Plastal-Bot-Builders/RoboCoreDocumentation/software/ide_design/docs/behaviour-spec.md

# RoboCore IDE — behaviour spec and test checklist

Every control in the RoboCore IDE, what it must do, and where to try it in the Figma prototype ([RoboCore IDE — UI/UX Design](https://www.figma.com/design/P7i2WBM8G96B2fTPHpp8yi), page 05). Blocks are Google Blockly; the code editor is Monaco.

Each row is one test case. Run it in the prototype now, and on the built app later. IDs are stable: add new rows at the end of an area.

145 test cases in 16 areas. Generated from `figma-plugin/src/10d_spec_data.js` by `node tools/spec_md.js`; do not edit this file by hand.

## Contents

- [G — Everywhere](#g--everywhere)
- [W — First start](#w--first-start)
- [H — Home](#h--home)
- [PR — Projects](#pr--projects)
- [EX — Examples](#ex--examples)
- [L — Libraries](#l--libraries)
- [B — Board Setup](#b--board-setup)
- [SM — Serial Monitor](#sm--serial-monitor)
- [ST — Settings](#st--settings)
- [E — Editor · header and build](#e--editor--header-and-build)
- [BK — Blocks (Blockly)](#bk--blocks-blockly)
- [CD — Code (Monaco)](#cd--code-monaco)
- [C — Console (bottom panel)](#c--console-bottom-panel)
- [PB — Preview board](#pb--preview-board)
- [CG — Cog (design only)](#cg--cog-design-only)
- [D — Dialogs](#d--dialogs)
- [Handoff: Blockly](#handoff-blockly)
- [Handoff: Monaco](#handoff-monaco)
- [Implementation notes](#implementation-notes)
- [What the prototype cannot do](#what-the-prototype-cannot-do)

## G — Everywhere

| ID | Control | Do | Expect | Prototype | Pass |
|---|---|---|---|---|---|
| G-01 | Logo (top bar) | Click | Goes to Home. | `any → bHome` | ☐ |
| G-02 | Sidebar item | Click Home, Projects, Libraries, Examples, Board Setup, Serial Monitor or Settings | Opens that page; the item gets the yellow bar. | `any → b*` | ☐ |
| G-03 | Sidebar · Open project | Click | Opens the editor with the project you had open. | `any → eBlocks` | ☐ |
| G-04 | Sidebar · Collapse | Click, or Ctrl+B | Sidebar shrinks to 64 px icons with tooltips; again expands it. Remembered on this device. | `Sidebar component` | ☐ |
| G-05 | Board selector | Click | Opens the board menu: boards, port (Preview board / USB-C), Board setup…. Esc or a click outside closes it. | `Overlay · boardMenu*` | ☐ |
| G-06 | Board menu · board | Pick a board | Editor: the project’s board changes. Browse pages: the default board for new projects. Status bar updates. | `Overlay · boardMenu*` | ☐ |
| G-07 | Board menu · Preview board | Pick | Port = preview. The editor shows the Preview board card; Upload runs the sketch in the simulator. | `→ ePreview` | ☐ |
| G-08 | Board menu · USB-C | Pick | Reopens a board the browser already allowed without asking; otherwise opens the browser’s port chooser. | `→ eBlocks` | ☐ |
| G-09 | Settings icon | Click | Opens Settings. | `→ bSettings` | ☐ |
| G-10 | Account | Click | Menu with name and school, Edit profile, Keyboard shortcuts, About RoboCore IDE. | `Overlay · accountMenu` | ☐ |
| G-11 | Search (browse pages) | Type | Results grouped as Projects, Examples and Help; Enter opens the first; Esc closes. | `Overlay · search` | ☐ |
| G-12 | New project | Click (top bar, Home, Projects) | Opens the New project dialog. | `Overlay · newProject` | ☐ |
| G-13 | Status bar · board | Click | Opens Board Setup. | `→ bBoard` | ☐ |
| G-14 | Icon buttons | Hover 0.5 s, or keyboard focus | Tooltip with the label and shortcut. | `Icon Button component` | ☐ |
| G-15 | Esc | Press | Closes the top-most menu, popover or dialog. Never discards typed text without asking. | `every overlay` | ☐ |
| G-16 | Toasts | Appear after an action | Success and info hide after 4 s; errors stay until closed. | `Overlay · toast*` | ☐ |
| G-17 | Buttons, cards, menu rows | Hover | Hover state (tint or ink outline); pointer cursor. | `components` | ☐ |

## W — First start

| ID | Control | Do | Expect | Prototype | Pass |
|---|---|---|---|---|---|
| W-01 | App start, no profile | Open the IDE on a new device | Shows Welcome; nothing else is reachable until a name is given. | `bWelcome` | ☐ |
| W-02 | Your name | Type | Get started turns on when the name has a letter (spaces trimmed); 40 characters at most. | `bWelcome → bWelcomeTyped` | ☐ |
| W-03 | School or class | Type (optional) | Shown with the name on Home and in the account menu. | `bWelcomeTyped` | ☐ |
| W-04 | Get started | Click, or Enter | Saves the profile on this device, seeds 5 starter projects and opens Home (“Welcome back, <name>”). | `→ bHome` | ☐ |

## H — Home

| ID | Control | Do | Expect | Prototype | Pass |
|---|---|---|---|---|---|
| H-01 | New project | Click | New project dialog. | `Overlay · newProject` | ☐ |
| H-02 | Open <last project> | Click | Opens the last-edited project in the editor. | `→ eBlocks` | ☐ |
| H-03 | Recent project card | Click | Opens it in the mode it was saved in. ⋮ opens the card menu. | `→ eBlocks / eCode` | ☐ |
| H-04 | All projects → | Click | Projects page. | `→ bProjects` | ☐ |
| H-05 | Template tile | Click | Creates a project from the template and opens it in Blocks. | `→ eBlocks` | ☐ |
| H-06 | All examples → | Click | Examples page. | `→ bExamples` | ☐ |
| H-07 | Your board · Board setup → | Click | Board Setup. | `→ bBoard` | ☐ |

## PR — Projects

| ID | Control | Do | Expect | Prototype | Pass |
|---|---|---|---|---|---|
| PR-01 | Filter chips | Click All, Blocks or Code | Shows only those projects; the count shows in the status bar. | `bProjects*` | ☐ |
| PR-02 | Filter field | Type | Filters by name as you type. No match: “No projects match”. | `spec only` | ☐ |
| PR-03 | Project card | Click | Opens the project in its saved mode. | `→ editor` | ☐ |
| PR-04 | Card ⋮ | Click | Open, Rename…, Duplicate, Download .ino, Delete…. | `Overlay · cardMenu_*` | ☐ |
| PR-05 | Rename… | Choose | Dialog with the name selected. Name required and unique; Enter saves. | `Overlay · rename` | ☐ |
| PR-06 | Duplicate | Choose | Adds “<name> copy” at the top; toast. | `Overlay · toastDuplicated` | ☐ |
| PR-07 | Download .ino | Choose | Downloads the main file (a .zip when the sketch has more than one tab). Opens in Arduino IDE 2. | `Overlay · toastDownloaded` | ☐ |
| PR-08 | Delete… | Choose | Confirm dialog. Delete removes it from this device; it cannot be undone. | `Overlay · deleteConfirm` | ☐ |
| PR-09 | No projects | Delete the last one | Empty state with New project and Browse examples. | `bProjectsEmpty` | ☐ |
| PR-10 | Storage | Any change | Saved on this device 0.4 s after a change (key robocore-ide-v1). A damaged project is set aside under a backup key with a notice; the rest still load. | `spec only` | ☐ |

## EX — Examples

| ID | Control | Do | Expect | Prototype | Pass |
|---|---|---|---|---|---|
| EX-01 | Category chips | Click | Filters the grid (Basics, Sensors, Robotics, Sound & light, Communication). | `bExamples*` | ☐ |
| EX-02 | Search | Type | Filters by title and description. | `spec only` | ☐ |
| EX-03 | Example card | Click | Preview dialog: level, category, preview, Open as new project / Cancel. | `Overlay · example_*` | ☐ |
| EX-04 | Open as new project | Click | Makes a copy named after the example and opens it (Blocks when it has blocks, else C++). V2 examples are the library’s own sketches. | `→ eBlocks / eCode` | ☐ |

## L — Libraries

| ID | Control | Do | Expect | Prototype | Pass |
|---|---|---|---|---|---|
| L-01 | Included badge | None | RoboCore libraries and Wire come with the board package and cannot be removed. | `bLibraries` | ☐ |
| L-02 | Install | Click | Installing… then Installed. The library can now be #included; it is compiled on the compile server. | `Library Action component` | ☐ |
| L-03 | Installed | Hover, then click Remove | Removes it; Install appears again. | `Library Action component` | ☐ |
| L-04 | Missing library | Verify a sketch that #includes a library that is not installed | Error: “<Library> is not installed. Install it in Libraries.” | `spec only` | ☐ |

## B — Board Setup

| ID | Control | Do | Expect | Prototype | Pass |
|---|---|---|---|---|---|
| B-01 | Board list | Click a board | Default board for new projects; the detail shows its specs; check mark. | `bBoard*` | ☐ |
| B-02 | Port | Pick Preview board or USB-C | Sets where Upload goes. Saved on this device. | `Select/Port component` | ☐ |
| B-03 | Connect | Click (not connected) | Chrome / Edge port chooser opens; pick “USB JTAG/serial debug unit”. Connected → toast. Cancel → “No port chosen”. | `bBoardOff → Overlay · portChooserBoard → bBoardConnected` | ☐ |
| B-04 | Test connection | Click | Asks the chip for its name: toast “Board answered · ESP32-S3”, or an error if it does not answer. | `Overlay · toastTestOk` | ☐ |
| B-05 | Reset board | Click | Restarts the sketch through the serial lines; toast. | `Overlay · toastBoardReset` | ☐ |
| B-06 | Disconnect | Click | Closes the port (the sketch keeps running on the board); status shows a ring. | `→ bBoardOff` | ☐ |
| B-07 | Baud rate | Pick | Reopens the port at that rate. | `Select/Baud component` | ☐ |
| B-08 | CPU / Partition | Pick | Saved as build options for ESP32 boards and sent with each compile. | `Select/CPU, Select/Partition` | ☐ |
| B-09 | Unplug | Pull the cable | Toast “The board was unplugged…”. Plugging the same board back in reconnects by itself. | `spec only` | ☐ |
| B-10 | Unsupported browser | Safari, Firefox or a native app | “USB needs the web app in Chrome or Edge on a computer.” The preview board still works. | `spec only` | ☐ |

## SM — Serial Monitor

| ID | Control | Do | Expect | Prototype | Pass |
|---|---|---|---|---|---|
| SM-01 | Port, Baud | Pick | Reopens the port. | `Select components` | ☐ |
| SM-02 | Timestamps | Toggle | Shows or hides the time column. | `Toggle component` | ☐ |
| SM-03 | Autoscroll | Toggle | On follows new lines; off keeps your place. | `Toggle component` | ☐ |
| SM-04 | Clear | Click | Empties the log. The board is not affected. | `→ bSerialCleared` | ☐ |
| SM-05 | Message field | Type, then Enter or Send | Sends the text with the chosen line ending and shows it as “→ text”. Send is off while the field is empty. | `bSerial → bSerialTyped → bSerialSent` | ☐ |
| SM-06 | Line ending | Pick | No line ending, New line, Carriage return, Both NL & CR. | `Select/Line ending` | ☐ |
| SM-07 | No board | Open without a connection | Empty state with Connect. | `eNoBoard` | ☐ |

## ST — Settings

| ID | Control | Do | Expect | Prototype | Pass |
|---|---|---|---|---|---|
| ST-01 | Profile · Save | Edit name / school, click Save | Saved; toast. Name required. | `Overlay · toastProfileSaved` | ☐ |
| ST-02 | Cog help style | Pick one | Hints first (default), Explain the answer, Write code for me (off for students). A teacher lock disables the choice. | `Help Style component` | ☐ |
| ST-03 | Explanation level | Pick | Beginner, Intermediate, Advanced. | `Select/Level` | ☐ |
| ST-04 | Let Cog read this project | Toggle | Off: Cog sees nothing and says so. | `Toggle component` | ☐ |
| ST-05 | Theme | Pick Paper or Navy | The whole app switches at once, Blockly and Monaco included. Saved. | `Theme Choice component (Navy = page 06)` | ☐ |
| ST-06 | Font size | Pick | Code editor font size (Monaco fontSize). | `Select/Font size` | ☐ |
| ST-07 | Autocomplete | Toggle | Monaco suggestions while typing on or off (Ctrl+Space still works). | `Toggle component` | ☐ |
| ST-08 | Word wrap | Toggle | Monaco wordWrap on / off. | `Toggle component` | ☐ |
| ST-09 | Compile server · Test | Click | GET /health: “Reachable · arduino-cli 1.5.1 · esp32 3.3.12”, or “Server not reachable”. Empty address = preview check only. | `Server Test component` | ☐ |
| ST-10 | Language | Pick | English for now. | `Select/Language` | ☐ |
| ST-11 | Auto-save | Toggle | On: saves 0.4 s after a change and before upload. Off: saves on upload and when you leave the project. | `Toggle component` | ☐ |
| ST-12 | Reset all data | Scroll to General, click, confirm | Deletes this device’s projects, profile and settings, then shows Welcome. | `bSettings (scroll the page) → Overlay · resetData → bWelcome` | ☐ |

## E — Editor · header and build

| ID | Control | Do | Expect | Prototype | Pass |
|---|---|---|---|---|---|
| E-01 | Mode switch | Blocks ↔ C++ | Same project. C++ shows the code the blocks make. | `eBlocks ↔ eCode` | ☐ |
| E-02 | Project name ⌄ | Click | Rename…, Project settings…, Duplicate, Download Blink.ino, Delete project…. | `Overlay · projectMenu` | ☐ |
| E-03 | Saved label | Edit anything | Saving… then Saved (auto-save). | `spec only` | ☐ |
| E-04 | Verify | Click, Ctrl+R (web: Ctrl+Enter) | With a compile server: Compiling… then Verified with sizes, or Errors (Problems opens). Without: the preview check. | `eBlocks → vBlocks1 → vBlocks2` | ☐ |
| E-05 | Upload (USB-C) | Click, Ctrl+U (web: Ctrl+Shift+Enter) | Compile → bootloader → write with % → restart → Serial Monitor reopens → “Upload complete”. | `eBlocks → uBlocks1…5` | ☐ |
| E-06 | Upload (preview board) | Click | Preview check, then the sketch runs in the simulator. | `ePreview → pUp1 → pRunOn` | ☐ |
| E-07 | Stop | Click (only while uploading or running) | Cancels the upload, or stops the simulator. | `Toolbar Action` | ☐ |
| E-08 | Upload, no compile server | Click | Error in Output and a toast pointing to Settings → Compile server. | `spec only` | ☐ |
| E-09 | Upload, no board | Click | “No board on USB-C… press Connect, then Upload again.” | `eNoBoard → eNoBoardUpload` | ☐ |
| E-10 | Upload, board not answering | Click | “Upload failed” with the BOOT + RESET tip; the Serial Monitor is given back. | `eFlaky → fFlaky1 → fFlaky2 → eUploadFailed` | ☐ |
| E-11 | Upload, wrong chip | Click | “This board has an ESP32, but the project is set to RoboCore V2. Pick the right board and upload again.” | `spec only` | ☐ |
| E-12 | Busy | Click Verify or Upload while one runs | Ignored; both look disabled. | `u*, v*` | ☐ |
| E-13 | Status bar | Watch | Ready, Compiling…, Uploading n %, Verified, Errors, Upload failed, Not connected, Running, Stopped. | `all editor frames` | ☐ |

## BK — Blocks (Blockly)

| ID | Control | Do | Expect | Prototype | Pass |
|---|---|---|---|---|---|
| BK-01 | Toolbox category | Click | Opens its flyout over the workspace; the same category again, or a click on the workspace, closes it. | `Blockly Palette component` | ☐ |
| BK-02 | Flyout block | Drag onto the workspace | Drops it; snaps to a connection when close (insertion marker shows); the flyout closes. | `eBlocks → eToneAdded (drag “play beep”)` | ☐ |
| BK-03 | Dropdown field | Click | Blockly dropdown under the field; pick a value; the C++ updates. | `Overlay · fieldLed / fieldUnit` | ☐ |
| BK-04 | Number or text field | Click | Inline editor; Enter or a click away keeps the value; a bad number reverts. | `Overlay · fieldWait` | ☐ |
| BK-05 | Block | Right-click (long-press on touch) | Duplicate, Copy, Add Comment, Collapse Block, Disable Block, Delete Block, Help. | `Overlay · blockCtx` | ☐ |
| BK-06 | Workspace | Right-click | Undo, Redo, Paste, Clean up Blocks, Collapse Blocks, Expand Blocks, Delete N Blocks. | `Overlay · wsCtx` | ☐ |
| BK-07 | Delete | Delete key, drag to the trashcan or the toolbox | Deletes the block (and those under it); Undo brings it back. | `eDeleted` | ☐ |
| BK-08 | Trashcan | Click (when it has blocks) | Opens the deleted blocks in a flyout; drag one back to restore it. | `eDeleted → Overlay · trashFlyout` | ☐ |
| BK-09 | Undo / Redo | Header buttons, Ctrl+Z / Ctrl+Shift+Z | Blockly undo stack; the buttons are off when there is nothing to undo or redo. | `e* → eBlocks` | ☐ |
| BK-10 | Delete all (header trash) | Click | “Delete all N blocks?” → Delete. | `Overlay · clearWs → eEmpty` | ☐ |
| BK-11 | Zoom controls | Reset, +, −; Ctrl+scroll; pinch | Zooms the workspace (0.5× to 2×). Drag empty space to scroll. | `eZoomIn, eZoomOut` | ☐ |
| BK-12 | Variables · Create variable… | Click | Asks for a name; the variable appears in set, change and get blocks. | `Palette · Variables` | ☐ |
| BK-13 | Disabled and orphan blocks | Disable a block, or leave one outside on start / forever | Shown dimmed and skipped in the C++. | `eDisabled` | ☐ |
| BK-14 | Comment | Add Comment | Comment bubble tied to the block; saved with the project; not in the C++ unless exported. | `eComment` | ☐ |
| BK-15 | Collapse | Collapse Block / Collapse Blocks | The block shrinks to one line; Expand brings it back. | `eCollapsedBlock` | ☐ |
| BK-16 | Selection | Click a block | Yellow outline (Zelos highlight). Keyboard navigation moves with the arrow keys. | `eBlocks` | ☐ |
| BK-17 | Code from blocks | Any change | The C++ is regenerated (Arduino generator) unless the main file was edited by hand. | `eCode banner` | ☐ |
| BK-18 | Toolbox categories | Look | Ten categories, hardware first: Events, Movement, Motors, Light & Sound, Sensors, Control, Operators, Variables, My Blocks, Pins & Serial. Each has its colour chip; the flyout widens to its widest block. | `Blockly Palette component` | ☐ |
| BK-19 | Robot blocks | Use move / turn / start moving / stop moving | Move by cm, wheel turns or seconds (encoders); turn by degrees (IMU yaw, so 90° is a real right angle); stop moving brakes. Speed and wheel size have their own blocks. | `page 03 · Robot blocks frame` | ☐ |
| BK-20 | “When …” hats | Put one on the workspace | Runs its blocks each time the event happens: USER pressed, obstacle closer than, line found / lost, tilted / shaken, timer, any condition. Checked on every pass of forever, so keep forever free of long waits. | `spec only` | ☐ |
| BK-21 | Sensor questions | Use a sensor block | Every sensor has a value (round) and a yes / no question (hexagon) for if, wait until and repeat until. | `Palette · Sensors` | ☐ |
| BK-22 | Make a block… | Click (My Blocks) | Asks for a name; adds a define … hat and a call block (a C++ function). | `spec only` | ☐ |
| BK-23 | Firmware helpers | Build a block marked “new:” | Generated C++ calls a RoboCore library helper; until it exists the block is hidden (or Verify says which helper is missing). | `spec only` | ☐ |

## CD — Code (Monaco)

| ID | Control | Do | Expect | Prototype | Pass |
|---|---|---|---|---|---|
| CD-01 | Banner (generated) | Type in Blink.ino | The file becomes hand-edited: the banner changes and the blocks stop driving it. | `eCode → eCodeEdited` | ☐ |
| CD-02 | Rebuild from blocks | Click, confirm | Replaces the main file with the code from the blocks. | `Overlay · rebuildConfirm → eCode` | ☐ |
| CD-03 | File tabs | Click / ⨯ / + | Switch tab; ⨯ closes the tab (the file stays); + asks for a name (.ino .h .hpp .c .cpp, unique). | `eCodeConfig, Overlay · newFile` | ☐ |
| CD-04 | Autocomplete | Type, or Ctrl+Space | Suggestions (Arduino API, RoboCore library, words in the file) with docs; Enter or Tab inserts; Esc closes. | `eCodeTyping` | ☐ |
| CD-05 | Parameter hints | Type “(” | Signature with the current argument in bold. | `eCodeParams` | ☐ |
| CD-06 | Hover | Hover a function name | Signature, short doc and an Arduino reference link. | `Overlay · hoverDelay` | ☐ |
| CD-07 | Errors | After Verify | Ink squiggle, gutter marker and overview-ruler mark; hovering shows the message, Quick Fix… and Explain with Cog. | `eCompileError → Overlay · errorHover` | ☐ |
| CD-08 | Quick fix | Lightbulb or Ctrl+. | Fixes such as “Change spelling to ‘digitalWrite’”, and Explain with Cog. | `Overlay · quickFix → eCodeFixed` | ☐ |
| CD-09 | Find | Ctrl+F (Ctrl+H to replace) | Find widget: match case, whole word, regex; n of m; Enter / Shift+Enter; Esc closes. | `eCodeFind` | ☐ |
| CD-10 | Explain lens | Click | Opens Cog on that error. | `→ cogError` | ☐ |
| CD-11 | Editor options | None | Minimap off; folding arrows on hover; theme follows Paper / Navy; font size from Settings. | `eCode` | ☐ |
| CD-12 | Cursor | Move it | Status bar shows Ln and Col. | `eCode` | ☐ |

## C — Console (bottom panel)

| ID | Control | Do | Expect | Prototype | Pass |
|---|---|---|---|---|---|
| C-01 | Tabs | Click Serial Monitor, Output, Problems | Switches the panel; Problems shows the number of errors. | `Console Panel component` | ☐ |
| C-02 | Output | Verify / Upload | The build log; errors inverted with Explain. | `Console Panel component` | ☐ |
| C-03 | Problems row | Click | Opens the file in C++ at that line and column. | `eCompileError` | ☐ |
| C-04 | Clear | Click | Empties the current tab. | `Console Panel component` | ☐ |
| C-05 | Collapse / expand | Chevron, Ctrl+J | 40 px bar; remembered on this device. | `eBlocksCollapsed` | ☐ |
| C-06 | Board card | Board setup → | Opens Board Setup. With the preview port it is the Preview board card. | `Board Info Card / Preview Board` | ☐ |

## PB — Preview board

| ID | Control | Do | Expect | Prototype | Pass |
|---|---|---|---|---|---|
| PB-01 | Upload | Port = preview | Preview check, then runs: RGB LED, motors, servo, sonar, line, tilt and battery update live; serial output appears. | `pUp1 → pRunOn ⇄ pRunOff` | ☐ |
| PB-02 | USER button | Press and hold | The sketch reads the button as pressed (LOW) while held. | `Preview Board component` | ☐ |
| PB-03 | Stop | Click | Stops the sketch; Upload starts it again. | `→ pStopped` | ☐ |
| PB-04 | Runtime error | Sketch fails | Stops with the line number in Output (“A function that calls itself needs a way to stop” for runaway recursion). | `spec only` | ☐ |
| PB-05 | Unsupported calls | Sketch uses one | Listed once in Output; the rest keeps running. | `spec only` | ☐ |

## CG — Cog (design only)

| ID | Control | Do | Expect | Prototype | Pass |
|---|---|---|---|---|---|
| CG-01 | Ask Cog | Click, Ctrl+I | Opens the panel on the right (the board card hides); again or ⨯ closes it. | `eBlocks → cogLearn` | ☐ |
| CG-02 | Context chips | Look / click | Show exactly what Cog reads; clicking one jumps there. | `Cog Panel component` | ☐ |
| CG-03 | Explain an error | Explain (Output, lens or hover) | Explanation without the answer + Hint 1 → Another hint → Hint 2 → Show the fix → diff → Apply (one undo step) or Not now. | `cogError → cogFix → cogApplied` | ☐ |
| CG-04 | Quick check | After Apply | One question; Check → feedback and the concept added to “You’ve learned”. | `Cog Panel component` | ☐ |
| CG-05 | Prompt chips and composer | Click a chip, or type and Enter | Sends that question. | `Cog Panel component` | ☐ |
| CG-06 | Help style | Settings | Changes how much Cog shows; Write code for me only when a teacher allows it. | `Help Style component` | ☐ |
| CG-07 | Offline | No internet | Cog shows the offline note; the rest of the IDE works. | `Cog Offline component` | ☐ |
| CG-08 | Learn | Ask Cog with a block selected | Explains the block with its C++; Give me a challenge → Try it → I tried it → done. | `cogLearn` | ☐ |

## D — Dialogs

| ID | Control | Do | Expect | Prototype | Pass |
|---|---|---|---|---|---|
| D-01 | Any dialog | Keyboard | Enter = the main button; Esc = Cancel; focus starts in the first field; ⨯ closes. | `all dialogs` | ☐ |
| D-02 | New project | Name, Blocks or C++, board → Create | Name required and unique. Opens the editor with an empty project. | `Overlay · newProject → eNewProject` | ☐ |
| D-03 | Project settings | Name, board, auto-save → Save | Saved. Delete project asks first. | `Overlay · projectSettings` | ☐ |

## Handoff: Blockly

| Setting | Value | Note |
|---|---|---|
| Renderer | `renderer: 'zelos'` | Rounded statements, hexagonal booleans, Scratch-like hats; matches the drawn blocks. |
| blockStyles · events_blocks | `colourPrimary '#F2B01E'` | Hats (on start, forever, when …). Navy labels: CSS .blocklyText fill #1B2A41 for events blocks; cream #F7F1E3 for all others. colourTertiary (outline) is navy #1B2A41 for every style; colourSecondary = primary 15 % darker (dropdown fields). |
| blockStyles · movement_blocks | `colourPrimary '#2F6BBF'` | Both wheels together: move, turn, steer, speed. |
| blockStyles · motors_blocks | `colourPrimary '#B84A26'` | One wheel motor, and servos 1–4. |
| blockStyles · light_blocks | `colourPrimary '#7A4FB5'` | Light & Sound: the RGB LED and the buzzer. |
| blockStyles · sensors_blocks | `colourPrimary '#0F7680'` |  |
| blockStyles · control_blocks | `colourPrimary '#8A5A00'` | Wait, repeat, if, wait until (Blockly loops / logic_if use this style). |
| blockStyles · operators_blocks | `colourPrimary '#2F7A4C'` | Blockly math_* / logic_compare / logic_operation / text_join. |
| blockStyles · variables_blocks | `colourPrimary '#B23E7A'` |  |
| blockStyles · procedure_blocks | `colourPrimary '#5B6577'` | My Blocks (Blockly procedures). |
| blockStyles · pins_blocks | `colourPrimary '#1B2A41' (Navy theme '#3E5A86')` | Lifted in Navy so it stands off the navy workspace. |
| categoryStyles | `same colours as blockStyles` | Drives the toolbox colour chips. |
| componentStyles · workspace | `workspaceBackgroundColour '#FFFCF5' (Navy '#17253A')` | Grid: spacing 24, length 1, colour navy 40 %, snap true. |
| componentStyles · toolbox | `toolboxBackgroundColour '#FFFCF5', toolboxForegroundColour '#1B2A41'` | Navy: #1B2A41 / #F7F1E3. Selected row = yellow tint + yellow bar (CSS). |
| componentStyles · flyout | `flyoutBackgroundColour '#F7F1E3', flyoutForegroundColour '#1B2A41', flyoutOpacity 1` | The flyout opens over the workspace. |
| componentStyles · scrollbar | `scrollbarColour '#1B2A41', scrollbarOpacity 0.4` |  |
| componentStyles · insertion marker | `insertionMarkerColour '#1B2A41', insertionMarkerOpacity 0.3` |  |
| componentStyles · selection / cursor | `selectedGlowColour, cursorColour, markerColour '#F2B01E'` | Yellow selection, as in the design. |
| fontStyle | `family 'Barlow, sans-serif', weight '600', size 13` |  |
| Workspace options | `zoom {controls: true, wheel: false, pinch: true, startScale: 0.9, minScale: 0.5, maxScale: 2}` | Ctrl+wheel zooms; plain wheel scrolls. |
| Workspace options | `trashcan: true, maxTrashcanContents: 32, sounds: false, move {scrollbars: true, drag: true, wheel: true}` | Sounds off for classrooms. |
| Workspace options | `toolbox: categoryToolbox with the 10 categories: Events, Movement, Motors, Light & Sound, Sensors, Control, Operators, Variables, My Blocks, Pins & Serial` | Variables uses custom: "VARIABLE" (Create variable…), My Blocks custom: "PROCEDURE" (Make a block…). |
| Events | `workspace.addChangeListener(Blockly.Events.disableOrphans)` | Blocks outside on start / forever are disabled. |
| Generator | `a Blockly code generator for Arduino C++` | Must produce the C++ in the Block catalogue below (also docs/block-catalogue.md). Blocks marked “new:” need that helper in the RoboCore library first. |
| Saving | `Blockly.serialization.workspaces.save(ws) → Project.blocks` | Replaces today’s {setup, loop} lists. |

## Handoff: Monaco

| Setting | Value | Note |
|---|---|---|
| Language | `language: 'cpp'` | Monarch C++ tokens; Arduino words added as a custom token list. |
| Theme | `defineTheme('robocore-paper', {base: 'vs'}) / ('robocore-navy', {base: 'vs-dark'})` | Tokens: keyword and type bold navy; number and string ochre #8A5A00; comment navy 66 %; preprocessor bold. |
| editor.background / foreground | `'#FFFCF5' / '#1B2A41' (Navy '#1B2A41' / '#F7F1E3')` |  |
| editorLineNumber.* | `foreground navy 40 %, activeForeground '#1B2A41'` |  |
| editor.lineHighlightBackground | `'#F2B01E1F' (yellow soft)` | renderLineHighlight: all |
| editor.selectionBackground | `'#F2B01E55'` |  |
| editorError.foreground | `'#1B2A41' (Navy '#F7F1E3')` | Ink squiggles: errors are shown by shape, not red. |
| editorSuggestWidget.* / editorHoverWidget.* | `background '#FFFFFF', border navy 16 %, selectedBackground yellow tint` |  |
| diffEditor.* | `insertedTextBackground yellow tint, removedTextBackground navy 6 %` | Used by Cog’s suggested fix. |
| focusBorder | `'#F2B01E'` |  |
| Options | `fontFamily 'JetBrains Mono', fontSize from Settings, lineHeight 20, tabSize 2, insertSpaces true` |  |
| Options | `minimap {enabled: false}, glyphMargin true, folding true, showFoldingControls 'mouseover', stickyScroll off` |  |
| Options | `quickSuggestions from Settings → Autocomplete, wordWrap from Settings, parameterHints on, lightbulb on` |  |
| Providers | `completion, signature help and hover from an Arduino + RoboCore API list (names from RoboCoreV2Pins.h and the library headers)` |  |
| Markers | `monaco.editor.setModelMarkers(model, "arduino-cli", problems)` | From the compile server’s problems (file, line, column, severity). |
| Code actions | `spelling fix from “did you mean …”, plus “Explain with Cog”` | Also in the context menu (addAction). |
| Keys | `Ctrl+F find, Ctrl+H replace, Ctrl+Space suggest, Ctrl+. quick fix, Ctrl+/ comment, F1 palette` | Hide Format Document until a formatter exists. |

## Implementation notes

| Topic | Note |
|---|---|
| Hardware-first blocks | The block set follows the idea behind LEGO SPIKE Prime (not its art): blocks name what the robot does. Each action has a “for …”, a “start …” and a “stop” form; each sensor has a value, a yes / no question and a “when …” hat. RoboCore V2 has everything built in, so there are no port dropdowns (servos 1–4 only). |
| RoboCore library work | Blocks marked “new:” in the Block catalogue need helpers in firmware/RoboCore: RoboCoreDrive (move by cm / rotations / seconds, turn by degrees with the IMU, steer, speed, wheel size), per-wheel motor control and position (needs the encoder counts per wheel turn), RoboCoreServos, yaw / pitch / roll and tilt / shake checks, LED brightness, melodies, battery %, a program timer, and “just happened” edge checks for the when-hats. |
| When-hats in C++ | Phase 1: each when-hat becomes an if (…justHappened()) { … } checked at the top of loop(), so the generated code stays readable. Phase 2 (later): run each hat as its own FreeRTOS task for true parallel scripts, as SPIKE does. |
| Embedding in Flutter | Blockly and Monaco are web libraries. In the web build host them in an HtmlElementView with a small JS bridge (like web/robocore_usb.js); in the native apps use a WebView. AppState stays the single source of truth. |
| Browser shortcuts | In browsers Ctrl/⌘+R reloads the page and Ctrl+U opens the page source, so the web app uses Ctrl+Enter (Verify) and Ctrl+Shift+Enter (Upload); the native apps keep the Arduino keys. |
| Accessibility | Use Blockly’s keyboard navigation; every icon button has a label and a tooltip; focus = navy border + yellow halo; text stays at 4.5:1 or more. |
| Licences | Blockly Apache 2.0; Monaco MIT; esptool-js Apache 2.0. List them in About. |

## What the prototype cannot do

| Limit | Why and what to do |
|---|---|
| Choices do not carry over | Figma Starter has no prototype variables, so a value picked on one screen (board, baud, toggles) is not remembered on the next screen. The spec above says what the app must remember. |
| Right-click | Figma prototypes have no right-click: clicking a block or the empty workspace opens its context menu. |
| Typing | Typing is simulated: clicking a field shows it filled in. |
| Dark theme | Navy is shown statically on page 06; the Theme choice on Settings changes only the radio. |
| Demo depth | Only “play beep” can be dragged from the flyout, and only the Blink program’s fields have editors. Projects other than Blink LED and Obstacle avoider open the Blink screens. |
