Plastal-Bot-Builders/RoboCoreDocumentation/software/ide_design/docs/block-catalogue.md

# RoboCore IDE — block catalogue

The Blocks editor’s block set: hardware-first blocks for the RoboCore V2, in the spirit of LEGO SPIKE Prime’s word blocks (the ideas, not their art). Blocks name what the robot does; each action has a “for …”, a “start …” and a “stop” form; each sensor has a value, a yes / no question and a “when …” hat.

74 blocks in 10 categories; 31 need a new helper in the RoboCore library (firmware/RoboCore). Generated from `figma-plugin/src/05a_block_data.js` by `node tools/blocks_md.js`; do not edit this file by hand. In Figma: page 02 (Blocks family), page 01 (Blocks), page 07 (Block catalogue).

Notation: [dropdown] (number) “text” < > empty yes / no slot.

## Categories

| Category | Colour token | What it is for |
|---|---|---|
| Events | `color/block/events` | Program start, forever, and “when …” hats |
| Movement | `color/block/movement` | Drive the robot: move, turn, steer, speed |
| Motors | `color/block/motors` | One wheel motor at a time, and servos 1–4 |
| Light & Sound | `color/block/light` | The RGB LED and the buzzer |
| Sensors | `color/block/sensors` | Distance, line, tilt, button, battery, timer |
| Control | `color/block/control` | Wait, repeat, if, wait until |
| Operators | `color/block/operators` | Maths, comparisons, and / or / not, text |
| Variables | `color/block/variables` | Set, change and read variables |
| My Blocks | `color/block/myblocks` | Make your own block (a function) |
| Pins & Serial | `color/block/pins` | Expansion pins and the serial port (Advanced) |

## Events

| Block | Shape | Generates (C++) | RoboCore library |
|---|---|---|---|
| on start | hat | `void setup() { … }` | exists |
| forever | hat | `void loop() { … }` | exists |
| when USER button is pressed | hat | `if (RoboCore::userJustPressed()) { … }` | add RoboCore::userJustPressed() (true once per press) |
| when obstacle is closer than (20) cm | hat | `if (sonar.justCloserThan(20)) { … }` | add Sonar::justCloserThan(cm) |
| when the line is [found] | hat | `if (line.justFound()) { … }` | add LineSensor::justFound() / justLost() |
| when the robot is [tilted] | hat | `if (imu.justTilted()) { … }` | add IMU::justTilted() / justShaken() / justFlat() |
| when timer > (10) s | hat | `if (RoboCore::timerPassed(10)) { … }` | add RoboCore::timerPassed(s) |
| when < > | hat | `if (becameTrue(condition)) { … }` | add edge detector for any condition |
| when I receive [message1] | hat | `void on_message1() { … }` | exists |
| broadcast [message1] | stack | `on_message1();` | exists |

## Movement

| Block | Shape | Generates (C++) | RoboCore library |
|---|---|---|---|
| move [forward] for (10) [cm] | stack | `robot.move(10, CM);` | add RoboCoreDrive robot: move(amount, CM \| ROTATIONS \| SECONDS) |
| turn [right] for (90) ° | stack | `robot.turn(90);` | add robot.turn(degrees), using the IMU yaw |
| start moving [forward] | stack | `robot.start(FORWARD);` | add robot.start(FORWARD \| BACKWARD) |
| start moving, steering (30) | stack | `robot.steer(30);` | add robot.steer(-100 … 100) |
| drive left (50) % right (50) % | stack | `motors.drive(50, 50);` | exists |
| stop moving | stack | `robot.stop();` | add robot.stop() (brake) |
| set movement speed to (50) % | stack | `robot.setSpeed(50);` | add robot.setSpeed(percent) |
| set 1 wheel turn to (18.8) cm | stack | `robot.setWheelCm(18.8);` | add robot.setWheelCm(cm) (60 mm wheel = 18.8 cm) |
| distance moved (cm) | value | `robot.distanceCm()` | add robot.distanceCm() from the encoders |

## Motors

| Block | Shape | Generates (C++) | RoboCore library |
|---|---|---|---|
| run [left] motor for (1) [rotations] | stack | `motors.run(LEFT, 1, ROTATIONS);` | add RoboCoreMotors::run(side, amount, unit) |
| start [left] motor at (50) % | stack | `motors.start(LEFT, 50);` | add RoboCoreMotors::start(side, percent) |
| stop [left] motor | stack | `motors.stop(LEFT);` | add RoboCoreMotors::stop(side) |
| reset [left] motor position | stack | `motors.resetPosition(LEFT);` | add RoboCoreMotors::resetPosition(side) |
| [left] motor position (°) | value | `motors.positionDeg(LEFT)` | add positionDeg(side) (needs encoder counts per wheel turn) |
| [left] motor speed (%) | value | `motors.speedPercent(LEFT)` | add speedPercent(side) |
| set servo [1] to (90) ° | stack | `servos.write(1, 90);` | add RoboCoreServos servos: write(port, degrees) |
| servo [1] angle (°) | value | `servos.angle(1)` | add servos.angle(port) |

## Light & Sound

| Block | Shape | Generates (C++) | RoboCore library |
|---|---|---|---|
| turn LED [on] | stack | `digitalWrite(LED_BUILTIN, HIGH);` | exists |
| set LED to [red] | stack | `RoboCore::rgb(255, 0, 0);` | exists |
| set LED brightness to (50) % | stack | `RoboCore::ledBrightness(50);` | add RoboCore::ledBrightness(percent) |
| play beep [C5] for (0.2) s | stack | `RoboCore::beep(523, 200);` | exists |
| start playing beep [C5] | stack | `tone(RC_PIN_BUZZER, 523);` | exists |
| play melody [power up] | stack | `RoboCore::melody(MELODY_POWER_UP);` | add RoboCore::melody(id) + a few built-in tunes |
| stop sound | stack | `noTone(RC_PIN_BUZZER);` | exists |

## Sensors

| Block | Shape | Generates (C++) | RoboCore library |
|---|---|---|---|
| distance (cm) | value | `sonar.distanceCm()` | exists |
| is obstacle closer than (20) cm? | yes / no | `sonar.distanceCm() < 20` | exists |
| line position | value | `line.read()` | exists |
| is [centre] sensor on the line? | yes / no | `line.centre() > 0.5` | exists |
| [centre] line sensor (%) | value | `line.centre() * 100` | exists |
| tilt angle (°) | value | `imu.tiltDeg()` | exists |
| [yaw] angle (°) | value | `imu.yawDeg()` | add IMU::yawDeg() / pitchDeg() / rollDeg() |
| set yaw angle to 0 | stack | `imu.resetYaw();` | add IMU::resetYaw() |
| is the robot [tilted]? | yes / no | `imu.isTilted()` | add IMU::isTilted() / isShaken() / isFlat() |
| is USER button pressed? | yes / no | `RoboCore::userPressed()` | exists |
| battery [%] | value | `RoboCore::batteryPercent()` | add RoboCore::batteryPercent() (volts: batteryVolts() exists) |
| temperature (°C) | value | `imu.temperature()` | exists |
| timer (s) | value | `RoboCore::timer()` | add RoboCore::timer() / resetTimer() |
| reset timer | stack | `RoboCore::resetTimer();` | add RoboCore::resetTimer() |

## Control

| Block | Shape | Generates (C++) | RoboCore library |
|---|---|---|---|
| wait (1) [secs] | stack | `delay(1000);` | exists |
| repeat (5) times | C (loop / if) | `for (int i = 0; i < 5; i++) { … }` | exists |
| if < > then | C (loop / if) | `if (condition) { … }` | exists |
| if < > then | C (if / else) | `if (condition) { … } else { … }` | exists |
| wait until < > | stack | `while (!(condition)) delay(10);` | exists |
| repeat until < > | C (loop / if) | `while (!(condition)) { … }` | exists |
| stop program | stack | `RoboCore::stopProgram();` | add RoboCore::stopProgram() (motors off, then idle) |

## Operators

| Block | Shape | Generates (C++) | RoboCore library |
|---|---|---|---|
| (0) [+] (0) | value | `(a + b)` | exists |
| (0) [<] (20) | yes / no | `(a < b)` | exists |
| < > [and] < > | yes / no | `(a && b)` | exists |
| not < > | yes / no | `!(a)` | exists |
| pick random (1) to (10) | value | `random(1, 11)` | exists |
| is (0) between (-10) and (10)? | yes / no | `(x >= -10 && x <= 10)` | exists |
| [round] (3.6) | value | `round(3.6)` | exists |
| join “cm: ” “20” | value | `String("cm: ") + "20"` | exists |

## Variables

| Block | Shape | Generates (C++) | RoboCore library |
|---|---|---|---|
| set [distance] to (0) | stack | `distance = 0;` | exists |
| change [count] by (1) | stack | `count += 1;` | exists |
| distance | value | `distance` | exists |

## My Blocks

| Block | Shape | Generates (C++) | RoboCore library |
|---|---|---|---|
| define “blink twice” | hat | `void blinkTwice() { … }` | exists |
| blink twice | stack | `blinkTwice();` | exists |

## Pins & Serial

| Block | Shape | Generates (C++) | RoboCore library |
|---|---|---|---|
| set pin [IO37] to [HIGH] | stack | `digitalWrite(RC_PIN_EXP_IO37, HIGH);` | exists |
| read pin [IO37] | value | `digitalRead(RC_PIN_EXP_IO37)` | exists |
| read analog pin [IO37] | value | `analogRead(RC_PIN_EXP_IO37)` | exists |
| start serial at [115200] baud | stack | `Serial.begin(115200);` | exists |
| print “RoboCore V2 ready” | stack | `Serial.println("RoboCore V2 ready");` | exists |
| serial read line | value | `Serial.readStringUntil('\n')` | exists |
