Plastal-Bot-Builders/RoboCoreDocumentation/hardware/controller_v2/fab/PCBWay_V2_2026-10-07/MESSAGE_TO_BETSY.md

Subject: V1 quote cancelled, 3 new V2 assembly orders (RoboCore)

Hi Betsy,

Thank you for the quotation for T-1F2W836287A (RoboCore V1). We have since redesigned the board, so I removed the V1 PCB (W836287AS1F1) and its assembly (T-1F2W836287A) from my cart. Please cancel that quote.

In its place I have submitted three new turnkey orders, each 5 PCBs with 2 assembled:

1. RoboCore V2 controller: PCB W836287AS1F3 + assembly T-1F4W836287A (4-layer, ENIG)
2. Line sensor: PCB W836287AS1F5 + assembly T-1F6W836287A
3. Ultrasonic sensor: PCB W836287AS1F7 + assembly T-1F8W836287A

A few requests:

- Part numbers: every BOM line now has an exact manufacturer part number and LCSC code. Please buy those exact parts. On the V1 quote, C15 (a 2.2 nF capacitor) was quoted as an MPU-6050, so please check that the "Actual Purchase Mfg Part #" column matches our BOM. Resistor and capacitor equivalents are fine only if a part is unavailable; please ask before changing anything else.
- CS100A (U1 on the ultrasonic board) is not stocked at LCSC. Can you source it in China (maker Suzhou ShunGuiZhiLian / 100sensor.com, or AliExpress / 1688)? If not, please tell me and I will send the chips to you as consigned parts.
- Main board: LCSC shows 0 stock of the C&K JS102011SAQN switch (Digi-Key has plenty) and only 12 of the CUI CMT-8504 buzzer. Please confirm you can get them.
- Bottom-side through-hole parts: the three TCRT5000 sensors (line sensor) and the two ultrasonic transducers are inserted from the bottom side. LS1 (transmitter, HY40A16T12-1) and LS2 (receiver, HY40A16R12-1) are different parts and must not be swapped. Please send the placement preview for my approval before production.
- Assembly fee: the line sensor shows $29 for assembly, but the ultrasonic board, which has fewer parts, shows $88. Could the ultrasonic get the same rate, or is there a discount for ordering the three assemblies together?
- Shipping: please ship all three orders together in one FedEx package to Zambia.

Thank you,
Fred
