Plastal-Bot-Builders/RoboCoreDocumentation/docs/photos/SOURCES.md

# Component-list photos: sources

Thumbnails shown in column C of `../RoboCore_V2_component_list.xlsx` (one per line), made by a script from the files in this folder. They are for identifying parts when buying; where the photo is only similar to what to buy, the cell has a comment saying so. Commons photos keep the licence and author given on their file page; product photos belong to the shop named.

| Line | Photo | Source | Author | Licence | Note |
|---|---|---|---|---|---|
| 1 | `01_controller.jpg` | RoboCore render (kicad-cli pcb render of RoboCore_V2.kicad_pcb) | RoboCore | RoboCore |  |
| 2 | `02_xrp_motor_pair.jpg` | SparkFun ROB-24053, https://www.sparkfun.com/hobby-motor-with-encoder-plastic-gear-pair-red.html | SparkFun | SparkFun product photo |  |
| 3 | `03_ultrasonic_rcwl-1601.jpg` | Adafruit product 4007, https://www.adafruit.com/product/4007 | Adafruit | Adafruit product photo | RCWL-1601 shown (3–5 V, HC-SR04 compatible). An HC-SR04P looks like the classic blue HC-SR04. |
| 4 | `04_line_sensor_3ch.jpg` | RoboCore render of our own 3-channel TCRT5000 board (sensors/line_sensor) | RoboCore | RoboCore | Similar, not the same: our own 3-channel TCRT5000 board (same 60 × 24 mm size and sensors). Buy the module described in column D; it must have ANALOG outputs. |
| 5 | `05_servo_mg90.jpg` | Adafruit product 1143, https://www.adafruit.com/product/1143 | Adafruit | Adafruit product photo | MG90D shown (Adafruit's metal-gear micro servo). The MG90S is the same size, horns and mounting. |
| 6 | `06_cell_18650.jpg` | Wikimedia Commons: [18650 and 21700 lithium ion battery cell.jpg](https://commons.wikimedia.org/wiki/File:18650_and_21700_lithium_ion_battery_cell.jpg) | Sevenethics | CC0 |  |
| 7 | `07_holder_18650.jpg` | Wikimedia Commons: [Comparison of 18650 and 21700 battery compartments 02.jpg](https://commons.wikimedia.org/wiki/File:Comparison_of_18650_and_21700_battery_compartments_02.jpg) | Retired electrician | CC0 | Shown: 3- and 4-cell holders. Buy a 3 × 18650 holder (about 61.6 × 78.4 mm) and wire it in PARALLEL (1S3P). |
| 8 | `08_xt30.jpg` | RoboCore render: the XT30 on the controller (J102, XT30UPB-M) | RoboCore | RoboCore | Board side shown: the male XT30 on the controller. Buy the FEMALE XT30U-F with leads, which plugs into it. |
| 9 | `09_dupont_wires.jpg` | Adafruit product 266, https://www.adafruit.com/product/266 | Adafruit | Adafruit product photo |  |
| 10 | `10_usb_charger.jpg` | Wikimedia Commons: [USB power adapter for Apple iPod, Model A1205, by Foxlink Technology Ltd-1048.jpg](https://commons.wikimedia.org/wiki/File:USB_power_adapter_for_Apple_iPod,_Model_A1205,_by_Foxlink_Technology_Ltd-1048.jpg) | Raimond Spekking | CC BY-SA 4.0 | Any 5 V, 2 A USB charger will do. |
| 11 | `11_insert_m2.jpg` | Adafruit product 4255, https://www.adafruit.com/product/4255 | Adafruit | Adafruit product photo | M3 × 4 inserts shown; the M2 ones look the same, only smaller. |
| 12 | `12_insert_m3.jpg` | Adafruit product 4255, https://www.adafruit.com/product/4255 | Adafruit | Adafruit product photo | M3 × 4 brass heat-set inserts (Adafruit 4255). |
| 13 | `13_screw_m2x6_pan.jpg` | Wikimedia Commons: [Screw Head - Slotted-Phillips (pan head with press washer).jpg](https://commons.wikimedia.org/wiki/File:Screw_Head_-_Slotted-Phillips_(pan_head_with_press_washer).jpg) | Andrew Pertsev | CC0 | Phillips pan head machine screw (not to scale). |
| 14 | `14_screw_m2x6_self-tapping.jpg` | Wikimedia Commons: [Schroef.jpg](https://commons.wikimedia.org/wiki/File:Schroef.jpg) | Michiel1972 at Dutch Wikipedia | CC BY-SA 3.0 | Self-tapping screws (not to scale); pan head wanted. |
| 15 | `15_washer_m2.jpg` | Wikimedia Commons: [Unterlegscheiben, Mini-Skyline -- 2020 -- 3875.jpg](https://commons.wikimedia.org/wiki/File:Unterlegscheiben,_Mini-Skyline_--_2020_--_3875.jpg) | Dietmar Rabich | CC BY-SA 4.0 | Flat washers (not to scale). |
| 16 | `16_screw_m2x8_pan.jpg` | Wikimedia Commons: [Screw Head - Slotted-Phillips (pan head with press washer).jpg](https://commons.wikimedia.org/wiki/File:Screw_Head_-_Slotted-Phillips_(pan_head_with_press_washer).jpg) | Andrew Pertsev | CC0 | Phillips pan head machine screw (not to scale). |
| 17 | `17_screw_m2x5_pan.jpg` | Wikimedia Commons: [Screw Head - Slotted-Phillips (pan head with press washer).jpg](https://commons.wikimedia.org/wiki/File:Screw_Head_-_Slotted-Phillips_(pan_head_with_press_washer).jpg) | Andrew Pertsev | CC0 | Phillips pan head machine screw (not to scale). |
| 18 | `18_screw_m2x4_pan.jpg` | Wikimedia Commons: [Screw Head - Slotted-Phillips (pan head with press washer).jpg](https://commons.wikimedia.org/wiki/File:Screw_Head_-_Slotted-Phillips_(pan_head_with_press_washer).jpg) | Andrew Pertsev | CC0 | Phillips pan head machine screw (not to scale). |
| 19 | `19_screw_m3x10_socket.jpg` | Wikimedia Commons: [Percages et vis screw part.jpg](https://commons.wikimedia.org/wiki/File:Percages_et_vis_screw_part.jpg) | Cdang | Public domain | Socket head cap screw (not to scale). |
| 20 | `20_screw_m3x8_self-tapping.jpg` | Wikimedia Commons: [Schroef.jpg](https://commons.wikimedia.org/wiki/File:Schroef.jpg) | Michiel1972 at Dutch Wikipedia | CC BY-SA 3.0 | Self-tapping screws (not to scale); pan head wanted. |
| 21 | `21_thumb_screw_m3.jpg` | Wikimedia Commons: [Screw Head - Thumb screw (6-Star).jpg](https://commons.wikimedia.org/wiki/File:Screw_Head_-_Thumb_screw_(6-Star).jpg) | Andrew Pertsev | CC0 | Star-knob thumb screw shown; the list asks for a knurled-head M3 × 8 thumb screw. |
| 22 | `22_nut_m8.jpg` | Wikimedia Commons: [Groß und klein 003 2022 07 15.jpg](https://commons.wikimedia.org/wiki/File:Gro%C3%9F_und_klein_003_2022_07_15.jpg) | Friedrich Haag | CC BY-SA 4.0 | Hex nuts on a bolt (not to scale): plain M8 hex nuts. |
| 23 | `23_steel_ball_12.7.jpg` | Wikimedia Commons: [Polished steel ball 60mm diameter.jpg](https://commons.wikimedia.org/wiki/File:Polished_steel_ball_60mm_diameter.jpg) | Lucasbosch | CC BY-SA 3.0 | Polished steel ball, shown much bigger than life: you need ½" (12.7 mm) balls. |
| 24 | `24_petg_yellow.jpg` | Wikimedia Commons: [3D Printing Materials (16863368275).jpg](https://commons.wikimedia.org/wiki/File:3D_Printing_Materials_(16863368275).jpg) | Maurizio Pesce from Milan, Italia | CC BY 2.0 | Filament spools (generic photo). Buy PETG in the colour on this line. |
| 25 | `25_petg_black.jpg` | Wikimedia Commons: [3D Printing Materials (16863368275).jpg](https://commons.wikimedia.org/wiki/File:3D_Printing_Materials_(16863368275).jpg) | Maurizio Pesce from Milan, Italia | CC BY 2.0 | Filament spools (generic photo). Buy black PETG. |
| 26 | `26_petg_teal.jpg` | Wikimedia Commons: [3D Printing Materials (16863368275).jpg](https://commons.wikimedia.org/wiki/File:3D_Printing_Materials_(16863368275).jpg) | Maurizio Pesce from Milan, Italia | CC BY 2.0 | Filament spools (generic photo). Buy dark teal PETG. |
| 27 | `27_tpu_black.jpg` | Wikimedia Commons: [3D Printing Materials (16863368275).jpg](https://commons.wikimedia.org/wiki/File:3D_Printing_Materials_(16863368275).jpg) | Maurizio Pesce from Milan, Italia | CC BY 2.0 | Filament spools (generic photo). Buy black TPU 95A. |
| 28 | `28_mailer_box.jpg` | RoboCore packaging render (mech/robot/packaging) | RoboCore | RoboCore |  |
| 29 | — | no photo (shipping estimate) | | | |
| 30 | — | no photo (shipping estimate) | | | |
| 31 | `31_insert_tips.jpg` | Adafruit product 4239, https://www.adafruit.com/product/4239 | Adafruit | Adafruit product photo | M3 heat-set insert tip shown; get the M2 tip as well, to fit your iron. |

2026-10-12: the SG90, protection board, heat-shrink and USB-C cable lines were removed from the list; their photos are kept in `unused/`.

## Rebuilding the photo column
`mapping.json` (this folder) lists the photo and the cell comment for each line. `tools/costing/xlsx_photos.py IN.xlsx OUT.xlsx MAPPING.json` inserts a new column C with the thumbnails and shifts every formula, validation and the freeze pane one column to the right, so run it on a workbook **without** the Photo column; the file paths in MAPPING must be absolute or relative to where you run it. `contact_sheet.jpg` shows all 31 lines at a glance.
