Plastal-Bot-Builders/RoboCoreDocumentation/docs/RoboCore_V2_quote_request_2_robots.pdf

# RoboCore V2 robot: request for quotation

Parts for 2 robots · 2026-10-12 · please quote in USD

From | RoboCore Zambia

Contact

Deliver to | Zambia

Please reply by

For each line please give: available or not, the pack size you sell, its price, lead time and your part number or link. Partial quotes are welcome. Also please state the shipping cost to Zambia, any minimum order and payment terms.
Photos are for identification only; * = the photo shows a similar item, the specification is what counts. An M2/M3 screw, nut and insert assortment kit covering the hardware section is also welcome (quote it separately). The spreadsheet version has columns to fill in.
# | Photo | Item | Specification | Qty | Usual pack | Notes

Motors, sensors and servos

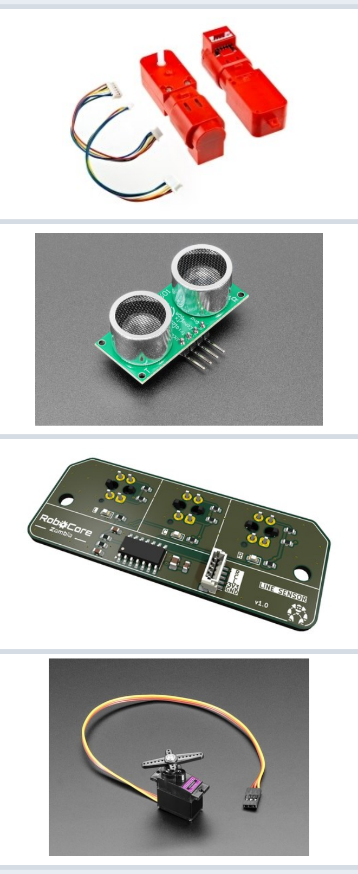
[picture p14: figure]

1 | | Motor pair with encoders | SparkFun ROB-24053 'Hobby Motor with Encoder - Plastic Gear (Pair, Red)': 2 motors, 1:48 gearbox, 585 counts per wheel turn, two 6-pin cables included | 2 pair | pair | This exact motor, please: our chassis is built around it, so generic TT motors don't fit. Please confirm stock.
2 | | Ultrasonic distance sensor, 3.3 V | HC-SR04P (3-5.5 V) or RCWL-1601. Board 45 x 20 mm, Ø16 mm transducers 26 mm apart, 4-pin header VCC / TRIG / ECHO / GND | 3 pcs | 1 | Must work from 3.3 V: the classic 5 V-only HC-SR04 is not suitable.

3

Line-tracking
sensor, 3-channel *

3-channel TCRT5000 line-tracking module with ANALOG outputs. Pins VCC, GND, L, C, R. About 60 x 24 mm

| 3 pcs | 1 | Analog outputs required: digital-only modules (LM339 comparator outputs) are not suitable. Please state the board size.

4

Micro servo, metal
gear *
MG90S, with horns and screws (one for the shoulder, one for the gripper of each robot) | 6 pcs | 1 | Metal gears. Please supply a consistent, good-quality batch; we test every unit on arrival.

Battery and power

5 | 18650 Li-ion cell
Genuine branded cell (Samsung, LG, Molicel, EVE or similar), about 3000 mAh, 65 mm long, unprotected | 6 pcs | 1 | All cells the same model and batch. Protected cells (about 70 mm long) don't fit. Please state brand and model.

6

Battery holder, 3 x
18650 *
3-cell 18650 holder with wire leads, about 61.6 x 78.4 mm | 2 pcs | 1 | We need the cells in PARALLEL (3.7 V out). Please state whether the holder is wired in series or parallel.

7

XT30 battery lead,
female *
AMASS XT30U-F (female) with 10-15 cm of 16 AWG silicone wire | 3 pcs | 5

Female plug, which mates with an XT30 male (XT30UPB-M on our board).

Cables

8

Dupont jumper
wires, female-female
2.54 mm, female-female, 20 cm | 18 pcs | 40-wire strip

Screws, inserts and small hardware

9

Heat-set insert, M2
(brass) *
M2 brass heat-set insert for Ø3.2 mm holes, e.g. M2 x 3 mm long, 3.2 mm OD | 12 pcs | 50-100

# | Photo | Item | Specification | Qty | Usual pack | Notes

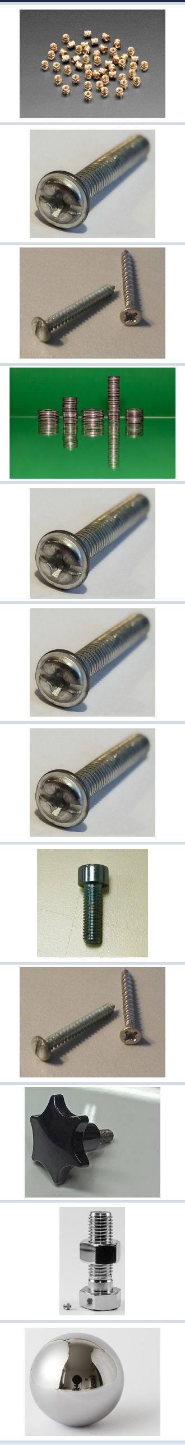
[picture p15: figure]

10 | | Heat-set insert, M3 short (brass) | M3 brass heat-set insert for Ø4.0 mm holes, e.g. M3 x 4 mm long, 4.0 mm OD | 16 pcs | 50-100

11

Machine screw M2 x
6, pan head
M2 x 6 mm pan head machine screw, steel | 12 pcs | 50

12

Self-tapping screw
M2 x 6, pan head
M2 x 6 mm pan head self-tapping screw (for plastic) | 6 pcs | 50
13 | Flat washer M2 | M2 flat washer, steel | 6 pcs | 100

14

Machine screw M2 x
8, pan head
M2 x 8 mm pan head machine screw, steel | 3 pcs | 50

15

Screw M2 x 5, pan
head
M2 x 5 mm pan head screw, steel | 6 pcs | 50

16

Screw M2 x 4, pan
head
M2 x 4 mm pan head screw, steel | 8 pcs | 50

17

Socket head cap
screw M3 x 10
M3 x 10 mm hex socket head cap screw, steel | 6 pcs | 50

18

Self-tapping screw
M3 x 8, pan head
M3 x 8 mm pan head self-tapping screw (for plastic) | 3 pcs | 50

19

Thumb screw M3 x
8, knurled head *
M3 x 8 mm thumb screw with knurled head | 7 pcs | 20
20 | Hex nut M8 | M8 hex nut, plain steel (about 5 g each) | 12 pcs | 1

21

Steel ball ½" (12.7
mm)
12.7 mm (½") steel bearing ball | 6 pcs | 20 | 12.7 mm glass marbles are also acceptable.

3D-printing filament

22

PETG filament,
yellow
PETG 3D-printer filament, 1.75 mm, yellow | 1 spool | 1 kg spool | About 370 g needed.

23

PETG filament,
black
PETG 3D-printer filament, 1.75 mm, black | 1 spool | 1 kg spool | About 41 g needed.

# | Photo | Item | Specification | Qty | Usual pack | Notes

24 | | PETG filament, dark teal | PETG 3D-printer filament, 1.75 mm, dark teal | 1 spool | 1 kg spool | About 36 g needed.
25 | TPU filament, black | TPU 95A flexible filament, 1.75 mm, black | 1 spool 250 g-1 kg spool About 21 g needed. A small spool is enough.

RoboCore Zambia · quote request for 2 robots · 25 items
