Plastal-Bot-Builders/RoboCoreDocumentation/mechanical/robot_v2/README.md

# RoboCore V2 robot (XRP-inspired): revision 5, 2026-10-07

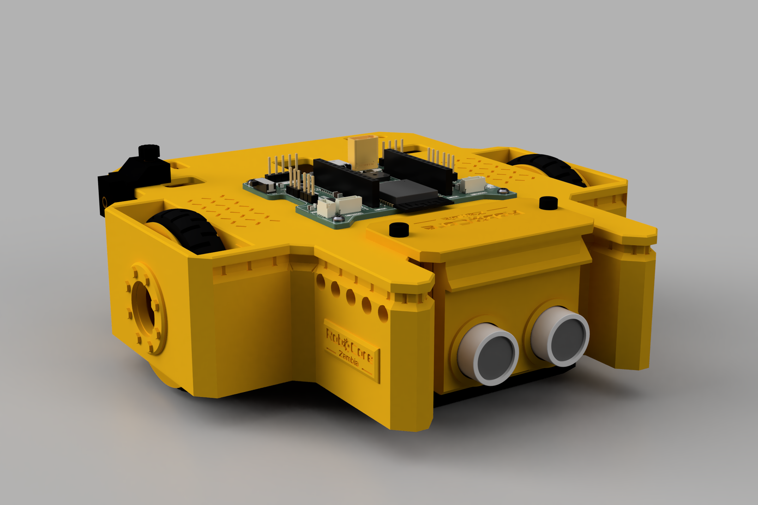
[picture p16: mechanical/robot_v2/renders/robot_hero_noarm.png]
Robot


Revision 5 follows Fred's sketches and notes of 2026-10-07:
- **Plan from the sketches:** a cross-shaped plan. It is wide at the wheels, narrower at the rear (where the motors' encoder covers sit) and narrow at the front, with a notch between two legs that guard the sonar. **Every corner is chamfered** at 45°.
- **Top covered and printed top-down, like the XRP:**
  - The chassis is a flat **deck** that covers the motors, with walls hanging under it. It is **open underneath**.
  - It **prints deck-down on the bed with no supports.**
  - The board sits **on** the deck.
- **The real motor:** the encoder cover that the Fusion motor model was missing is modelled from the maker's drawing.
- **Motors go in from below** and snap in.
- **The new battery holder** (BatteryHolder3S, 3 × 18650 **wired 1S3P**) **slides in from the back**. Two flaps snap in behind it; there is no lid.
- **Wheels:** **grippier tyres** that lock onto the rim with two beads, and a refined rim.

Second round, same day, after the toy excavator photo:
- **An arm with character.** The arm module is now styled as an excavator:
  - a curved boom with diamond truss windows;
  - a hydraulic cylinder along the top;
  - the RoboCore gear and a hex bolt head on the shoulder, and bolt-head bosses at the wrist;
  - claw jaws with bucket teeth;
  - a cab-style base with louvre vents;
  - excavator yellow with black jaws.
- **Joints, so you can move the model in Fusion:** shoulder, the two gear-linked jaws, both wheels, and the battery sliding out of the back.
- **Every screw, washer, nut and servo horn** is modelled and in place (rev 6 has no inserts).
- **Fred's own chassis edits are kept:**
  - the side windows are filled;
  - a Ø16 hole in each wheel-section side reaches the wheel screw;
  - a 2 mm fill closes the gap at the front of each wheel well.

  They are now in the generator too (`SIDE_WINDOWS`, `WHEEL_ACCESS_D`, `WELL_CORNER_FILL`).

Third round, same day, after Fred's earth-mover photos (a CAT 797F haul truck, a JCB backhoe, loaders and dozers):
- **The chassis now has the same character as the arm**, without changing its structure.
- It gains wheel hubs, fender arches, engine louvres, hazard chevrons, tail lights, RoboCore badges and tread-plate walkways.
- There is a new **construction** colour scheme: all yellow with black details, like a CAT machine.

Fourth round, same day, after Fred's side-profile notes:
- **The rail lip is gone.** The outer wall now runs straight up into the deck, so the side reads as one continuous body. The expansion bus is a flush **groove** under the deck instead; the clips hook a tongue into it.
- **New sonar mount:** a headlight-style **pod** on the dock plate. The board snaps in from the back; no more sliding it down grooves.

Fifth round (2026-10-08/09), Fred's off-the-shelf parts:
- **Ultrasonic:** the custom RoboCore_Ultrasonic is replaced by the **HC-SR04** model Fred added (45 × 20 mm, Ø16 cans 26 mm apart, 4-pin right-angle header). It is mounted **header up**, so its Dupont plugs sit inside the pod under the plate.
- **Servos:** the built SG90 reference bodies are replaced by Fred's models: the **MG90S** assembly on the shoulder and the **SG90** (with cable) on the gripper. The arm base, posts, horns and screws fit both without change (the real cases match the design frame within 0.3 mm).
- **Line sensor:** still the RoboCore_LineSensor. The Faduino IR board Fred mentioned is not in the project folder yet; when it is, the two bosses move to its holes and the cable slot in the deck to its header (see open items).

Rev 1–4 are archived in `fusion/rev1…4/`, `renders/rev1…4/` and `print/rev2…4/`.

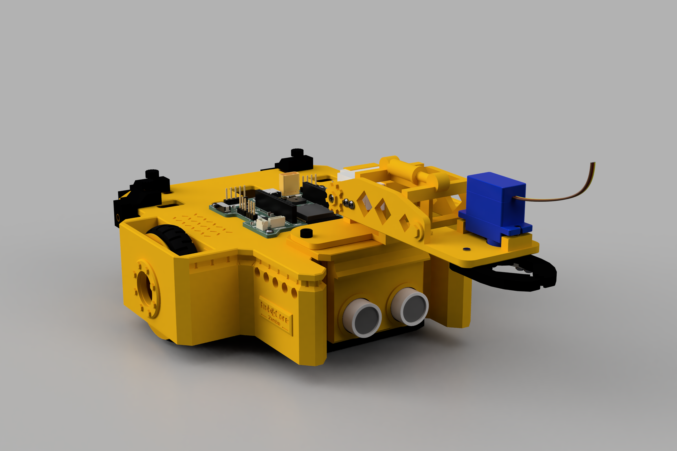
[picture p17: mechanical/robot_v2/renders/robot_hero.png]
With the arm module


Arm close-up

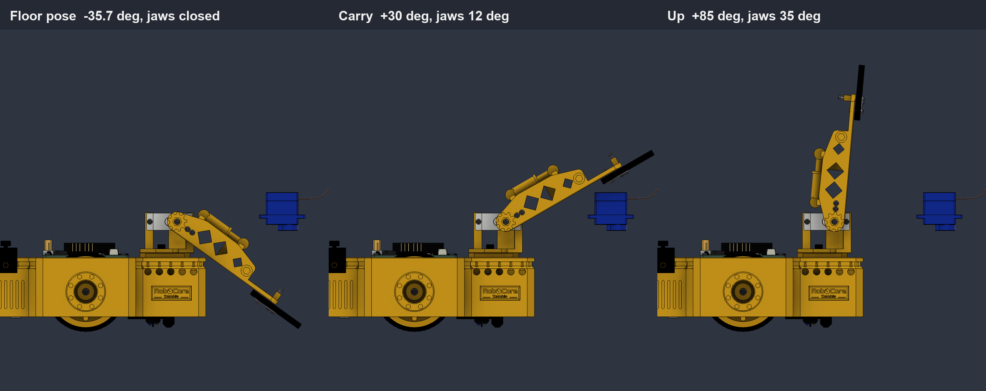
[picture p18: mechanical/robot_v2/renders/arm_poses.png]
Arm poses


Chassis before and after

| | |
|---|---|
| Before / after | `renders/before_after_profile.png` (lip and slide-in bracket vs flush groove and sonar pod); the earlier rounds' comparisons are in `renders/rev5/` (rev 4 vs rev 5, the arm styling, the earth-mover details) |
| Sonar pod | `renders/sonar_pod.png`, `sonar_pod_rear.png`; bus clip in the groove: `renders/bus_clip.png` |
| Chassis details | `renders/chassis_wheel_side.png` (hub, fender, louvres, badge), `chassis_rear.png` (chevrons, tail light), `chassis_deck.png` (tread plate) |
| Arm | `renders/arm_closeup.png`, `arm_closeup_left.png`, `arm_gripper_under.png` (horn and screws under the gripper), `arm_poses.png` (floor / carry / up) |
| Colour schemes | `renders/schemes/colour_schemes.png` (teal, orange, construction yellow). The renders and heroes are in construction yellow |
| Views | `renders/robot_{iso, iso_front, iso_rear, side, top, under_iso}.png` (arm raised), `renders/robot_noarm_*.png` (no arm), `renders/robot_arm_floor_*.png` (arm lowered), ray-traced `renders/robot_hero.png` and `robot_hero_noarm.png` |
| Expansion bus | [`EXPANSION_BUS.md`](EXPANSION_BUS.md) and `renders/bus_spec.png` |

## Files
| What | Where |
|---|---|
| Fusion 360 design (cloud) | **RoboCore V2 Robot** in UniPod Project → RoboCore V2. Rev 5 is the latest version. The main board, line sensor, ultrasonic and **BatteryHolder3S** are linked from their own files |
| Offline copy | `RoboCore_V2_Robot.f3d` (8 MB) and `RoboCore_V2_Robot.step` (whole robot with the boards, 28 MB) |
| Print files | `print/RoboCore_V2_<part>.stl` / `.3mf`. **Every file is already in its print orientation** (the chassis lies on its deck) |
| Generator | `fusion/build_robot.py`, with every dimension in `fusion/rc_params.py`. Also `rc_lib.py`, `checks.py`, `export.py`, `view.py`, and `bus_drawing.py` (bus drawing, runs outside Fusion) |

## What changed (rev 4 → rev 5), point by point against Fred's notes
1. **Profile from the sketches, chamfered corners:**
   - Three sections:
     - the **wheel section** is 162 mm wide over the walls (y −35…35);
     - the **rear section** is 127 mm wide and holds the encoder covers;
     - the **front section** is 94 mm wide, ending in two legs either side of a 66 mm notch for the sonar.
   - The chamfers are 10 mm at the rear corners, 5 mm at the leg tips and wheel corners, and 5 mm / 4 mm at the inside corners. The wheel corners are small so the chamfer clears the tyres.
   - Size: **162 × 166 mm** over the walls (168 × 172 in the earlier rev 5 drafts, which had a 3 mm rail lip), 52 mm to the deck top.
2. **Real motor dimensions:**
   - The STEP model lacked the encoder cover. It is now a reference part built from the drawing:
     - 25.8 (thickness) × 25.2 (height) × 22.3 (length) mm, behind the gearbox;
     - plus the 19.2 mm end boss and the socket.
   - The motors sit 1.5 mm further out than in the first rev 5 draft. This makes room for a 1.6 mm rail wall between the battery and each cover, with 0.6 mm clearance.
3. **Motors from below:**
   - The shaft slot, the pin slot and the boss groove in the shaft wall are open at the bottom.
   - The motor (wheel on) goes straight up until its gearbox top meets the **stops** under the deck.
   - **Two hooks** on the inner wall then spring in under the gearbox's bottom edge. They have a 45° lead-in, so the motor pushes them aside on the way up.
   - The wheel load pushes the motor up into the stops, not onto the hooks.
4. **The new battery, from the back, with a snap fit (no lid):**
   - The BatteryHolder3S slides in through the opening in the rear wall. Its two bottom edges ride on **45° V-rails** that run its full length; they also centre it.
   - It slides in until it meets the **front stops**.
   - The rear ends of the two rail walls are **snap flaps**. They hang from the deck only, so they flex outward. Each has a bump with a 45° ramp that springs in behind the holder's rear corners (1.5 mm catch).
   - **To remove it:** push both flaps outward (just inside the corners of the rear opening) and slide the holder out.
   - Nothing in its path has a flat ledge, so all of it prints top-down.
5. **Covered top, printed top-down like the XRP:**
   - The deck covers the motors, encoders, battery and nose.
   - A window under the board clears its pin-header legs and lets cables through.
   - Openings cut through the deck:
     - the wheel wells;
     - a slot behind the board (battery lead to the XT30, plus relief for the USB-C plug);
     - a slot in front of the board (sensor cables);
     - a slot over each encoder socket;
     - a cable port in each rear corner.
   - Inside, everything hangs from the deck:
     - walls;
     - motor stops;
     - latch tongues;
     - the line-sensor pocket walls and the two screw bosses (rev 6: the pocket is open from the floor line to the deck, so nothing is bridged).
6. **Board on the deck:**
   - The board sits flat on the deck (z 52, 6 mm higher than before), held by 4 × M2 × 6 thread-forming screws into pilots in bosses under the deck (rev 6; rev 5 had heat-set inserts). This is the XRP layout.
   - Its IMU is still right above the axle.
   - The battery is underneath, as asked.
7. **Twin rear ball casters, printed in:**
   - The floor that held the bayonet caster is gone. Instead, a **½" ball snaps up into a socket in each rear corner**: the lip is 0.7 mm smaller than the ball and has 4 slits.
   - A Ø4 vent through the deck lets you push a ball out with a pin.
   - The separate caster part is gone.
8. **Wheels:**
   - **Tyre:** grippier, with a rounded crown and a staggered block tread (2 × 24 grooves). It is stretched onto the 46 mm seat (ID 45.2), and **two beads lock into 45° grooves** in the rim, so it can't walk off.
   - **Rim:** the old centre bead is gone.
9. **Expansion bus, adapted to the deck:**
   - **Clips clamp onto the deck:** the tab lies on the deck and a thumb screw presses down, pulling the clip's tongue up in the bus groove.
   - Detents run in the groove on every straight run and outside chamfer except the wheel sides (**54**).
   - The Technic hole row stays only where there is room behind the wall: the front-section sides, **10 holes**.
   - See [`EXPANSION_BUS.md`](EXPANSION_BUS.md).
10. **Arm ballast:** two **ballast clips** on the rear wall at x ±44, each holding 3 × M8 nuts, replace rev 4's internal rack.
11. **Kept from rev 4:**
    - the sonar on a bracket on the front dock (now the pod, see below);
    - the 2-servo arm on the bracket;
    - the RoboCore logo on the bracket and the Plastal-Bot logo on the rear wall.

## The chassis, styled after the earth movers
| On the earth movers | On the RoboCore chassis |
|---|---|
| Huge wheel hubs (final drives) with rings of bolts | A raised hub ring (Ø28) round each wheel-screw access hole, with 8 hex bolt heads |
| Fenders over the wheels | A raised fender arch over each wheel on the wheel-section sides |
| Engine-bay louvres (JCB, CAT) | 7 louvre slots on each rear-section side, over the encoder covers |
| Black/yellow hazard chevrons on the rear | 45° chevron grooves either side of the battery opening (3.2 mm stripes, so they are easy to paint black) |
| Tail lights | A recessed light with a raised lens on each rear chamfer (paint it red) |
| Brand plate ("CATERPILLAR", "JCB") | A raised badge with the RoboCore logo on each front-section side |
| Anti-slip tread plate on the walkways | Diagonal tread grooves in the deck over each gearbox |
| Yellow with black details | The **construction** colour scheme: chassis, wheels, bracket and arm in yellow; tyres, jaws and clips black |

- **Shallow relief only:**
  - the raised parts stand 1–2.5 mm proud;
  - the grooves are 0.6–1.2 mm deep.

  So the outline (168 × 172 mm), the clearances, the joints and the top-down print are unchanged.
- **Mass:** the chassis gains 2 g, to 136 g.
- **Fusion:** these are the `chassis_style` and `chassis_tread` steps. They were added on top of the current chassis, so Fred's own edits are still there.

## Side profile: one body, flush bus groove (fourth round)
Fred found the 3 mm rail lip made the body look stepped and bulky. It is gone:
- The outer wall runs straight up into the deck on every face. The only line on the side is the bus groove.
- **The bus groove** is 1.8 mm deep, z 46–49, just under the deck, with a 45° underside so the chassis still prints top-down with no supports. A 1.5 mm band inside the wall backs it up (4.5 mm of wall there).
- No groove over the wheel sections: the wall there is only the wheel-well skin, and that is where the hubs and fenders are.
- The bus and ballast clips now have a **tongue** that goes into the groove instead of a hook over a lip; the thumb-screw-on-the-deck clamp is unchanged. The rail coupon test piece follows.
- The robot is 6 mm narrower and shorter over all: **162 × 166 mm**.

See [`EXPANSION_BUS.md`](EXPANSION_BUS.md).

## Caster vent and the DG01D-E motor fit (Task C, 2026-10-14)
- **Caster vent Ø5.5** (was Ø4): the hole through the deck above each ball now takes a normal small screwdriver's shank,
  not just a pin. The ball is held by the lip at the bottom of the socket, so a bigger vent at the top changes nothing
  about retention. The ballast clip tabs sit over the vents when the arm module is fitted: undo that side's thumb
  screw first (the clips stay at x ±44; moving them inward was offered and not taken).
- **Rail-wall windows** for the DG01D-E motor (swapped in on 11 Oct): its encoder end reaches |x| 32.6 and its magnet
  disc |x| 31.6, 1.3 mm into the 1.6 mm battery rail walls. Each rail wall now has a window at y −65.5 to −49,
  z 18 to 37.5 (`RAIL_WINDOW`), which clears both with 1 mm. The battery holder is still guided by the rest of the wall
  and latched by the rear snap flap; the V-rails underneath are untouched. In print orientation the window's lower edge
  is a 16.5 mm bridge in a 1.6 mm wall, which the slicer bridges without support.
- The inner walls and shaft walls now end at y −29.8 (was −30.4 / −30.5) to clear the motor's can flange.
- **Your hand edits are replayed by the generator** (`chassis_hand_edits`, `WHEEL_SKIN_CUT`): the 1 mm cut on both
  wheel-section outer walls from Fusion v30, applied the way a face cut behaves, so the hub rings and fender arches
  keep standing on the uncut material. Set `HAND_EDITS = False` to drop it.

## Pod face and arm base edges (1a and 3b, 2026-10-14)
From the 14 October DFMA brief, reviewed in `docs/Review_DFMA_brief_2026-10-14.md`; Fred chose items 1a, 3b and 5b.
- **Sonar pod (1a):** the faceplate is 4 mm thick (was 2.5) and the front block, from the snap slit forward, is 56 mm
  wide (was 50.4, `POD_FRONT`), so the vertical front corners carry **4 mm × 45° chamfers** (were 2 mm) and still leave
  3.4 mm of material at the corner. The eyes keep their raised bezels (Ø21.5), now **countersunk at 45°**
  (`EYE_RECESS`, 1.2 mm) so each opening sits behind a crest. The brow's ends follow the corner chamfers, the step from
  the front block back to the 2 mm snap strips is chamfered 2 mm, the plate's front corners are 6.8 mm chamfers in line
  with the pod's, and its front edge has a 1.5 mm chamfer on top. The board, its cans, the snap strips and the crystal
  pocket did not move: the faceplate grew forward, so the cans stand 7 mm proud (were 9), the cans still end 2 mm behind
  the legs' tips, and the front block clears each leg by 4.9 mm (was 7.7). Still prints plate-down, no supports; 11.1 g.
  Why not the brief's fillets and lofted "double-bubble": fillets are against the design rules, and a lofted cowling with
  the face vertical overhangs past 45° under the bubbles.
- **Arm base (3b):** the plate's front top edge has a **2 mm × 45° chamfer** (`ARM_BASE_FRONT_CHAMFER`), so the step down
  to the sonar plate reads as a slope, and the two M3 × 10 socket heads sit in **Ø6 × 2 mm counterbores** (`ARM_BASE_CBORE`),
  1 mm proud instead of 3. An M3 × 8 still passes right through the nut.
- **Battery holder to motor (5b):** nothing modelled; the 0.9 mm gap is open item 14.

## Fasteners, rev 6 (Task A, 2026-10-14): no heat-set inserts
Community feedback (EO, alexchunlin on the Every Flavor Robotics Discord): heat-set inserts are too fiddly for a school.
Rev 5 had 10 per robot. Rev 6 replaces every one of them, chosen per location:
- **Board (4 × M2):** thread-forming screws for plastic into Ø1.7 × 6 pilots in the Ø6.4 bosses (`PILOT_M2`). The screw
  axis is the print's Z, the strong direction for threads in a boss. A board comes off rarely, so 10 cycles is plenty.
- **Dock towers (2 × M3):** a captive M3 nut in a 5.7 mm hex pocket, 2.6 mm deep, in the deck top under the sonar plate,
  with a Ø3.4 clearance hole on down into the tower (`NUT_M3`). The plate holds the nut; the M3 × 10 (or × 8) comes down
  through the arm base and plate as before. Unlimited cycles for the joint students undo most.
- **Clip tabs (3 × M3 thumb screw):** a slot into the side of each 6.5 mm tab takes a captive M3 nut (1.9 mm of material
  above and below it); the thumb screw threads through the nut and presses on the deck as before.
- **Bus clip accessory boss (1 × M3):** a hex pocket at the end of the boss.
Why not screw-in inserts: they work (and are the fallback if the pilots strip), but cost about $0.30 each; nuts cost pennies
and last. Why not snap fits: the chassis prints deck-down, so nothing can stand above the deck to hook the board or the plate.
`FASTENERS = 'inserts'` in `rc_params.py` rebuilds the rev 5 insert version.

**Fastener coupon** (`print/RoboCore_V2_Fastener_coupon`, flat, 10 min): a boss with the M2 pilot, a deck-top nut pocket
with its clearance hole, and a clip-tab piece on edge with the side nut slot. Test: fit each fastener and remove it
10 times with the normal screwdriver, then (a) the M2 must still take 0.15 N·m without spinning, (b) the nuts must still
sit flat in their pockets and not turn when the screw is driven, (c) the tab slot must still hold its nut by friction
when the piece is turned upside down. If (a) fails, print the coupon with `PILOT_M2 = (1.6, 6.0)` or go to screw-in inserts.

## Nose, rev 6 (2026-10-12): open pocket, no sled
Fred's review found two things under the line sensor: a sealed cavity between the front block and the deck (its ceiling
printed as bridges, and auto-supports would fill it where nothing can reach), and a separate black sled whose only jobs
were to hold the board by its edges, set its height and carry a skid. Rev 6 removes both:
- The front block is gone. The pocket is open from the floor line straight up to the deck underside, bounded by 4.5 mm
  side walls at x ±33, a rear wall at y 24.5–28 and the front wall. In print orientation these are plain walls standing
  on the bed: no bridge, no cavity, no support anywhere in the nose. The centre rib, the second cross wall and the
  plug window went with it.
- The board hangs from **two Ø6.5 bosses** at its own M3 holes (x ±25.8, y 40; 51.6 mm pitch), from the deck down to the
  board's top face, with Ø2.5 × 8 self-tapping pilots: 2 × M3 × 8 from below. Height stays 10.5 mm (`LINE_UNDER_Z`);
  printed washers adjust it. The bosses merge into the dock towers, which still hang from the deck to z 18 above the board.
- The **skid** is now part of the chassis: the pocket's front wall continues 7.5 mm below the floor line (x ±30, from
  y 54 to the nose), chamfered 2.5 mm at both ends, so a nose-dive still lands on plastic before the sensors.
- The JST plug points up into the open pocket; the cable goes straight to the existing front cable slot in the deck.
  The ultrasonic's wires come through the same slot in the front wall as before, now cut through both wall layers.
- Also in this round: the `Encoder cover (reference)` body is dropped (the DG01D-E motor model has its own cover) and
  the generator's joints and checks recognise the DG01D-E motor name.
Parts removed: the sled and its three height variants, the snap grooves, the plug window. Added: 2 × M3 × 8 self-tapping.

## Sonar pod (fourth round)
Fred found the slide-in bracket impractical and wanted a more modern look. The new mount:
- The **plate on the dock stays** (2 × M3; the arm base stacks on it), now with chamfered corners to match the chassis (6.8 mm at the front since 14 Oct, in line with the pod's corners, and a 1.5 mm chamfer along the front edge).
- A **headlight-style pod** hangs from the plate's front: a 4 mm faceplate (2.5 until 14 Oct) with two round eyes in raised, countersunk bezels, a 47° brow over them, 2 mm walls each side and 4 mm chamfered front corners on a wider front block (see "Pod face and arm base edges"). The cans stand 7 mm proud of the faceplate, like a loader's lights.
- **Fitting the board:** push it into the pod **from the back**, cans first, header up. The cans drop into the eyes (Ø16.8 for the Ø16 cans), which locates the board, and two **snap strips** on the side walls click in behind the PCB. To release, push the strips outward with a fingernail and draw the board back.
- **Cable:** four Dupont jumper wires onto the header, led back through the 16 × 13 mm slot in the nose wall and up through the front cable slot to J403.
- A small window at the bottom of the faceplate clears the HC-SR04's crystal, which stands 3 mm proud of the board's front face.
- The JST plug on the back of the board goes straight back through the slot in the chassis nose, as before.
- The board sits **flat** (no tilt), its cans centred **24 mm** above the floor (it dropped 6 mm so the header plugs clear the plate). With the HC-SR04's 15° measuring angle the floor stays outside the beam beyond about 90 mm.
- The pod sits between the two front legs with 4.9 mm each side at the front block (7.7 at the strips), and the cans end 2 mm behind the legs' tips, so the legs still guard them.

## The arm module, styled after the toy excavator
| Toy excavator | On the RoboCore arm |
|---|---|
| Curved boom with an open frame | Each side plate has a curved boom outline (up to 12.5 mm high in the middle) with truss windows. Until 23 Oct they were three 45° diamonds; now they are the four windows a topology optimization chose (see "Arm plates, topology-optimized" below), still with 45° roofs so they print without supports |
| Hydraulic cylinder along the boom | A barrel, gland, rod and two eyes run along the top between the plates. Two saddles and a central web carry it, and that stiffens the yoke too |
| Big round pivot bosses with bolt heads | The RoboCore 9-tooth gear with a hex bolt head on the right shoulder (the horn screw sits in a counterbore in it), and hex bolt-head bosses at the wrist on both plates |
| Bucket with teeth | The jaws are claws, with a curved back and three bucket teeth on each grip edge (they also grip better) |
| Cab with louvre vents | The arm base's rear post has five louvre slots, and the base plate has a rounded "counterweight" back |
| Yellow and black | Colour scheme: the arm and base in excavator yellow, the jaws black (print the arm in yellow PETG) |

The mechanism and its numbers are unchanged:
- shoulder axis at y 64, z 77;
- floor pose −35.7°;
- gripper on gear sectors.

The arm is 3 g heavier, at 11 g.

### Arm plates, topology-optimized (2026-10-23)
Fred asked for topology optimization across the design, starting with the arm. The side plates carry the load, so
they are the design domain; the pipeline is `topo/arm_topo.py` (numpy/scipy, no Fusion needed):
- **Model:** 2D plane-stress finite elements on 0.5 mm cells over the boom profile plus the shoulder circle; SIMP with
  the optimality-criteria update, a 1.5 mm density filter (no strut under 1.6 mm), and Langelaar's additive-manufacturing
  filter with the build direction +z (the arm prints deck-down): a design cell may only be as dense as the three cells
  below it, so every window roof comes out at 45°. The 1.6 mm outer skin uses a wider stencil, which is the bridge rule:
  a flat ceiling up to 12 mm prints. A post-pass (`printable()`) enforces the same rules on the thresholded layout.
- **Kept solid:** the outline skin (1.6 mm), the shoulder hub to y 16 (horn arm and screws), the wrist block from y 56
  (deck junction and bolt boss), the cylinder saddle band and the mid brace.
- **Loads:** 1.2 N on the wrist deck (gripper servo, jaws and a 100 g object) with its 9 mm lever, arm level (bending)
  and arm raised 85° (mostly axial), hub fully fixed.
- **Result, Fred's pick (20 % of the design area):** four windows, plate area 847 mm² (was 1041 with the diamonds,
  −19 %), wrist deflection 21 µm at 1.2 N (was 13 µm; the plates were never stiffness-limited, this is a mass and looks
  change). Polygons in `BOOM_WINDOWS_TOPO`, `BOOM_WINDOW_STYLE = 'topo'`; the 30 % layout (three windows, −17 %) is in
  `topo/arm_topo_result.json` too. Preview: `topo/arm_topo_proposal.png`.
- **How it went into Fusion:** the old diamonds were filled and the new windows cut on the *existing* arm body, so
  Fred's hand chamfers on the arm stayed. The generator now produces the same windows.
- **To redo it** (other load, other target): `python3 topo/arm_topo.py 0.20 0.30`, read the polygons from the JSON,
  paste into `BOOM_WINDOWS_TOPO`, then cut them in Fusion. The same code can take another plate-like part by changing
  `build_domain()` and the loads.
- **Wrist deck and jaws (same day, Fred's picks):** these print flat, so their windows need no overhang rule but their
  loads bend them out of plane, which a 2D plate model cannot see. `topo/topo3d.py` is a voxel (8-node hex) SIMP solver
  with one density per column through the thickness (through-windows only); `topo/jaw_deck_topo.py` sets up both parts
  (0.75 and 0.8 mm voxels, loads: 100 g object on the jaws with its lever, the grip force, the servo). The deck keeps
  the servo posts, the plate junctions and a 1.6 mm ring round every hole; Fred chose the **50 % layout**, trimmed to
  its **three windows** over 12 mm² (`DECK_WINDOWS`): 1189 → 919 mm², jaw-pivot deflection 126 → 193 µm with a 100 g
  object. On the jaws the optimizer only found an irregular slot (the hub, gear sector, horn slot and teeth leave a thin
  band), so each finger got a hand-drawn **teardrop slot** in the same place for the family look (`JAW_SLOT`, 28 mm²,
  1.4 mm from the edge). Both were cut on the live bodies (the jaws have no hand edits, but the joints stay valid that
  way). Arm 10.5 → 10.0 g. Pictures: `renders/rev6_topo/`, `topo/jaw_deck_proposal.png`.
- **Yoke between the plates (same day, Fred's option 2, a standing web):** the hydraulic-cylinder styling, its saddles,
  the web and the mid brace (3.6 cm³ together) are gone. A voxel topology optimization of the space between the plates
  (`topo/yoke_topo.py`, 1.5 mm voxels, 3D self-support filter) first returned a flat X web lying on the bed (38× the
  bare plates' side stiffness, 1.2 cm³); Fred rejected the look and asked for a web standing between the faces. That is
  a **ground-structure truss optimization** (`topo/yoke_truss.py`): the plates (with their windows) and the deck are
  voxels, 737 candidate struts run between anchors on the plate inner faces, two mid rows, a ridge above the plate tops
  (z 11 to 14) and the deck top; a candidate exists only if it rises at **45° or steeper from a supported node**, or is
  a bridge under 18 mm between free nodes, so the result prints support-free by construction. Strut areas are sized by an
  optimality-criteria update for the weighted side, twist and bending compliances at 1.4 cm³, with a penalty and two
  pruning stages so the material concentrates; a repair pass props any node nothing rises into. Loads as before: a
  0.5 N side push with its 50 mm lever, an 18 N·mm twist, bending. **Result: 11 struts, Ø2.0 to 3.4 mm, 1.3 cm³**: a
  long Λ from the plate feet at y 30 to an apex at z 14 above the plates, four legs from the deck up to the ridge, two
  short arches from the plate sides and one ridge bridge. Side stiffness 3.6× the bare plates (the flat X was 38×, the
  twist barely changes with any web that must start at the plate feet). Built in Fusion as real cylinders with spherical
  joints (`TemporaryBRepManager`, a base feature, one Combine), trimmed at the bed plane; arm 10.0 → 8.6 g. Earlier
  candidates are kept in `topo/yoke_struts_8.json`, `_15.json` (the 15-strut one has a ridge node nothing supports) and
  the voxel webs. Pictures: `renders/rev6_topo/yoke_*.png`, `topo/yoke_truss_preview.png`.

## Moving the model in Fusion (joints)
Open **RoboCore V2 Robot** and drag a part, or right-click a joint in the browser and choose **Drive Joints**:

| Joint | What moves | Range |
|---|---|---|
| Shoulder | the arm with the gripper servo, horn and screws | −35.7° (jaws 2 mm off the floor) … +85° |
| Jaw L / Jaw R | the jaws; the **Gripper gears** motion link makes them open together, like their gears | 0° (closed) … 35° each |
| Wheel L / Wheel R | each wheel with its tyre, screw and washer | free |
| Battery | the BatteryHolder3S sliding out of the back | 0 … 110 mm |

- Everything else is grounded.
- Screws, horns and the gripper servo ride along with their parts in rigid groups.
- From a script:
  ```python
  build_robot.pose(arm_deg, jaw_deg, battery_out_mm, 0, wheel_deg)
  ```

There were no clashes in three poses: floor with the jaws closed, carry (+30°, jaws 12°) and up (+85°, jaws 35°), screws included.

## Hardware (modelled and placed)
| Qty | Part | Where |
|---|---|---|
| 4 | M2 × 6 thread-forming (plastic) screw into a Ø1.7 × 6 pilot in each boss | board on the deck |
| 2 | M2 × 6 pan head (self-tapping) + M2 washer | wheels, into the shaft's centre hole (reach it through the Ø16 hole in the side wall) |
| 2 | M3 nut, captive in a hex pocket in the deck top under the bracket plate | dock towers |
| 2 | M3 × 8 socket head (no arm) **or** M3 × 10 socket head (with the arm base stacked on the bracket) | sonar bracket (+ arm base) into the dock |
| 4 | M2 × 8 pan head (self-tapping, come with the servos) | servo tabs, 2 per servo |
| 2 | SG90 single-arm horn (come with the servos) | shoulder (against the right boom plate), gripper (in a slot under the driven jaw) |
| 1 | M2 × 8 pan head | shoulder horn centre screw, in the counterbore of the gear boss |
| 2 | M2 × 5 pan head | through the right boom plate into the shoulder horn's arm |
| 3 | M2 × 4 pan head | gripper horn: centre screw + 2 through the horn arm into the jaw |
| 1 | M3 × 8 pan head (self-taps into the deck) | idle jaw pivot |
| 3 + 3 | M3 nut in a side slot in the tab + M3 × 8 thumb screw | bus clip and the two ballast clips (the screw presses on the deck) |
| 1 | M3 nut in a hex pocket at the end of the boss | bus clip accessory boss |
| 6 | M8 hex nut | ballast clips, 3 each |

## Checks (rev 5, run with `fusion/checks.py`, last run 2026-10-07)
| Check | Result |
|---|---|
| Interference: each part against its neighbours, boards, motors and every screw included | **0 clashes** in the carry, floor and up poses, except a 0.08 mm³ graze between the right snap hook and the HC-SR04's edge (the next pod rebuild widens the pod 0.2 mm). Allowed on purpose: the tyre's stretch fit, and screws that self-tap into a smaller pilot or thread into the servo spline. Fusion cannot analyse the linked servo assemblies against the parts round them, so those pairs are checked by eye |
| Antenna (metal within 15 mm of the ESP32 antenna end) | Closest metal: the front board screws at **19.6 mm** (rev 6: screws and captive nuts, no inserts). Then shoulder servo 20.8, dock screws 25.5, battery holder 26.5, ultrasonic 41.2 mm. **Pass** |
| CG / casters / tipping, glass balls, no arm | 457 g, CG (0.2, −10.6, 29.4) mm. The **two casters carry 14 %**. Tips forward only above 0.36 g of braking, sideways above 2.3 g |
| Same, ½" steel balls | 471 g, casters 16 % |
| **Arm fitted + 6 × M8 in the ballast clips** | 542 g (the MG90S is 4 g heavier than an SG90), CG (−0.1, −7.3, 35.0). **Casters 10 %** (steel: 12 %). Tips forward above 0.21 g |
| Arm fitted, no nuts | 515 g, casters **4 %**. Tips forward above 0.08 g. **Fit the nuts** |
| Line sensor | Underside 10.5 mm (allowed 9–13). TCRT5000 faces 3.4 mm off the floor. The skid under the nose touches first on a nose-dive (2.9° vs 3.7°) |
| Bed fit (A1 mini, 180 mm cube) | Every part fits. The largest is the chassis: **167.2 × 166.0 × 48.3 mm** over the hubs, lying on its deck |
| Overhangs in print orientation (chassis top-down) | **No unsupported overhangs in any part.** The only flat ceilings are the 2 mm motor-hook catches; the nose has no bridges and no enclosed cavity (rev 6) |

## Printed parts (masses from the shell/infill model in checks.py)
| Part | Qty | Material / colour (A) | Print orientation (as exported) | Mass |
|---|---|---|---|---|
| Chassis | 1 | PETG yellow (construction) or teal | **deck (top) down** | 133 g |
| Wheel | 2 | PETG dark teal | flat inner face down | 7.9 g each |
| Tyre | 2 | TPU 95A black | flat | 4.6 g each |
| Sonar bracket (pod) | 1 | PETG yellow | plate top face down (pod up) | 11.1 g |
| **Base robot** | | | | **170 g** |
| Arm base / Arm / Jaw L / Jaw R | 1 each | PETG **yellow** / black jaws | as exported (arm deck down, web up) | 7.8 / 8.6 / 1.1 / 1.3 g (arm 11.1 g before the topology work) |
| Ballast clip | 2 (with the arm) | PETG black | on its side | 3.8 g each |
| Bus clip (template) | as many as you like | PETG black | on its side | 1.7 g |
| Rail coupon (test piece) | 1 | PETG | deck down | 3.3 g |

Print settings:
- 0.2 mm layers, 3 walls, 25 % gyroid (wheels and arm 30 %, jaws and clips 40 %).
- **No supports** and no bridges to speak of: every wall in the nose stands straight up from the deck.
- PETG at 240–250 °C; TPU slow (≤ 25 mm/s).
- The chassis's deck is a big flat area on the bed (about 150 cm²). Use a clean textured PEI sheet and a 5 mm brim if the corners lift.
- The tread-plate grooves are in the face that lies on the bed (1 mm wide, 0.6 mm deep). If your first layer squashes them shut, turn on elephant-foot compensation (about 0.15 mm).
- For the earth-mover look, paint the chevron grooves black and the tail-light lenses red, or use a marker.

The chassis is roughly 9–11 h on an A1 mini at standard PETG speeds (an estimate; slice to confirm). **Print the rail coupon and one bus clip first** (about 30 min) to check your printer's tolerances.

## Bill of materials (per robot)
| Qty | Part | Where |
|---|---|---|
| 2 | XRP-style TT gearmotor with encoder (SK51D 90:1, 6-pin) + its cable to the board's MOTOR sockets | motors |
| 1 each | RoboCore V2 board, RoboCore Line Sensor | |
| 1 | **HC-SR04** ultrasonic module (the common 45 × 20 mm board) | sonar pod |
| 1 | **BatteryHolder3S** (3 × 18650, 61.6 × 78.4 mm), **wired 1S3P (all three cells in parallel)**, with an XT30 female lead to the board | battery |
| 3 | 18650 cells, matched (same type, charged to the same voltage before fitting) | |
| 2 | **½" (12.7 mm) steel balls** (bearing balls or slingshot ammo, 8.4 g) or 12.7 mm glass marbles | rear casters |
| 4 | Dupont jumper wires, female-female, 200 mm (or a JST SH 4-pin to Dupont lead) | HC-SR04 header → J403 |
| 1 | JST SH 5-pin cable, 200 mm, straight-through | line sensor → J404 |
| 4 | M2 × 6 thread-forming screw for plastic (Ø1.7 pilot) | board on the deck |
| 2 | M3 hex nut (DIN 934), captive in the deck top | dock towers |
| 2 | M2 × 6 self-tapping + M2 washer | wheels to shaft centre holes |
| 2 | M3 × 8 socket head | sonar bracket into the dock (M3 × 10 when the arm base stacks on it) |
| **Arm module** | | |
| 1 + 1 | **MG90S** (shoulder, metal gears) + **SG90** (gripper) micro servos | screws and horns come with the servos |
| 1 | M3 × 8 pan head (self-taps into the deck) | idle jaw pivot |
| 2 | M3 × 10 socket head | arm base + sonar bracket into the dock (instead of the 2 × M3 × 8) |
| 1 + 2 + 3 | M2 × 8 pan head + 2 × M2 × 5 + 3 × M2 × 4 | shoulder horn centre screw, shoulder horn arm to the boom plate, gripper horn (the servos' own screws are too short for the shoulder) |
| 2 | Ballast clips (printed) + 2 × M3 nut + 2 × M3 × 8 thumb screw | rear rail |
| 6 | M8 hex nut (about 5.2 g each) | 3 in each ballast clip |
| **Each bus clip** | | |
| 2 | M3 nut (one in the tab slot, one in the accessory boss) + 1 × M3 × 8 thumb screw | clamp (screw onto the deck) + accessory mount |

The base robot needs **8 screws and 2 nuts, no inserts**. There is no battery screw any more.

## Assembly
1. **Nuts:** drop an M3 nut into each hex pocket on the deck top at the dock (they stay captive once the sonar plate is on). No inserts anywhere; no soldering iron needed.
2. **Wheels onto motors:**
   - Stretch each tyre over its rim until both beads drop into the rim grooves.
   - Push each wheel onto its shaft and fit an M2 × 6 + washer.
3. **Casters:** with the chassis upside down, press a ½" ball up into each rear socket until the lip clicks over it.
   - **To take a ball out again** (to reuse it or clean the socket): turn the robot over, find the Ø5.5 vent hole in the deck straight above the ball, near each rear corner, and push the ball out with a small flat screwdriver (3 mm blade) or a 4 mm hex key. If the arm module is fitted, undo that side's ballast clip thumb screw first: the clip's tab sits over the vent.
4. **Motors (chassis upside down, battery out):**
   - Plug the encoder cable into the motor first.
     - On the **left** motor the socket faces down. Its cable comes out under the robot and goes up through the **rear-left cable port**.
     - On the right motor the socket faces up, under the **plug slot** in the deck.
   - Push each motor + wheel straight in: shaft outward, encoder cover to the back. The shaft and pin slide up their slots and the wheel goes into its well. Keep pushing until the gearbox meets the stops and **both hooks click** under it.
5. **Line sensor (chassis upside down):**
   - Plug the 5-pin cable into the board's socket first and lead it up through the **front cable slot** in the deck.
   - Offer the board up into the nose pocket, TCRT5000s down, JST socket toward the right, holes on the two bosses.
   - 2 × M3 × 8 self-tapping screws from below into the bosses. Printed 1 mm washers between the board and the bosses lower it if you want more sensor clearance.
6. **Ultrasonic:**
   - Plug the 4-pin cable into the board's socket.
   - Push the HC-SR04 into the pod from the back, cans first, header pins up, until both snap strips click behind it.
   - Feed the plug and cable through the slot in the front wall, then bolt the bracket to the dock (2 × M3 × 8; M3 × 10 if the arm is going on).
   - Lead the cable up through the front cable slot.
7. **Board:** set it on the deck and screw it down with 4 × M2 × 6. Plug in the motors, then the sensors.
8. **Battery:**
   - Fit the three cells all the same way round; the holder is wired 1S3P.
   - Slide the holder in from the back, onto the V-rails, until it meets the front stops and **both flaps click** behind it.
   - Bring the XT30 lead up through the slot behind the board.
   - **To remove it:** push the two flaps outward and slide the holder out.
9. **Arm module (optional):**
   1. Fit the MG90S between the base posts (2 × M2 × 8 tab screws).
   2. Push a horn onto the shoulder spline so the arm will sit at **−35.7° (floor) at servo 0°**.
   3. Put the boom's left plate over the D-pin and its right plate against the horn:
      - the M2 × 8 centre screw goes in through the gear boss;
      - 2 × M2 × 5 go through the plate into the horn's arm.
   4. Fit the SG90 on the deck posts (2 × M2 × 8).
   5. Put the second horn into the slot under the driven jaw (2 × M2 × 4). Close the jaws, push the jaw onto the spline and fit the M2 × 4 centre screw from below.
   6. Hang the idle jaw on its M3 × 8.
   7. Set the base on the sonar bracket and bolt both to the dock (2 × M3 × 10). Plug the servos into SERVO 1 and SERVO 2.
   8. **Fit a ballast clip to the rear wall at x ±44:** tilt it, push its tongue into the bus groove (the bump drops into a detent), swing the tab down and tighten its thumb screw onto the deck. Drop 3 × M8 nuts into each.

**Wheel screw:** reach it with a screwdriver through the round hole in each wheel-section side.

**Motor swap:**
1. Take the battery out.
2. Turn the robot over and unplug the motor.
3. Push its two hooks inward, toward the battery bay, with a small screwdriver.
4. Pull the motor and wheel down and out.

## Open items (for Fred)
1. **Encoder socket on the left motor:** the two motors are identical, so the left one is the right one turned over and its socket faces **down**. The cable leaves under the robot and goes up the rear-left cable port. Check this on the real motor. If its socket is on a side face instead, the port and the plug slots may need to move.
2. **Sonar pod snap strips:** they are 2 mm thick and 35 mm long, hanging from the plate, and the hooks reach 1.3 mm over the PCB. If they feel too soft or too stiff on the first print, `POD_SNAP` sets the hook reach.
3. **Size:** 162 × 166 mm over the walls, 52 mm to the deck (64 mm to the top of the XT30 on the board).
4. **Battery wiring:** the holder is called "3S" but must be wired **1S3P**. **Never wire it in series:** the board is 1S, 4.2 V maximum. Use matched cells.
5. **Ballast with the arm:** fit the two ballast clips with 6 × M8. Without them the casters carry only 5 % and the robot noses down when braking. The excavator styling added about 6 g up front, so with the nuts the casters carry 11 % (it was 14 %). If that feels light, a fourth nut per clip is a small change.
6. **Tolerances, not yet test-printed.** Print the chassis and check:
   - the motor hooks (2 mm catch, 0.1 mm under the gearbox) and the 0.2 mm gearbox fit;
   - the V-rails and flaps against your holder (it should slide in with light friction and click);
   - the caster lip (0.7 mm interference; if a ball won't go in, raise `CASTER_LIP_Z` by 0.3);
   - the tyre stretch (ID 45.2 on a 46 seat);
   - the clip gap (`CLIP_GAP`, tune on the coupon).
   Any change is one number in `rc_params.py`.
7. **Board on top:** the board is now exposed, like the XRP's. A clip-on cover is easy to add if you want one.
8. **Mass:** the chassis is 134 g with your edits (the rev 5 draft was 107 g), because of the deck and the full-height inner walls. If weight matters, the deck can go from 2.5 to 2.0 mm, or take a hole pattern (it would no longer be fully covered).
9. **Line-sensor LEDs** are no longer visible from above: they are under the deck and the sonar bracket.
10. **No clips over the wheels** (−35 < y < 35 on the wheel sides): there is no groove there.
11. **Horns:** the shoulder horn sits against the right boom plate (no recess) and is held by 3 screws. Check one real SG90 horn against the model: hub Ø7 × 4 mm, arm 16 mm, holes at 9 and 13 mm.
12. **Battery joint in screenshots:** driving the Battery joint does move the holder (I checked its position: 75 mm out puts its rear end 64 mm behind the rear wall). Fusion's viewport didn't redraw the linked holder in my scripted screenshots, though, so there is no picture of it.
13. **Faduino line sensor:** not in the project folder yet (only the RoboCore_LineSensor, the HC-SR04, the servos and the battery holder are there). Add it to the RoboCore V2 folder and I will swap it in: `LINE_HOLES` moves the two bosses to its holes and the deck's cable slot moves over its header.
14. **Battery holder to motor gap (5b, 14 Oct):** in the model the holder's case passes **0.9 mm** from the DG01D-E's encoder end, through the rail-wall window (worst case about 0.4 mm with the holder's play between the rails). The motor is a community model, so measure this on a real DG01D-E before the first print. If it really is that close, `MOTOR_IN` 40.5 → 41.2 moves both motors out 0.7 mm; the wheel-section skin follows and the robot gets 1.4 mm wider.

## Regenerating
In Fusion, with **RoboCore V2 Robot** open, run from the Scripts dialog or through Claude:
```python
import sys; sys.path.insert(0, '<this folder>/fusion')
import build_robot; print(build_robot.main())        # all steps, or main(['chassis_shell', 'chassis_cradle', ...])
build_robot.pose(-35.7, 0)                           # drive the joints: arm (deg), jaws (deg), battery out (mm)
import checks; print(checks.interference()); print(checks.antenna()); print(checks.all_checks()); print(checks.overhangs())
import export; export.print_files(); export.assembly_files(); export.renders(); export.hero()
build_robot.apply_scheme('construction')               # or 'teal', 'orange'
```
- **Fred's hand edits (since 23 Oct 2026) come first.** The Chassis carries 31 hand-made features after the generator's
  (sweeps, mirrors and wall extrudes along the front and rear sections), the Arm base 9 (the cab restyle) and the Arm
  12 (0.4 mm chamfers on its bottom edges). **Do not run the `chassis_*`, `arm_base` or `arm` steps on the live
  document:** they delete and rebuild the part and those features with it. Add new features on the existing bodies
  instead, the way the topology windows were cut (`scratchpad/b_arm_topo.py` pattern: `_yz_extrude` on the live
  component). The generator steps remain the record of the designed geometry and the way to rebuild from scratch.
- **The last steps are `hardware`** (screws, inserts, nuts and horns, placed with the arm level), **`joints`** (grounding, rigid groups, joints and the jaw motion link) **and `pose`**. Rebuilding a part removes the joints that use it, so run `hardware`, `joints` and `pose` again afterwards.
- **The chassis is built in nine steps** (`chassis_shell`, `_cradle`, `_front`, `_holes`, `_bus`, `_detents`, `_finish`, `_style`, `_tread`), so each fits in one Fusion call. `chassis_style` is slow (about 25 min, mostly the two badge logos). Rebuild from `chassis_shell` after any change: each step adds to the body that the steps before it made.
- **Long checks** (the full interference run) can outlast one MCP call; `checks.interference(log=path)` writes its progress to a file.
- **Rebuilt parts can come back as "Wheel (1)".** Fusion keeps a deleted part's name reserved until the file is reopened, and the scripts match on the base name, so nothing breaks.
