Plastal-Bot-Builders/RoboCoreDocumentation/mechanical/robot_v2/cardboard/branded_net.pdf

# ROBOCORE V2

CLASSROOM ROBOT · BUILD. CODE. CREATE.

ESP32-S3 · 2 MOTORS · 4 SERVOS · LINE + ULTRASONIC · IMU OPEN HARDWARE FOR CLASSROOMS · REV 2.0 · 2026

## ROBOCORE ZAMBIA · PLASTAL-BOT BUILDERS · LUSAKA

# DESIGNED IN ZAMBIA

# MEET ROBOCORE V2

A classroom robot designed and built in Zambia. Drive, sensing and building are all on one board. This cardboard chassis gets you moving in an afternoon; later the same board drops into the 3D-printed one.
ESP32-S3 with Wi-Fi and Bluetooth
Two encoder motors, four servo ports, IMU
Line and ultrasonic sensing
Add the arm module: two servos, gear-linked claw

REV 2.0 · 2026

### SPECIFICATIONS

Controller RoboCore V2, ESP32-S3, 68 x 60 mm Power 1S Li-ion, 3 x 18650 in parallel, USB-C charging

Drive 2 x TT encoder motors, 56 mm wheels, 2 casters Sensing 3-channel line sensor, HC-SR04 ultrasonic, IMU

Chassis 125 x 150 x 41 mm, 3 mm card

DOCS & CODE

DESIGNED IN ZAMBIA
RoboCore Zambia · Lusaka
plastalbotbuilders.com

# ROBOCORE V2

### CLASSROOM ROBOT · REV 2.0

DESIGNED IN ZAMBIA

DESIGNED IN ZAMBIA

### CLASSROOM ROBOT · REV 2.0

# ROBOCORE V2

ARM MODULE SERVO

CONTROLLER

USB-C

### 2 X WHEELS

3D PRINTED CHASSIS

# HOW TO BUILD

1 Cut the solid lines, score the folds.
2 Fold up the side walls, then the rear wall; glue its tabs. 3 Motors through the shaft holes, zip-tied; wheels on. 4 Battery holder in from the back; casters on.
5 Deck over, front flap down; glue its tabs.
6 Controller on the deck, leads up through the slots. 7 HC-SR04 behind the flap, line sensor under the nose. Keep metal 15 mm from the antenna. Not for under 8s.

## WHAT IT CARRIES

CONTROLLER | LINE SENSOR | ULTRASONIC | SERVO (ARM MODULE)

BATTERY HOLDER 3 x 18650

MOTOR

MOTOR

CASTER | CASTER

LINE SENSOR UNDERNEATH

RoboCore V2 cardboard chassis, branded print, 1:1 on A3 (3 mm card). Solid navy = cut, grey dashed = fold (score, do not cut).
Check: the bar at the right must measure 100 mm.
