Plastal-Bot-Builders/RoboCoreDocumentation/mechanical/robot_v2/cardboard/robot_cardboard_net.pdf

FRONT FLAP (folds down from the deck; HC-SR04 behind it, cans through the holes, header up)

HC-SR04 45 x 20

DECK 150 x 125 (top; controller 68 x 60 screws here, 4 x M2)

RoboCore V2 board

antenna at the front edge: no metal within 15 mm

rear slot: battery lead, sensor leads, USB-C plug motor lead slots (under the MOTOR sockets)

rear edge: folds over the rear wall

REAR WALL 119 x 38

battery slides in here (64 x 23.5 opening)

FLOOR 144 x 119 (inside)

BatteryHolder3S 61.6 x 78.4 x 21.6

3 x 18650, 1S3P, held with hook-and-loop tape

free area: wiring, spare

MOTOR

TT + encoder

caster

SIDE WALL 144 x 38

shaft 6.5 / pin 4.5

zip-tie slots

MOTOR

## TT + encoder caster

SIDE WALL 144 x 38

shaft 6.5 / pin 4.5

zip-tie slots

NOSE SHELF: line sensor 60 x 24 under here, 2 x M3

cable notch in the flap above

tab

tab

glue

glue

RoboCore V2 cardboard chassis, cut-out at 1:1 (3 mm card). Black = cut, red dashed = fold, blue = where parts go.
Net 200 x 403 mm. Folded: 125 x 150 x 41 mm body, deck top 55 mm above the ground.

bar = 100 mm at 1:1
