Plastal-Bot-Builders/RoboCoreDocumentation/mechanical/robot_v2/packaging/out/box_dieline.pdf

TONGUE

LID

BACK

FLOOR

FRONT

DUST FLAP

DUST FLAP

FRONT END FLAP

FRONT END FLAP

END WALL (box right)
END WALL (box left)
INNER END WALL

INNER END WALL

RoboCore V2 mailer box dieline, outer 273 x 203 x 83 mm, E-flute 1.5 mm, 1:1. Printed-outside view.
