Plastal-Bot-Builders/RoboCoreDocumentation/mechanical/robot_v2/packaging/out/insert.pdf

ROBOCORE V2 ROBOT

2 SERVOS | JAWS

ARM BOOM

ARM BASE

CLIPS · SCREWS · CABLE

Insert tray 258 x 198 mm, 40 mm thick (two layers of 20 mm foam, or eight of 5 mm corrugated), 1:1. Lies on the floor of the box, front edge at the bottom.
