Plastal-Bot-Builders/RoboCoreDocumentation/mechanical/robot_v2/packaging/out_v3/insert.pdf

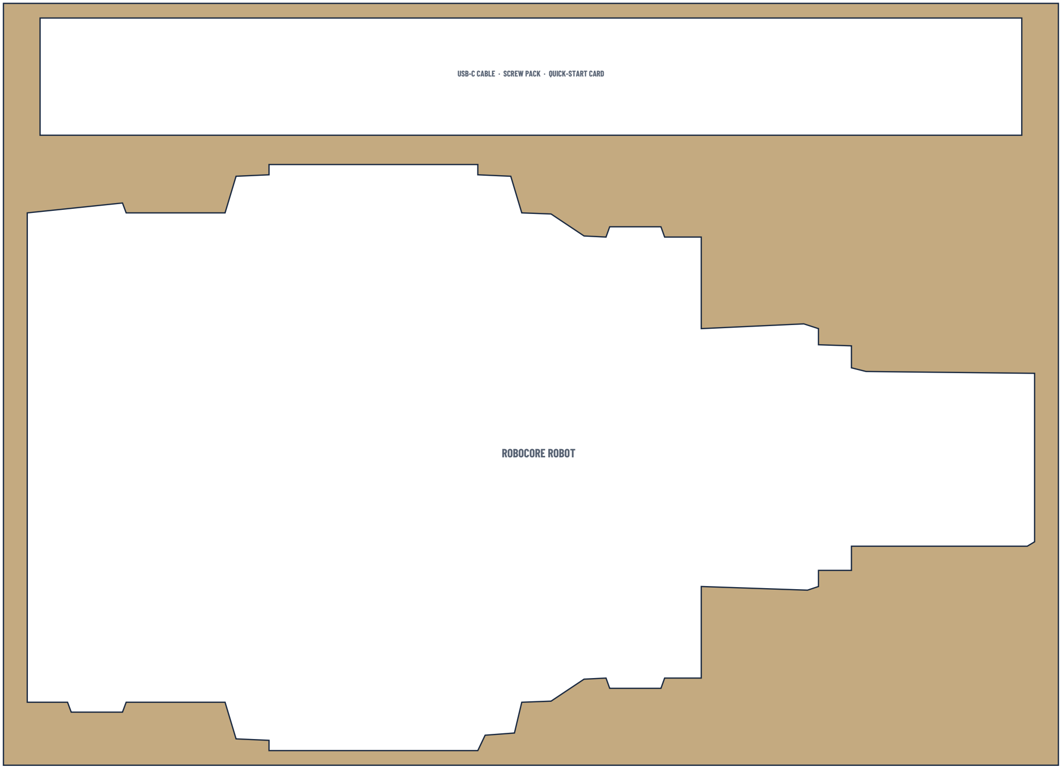
[picture p24: figure]
ROBOCORE ROBOT

USB-C CABLE · SCREW PACK · QUICK-START CARD

Insert tray 288 x 208 mm, 40 mm thick (two layers of 20 mm foam, or eight of 5 mm corrugated), 1:1. Lies on the floor of the box, front edge at the bottom. The robot stands in its pocket (its top view in the packing pose, lift down, + 3 mm); the cable, the screw pack and the card lie in the strip behind it.
