Plastal-Bot-Builders/RoboCoreDocumentation/design/event_branding/review/brochure_1.png

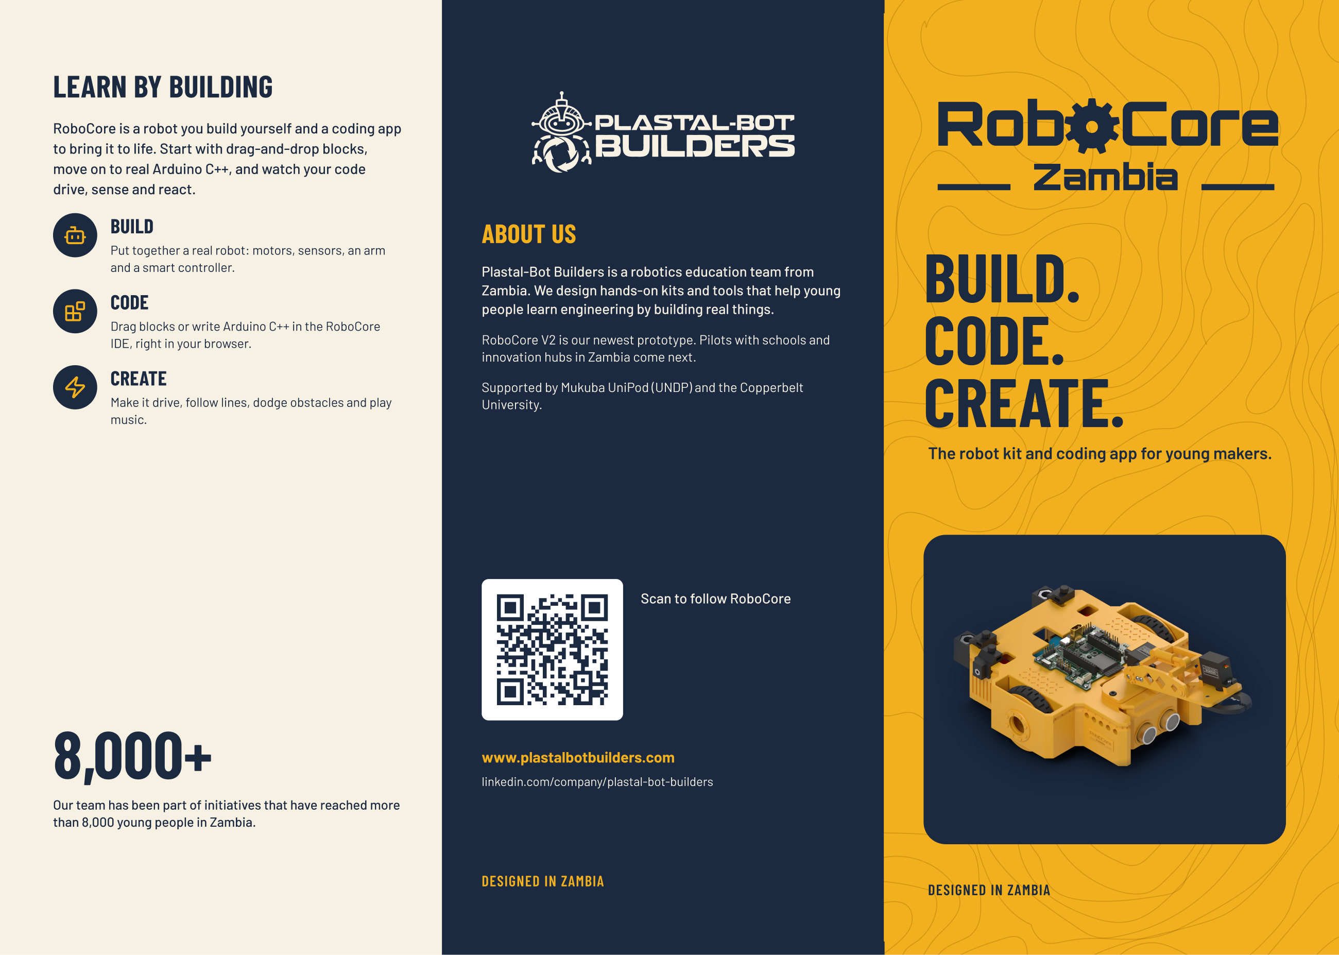
design/event_branding/review/brochure_1.png
