Plastal-Bot-Builders/RoboCoreDocumentation/design/event_branding/review/brochure_2.png

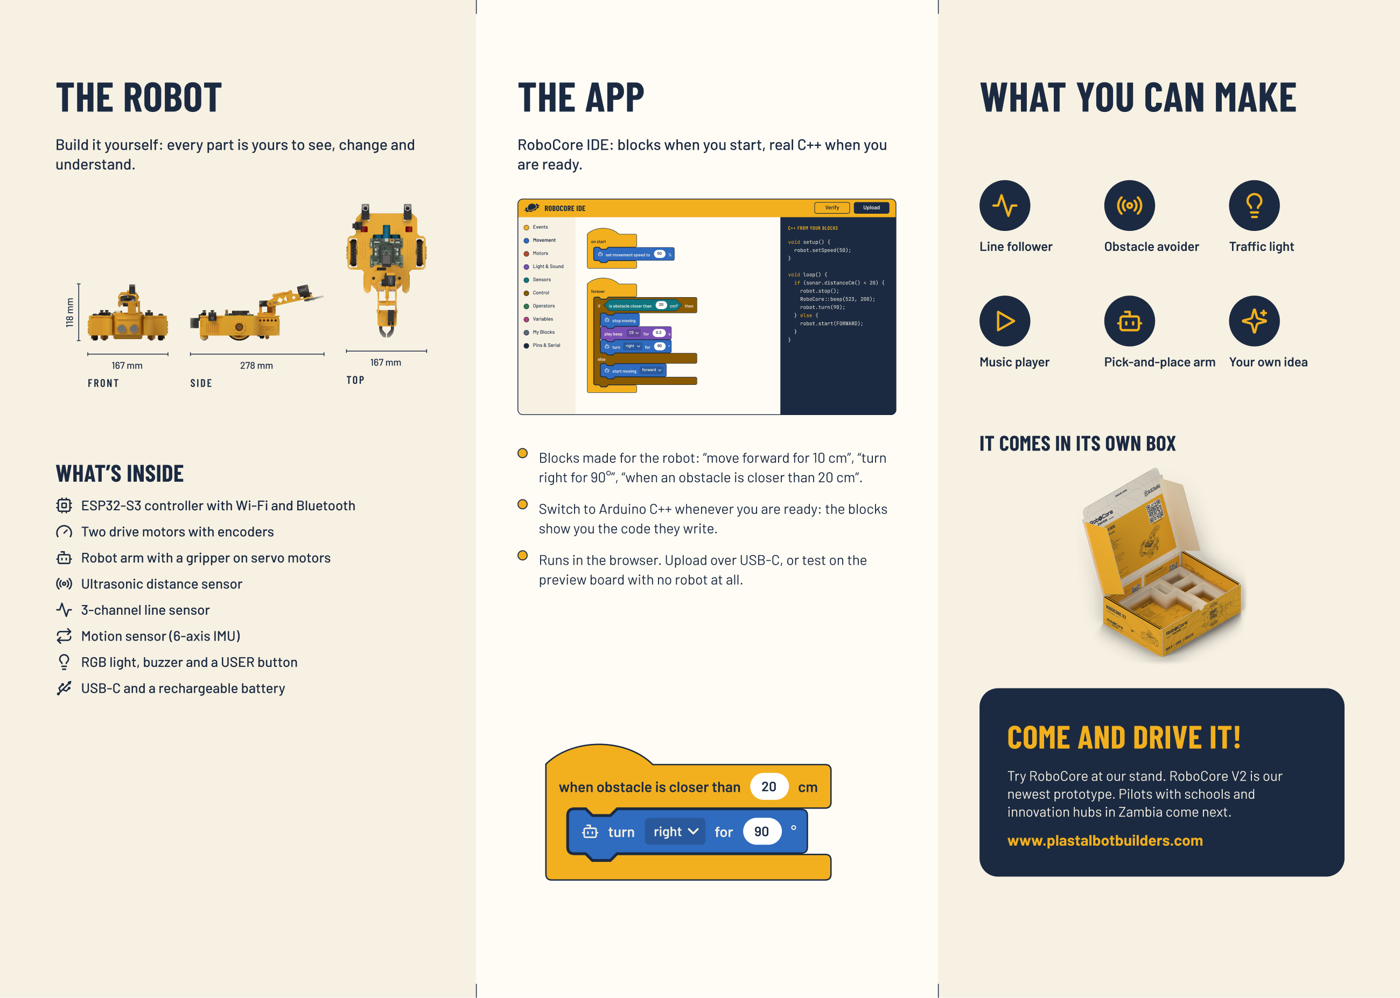
design/event_branding/review/brochure_2.png
