Plastal-Bot-Builders/RoboCoreDocumentation/design/event_branding/review/flyer_2.png

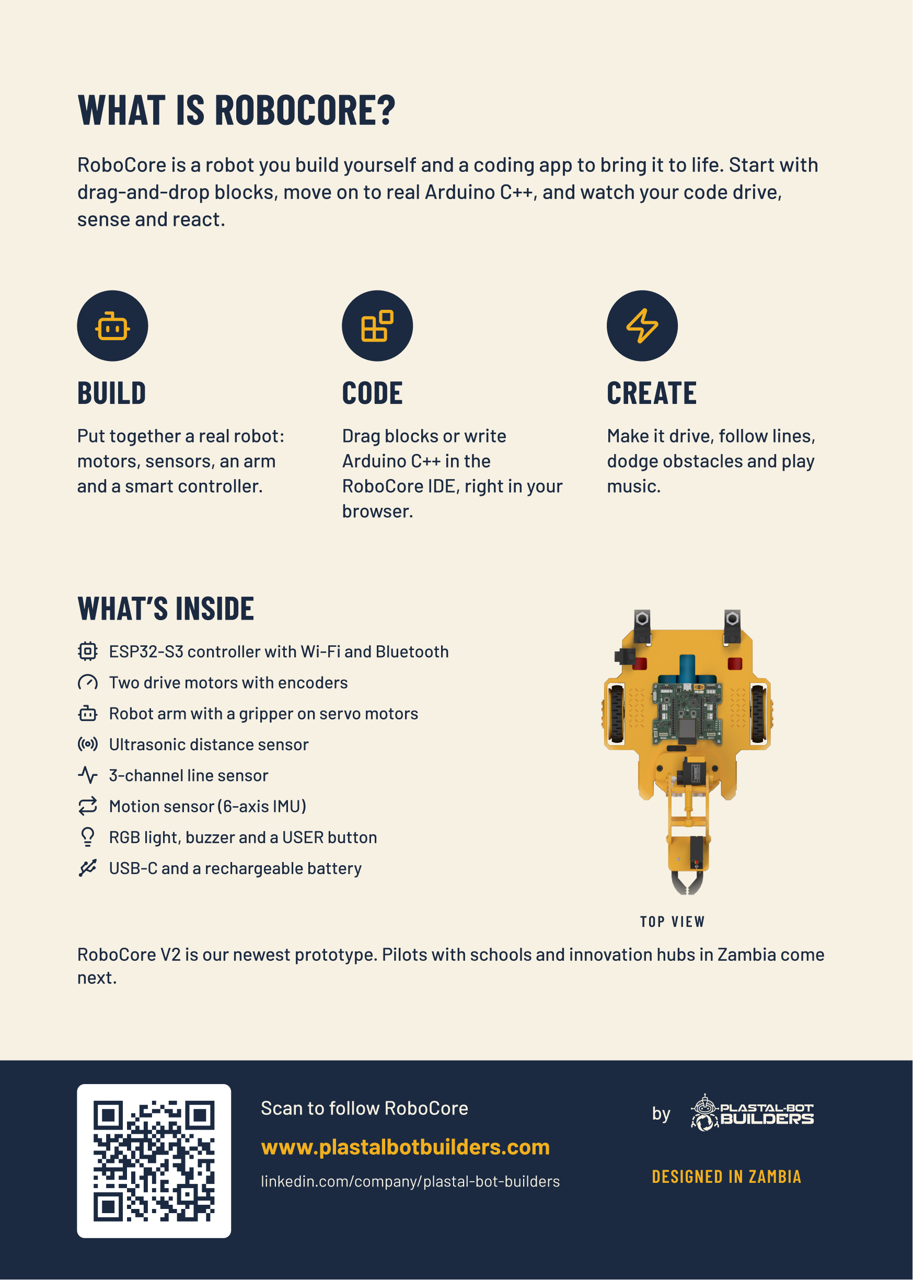
design/event_branding/review/flyer_2.png
