Plastal-Bot-Builders/RoboCoreDocumentation/design/event_branding/review/kit.png

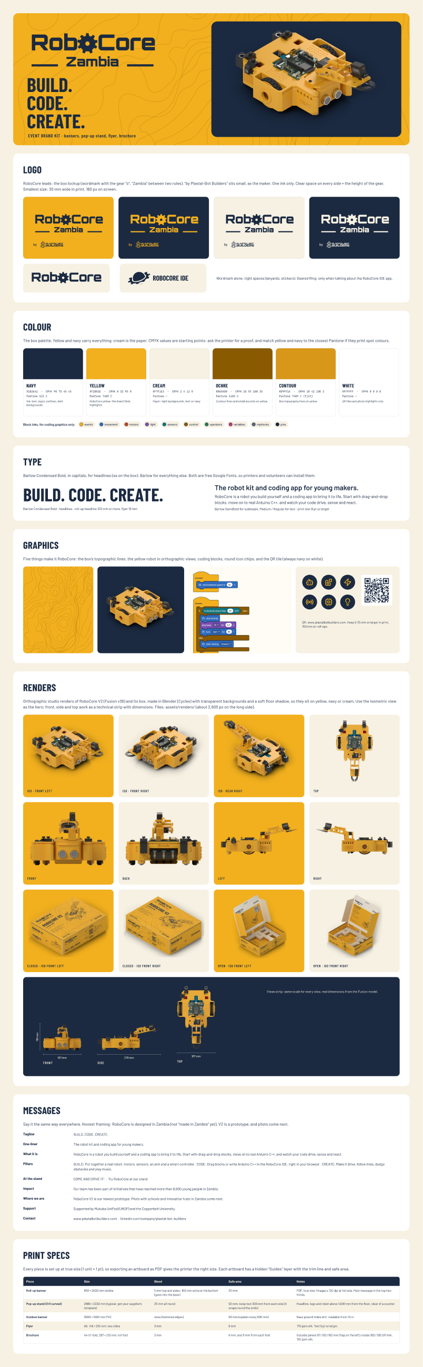
design/event_branding/review/kit.png
