Plastal-Bot-Builders/RoboCoreDocumentation/design/event_branding/review/kit_0_Cover.png

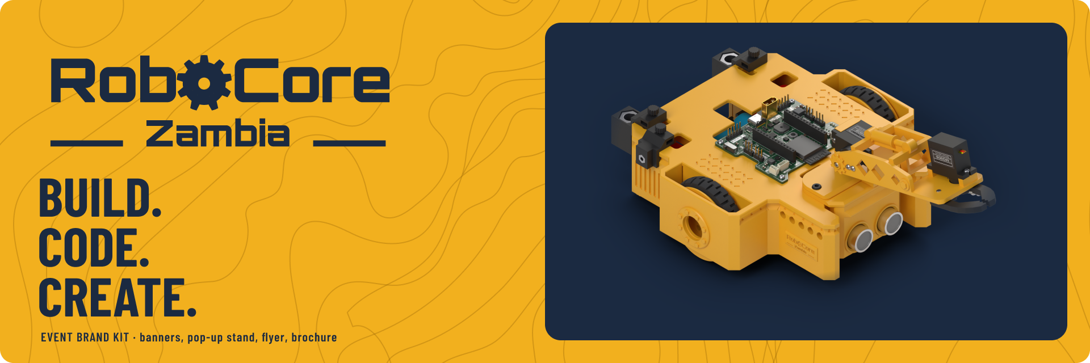
design/event_branding/review/kit_0_Cover.png
