Plastal-Bot-Builders/RoboCoreDocumentation/design/event_branding/review/kit_2_Section_Colour.png

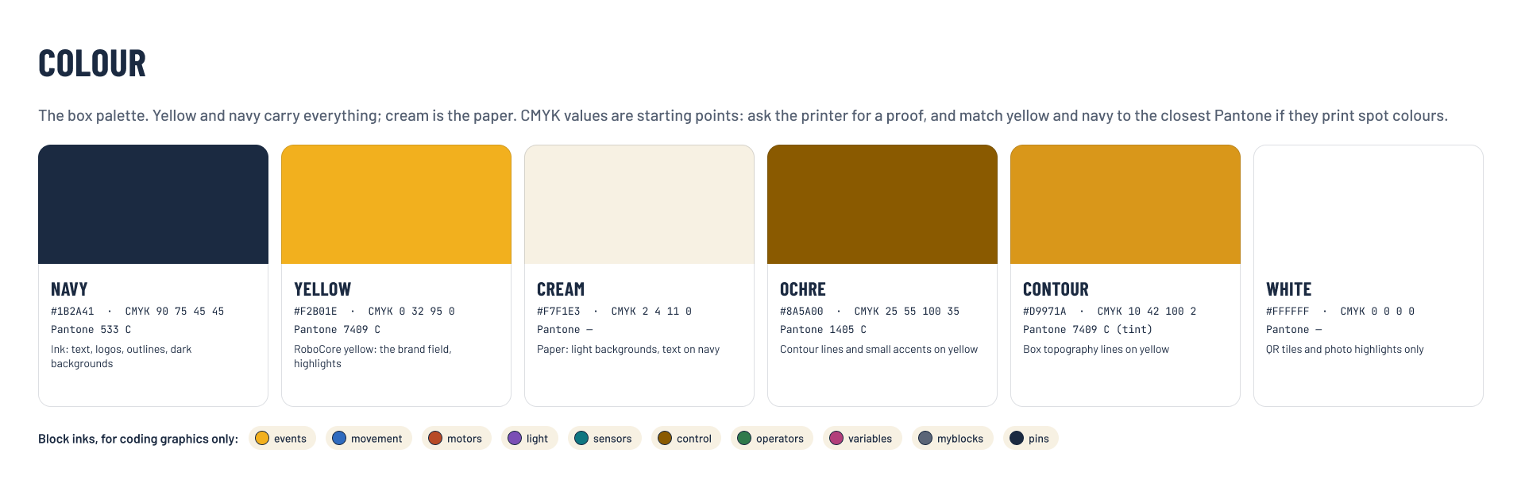
design/event_branding/review/kit_2_Section_Colour.png
