Plastal-Bot-Builders/RoboCoreDocumentation/design/event_branding/review/kit_3_Section_Type.png

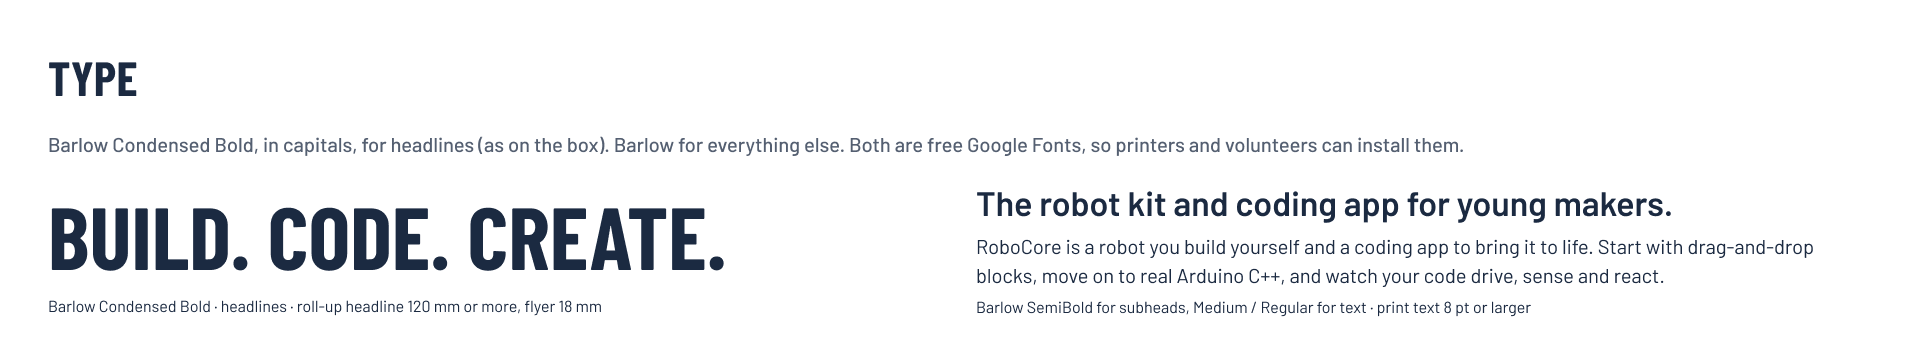
design/event_branding/review/kit_3_Section_Type.png
