Plastal-Bot-Builders/RoboCoreDocumentation/design/event_branding/review/kit_4_Section_Graphics.png

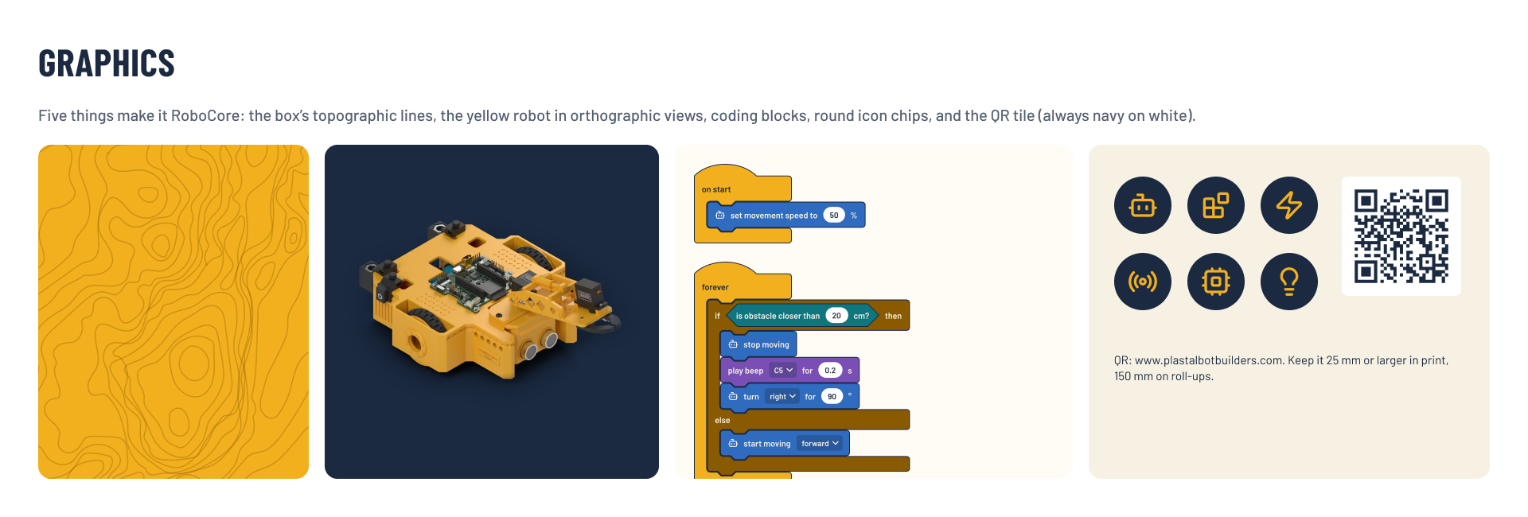
design/event_branding/review/kit_4_Section_Graphics.png
