Plastal-Bot-Builders/RoboCoreDocumentation/design/event_branding/review/kit_6_Section_Messages.png

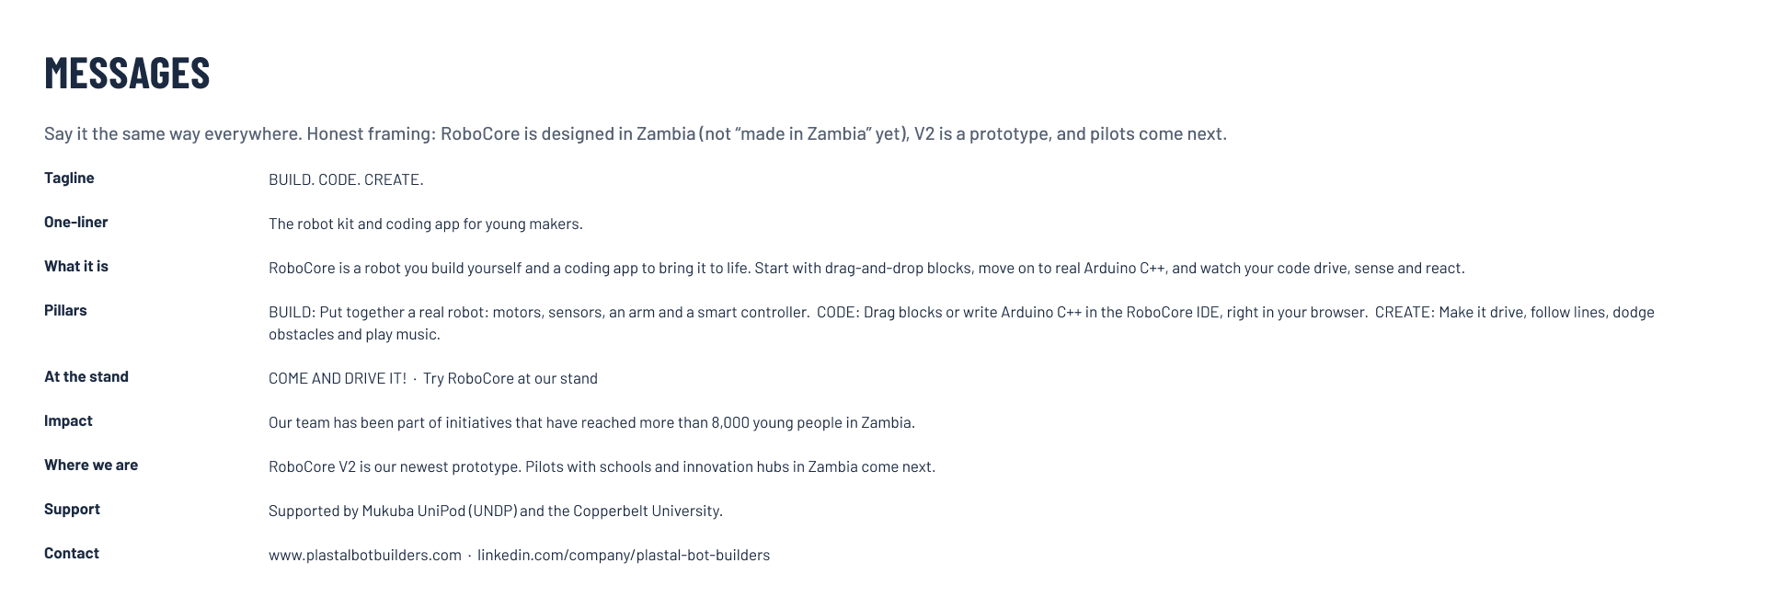
design/event_branding/review/kit_6_Section_Messages.png
