Plastal-Bot-Builders/RoboCoreDocumentation/design/event_branding/review/popup.png

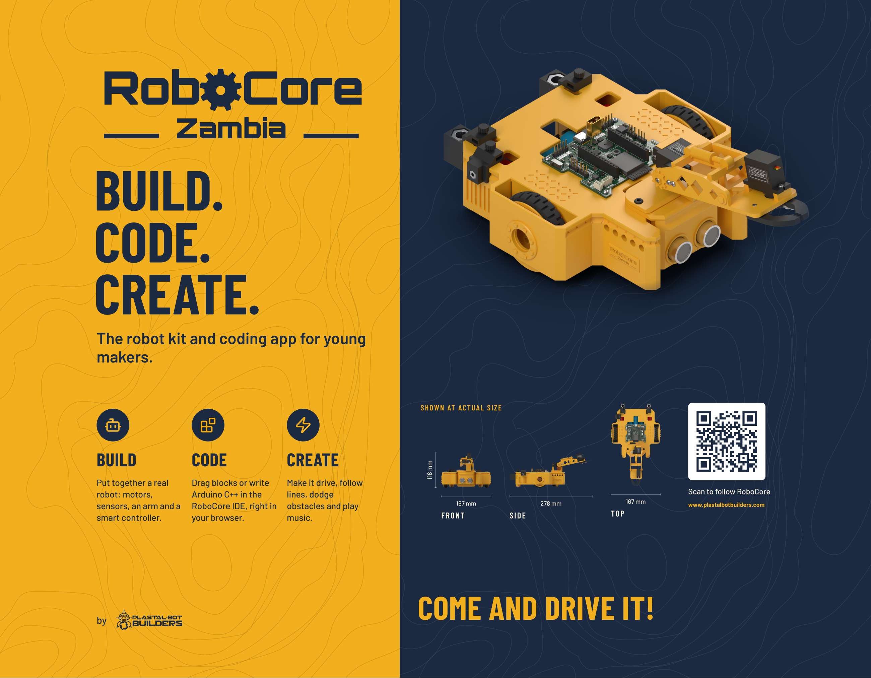
design/event_branding/review/popup.png
