Plastal-Bot-Builders/RoboCoreDocumentation/design/event_branding/topo/samples/chingola_flow_preview.jpg

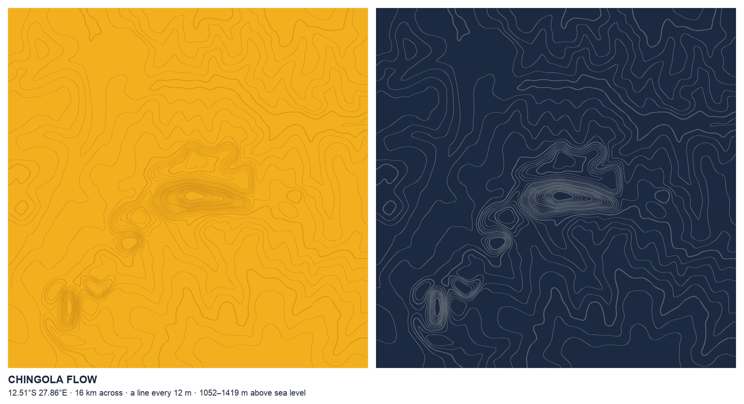
design/event_branding/topo/samples/chingola_flow_preview.jpg
