Plastal-Bot-Builders/RoboCoreDocumentation/design/event_branding/topo/samples/compare.jpg

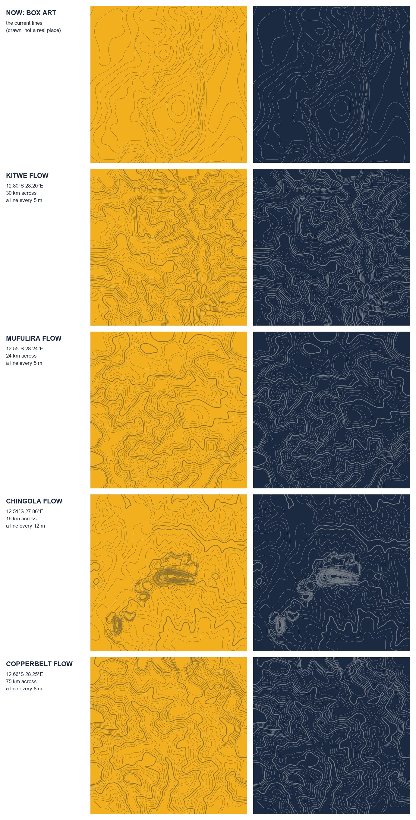
design/event_branding/topo/samples/compare.jpg
