Plastal-Bot-Builders/RoboCoreDocumentation/design/event_branding/topo/samples/copperbelt_preview.jpg

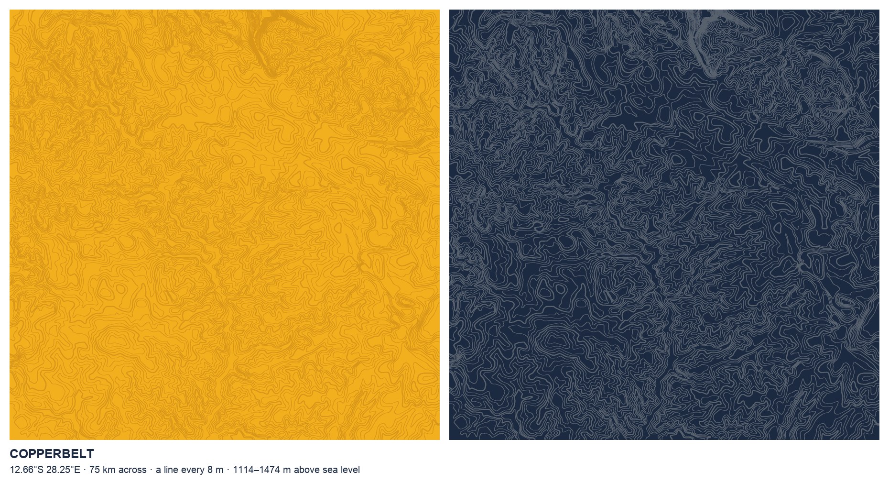
design/event_branding/topo/samples/copperbelt_preview.jpg
