Plastal-Bot-Builders/RoboCoreDocumentation/design/event_branding/topo/samples/kitwe_flow_preview.jpg

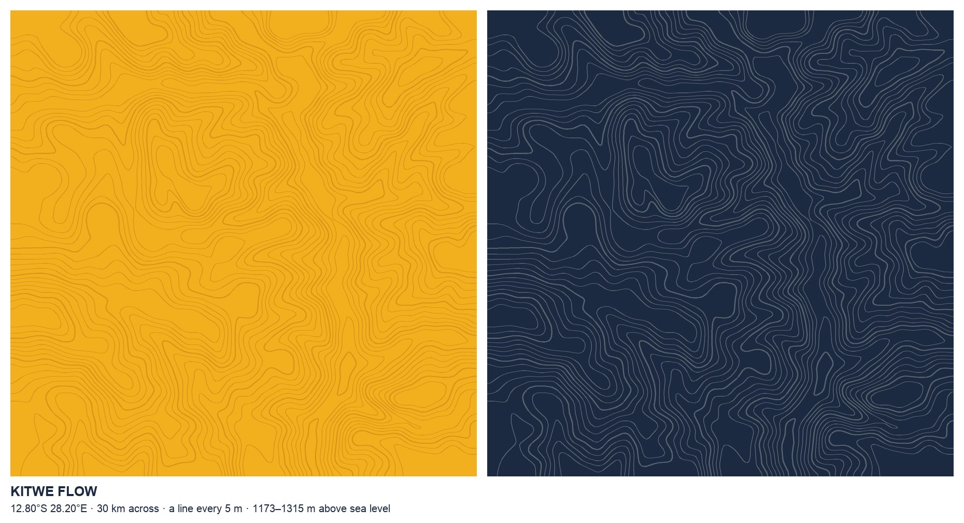
design/event_branding/topo/samples/kitwe_flow_preview.jpg
