Plastal-Bot-Builders/RoboCoreDocumentation/design/event_branding/topo/samples/kitwe_preview.jpg

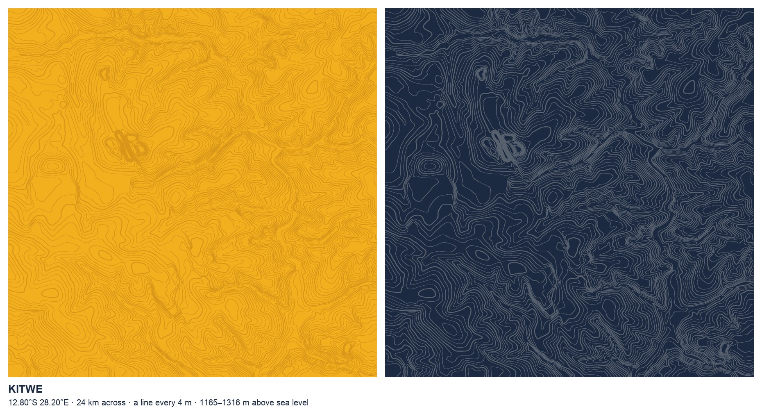
design/event_branding/topo/samples/kitwe_preview.jpg
