Plastal-Bot-Builders/RoboCoreDocumentation/design/event_branding/topo/samples/mufulira_flow_preview.jpg

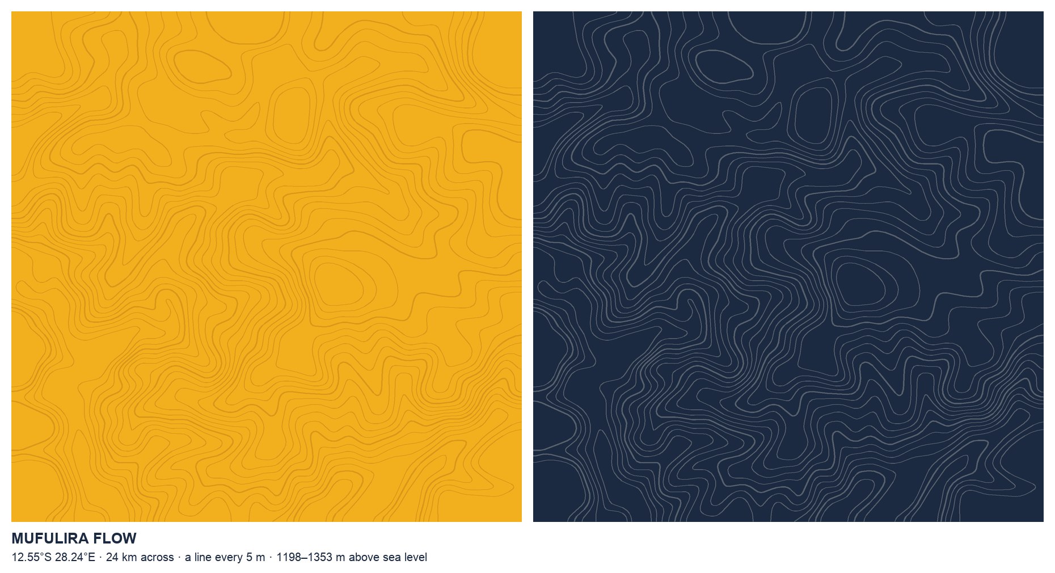
design/event_branding/topo/samples/mufulira_flow_preview.jpg
