Plastal-Bot-Builders/RoboCoreDocumentation/design/event_branding/topo/samples/mufulira_preview.jpg

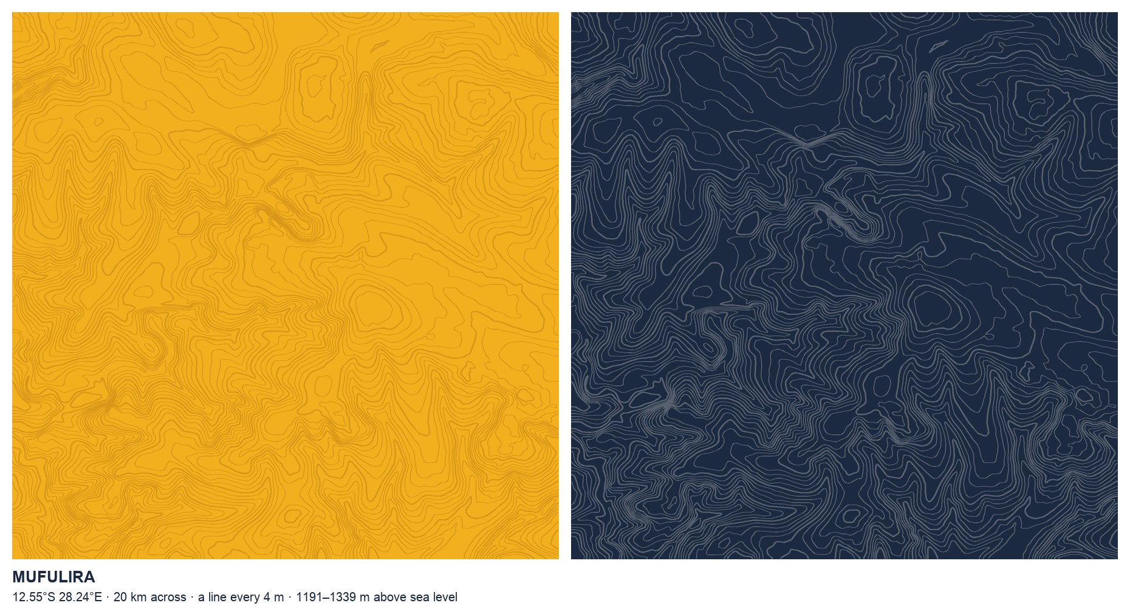
design/event_branding/topo/samples/mufulira_preview.jpg
