Plastal-Bot-Builders/RoboCoreDocumentation/design/event_branding/topo/samples/overview.jpg

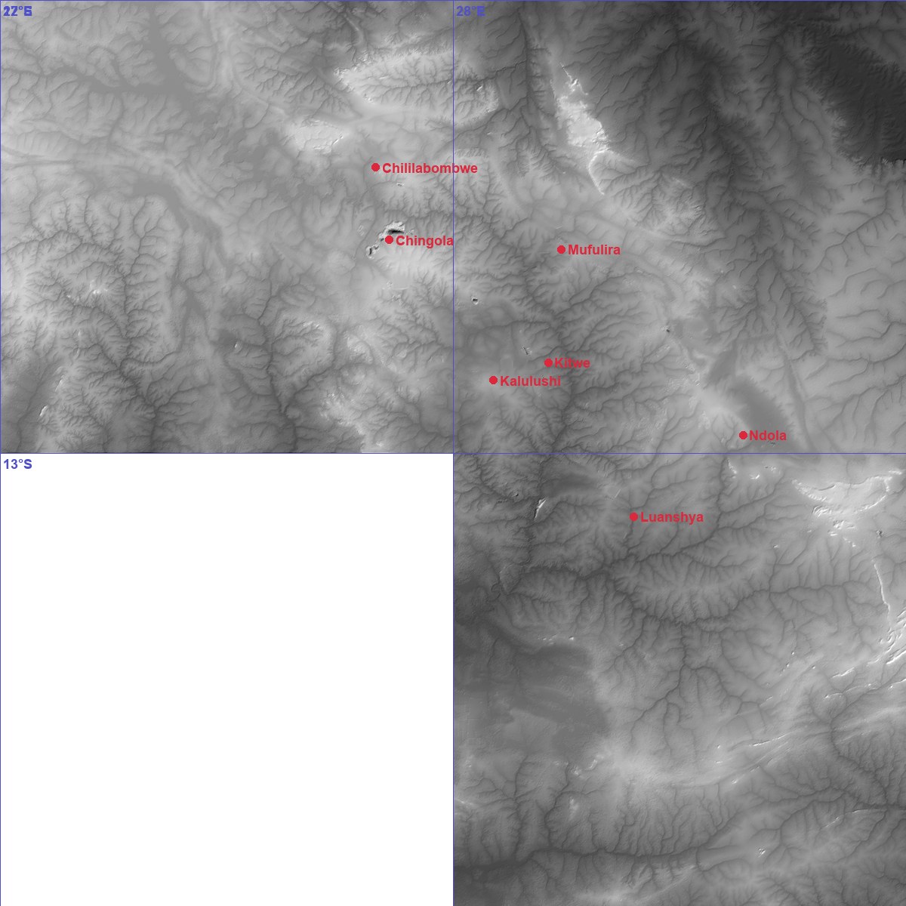
design/event_branding/topo/samples/overview.jpg
