Plastal-Bot-Builders/RoboCoreDocumentation/docs/photos/01_controller.jpg

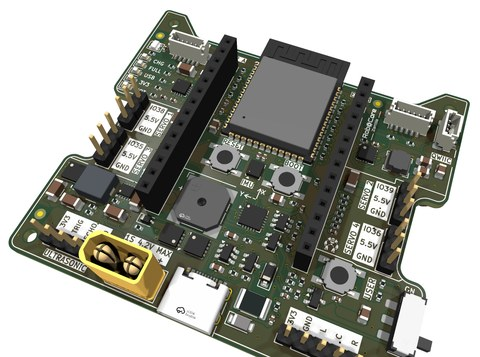
docs/photos/01_controller.jpg
