Plastal-Bot-Builders/RoboCoreDocumentation/docs/photos/02_xrp_motor_pair.jpg

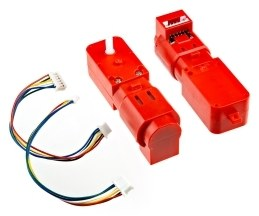
docs/photos/02_xrp_motor_pair.jpg
