Plastal-Bot-Builders/RoboCoreDocumentation/docs/photos/03_ultrasonic_rcwl-1601.jpg

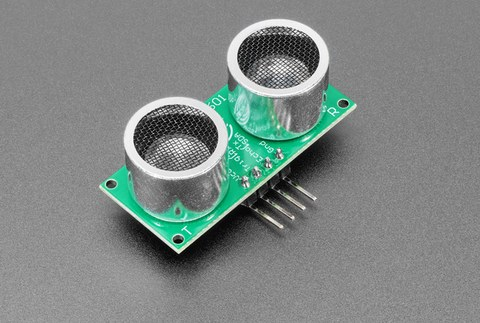
docs/photos/03_ultrasonic_rcwl-1601.jpg
