Plastal-Bot-Builders/RoboCoreDocumentation/docs/photos/04_line_sensor_3ch.jpg

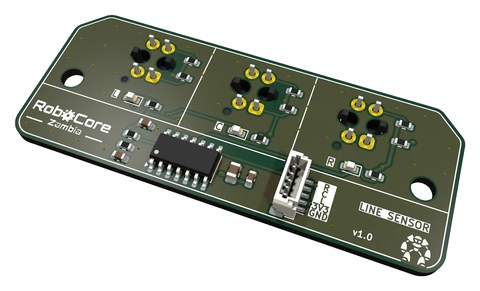
docs/photos/04_line_sensor_3ch.jpg
