Plastal-Bot-Builders/RoboCoreDocumentation/docs/photos/05_servo_mg90.jpg

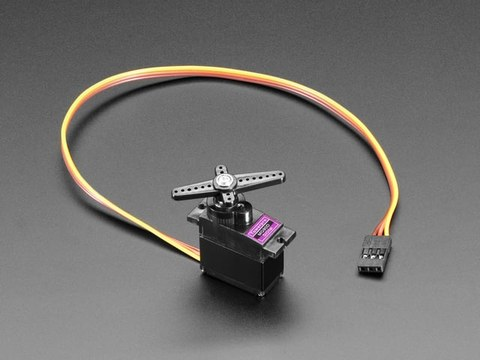
docs/photos/05_servo_mg90.jpg
