Plastal-Bot-Builders/RoboCoreDocumentation/docs/photos/06_cell_18650.jpg

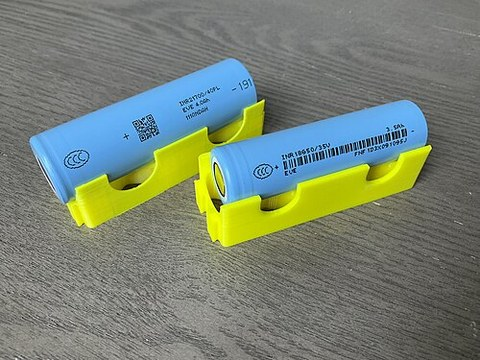
docs/photos/06_cell_18650.jpg
