Plastal-Bot-Builders/RoboCoreDocumentation/docs/photos/06_servo_sg90.jpg

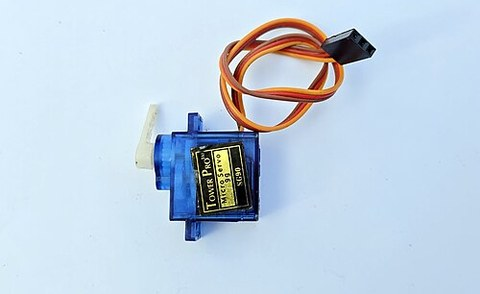
docs/photos/06_servo_sg90.jpg
