Plastal-Bot-Builders/RoboCoreDocumentation/docs/photos/07_holder_18650.jpg

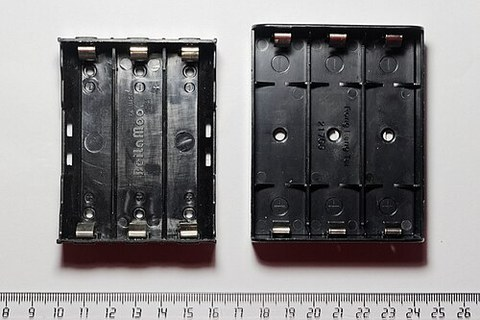
docs/photos/07_holder_18650.jpg
