Plastal-Bot-Builders/RoboCoreDocumentation/docs/photos/09_bms_1s.jpg

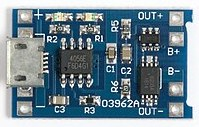
docs/photos/09_bms_1s.jpg
