Plastal-Bot-Builders/RoboCoreDocumentation/docs/photos/10_usb_charger.jpg

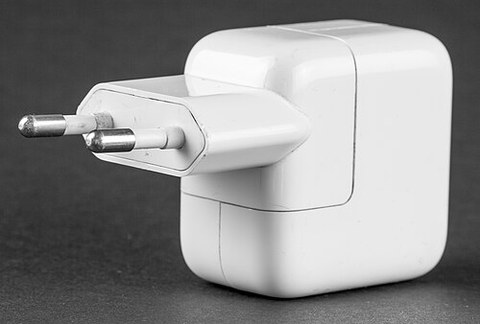
docs/photos/10_usb_charger.jpg
