Plastal-Bot-Builders/RoboCoreDocumentation/docs/photos/10_xt30.jpg

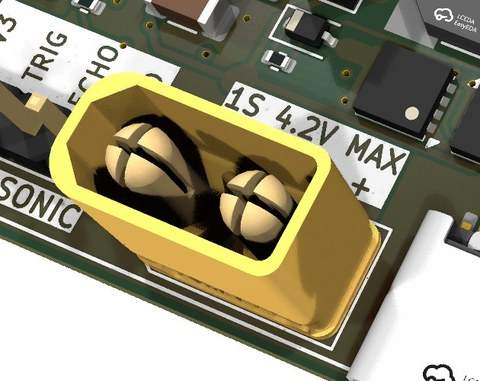
docs/photos/10_xt30.jpg
