Plastal-Bot-Builders/RoboCoreDocumentation/docs/photos/11_insert_m2.jpg

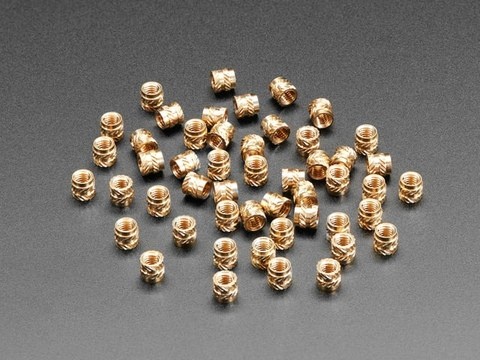
docs/photos/11_insert_m2.jpg
