Plastal-Bot-Builders/RoboCoreDocumentation/docs/photos/12_dupont_wires.jpg

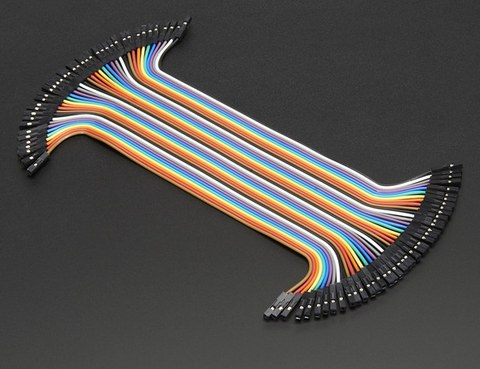
docs/photos/12_dupont_wires.jpg
