Plastal-Bot-Builders/RoboCoreDocumentation/docs/photos/13_usb-c_cable.jpg

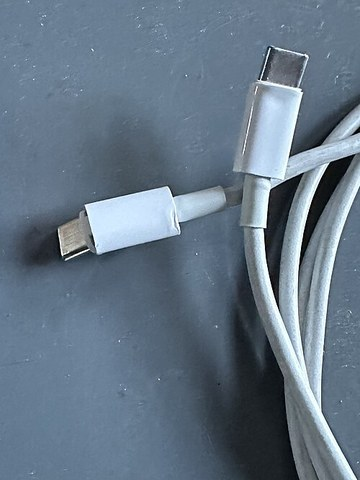
docs/photos/13_usb-c_cable.jpg
