Plastal-Bot-Builders/RoboCoreDocumentation/docs/photos/17_screw_m2x6_pan.jpg

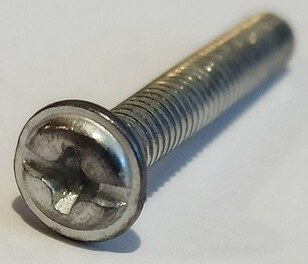
docs/photos/17_screw_m2x6_pan.jpg
