Plastal-Bot-Builders/RoboCoreDocumentation/docs/photos/18_screw_m2x6_self-tapping.jpg

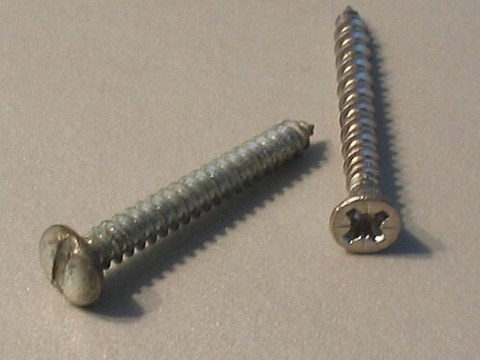
docs/photos/18_screw_m2x6_self-tapping.jpg
