Plastal-Bot-Builders/RoboCoreDocumentation/docs/photos/19_washer_m2.jpg

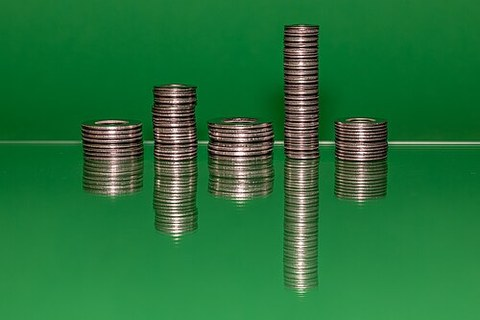
docs/photos/19_washer_m2.jpg
