Plastal-Bot-Builders/RoboCoreDocumentation/docs/photos/21_thumb_screw_m3.jpg

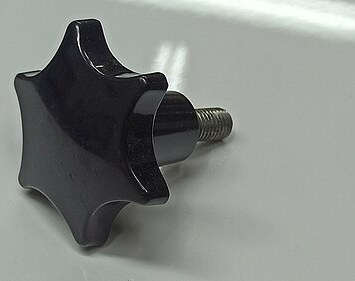
docs/photos/21_thumb_screw_m3.jpg
