Plastal-Bot-Builders/RoboCoreDocumentation/docs/photos/23_screw_m3x10_socket.jpg

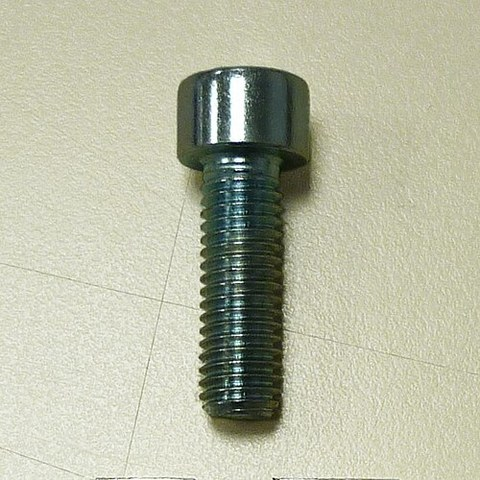
docs/photos/23_screw_m3x10_socket.jpg
