Plastal-Bot-Builders/RoboCoreDocumentation/docs/photos/26_nut_m8.jpg

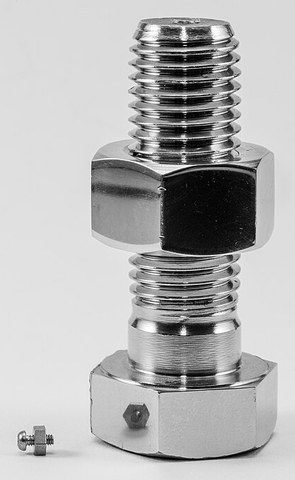
docs/photos/26_nut_m8.jpg
