Plastal-Bot-Builders/RoboCoreDocumentation/docs/photos/27_steel_ball_12.7.jpg

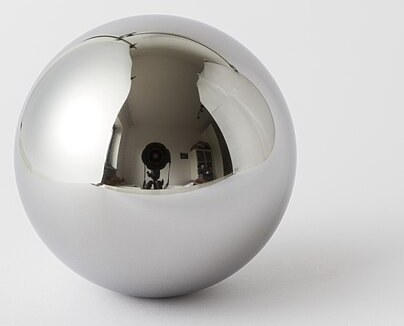
docs/photos/27_steel_ball_12.7.jpg
