Plastal-Bot-Builders/RoboCoreDocumentation/docs/photos/28_mailer_box.jpg

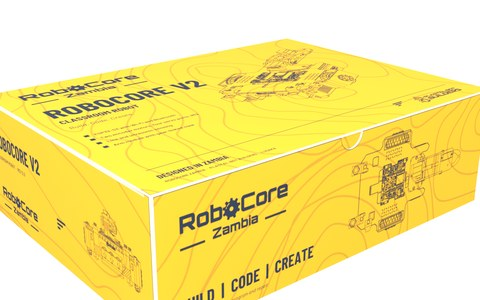
docs/photos/28_mailer_box.jpg
