Plastal-Bot-Builders/RoboCoreDocumentation/docs/photos/28_petg_yellow.jpg

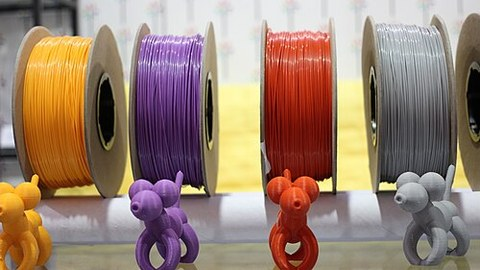
docs/photos/28_petg_yellow.jpg
