Plastal-Bot-Builders/RoboCoreDocumentation/docs/photos/31_insert_tips.jpg

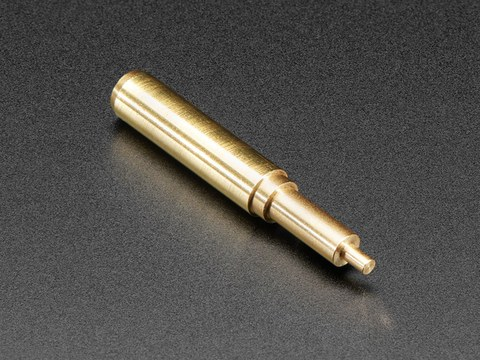
docs/photos/31_insert_tips.jpg
