Plastal-Bot-Builders/RoboCoreDocumentation/docs/photos/contact_sheet.jpg

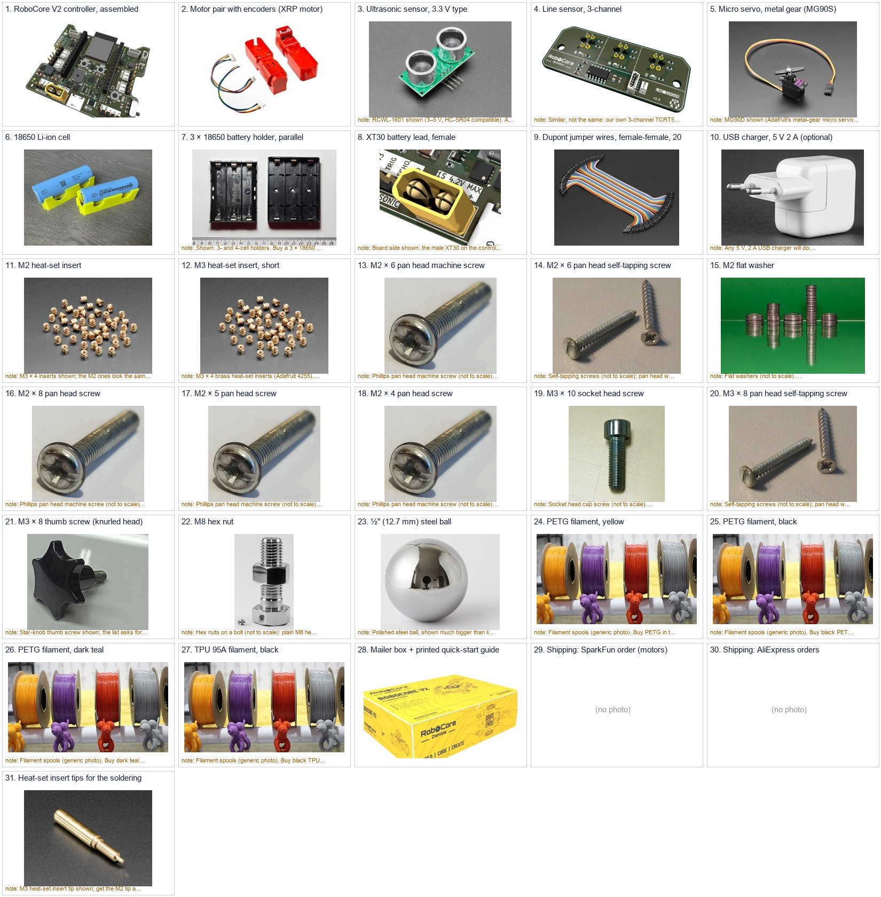
docs/photos/contact_sheet.jpg
