Plastal-Bot-Builders/RoboCoreDocumentation/docs/progress/all_traces.png

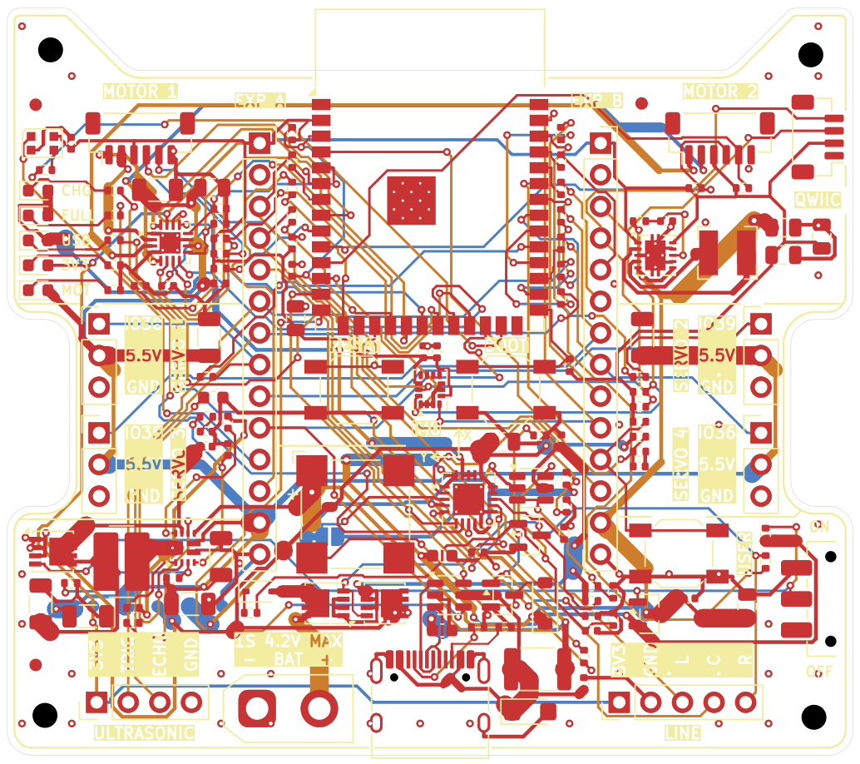
docs/progress/all_traces.png
