Plastal-Bot-Builders/RoboCoreDocumentation/docs/progress/layers_traces.png

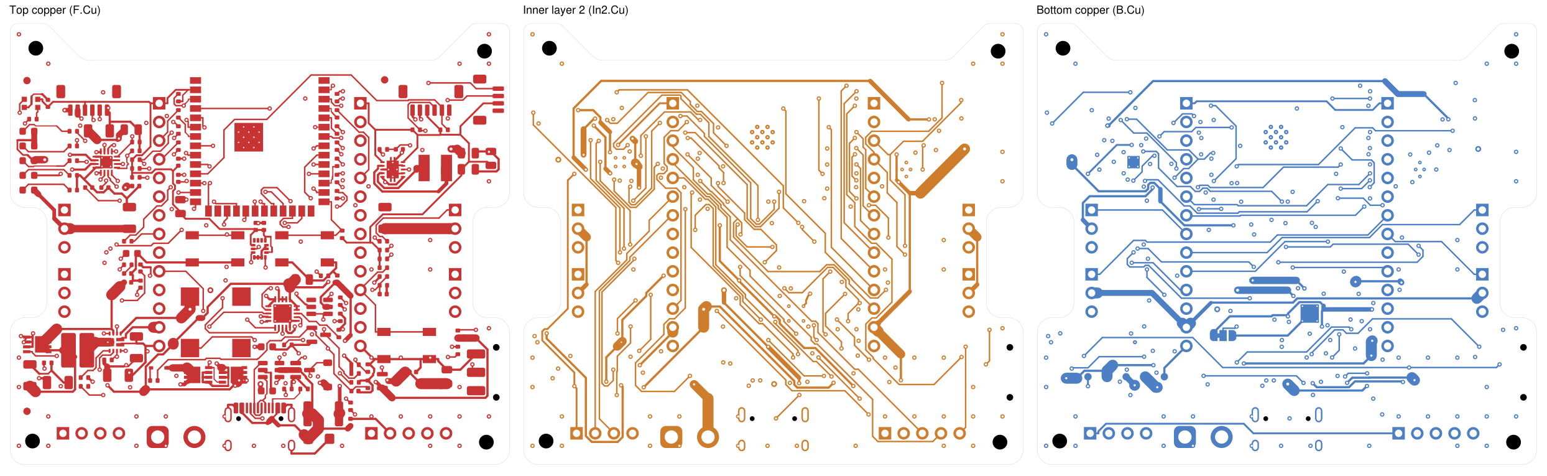
docs/progress/layers_traces.png
