Plastal-Bot-Builders/RoboCoreDocumentation/docs/progress/sensors/line_sensor_angle.png

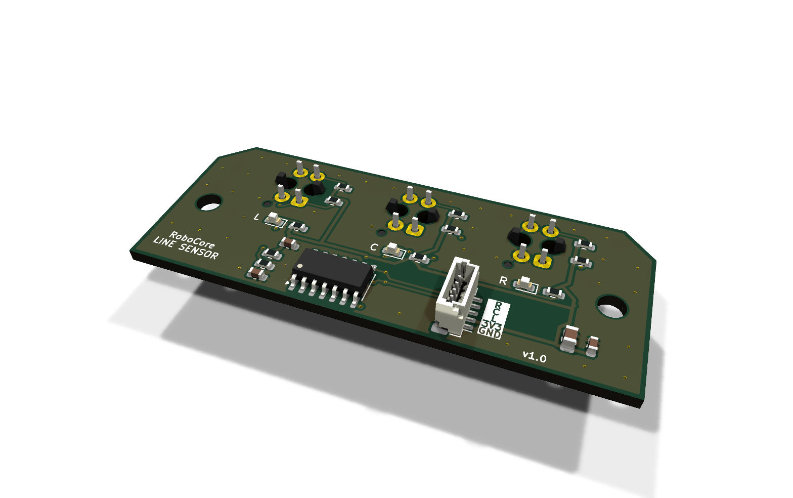
docs/progress/sensors/line_sensor_angle.png
