Plastal-Bot-Builders/RoboCoreDocumentation/docs/progress/sensors/line_sensor_bottom.png

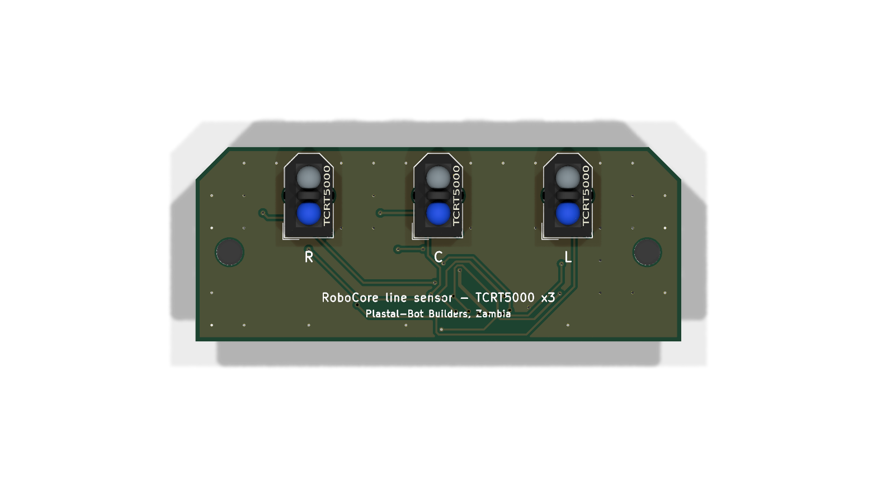
docs/progress/sensors/line_sensor_bottom.png
