Plastal-Bot-Builders/RoboCoreDocumentation/docs/progress/sensors/line_sensor_top.png

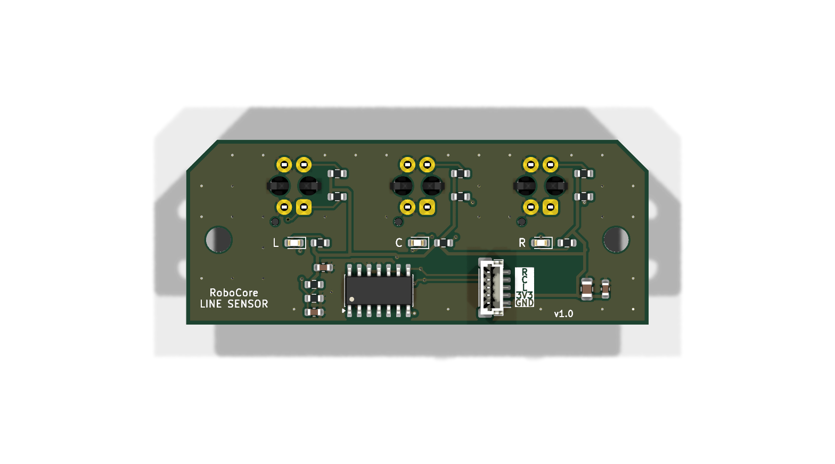
docs/progress/sensors/line_sensor_top.png
