Plastal-Bot-Builders/RoboCoreDocumentation/docs/progress/sensors/sensor_boards_overview.png

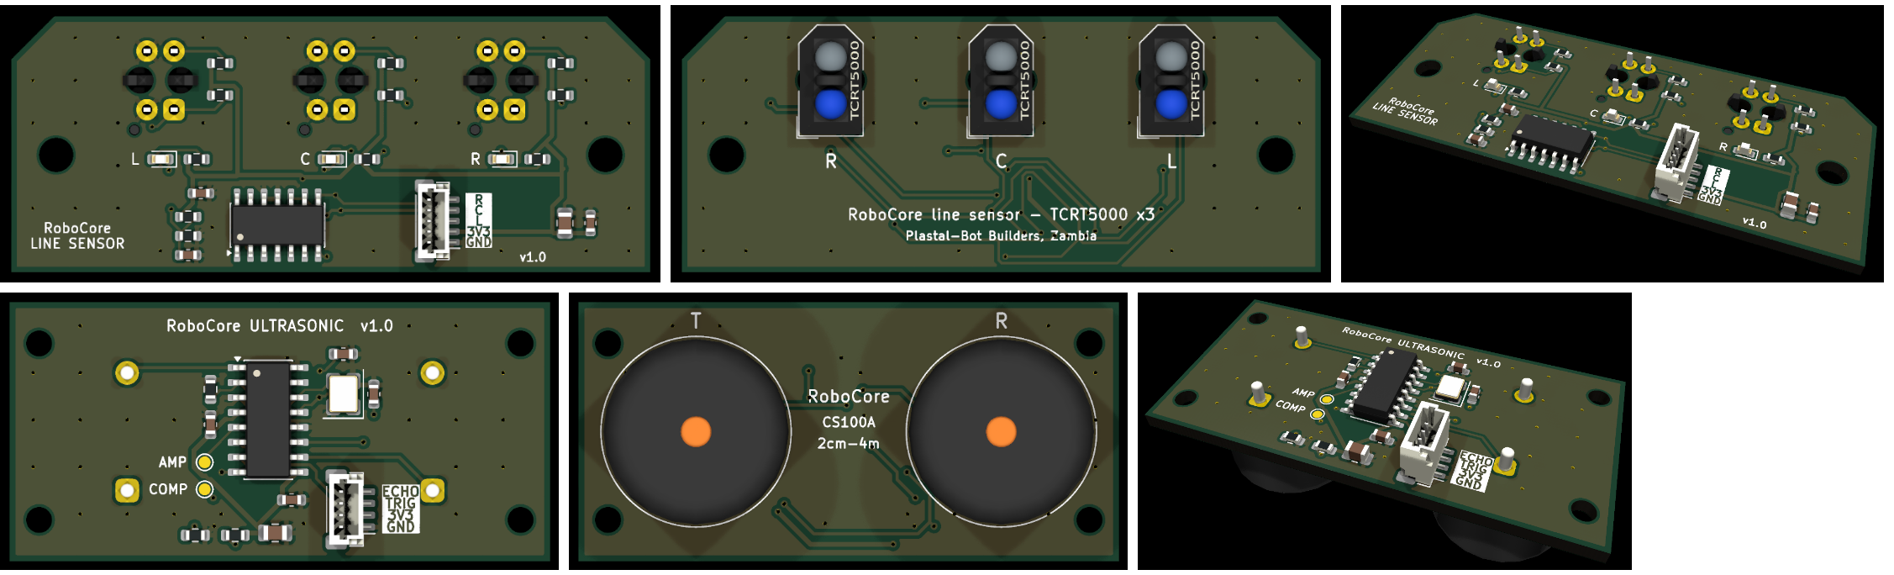
docs/progress/sensors/sensor_boards_overview.png
