Plastal-Bot-Builders/RoboCoreDocumentation/docs/progress/sensors/ultrasonic_angle.png

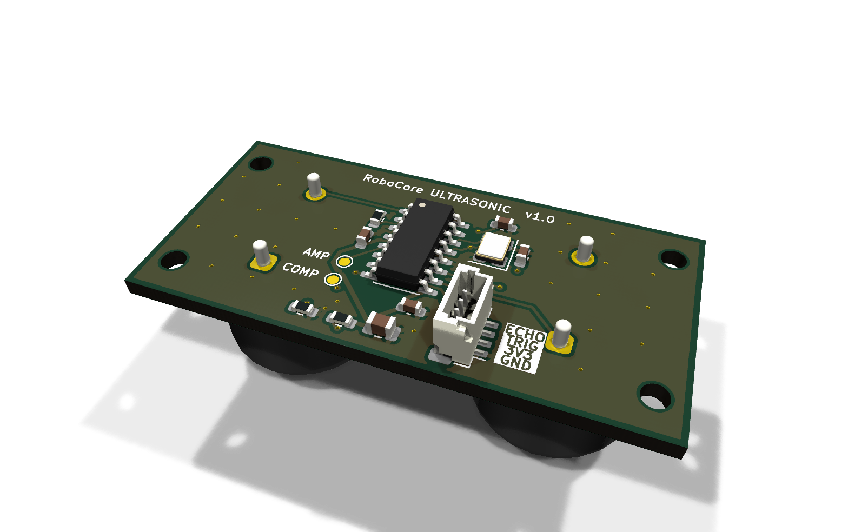
docs/progress/sensors/ultrasonic_angle.png
