Plastal-Bot-Builders/RoboCoreDocumentation/docs/progress/sensors/ultrasonic_bottom.png

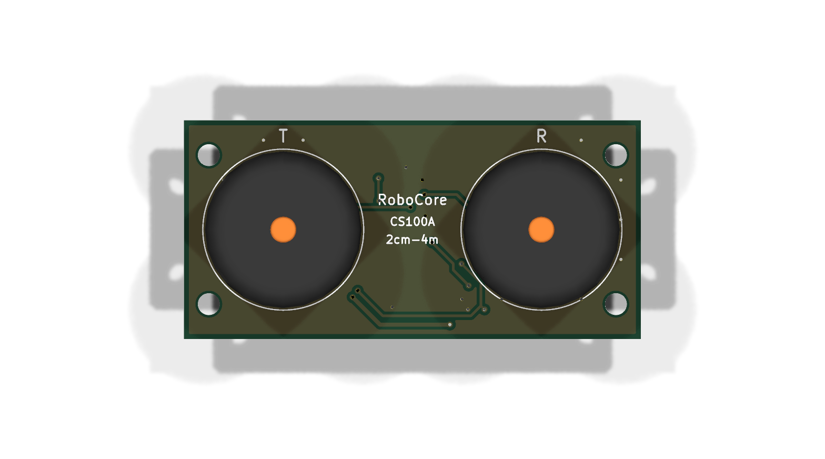
docs/progress/sensors/ultrasonic_bottom.png
