Plastal-Bot-Builders/RoboCoreDocumentation/docs/progress/sensors/ultrasonic_top.png

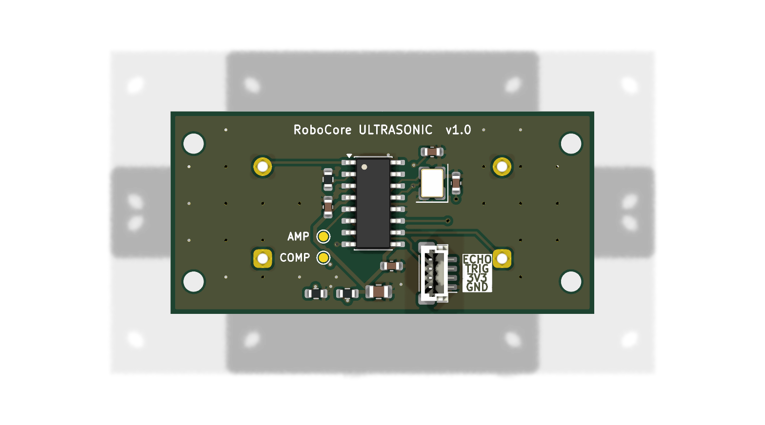
docs/progress/sensors/ultrasonic_top.png
