Plastal-Bot-Builders/RoboCoreDocumentation/docs/progress/v2_back_artwork.png

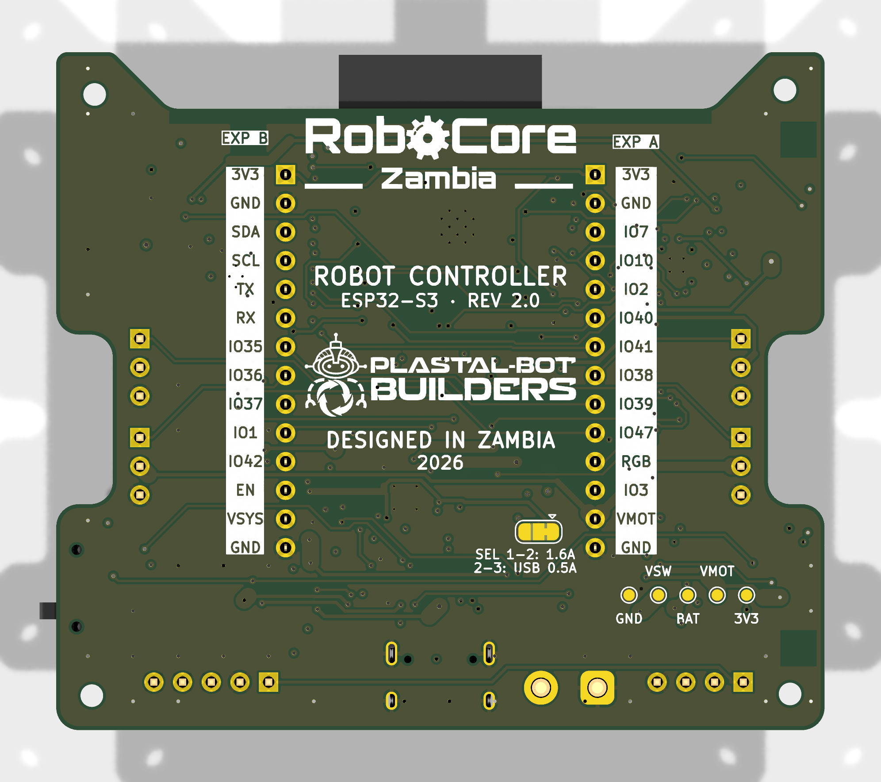
docs/progress/v2_back_artwork.png
