Plastal-Bot-Builders/RoboCoreDocumentation/docs/progress/v2_back_artwork_closeup.png

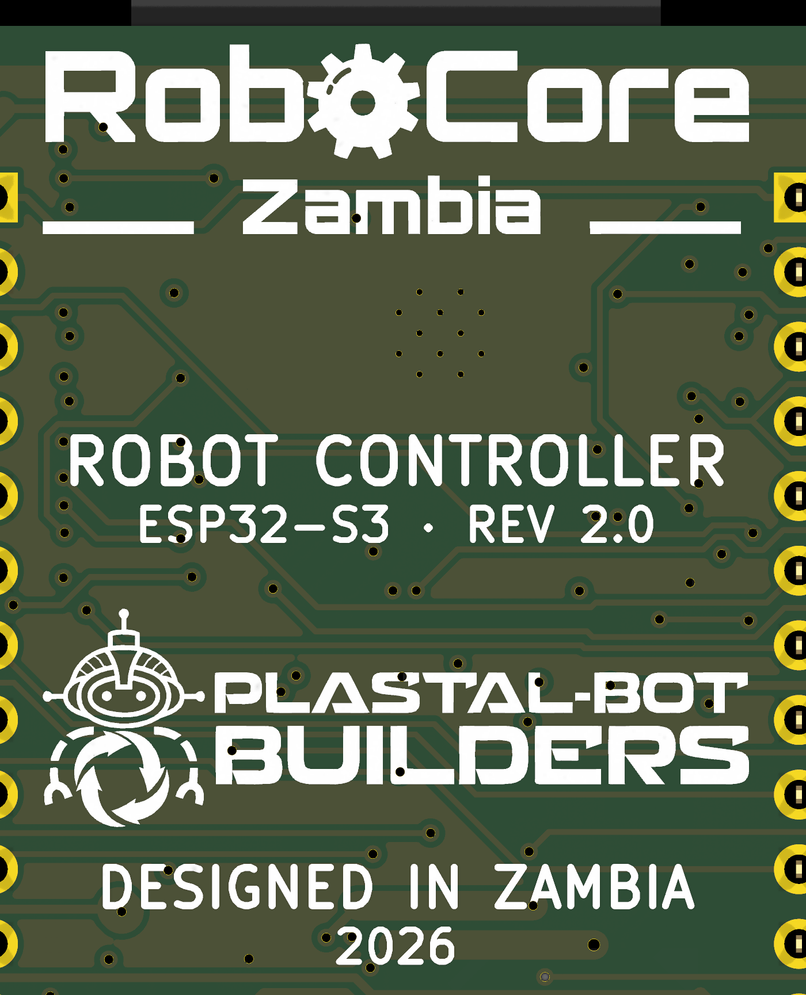
docs/progress/v2_back_artwork_closeup.png
