Plastal-Bot-Builders/RoboCoreDocumentation/docs/progress/v2_jst_sensor_sockets.png

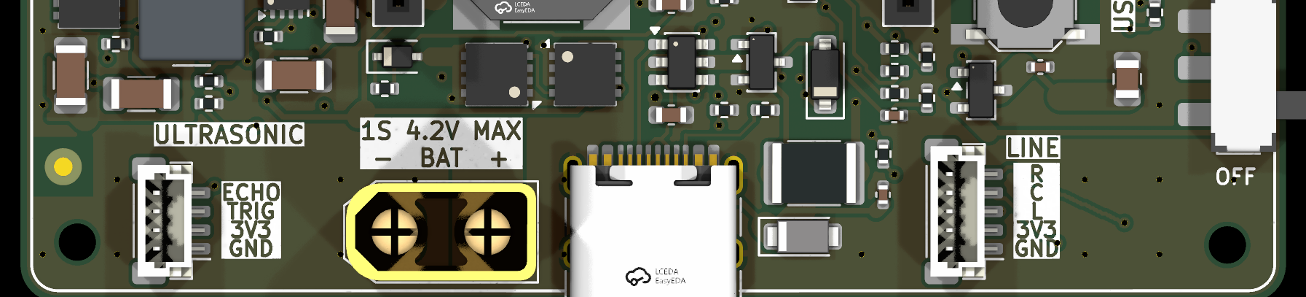
docs/progress/v2_jst_sensor_sockets.png
