Plastal-Bot-Builders/RoboCoreDocumentation/docs/progress/v2_place_angle.png

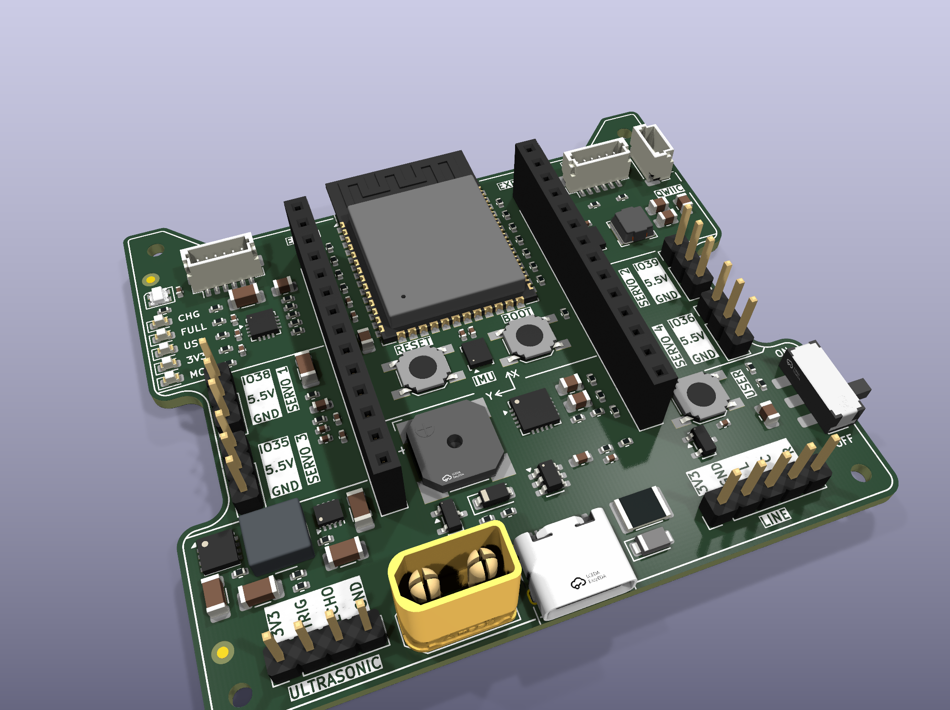
docs/progress/v2_place_angle.png
