Plastal-Bot-Builders/RoboCoreDocumentation/docs/progress/v2_place_bottom.png

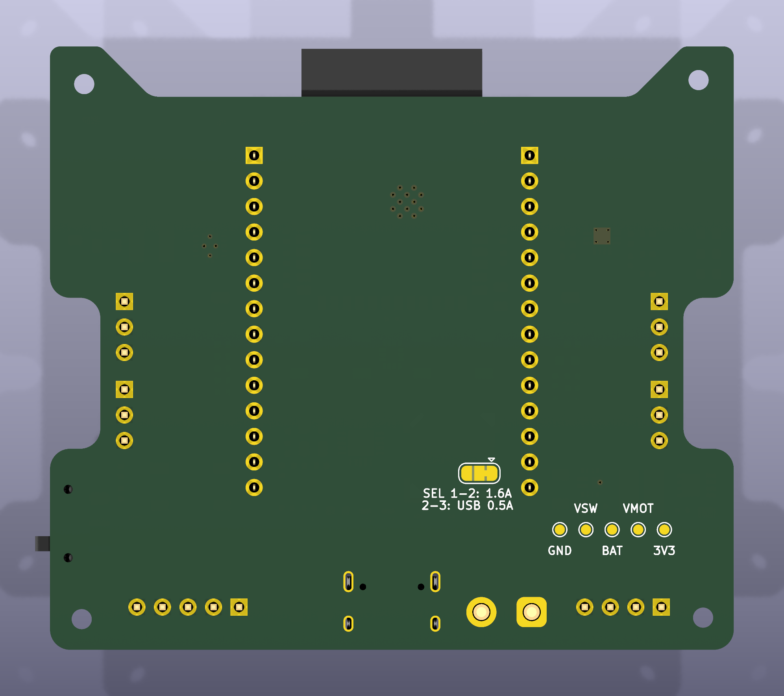
docs/progress/v2_place_bottom.png
