Plastal-Bot-Builders/RoboCoreDocumentation/docs/progress/v2_place_top.png

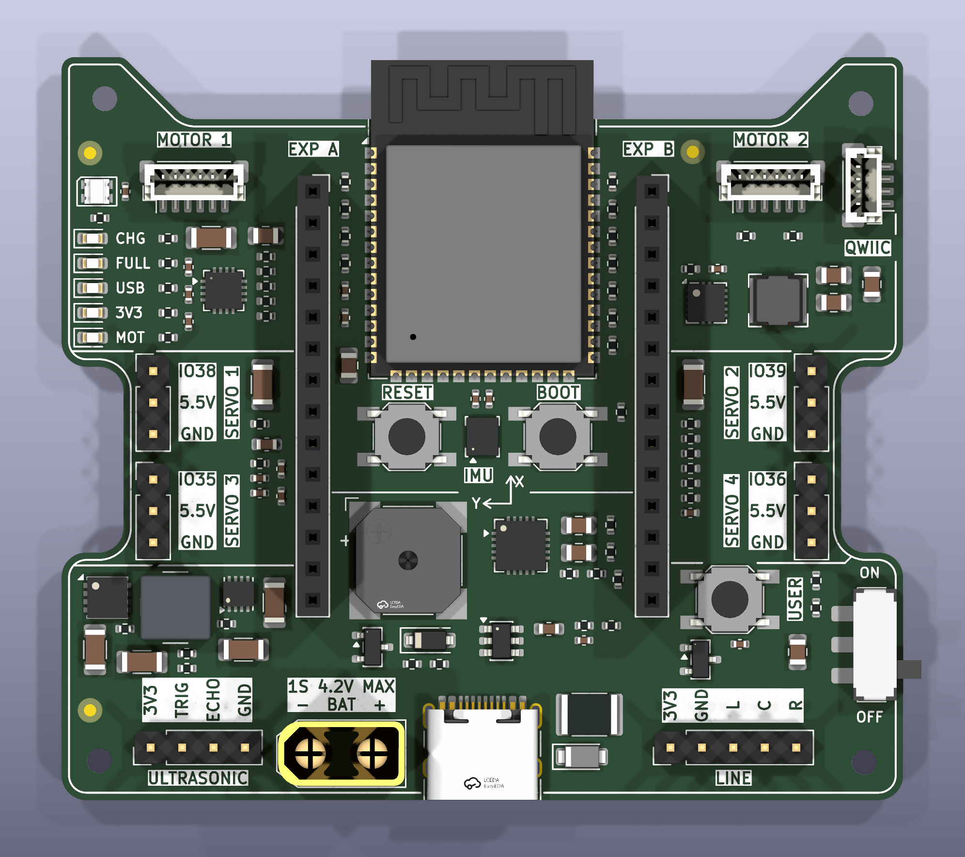
docs/progress/v2_place_top.png
