Plastal-Bot-Builders/RoboCoreDocumentation/docs/progress/v2_routed_bottom.png

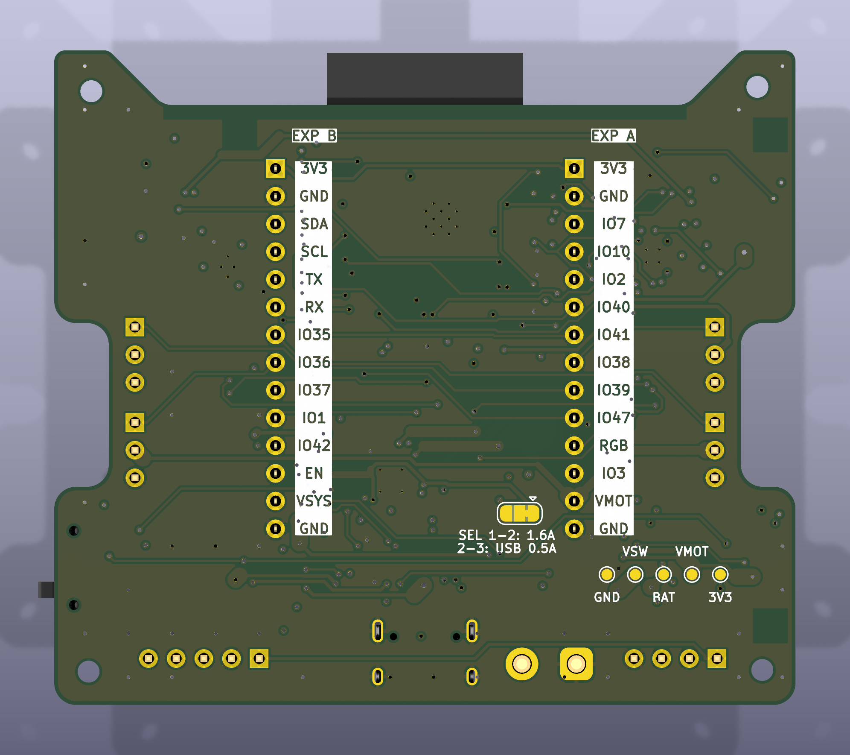
docs/progress/v2_routed_bottom.png
