Plastal-Bot-Builders/RoboCoreDocumentation/docs/progress/v2_routed_layers.png

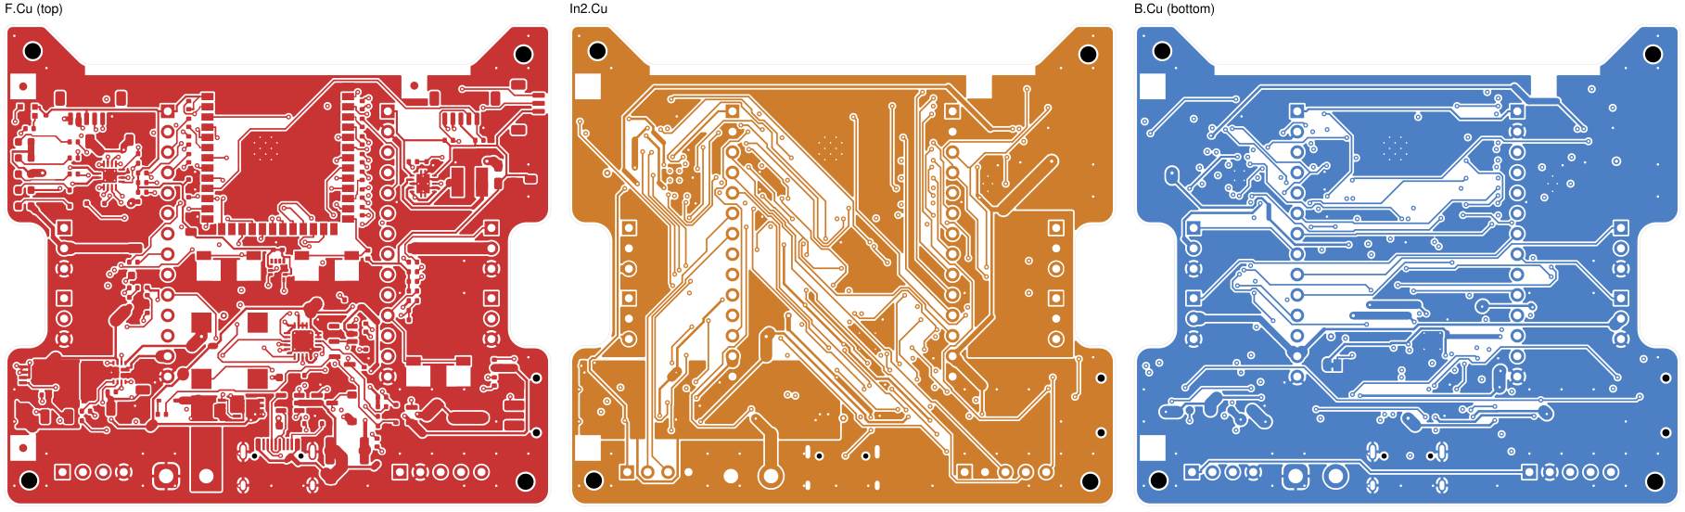
docs/progress/v2_routed_layers.png
