Plastal-Bot-Builders/RoboCoreDocumentation/docs/progress/v2_top_jst_sensors.png

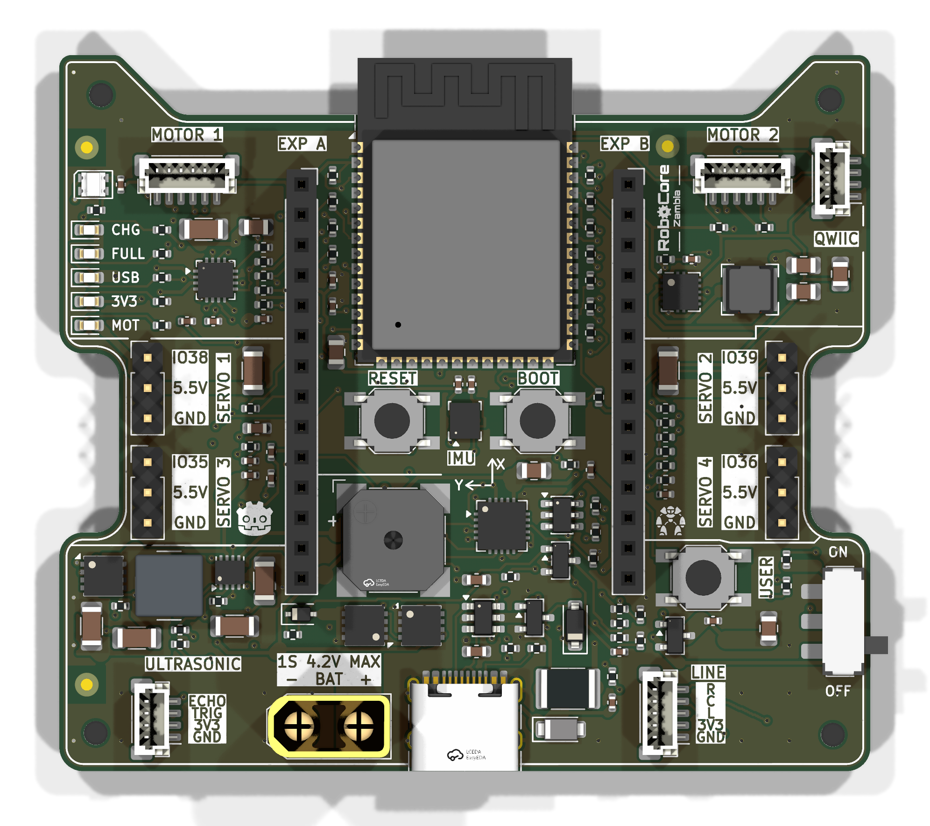
docs/progress/v2_top_jst_sensors.png
