Plastal-Bot-Builders/RoboCoreDocumentation/docs/sponsorship/PCBWay_sensor_boards/attachments/02_line_sensor_top.jpg

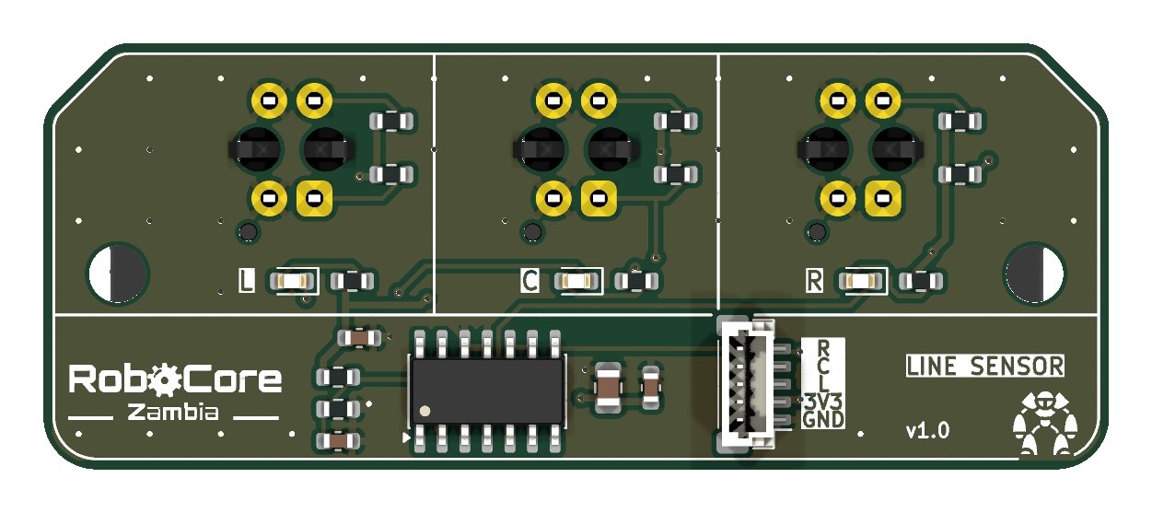
docs/sponsorship/PCBWay_sensor_boards/attachments/02_line_sensor_top.jpg
