Plastal-Bot-Builders/RoboCoreDocumentation/docs/sponsorship/PCBWay_sensor_boards/attachments/03_line_sensor_underside.jpg

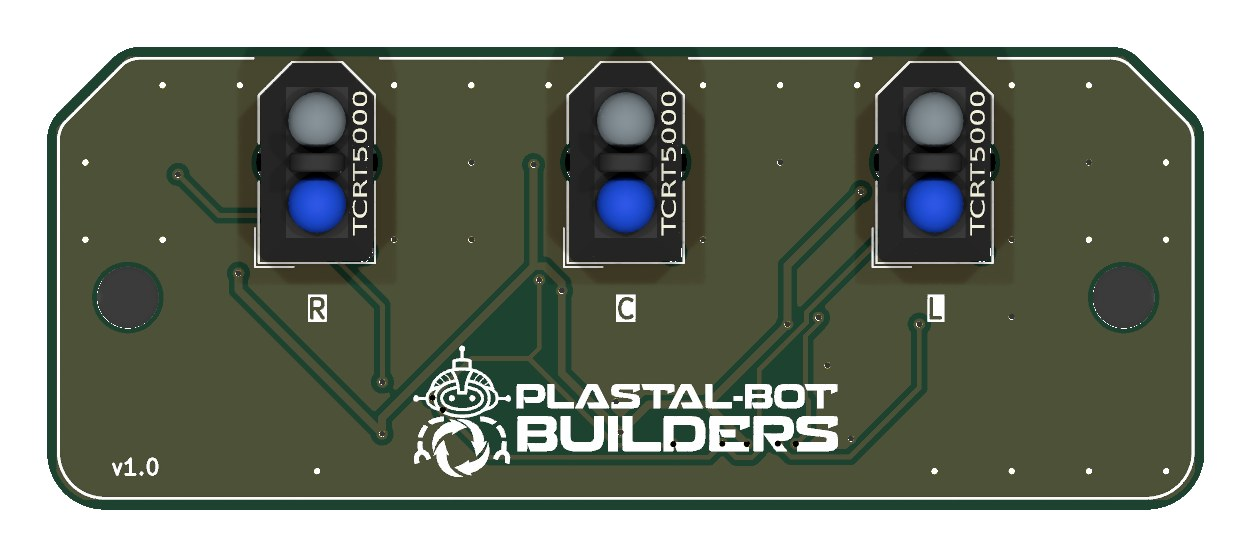
docs/sponsorship/PCBWay_sensor_boards/attachments/03_line_sensor_underside.jpg
