Plastal-Bot-Builders/RoboCoreDocumentation/docs/sponsorship/PCBWay_sensor_boards/attachments/04_ultrasonic_3D.jpg

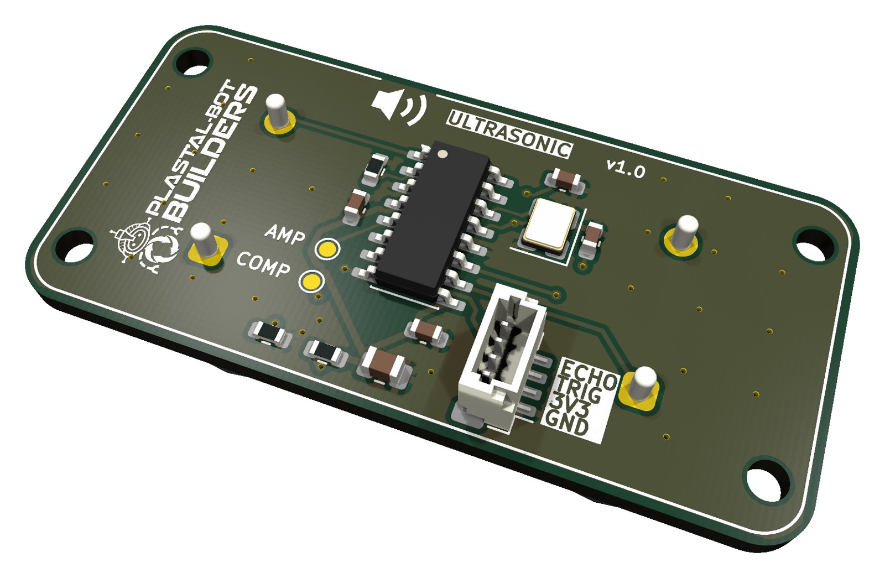
docs/sponsorship/PCBWay_sensor_boards/attachments/04_ultrasonic_3D.jpg
