Plastal-Bot-Builders/RoboCoreDocumentation/docs/sponsorship/PCBWay_sensor_boards/attachments/05_ultrasonic_rear.jpg

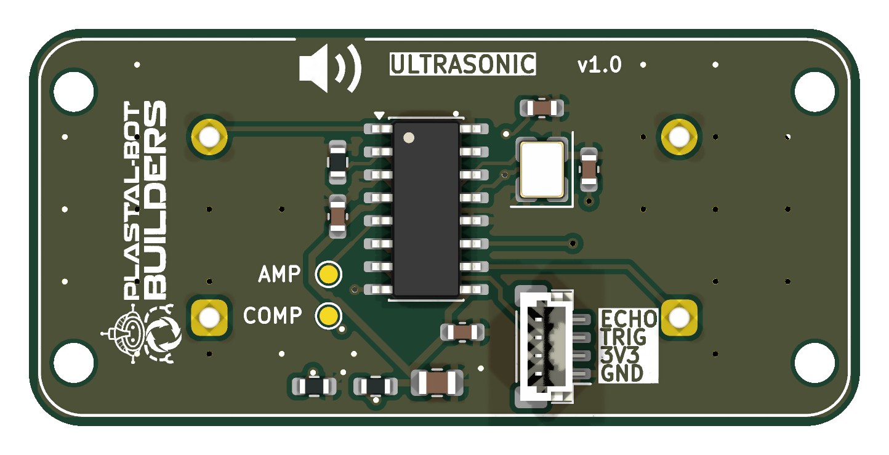
docs/sponsorship/PCBWay_sensor_boards/attachments/05_ultrasonic_rear.jpg
