Plastal-Bot-Builders/RoboCoreDocumentation/docs/sponsorship/PCBWay_sensor_boards/attachments/06_ultrasonic_front.jpg

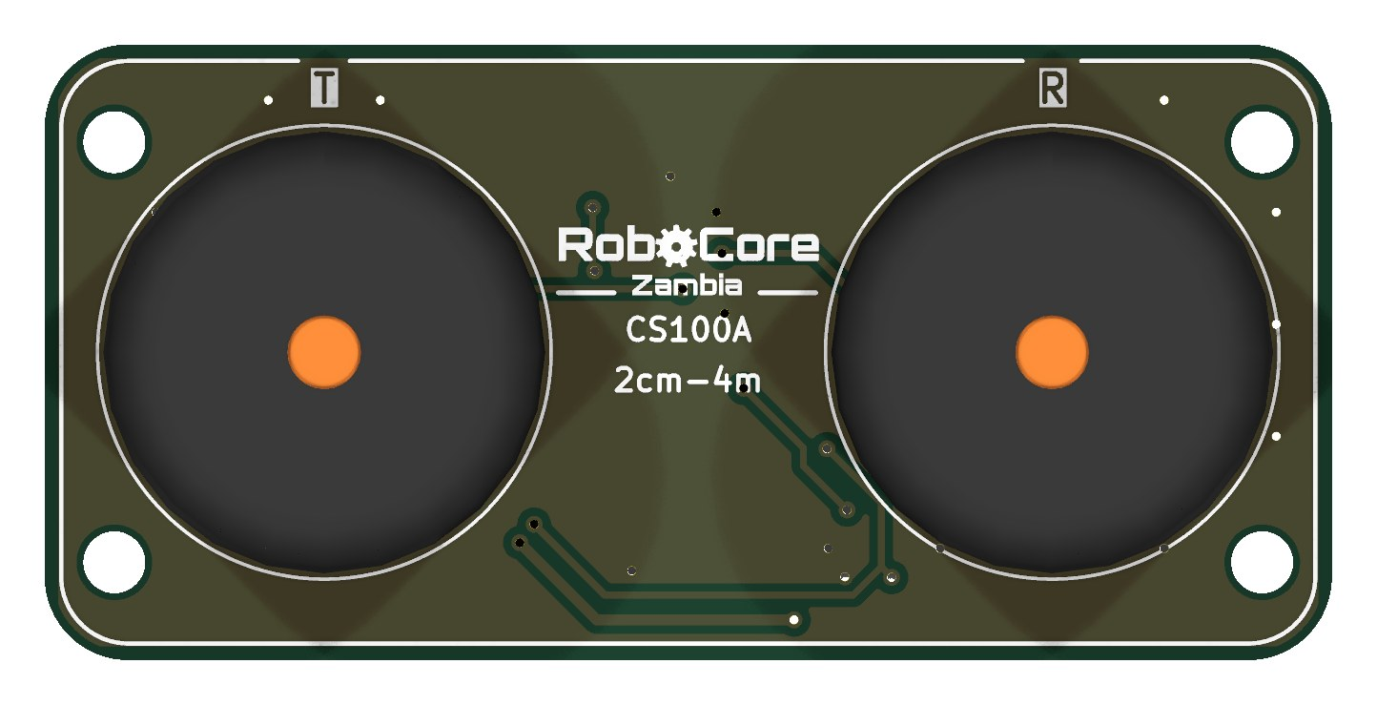
docs/sponsorship/PCBWay_sensor_boards/attachments/06_ultrasonic_front.jpg
