Plastal-Bot-Builders/RoboCoreDocumentation/docs/sponsorship/PCBWay_sensor_boards/attachments/08_RoboCore_robot.jpg

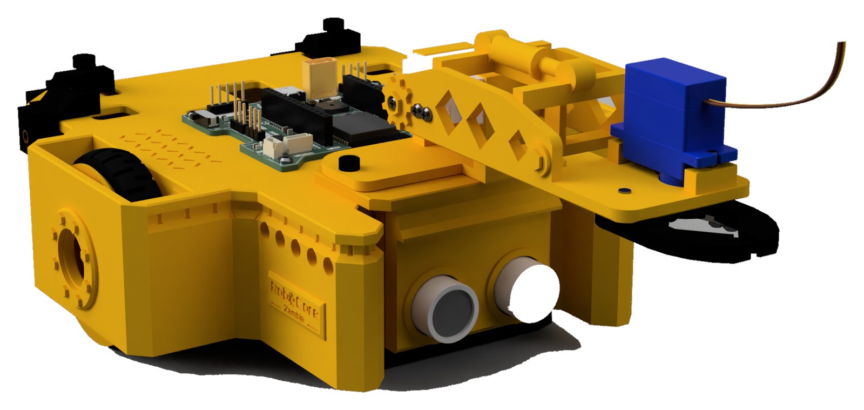
docs/sponsorship/PCBWay_sensor_boards/attachments/08_RoboCore_robot.jpg
