Plastal-Bot-Builders/RoboCoreDocumentation/hardware/controller_v2/fab/PCBWay_V2_2026-10-07/RoboCore_LineSensor/RoboCore_LineSensor_render_bottom.png

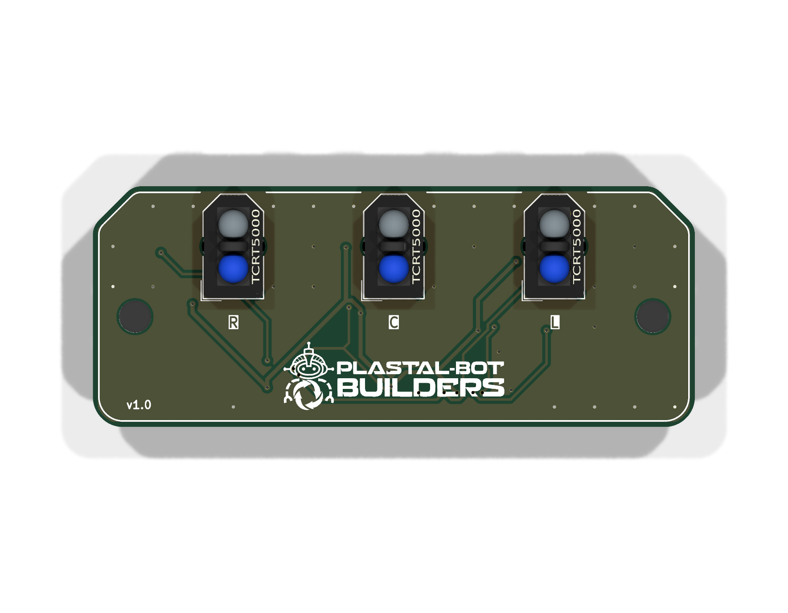
hardware/controller_v2/fab/PCBWay_V2_2026-10-07/RoboCore_LineSensor/RoboCore_LineSensor_render_bottom.png
