Plastal-Bot-Builders/RoboCoreDocumentation/hardware/controller_v2/fab/PCBWay_V2_2026-10-08/RoboCore_V2_Controller/RoboCore_V2_Controller_render_top.png

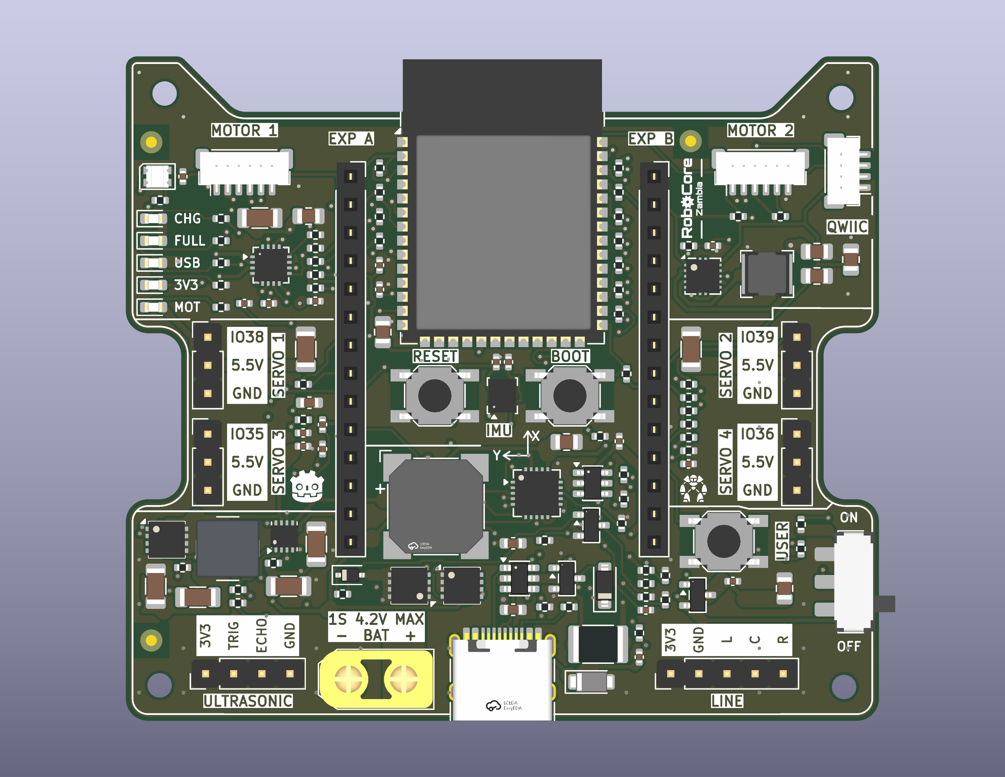
hardware/controller_v2/fab/PCBWay_V2_2026-10-08/RoboCore_V2_Controller/RoboCore_V2_Controller_render_top.png
