Plastal-Bot-Builders/RoboCoreDocumentation/hardware/controller_v2/renders/full/robocore-controller-hero-rear-white.jpg

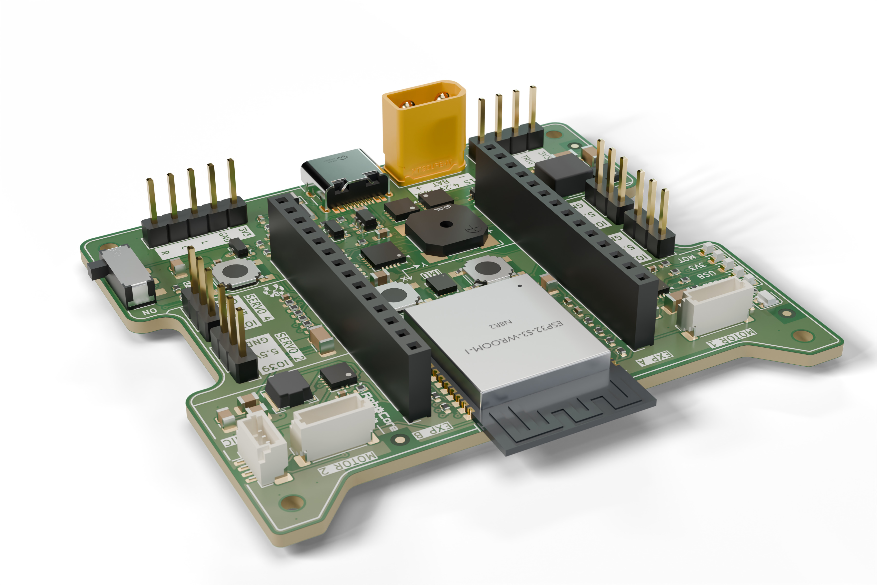
hardware/controller_v2/renders/full/robocore-controller-hero-rear-white.jpg
