Plastal-Bot-Builders/RoboCoreDocumentation/hardware/controller_v2/renders/robocore-controller-contact-sheet.jpg

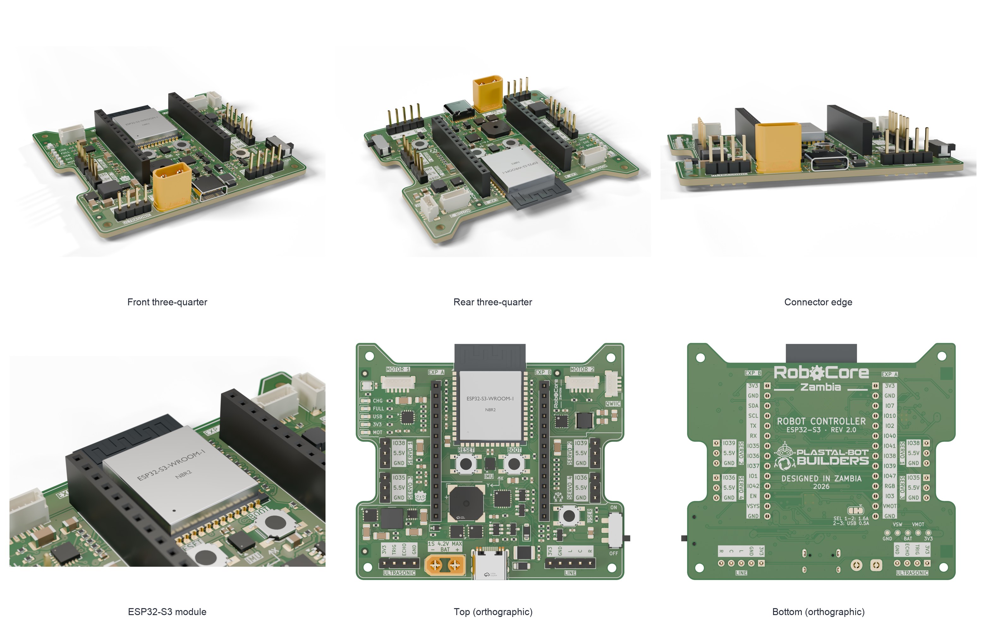
hardware/controller_v2/renders/robocore-controller-contact-sheet.jpg
