Plastal-Bot-Builders/RoboCoreDocumentation/mechanical/reference/MotorPictures/TypeOne/tt-geared-motor-with-encoder-6v-160rpm-120-1-l-shape-dfrobot-fit0458-40880227877059_120x.webp

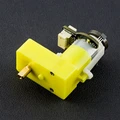
mechanical/reference/MotorPictures/TypeOne/tt-geared-motor-with-encoder-6v-160rpm-120-1-l-shape-dfrobot-fit0458-40880227877059_120x.webp
