Plastal-Bot-Builders/RoboCoreDocumentation/mechanical/reference/MotorPictures/TypeTwo/a1a8be76_9_grande.webp

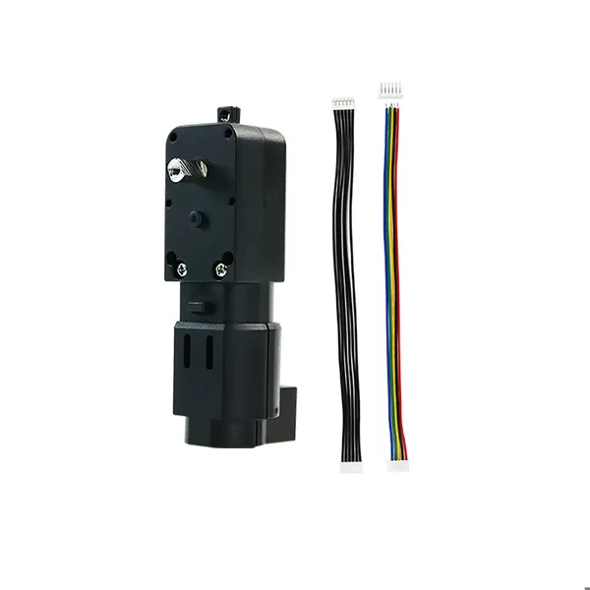
mechanical/reference/MotorPictures/TypeTwo/a1a8be76_9_grande.webp
