Plastal-Bot-Builders/RoboCoreDocumentation/mechanical/reference/MotorPictures/TypeTwo/Reduced_Motor_5.webp

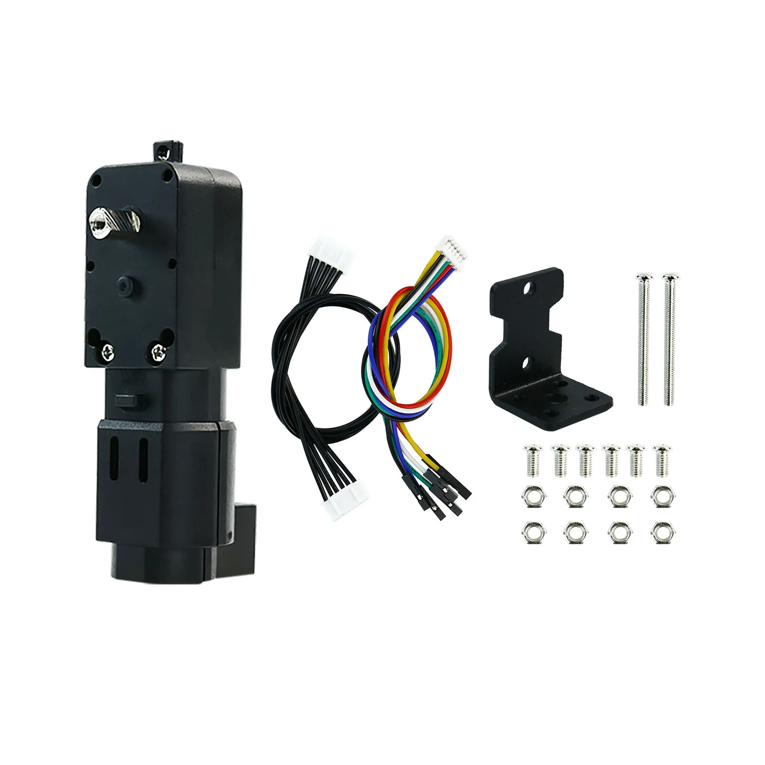
mechanical/reference/MotorPictures/TypeTwo/Reduced_Motor_5.webp
