Plastal-Bot-Builders/RoboCoreDocumentation/mechanical/reference/XPR-Robot_Pictures/images.jpeg

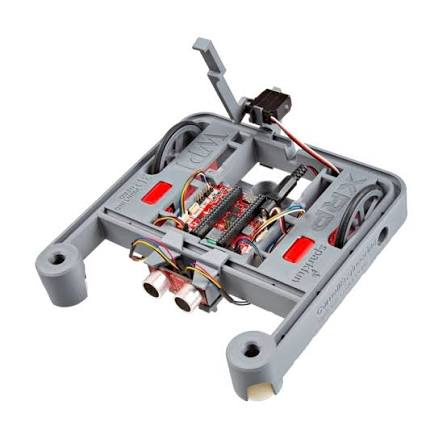
mechanical/reference/XPR-Robot_Pictures/images.jpeg
