Plastal-Bot-Builders/RoboCoreDocumentation/mechanical/reference/XPR-Robot_Pictures/XRP-1.png

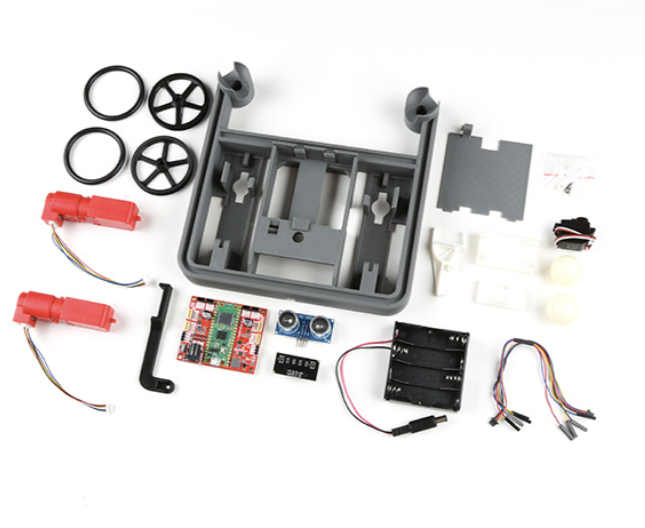
mechanical/reference/XPR-Robot_Pictures/XRP-1.png
