Plastal-Bot-Builders/RoboCoreDocumentation/mechanical/reference/XPR-Robot_Pictures/XRP_Robot-02.webp

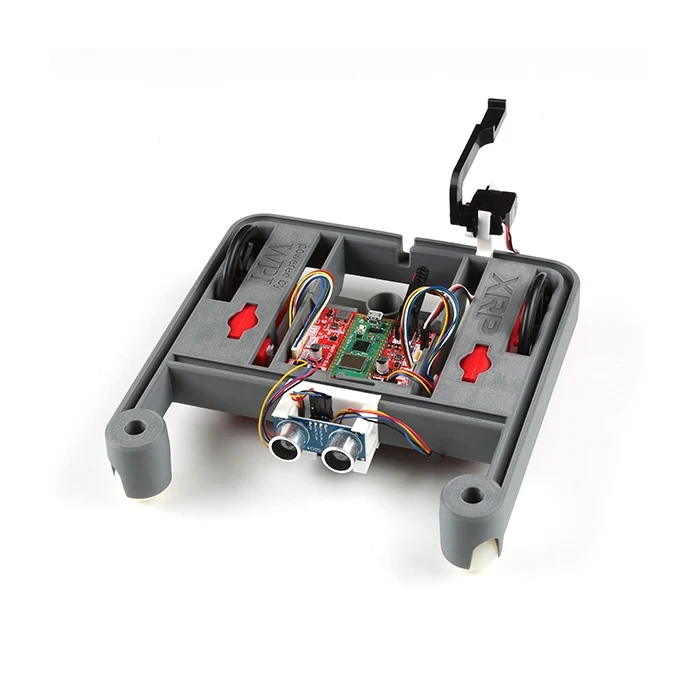
mechanical/reference/XPR-Robot_Pictures/XRP_Robot-02.webp
