Plastal-Bot-Builders/RoboCoreDocumentation/docs/RoboCore_V2_component_list.xlsx

Sheet: Component list
RoboCore V2 robot: component list
Everything needed to build the robots with the arm, as of 2026-10-12. Prices are estimates in USD. Blue text = input you can change; yellow = fill in when you buy; green = from the Printed parts sheet.
 | Robots to build |  | 2
 | Import VAT + duty allowance |  | 16%
# | Part | Photo | What to buy / search for | Per robot | Unit | For all robots | Extra (spares / one-off) | Total needed | Pack size | Packs to buy | Est. price per pack (USD) | Est. cost (USD) | Where to buy | Origin | Actual paid (USD) | Status | Check before buying / notes
Controller board (on order at PCBWay)
1 | RoboCore V2 controller, assembled |  | PCBWay PCB W836287AS1F11 + assembly T-1F12W836287A: 2 assembled boards (+3 bare PCBs) | 1 | pcs |  | 0 |  | 2 |  | $294.71 |  | PCBWay (quoted) | Import |  | Quoted | Quoted, not paid (awaiting audit): $57.43 PCB + $88 assembly + $144.40 parts + $34.88 FedEx − $30 coupon. Price is for the whole order of 2.
Motors, sensors and servos
2 | Motor pair with encoders (XRP motor) |  | SparkFun ROB-24053: 2 motors, 1:48 gearbox, 585 counts per wheel turn, two 6-pin cables included | 1 | pair |  | 0 |  | 1 |  | $28.50 |  | SparkFun (or a regional XRP reseller) | Import |  | To buy | The chassis motor pockets and encoder cover are built around this motor; a generic TT encoder motor won't fit. SparkFun showed 'Backorder' on 2026-10-11: check stock first. Wheels are printed.
3 | Ultrasonic sensor, 3.3 V type |  | Search: 'HC-SR04P' (3–5.5 V) or 'RCWL-1601'. 45 × 20 mm, Ø16 mm cans 26 mm apart | 1 | pcs |  | 1 |  | 1 |  | $1.50 |  | AliExpress | Import |  | To buy | J403 supplies 3.3 V; the classic 5 V HC-SR04 is unreliable at 3.3 V. The pod is sized for the 45 × 20 mm board.
4 | Line sensor, 3-channel |  | Search: '3 channel TCRT5000 line tracking module analog'. Pins VCC GND L C R, about 60 × 24 mm | 1 | pcs |  | 1 |  | 1 |  | $2.50 |  | AliExpress | Import |  | To buy | Must have ANALOG outputs (J404 is wired for analog); many modules are digital-only (LM339). The sled is sized for 60 × 24 mm: buy one first and check it fits. Dupont wires, so any pin order works.
5 | Micro servo, metal gear (MG90S) |  | MG90S, with horns and screws: one for the shoulder, one for the gripper | 2 | pcs |  | 2 |  | 1 |  | $3.50 |  | AliExpress | Import |  | To buy | Both arm joints use the same servo (one part type to stock; metal gears survive a stalled gripper). SERVO 1 = shoulder, SERVO 2 = gripper. Clone quality varies: buy from a well-reviewed store and test on arrival. Each servo's bag has its horns and the tab screws that hold it in the arm.
Battery and power
6 | 18650 Li-ion cell |  | Branded (Samsung, LG, Molicel, EVE…), about 3000 mAh, 65 mm long, all the same type | 3 | pcs |  | 0 |  | 1 |  | $3.50 |  | Local / South Africa | Local |  | To buy | Don't ship from China: couriers refuse loose cells and fakes are common. Match the cells (same type, same voltage) before fitting. Protected cells are ~70 mm long and may not fit the holder.
7 | 3 × 18650 battery holder, parallel |  | 61.6 × 78.4 mm, like the BatteryHolder3S in the model | 1 | pcs |  | 0 |  | 1 |  | $2.00 |  | AliExpress | Import |  | To buy | Wire it 1S3P (all cells in parallel). A holder sold as '3S' is wired in series and must be rewired: the board takes 4.2 V maximum. The chassis V-rails are sized for 61.6 × 78.4 mm.
8 | XT30 battery lead, female |  | AMASS XT30U-F with 10–15 cm of 16 AWG silicone wire | 1 | pcs |  | 1 |  | 5 |  | $4.00 |  | AliExpress (AMASS store) | Import |  | To buy | The board has the male XT30 (XT30UPB-M), so the battery side needs the female plug. Solder it straight to the holder's leads and insulate the joints (heat-shrink or tape you already have).
Cables
9 | Dupont jumper wires, female-female, 20 cm |  | 4 for the ultrasonic (J403) + 5 for the line sensor (J404) | 9 | pcs |  | 0 |  | 40 |  | $2.00 |  | AliExpress | Import |  | To buy | Usually sold as a 40-wire strip.
10 | USB charger, 5 V 2 A (optional) |  | Any phone charger with a USB-C or USB-A port | 0 | pcs |  | 0 |  | 1 |  | $4.00 |  | Local | Local |  | To buy | Set 'Per robot' to 1 if the users don't have one. The board draws up to 1.65 A from USB.
Screws, inserts and small hardware (with the arm and one bus clip)
11 | M2 heat-set insert |  | For Ø3.2 mm holes (e.g. M2 × 3 × 3.2 OD) | 4 | pcs |  | 4 |  | 100 |  | $2.00 |  | AliExpress | Import |  | To buy | 4: melted into the 4 bosses under the controller's corner holes; the board screws into them.
12 | M3 heat-set insert, short |  | For Ø4.0 mm holes (e.g. M3 × 4 × 4.0 OD) | 6 | pcs |  | 4 |  | 100 |  | $2.50 |  | AliExpress | Import |  | To buy | 6: 2 in the dock tower tops (arm base + sonar bracket), 1 in each ballast clip (2), 1 in the bus clip's tab, 1 in the bus clip's accessory boss.
13 | M2 × 6 pan head machine screw |  | Into the M2 inserts | 4 | pcs |  | 4 |  | 50 |  | $1.50 |  | AliExpress | Import |  | To buy | 4: controller onto the deck, into the M2 inserts. Tip: one M2/M3 screw assortment kit covers most of this section.
14 | M2 × 6 pan head self-tapping screw |  | Wheel onto the motor shaft | 2 | pcs |  | 2 |  | 50 |  | $1.50 |  | AliExpress | Import |  | To buy | 2: one per wheel, into the motor shaft's centre hole, with a washer under the head.
15 | M2 flat washer |  |  | 2 | pcs |  | 2 |  | 100 |  | $1.00 |  | AliExpress | Import |  | To buy | 2: one under each wheel screw.
16 | M2 × 8 pan head screw |  |  | 1 | pcs |  | 1 |  | 50 |  | $1.50 |  | AliExpress | Import |  | To buy | 1: shoulder servo horn centre screw, through the boom plate (the servo's own screw is too short).
17 | M2 × 5 pan head screw |  |  | 2 | pcs |  | 2 |  | 50 |  | $1.50 |  | AliExpress | Import |  | To buy | 2: shoulder horn arm to the right boom plate.
18 | M2 × 4 pan head screw |  |  | 3 | pcs |  | 2 |  | 50 |  | $1.50 |  | AliExpress | Import |  | To buy | 3: gripper horn: centre screw into the servo + 2 through the horn arm into the driven jaw.
19 | M3 × 10 socket head screw |  |  | 2 | pcs |  | 2 |  | 50 |  | $1.50 |  | AliExpress | Import |  | To buy | 2: through the arm base and sonar bracket into the dock-tower inserts (M3 × 8 if you build without the arm).
20 | M3 × 8 pan head self-tapping screw |  |  | 1 | pcs |  | 1 |  | 50 |  | $1.50 |  | AliExpress | Import |  | To buy | 1: pivot of the idle (right) jaw; self-taps into the arm.
21 | M3 × 8 thumb screw (knurled head) |  |  | 3 | pcs |  | 1 |  | 20 |  | $3.00 |  | AliExpress | Import |  | To buy | 3: one each on the bus clip and the 2 ballast clips; it presses on the deck and locks the clip.
22 | M8 hex nut |  | Plain steel, about 5 g each | 6 | pcs |  | 0 |  | 1 |  | $0.10 |  | Local hardware shop | Local |  | To buy | 6: 3 in each ballast clip on the rear wall. Needed when the arm is fitted.
23 | ½" (12.7 mm) steel ball |  | Bearing balls or slingshot ammo; 12.7 mm glass marbles also work | 2 | pcs |  | 2 |  | 20 |  | $3.00 |  | AliExpress / local bearing shop | Import |  | To buy | 2: rear casters, press-fit.
3D printing filament (grams, from the Printed parts sheet)
24 | PETG filament, yellow |  | 1 kg spool |  | g |  |  |  | 1000 |  | $20.00 |  | Local / Bambu store | Local |  | To buy | Chassis, sonar pod, arm and arm base.
25 | PETG filament, black |  | 1 kg spool |  | g |  |  |  | 1000 |  | $20.00 |  | Local / Bambu store | Local |  | To buy | Line sled, jaws, clips, test pieces. Mark 'Have already' if you have black.
26 | PETG filament, dark teal |  | 1 kg spool |  | g |  |  |  | 1000 |  | $20.00 |  | Local / Bambu store | Local |  | To buy | Wheels only. Print them black instead to skip this spool.
27 | TPU 95A filament, black |  | 250–1000 g spool |  | g |  |  |  | 1000 |  | $25.00 |  | Local / Bambu store | Local |  | To buy | Tyres only; about 25 g needed, so a small spool is enough.
Packaging (optional)
28 | Mailer box + printed quick-start guide |  | Design in mech/robot/packaging (273 × 203 × 83 mm outer) | 1 | pcs |  | 0 |  | 1 |  | $2.00 |  | Local print shop | Local |  | To buy | Estimate from the costing model.
Shipping (estimates; replace with the checkout price)
29 | Shipping: SparkFun order (motors) | — | Courier to Zambia | 0 | order |  | 1 |  | 1 |  | $50.00 |  | SparkFun | Import |  | To buy | Estimate. The courier may also bill VAT/duty on delivery (covered by the allowance below).
30 | Shipping: AliExpress orders | — | All AliExpress parts | 0 | order |  | 1 |  | 1 |  | $10.00 |  | AliExpress | Import |  | To buy | Estimate. Many stores ship free above a minimum order.
Tools (one-off; skip what you have)
31 | Heat-set insert tips for the soldering iron |  | M2 and M3 tips to fit your iron | 0 | set |  | 1 |  | 1 |  | $5.00 |  | AliExpress | Import |  | Have already | Set to 'To buy' if your iron has none. Also used: soldering iron, multimeter (to match the cells).
 | Summary
 | Estimated cost, all lines |  |  |  |  |  |  |  |  |  |  |  | Everything above at the estimated prices.
 | of which: controller boards (PCBWay) |  |  |  |  |  |  |  |  |  |  |  | Already quoted.
 | of which: everything else |  |  |  |  |  |  |  |  |  |  |  | What this list still has to buy.
 | Import VAT + duty allowance |  |  |  |  |  |  |  |  |  |  |  | Allowance rate (C5) × lines marked Import.
 | Estimated total, landed
 | Per robot |  |  |  |  |  |  |  |  |  |  |  | Before labour (about 1.5 h per robot to assemble and test).
 | Actually paid so far |  |  |  |  |  |  |  |  |  |  |  | From the yellow 'Actual paid' column.
 | Lines still 'To buy'
 | Cost by section (estimate)
 | Controller board (on order at PCBWay)
 | Motors, sensors and servos
 | Battery and power
 | Cables
 | Screws, inserts and small hardware (with the arm and one bus clip)
 | 3D printing filament (grams, from the Printed parts sheet)
 | Packaging (optional)
 | Shipping (estimates; replace with the checkout price)
 | Tools (one-off; skip what you have)

Sheet: Printed parts
RoboCore V2: 3D-printed parts and filament
Masses from the shell/infill model in fusion/checks.py (mech/robot/README.md, rev 5). Files: mech/robot/print/, already in print orientation.
Robots to build
Waste allowance (brim, purge, failed prints) |  | 15%
Part | Print file | Per robot | One-off (test pieces) | Material | Colour | Mass each (g) | Per robot (g) | One-off (g) | All robots (g) | Notes
Chassis | RoboCore_V2_Chassis.3mf | 1 | 0 | PETG | Yellow | 133.0 |  |  |  | Deck (top) down. About 9–11 h on an A1 mini. Brim 5 mm if the corners lift
Line sled | RoboCore_V2_Line_sled_10.5.3mf | 1 | 0 | PETG | Black | 3.6 |  |  |  | 9.5 / 11.5 mm versions to taste. Sized for a 60 × 24 mm sensor board
Wheel | RoboCore_V2_Wheel.3mf | 2 | 0 | PETG | Dark teal | 7.9 |  |  |  | 30 % infill. Can be printed black to skip buying a teal spool
Tyre | RoboCore_V2_Tyre_TPU.3mf | 2 | 0 | TPU 95A | Black | 4.6 |  |  |  | Print slowly (25 mm/s or less)
Sonar bracket (pod) | RoboCore_V2_Sonar_bracket.3mf | 1 | 0 | PETG | Yellow | 9.0 |  |  |  | Plate top face down, pod up
Arm base | RoboCore_V2_Arm_base.3mf | 1 | 0 | PETG | Yellow | 7.9 |  |  |  | Arm module
Arm | RoboCore_V2_Arm.3mf | 1 | 0 | PETG | Yellow | 11.1 |  |  |  | Arm module, 30 % infill
Jaw L (driven) | RoboCore_V2_Jaw_L_driven.3mf | 1 | 0 | PETG | Black | 1.1 |  |  |  | 40 % infill
Jaw R (idle) | RoboCore_V2_Jaw_R_idle.3mf | 1 | 0 | PETG | Black | 1.3 |  |  |  | 40 % infill
Ballast clip | RoboCore_V2_Ballast_clip.3mf | 2 | 0 | PETG | Black | 3.8 |  |  |  | Needed with the arm (3 × M8 nuts each)
Bus clip | RoboCore_V2_Bus_clip.3mf | 1 | 1 | PETG | Black | 1.7 |  |  |  | Accessory clip; one extra printed first to test tolerances
Rail coupon (test piece) | RoboCore_V2_Rail_coupon.3mf | 0 | 1 | PETG | Black | 3.3 |  |  |  | Print once, first, to check your printer's tolerances
Total per robot (g)
Filament to buy (includes the waste allowance)
Material | Colour | Per robot (g) | One-off (g) | All robots (g)
PETG | Yellow
PETG | Black
PETG | Dark teal
TPU 95A | Black
Print time: about 13 printer-hours per robot on an A1 mini (chassis 9–11 h). Estimate; slice to confirm.
Settings: 0.2 mm layers, 3 walls, 25 % gyroid (wheels and arm 30 %, jaws and clips 40 %), no supports, PETG 240–250 °C.

Sheet: Notes
RoboCore V2 component list: notes
How to use it
Change 'Robots to build' (Component list, D4) and every quantity and total updates. The filament grams follow the Printed parts sheet.
Blue text = inputs you can change (quantities, spares, pack sizes, estimated prices, origin, status).
Lines marked 'Have already' count as $0 in the estimate (e.g. a filament colour you already have).
Yellow cells = fill in the real price when you pay ('Actual paid', the total for that line). The summary adds them up.
Green text = linked from the Printed parts sheet. Black = formulas; don't type over them.
Status drop-down: To buy / Quoted / Ordered / Received / Have already. Use the filter arrows on the header row to see what is left.
Check before buying
1. Motors: the chassis is built around the SparkFun XRP motor (ROB-24053). Generic TT encoder motors have a different encoder cover, plug (PH2.0) and pin order.
2. Ultrasonic: J403 gives 3.3 V, so buy a 3.3 V-capable module (HC-SR04P or RCWL-1601), not the classic 5 V HC-SR04.
3. Line sensor: needs analog outputs, and the printed sled is sized for a 60 × 24 mm board. Buy one first and check it.
4. Battery: holder wired in parallel (1S3P), never in series. No protection board (Fred, 2026-10-12). The controller guards against a reversed pack, a 2S/3S pack and over-charging, but has no low-battery cut-off: switch robots off after use.
5. 18650 cells: buy locally or from South Africa, branded and matched. Don't ship loose lithium cells from China.
Not included
Labour (about 1.5 h per robot), printer time (about 13 h per robot), tools you already have, and any duty above the allowance in D5.
Sources
Robot BOM, hardware table and printed-part masses: mech/robot/README.md (rev 5).
PCBWay quote: fab/PCBWay_V2_2026-10-08/ORDER_NOTES.md and the cart (W836287AS1F11 / T-1F12W836287A, 2026-10-09).
Motor price and contents: https://www.sparkfun.com/hobby-motor-with-encoder-plastic-gear-pair-red.html (checked 2026-10-11: $28.50, 'Backorder' shown).
Other prices: estimates from tools/costing/cost_model.py (2026-10-07) and typical AliExpress prices. Replace them with real quotes.
Connector facts (J403 3.3 V, J404 analog, XT30 male on the board): docs/RoboCore_V2_spec.md.
2026-10-12: both arm servos are MG90S (one line). Removed at Fred's request: SG90, 1S protection board, heat-shrink, USB-C cable. Fasteners follow the rev 5 robot design; the notes column says where each one goes.
