Plastal-Bot-Builders/RoboCoreDocumentation/hardware/sensors/line_sensor/RoboCore_LineSensor_BOM.csv

Refs | Value | Footprint | Manufacturer | MPN | LCSC | Alternative | Qty
C1 | 10uF | Capacitor_SMD:C_0805_2012Metric |  |  |  |  | 1
C2-C4 | 0.1uF | Capacitor_SMD:C_0603_1608Metric |  |  |  |  | 3
D1-D3 | GREEN | LED_SMD:LED_0603_1608Metric | Lite-On | LTST-C191KGKT | C125098 |  | 3
J1 | LINE_SENSOR | Connector_JST:JST_SH_BM05B-SRSS-TB_1x05-1MP_P1.00mm_Vertical | JST | BM05B-SRSS-TB | C160391 |  | 1
R1,R3,R5 | 150 | Resistor_SMD:R_0603_1608Metric |  |  |  |  | 3
R2,R4,R6 | 10k | Resistor_SMD:R_0603_1608Metric |  |  |  |  | 3
R7,R8 | 100k | Resistor_SMD:R_0603_1608Metric |  |  |  |  | 2
R9-R11 | 680 | Resistor_SMD:R_0603_1608Metric |  |  |  |  | 3
U1-U3 | TCRT5000 | OptoDevice:Vishay_TCRT5000 | Vishay | TCRT5000 | C2984661 | TCRT5000L (long leads) | 3
U4 | LM339 | Package_SO:SOIC-14_3.9x8.7mm_P1.27mm | JSCJ | LM339 | C2829428 | TI LM339DR | 1
