Plastal-Bot-Builders/RoboCoreDocumentation/hardware/sensors/ultrasonic/RoboCore_Ultrasonic_BOM.csv

Refs | Value | Footprint | Manufacturer | MPN | LCSC | Alternative | Qty
C1 | 10uF | Capacitor_SMD:C_0805_2012Metric |  |  |  |  | 1
C2,C3 | 0.1uF | Capacitor_SMD:C_0603_1608Metric |  |  |  |  | 2
C4,C5 | 18pF | Capacitor_SMD:C_0603_1608Metric |  |  |  |  | 2
J1 | ULTRASONIC | Connector_JST:JST_SH_BM04B-SRSS-TB_1x04-1MP_P1.00mm_Vertical | JST | BM04B-SRSS-TB | C160390 |  | 1
LS1 | TX 40kHz | RoboCoreV2:Ultrasonic_Transducer_D16.0mm_P10.00mm | HYDZ | HY40A16T12-1 | C17701106 |  | 1
LS2 | RX 40kHz | RoboCoreV2:Ultrasonic_Transducer_D16.0mm_P10.00mm | HYDZ | HY40A16R12-1 | C17701107 |  | 1
R1 | 3.3 | Resistor_SMD:R_0603_1608Metric |  |  |  |  | 1
R2 | 15M | Resistor_SMD:R_0603_1608Metric |  |  |  |  | 1
R3 | 100k | Resistor_SMD:R_0603_1608Metric |  |  |  |  | 1
U1 | CS100A | Package_SO:SOIC-16_3.9x9.9mm_P1.27mm | Suzhou ShunGuiZhiLian (100sensor.com) | CS100A |  | not at LCSC: buy from AliExpress/Alibaba and consign to the assembler | 1
Y1 | 8MHz | Crystal:Crystal_SMD_3225-4Pin_3.2x2.5mm | HCI | XC32M4-8.000-F12LJDT | C2842191 |  | 1
