Plastal-Bot-Builders/RoboCoreDocumentation/hardware/controller_v2/fab/JLCPCB_V2_2026-10-12/RoboCore_V2_Controller_BOM_JLC.csv

Comment | Designator | Footprint | LCSC Part #
CMT-8504-100-SMT-TR | BZ201 | MagneticBuzzer_CUI_CMT-8504-100-SMT | C22359707
CL05B104KB5NNNC | C101,C106,C107,C112,C114,C120,C122,C202,C204,C205,C206,C302 | C_0402_1005Metric | C960916
CL10A105KA8NNNC | C102 | C_0603_1608Metric | C5673
CL10A106MO8NQNC | C103 | C_0603_1608Metric | C92487
CL21A475KAQNNNE | C104 | C_0805_2012Metric | C1779
CL21A106KOQNNNE | C105,C108,C301 | C_0805_2012Metric | C1713
CL21A226MAQNNNE | C109,C110,C201 | C_0805_2012Metric | C45783
CL31A226KAHNNNE | C111,C117,C118,C119,C303,C401,C402 | C_1206_3216Metric | C12891
CL10A225KO8NNNC | C113 | C_0603_1608Metric | C23630
CL05B103KB5NNNC | C115 | C_0402_1005Metric | C15195
CL05C220JB5NNNC | C116 | C_0402_1005Metric | C70464
CL05A105KA5NNNC | C121,C203 | C_0402_1005Metric | C16193167
CL05B102KB5NNNC | C304,C305 | C_0402_1005Metric | C14442
LTST-C191KRKT | D101,D105 | LED_0603_1608Metric | C125099
LTST-C191KGKT | D102,D104 | LED_0603_1608Metric | C125098
LTST-C191TBKT | D103 | LED_0603_1608Metric | C99290
SMF5.0A | D106 | D_SMF | C151296
1N4148WS-E3-08 | D107 | D_SOD-323 | C129905
WS2812B-2020-V6 | D201 | LED_WS2812B-2020_PLCC4_2.0x2.0mm | C52917434
1N4148W-7-F | D202 | D_SOD-123 | C83528
MF-MSMF150/24X-2 | F101 | Fuse_1812_4532Metric | C78695
TYPE-C-31-M-12 | J101 | USB_C_Receptacle_HRO_TYPE-C-31-M-12 | C165948
XT30UPB-M | J102 | AMASS_XT30UPB-M_1x02_P5.0mm_Vertical | C428721
BM04B-SRSS-TB | J201 | JST_SH_BM04B-SRSS-TB_1x04-1MP_P1.00mm_Vertical | C160390
BM06B-SRSS-TB | J301,J302 | JST_SH_BM06B-SRSS-TB_1x06-1MP_P1.00mm_Vertical | C160392
HX PH254-01-03-Z-L11.5 | J401,J402,J407,J408 | PinHeader_1x03_P2.54mm_Vertical | C52016391
HX PH254-01-04-Z-L11.5 | J403 | PinHeader_1x04_P2.54mm_Vertical | C52016392
HC-PZ254-11.5L-1x5PZ | J404 | PinHeader_1x05_P2.54mm_Vertical | C27985190
HC-PM254-8.5H-1x14PZ | J405,J406 | PinSocket_1x14_P2.54mm_Vertical | C22373900
SRN4018-2R2M | L101 | L_Bourns-SRN4018 | C913207
SRP5030CA-2R2M | L102 | L_Bourns_SRP5030CA | C2046809
AO3401A | Q101 | SOT-23 | C15127
SI7655DN-T1-GE3 | Q102,Q103,Q104 | Vishay_PowerPAK_1212-8_Single | C727830
AO3400A | Q105,Q201 | SOT-23 | C20917
0402WGF5101TCE | R101,R102 | R_0402_1005Metric | C25905
0402WGF1002TCE | R103,R106,R201,R202,R203,R303,R304,R305,R306,R307 | R_0402_1005Metric | C25744
0402WGF2673TCE | R104 | R_0402_1005Metric | C270622
RC0402FR-071KL | R105,R107,R108,R109,R119 | R_0402_1005Metric | C106235
0402WGF1003TCE | R110,R117,R118,R121,R122,R123,R206 | R_0402_1005Metric | C25741
RC0402FR-07100RL | R111,R205 | R_0402_1005Metric | C106232
0402WGF9101TCE | R112 | R_0402_1005Metric | C25926
0402WGF3003TCE | R113,R115 | R_0402_1005Metric | C25774
0402WGF8452TCE | R114 | R_0402_1005Metric | C26988
0402WGF2003TCE | R116 | R_0402_1005Metric | C25764
0402WGF2201TCE | R120 | R_0402_1005Metric | C25879
0402WGF3303TCE | R124 | R_0402_1005Metric | C25778
0402WGF1004TCE | R125 | R_0402_1005Metric | C26083
0402WGF9532TCE | R126 | R_0402_1005Metric | C26990
RC0402FR-0733RL | R204 | R_0402_1005Metric | C138002
0402WGF4701TCE | R207,R208 | R_0402_1005Metric | C25900
0402WGF1652TCE | R301,R302 | R_0402_1005Metric | C25857
0402WGF3300TCE | R401,R402,R403,R404,R405,R406,R407,R408,R409,R410,R411,R412,R413 | R_0402_1005Metric | C25104
JS102011SAQN | SW101 | SW_SPDT_CK_JS102011SAQN | C221660
SKQGADE010 | SW201,SW202,SW203 | SW_SPST_SKQG_WithoutStem | C116647
USBLC6-2SC6 | U101 | SOT-23-6 | C7519
MCP73871-2CCI/ML | U102 | QFN-20-1EP_4x4mm_P0.5mm_EP2.5x2.5mm_ThermalVias | C5121473
TPS63001DRCR | U103 | Texas_DRC0010J_ThermalVias | C28060
TPS61089RNRR | U104 | Texas_VQFN-RNR0011A-11 | C165129
TPS3700DDCR | U105 | TSOT-23-6 | C33002
ESP32-S3-WROOM-1-N8R2 | U201 | ESP32-S3-WROOM-1 | C2913204
LSM6DSOXTR | U202 | LGA-14_3x2.5mm_P0.5mm_LayoutBorder3x4y | C481766
DRV8411ARTER | U301 | WQFN-16-1EP_3x3mm_P0.5mm_EP1.68x1.68mm_ThermalVias | C18816315
