Plastal-Bot-Builders/RoboCoreDocumentation/hardware/controller_v2/tools/intended_nets.tsv

J101 | A1 | GND
J101 | A4 | VBUS
J101 | A5 | CC1
J101 | A6 | USB_DP
J101 | A7 | USB_DN
J101 | A9 | VBUS
J101 | A12 | GND
J101 | B1 | GND
J101 | B4 | VBUS
J101 | B5 | CC2
J101 | B6 | USB_DP
J101 | B7 | USB_DN
J101 | B9 | VBUS
J101 | B12 | GND
J101 | SH | GND
U101 | 1 | USB_DN
U101 | 2 | GND
U101 | 3 | USB_DP
U101 | 4 | USB_D+
U101 | 5 | VBUS
U101 | 6 | USB_D-
R101 | 1 | CC1
R101 | 2 | GND
R102 | 1 | CC2
R102 | 2 | GND
C101 | 1 | VBUS
C101 | 2 | GND
D106 | 1 | VBUS
D106 | 2 | GND
F101 | 1 | VBUS
F101 | 2 | +5V_USB
C102 | 1 | +5V_USB
C102 | 2 | GND
U102 | 1 | VSYS
U102 | 2 | CHG_VPCC
U102 | 3 | CHG_SEL
U102 | 4 | +5V_USB
U102 | 5 | CHG_THERM
U102 | 6 | CHG_PG
U102 | 7 | CHG_STAT2
U102 | 8 | CHG_STAT1
U102 | 9 | +5V_USB
U102 | 10 | GND
U102 | 11 | GND
U102 | 12 | CHG_PROG3
U102 | 13 | CHG_PROG1
U102 | 14 | +BATT
U102 | 15 | +BATT
U102 | 16 | +BATT
U102 | 17 | +5V_USB
U102 | 18 | +5V_USB
U102 | 19 | +5V_USB
U102 | 20 | VSYS
U102 | 21 | GND
R104 | 1 | +5V_USB
R104 | 2 | CHG_VPCC
R121 | 1 | CHG_VPCC
R121 | 2 | GND
JP101 | 1 | +5V_USB
JP101 | 2 | CHG_SEL
JP101 | 3 | GND
R105 | 1 | CHG_PROG1
R105 | 2 | GND
R106 | 1 | CHG_PROG3
R106 | 2 | GND
R103 | 1 | CHG_THERM
R103 | 2 | GND
C103 | 1 | VSYS
C103 | 2 | GND
C104 | 1 | +BATT
C104 | 2 | GND
D101 | 1 | LED_CHG_K
D101 | 2 | +5V_USB
R107 | 1 | LED_CHG_K
R107 | 2 | CHG_STAT1
D102 | 1 | LED_FULL_K
D102 | 2 | +5V_USB
R108 | 1 | LED_FULL_K
R108 | 2 | CHG_STAT2
D103 | 1 | LED_PG_K
D103 | 2 | +5V_USB
R109 | 1 | LED_PG_K
R109 | 2 | CHG_PG
Q101 | 1 | PWR_EN_N
Q101 | 2 | VSYS
Q101 | 3 | VSYS_SW
R110 | 1 | VSYS
R110 | 2 | PWR_EN_N
SW101 | 2 | PWR_EN_N
SW101 | 3 | GND
C105 | 1 | VSYS_SW
C105 | 2 | GND
C106 | 1 | VSYS_SW
C106 | 2 | GND
R117 | 1 | +BATT
R117 | 2 | VBAT_SENSE
R118 | 1 | VBAT_SENSE
R118 | 2 | GND
C120 | 1 | VBAT_SENSE
C120 | 2 | GND
D104 | 1 | LED_SYS_K
D104 | 2 | +3V3
R119 | 1 | LED_SYS_K
R119 | 2 | GND
D105 | 1 | LED_MOT_K
D105 | 2 | VMOT
R120 | 1 | LED_MOT_K
R120 | 2 | GND
TP101 | 1 | +3V3
TP102 | 1 | VMOT
TP103 | 1 | +BATT
TP105 | 1 | VSYS_SW
TP104 | 1 | GND
U103 | 1 | +3V3
U103 | 2 | BB_L2
U103 | 3 | GND
U103 | 4 | BB_L1
U103 | 5 | VSYS_SW
U103 | 6 | VSYS_SW
U103 | 7 | GND
U103 | 8 | BB_VINA
U103 | 9 | GND
U103 | 10 | +3V3
U103 | 11 | GND
L101 | 1 | BB_L1
L101 | 2 | BB_L2
R111 | 1 | VSYS_SW
R111 | 2 | BB_VINA
C107 | 1 | BB_VINA
C107 | 2 | GND
C108 | 1 | VSYS_SW
C108 | 2 | GND
C109 | 1 | +3V3
C109 | 2 | GND
C110 | 1 | +3V3
C110 | 2 | GND
U104 | 1 | BST_FSW
U104 | 2 | BST_VCC
U104 | 3 | BST_FB
U104 | 4 | BST_COMP
U104 | 5 | GND
U104 | 6 | VMOT
U104 | 7 | VSYS_SW
U104 | 8 | BST_ILIM
U104 | 9 | BST_VIN
U104 | 10 | BST_BOOT
U104 | 11 | BST_SW
Q102 | 4 | PWR_EN_N
Q102 | 1 | +BATT
Q102 | 2 | +BATT
Q102 | 3 | +BATT
Q102 | 5 | BST_VIN
L102 | 1 | BST_VIN
L102 | 2 | BST_SW
C114 | 1 | BST_BOOT
C114 | 2 | BST_SW
R115 | 1 | BST_FSW
R115 | 2 | BST_SW
C111 | 1 | BST_VIN
C111 | 2 | GND
C112 | 1 | BST_VIN
C112 | 2 | GND
C113 | 1 | BST_VCC
C113 | 2 | GND
R116 | 1 | BST_ILIM
R116 | 2 | GND
R112 | 1 | BST_COMP
R112 | 2 | BST_RC
C115 | 1 | BST_RC
C115 | 2 | GND
C116 | 1 | BST_COMP
C116 | 2 | GND
R113 | 1 | VMOT
R113 | 2 | BST_FB
R114 | 1 | BST_FB
R114 | 2 | GND
C117 | 1 | VMOT
C117 | 2 | GND
C118 | 1 | VMOT
C118 | 2 | GND
C119 | 1 | VMOT
C119 | 2 | GND
J102 | 1 | GND
J102 | 2 | BAT_RAW
Q103 | 4 | BATP_G
Q103 | 1 | BATP_S
Q103 | 2 | BATP_S
Q103 | 3 | BATP_S
Q103 | 5 | BAT_RAW
Q104 | 4 | BATP_G
Q104 | 1 | BATP_S
Q104 | 2 | BATP_S
Q104 | 3 | BATP_S
Q104 | 5 | +BATT
R122 | 1 | BATP_S
R122 | 2 | BATP_G
Q105 | 1 | BATP_EN
Q105 | 2 | GND
Q105 | 3 | BATP_G
D107 | 1 | BATP_D
D107 | 2 | BAT_RAW
R123 | 1 | BATP_D
R123 | 2 | BATP_EN
R124 | 1 | BATP_EN
R124 | 2 | GND
C121 | 1 | BATP_EN
C121 | 2 | GND
U105 | 2 | GND
U105 | 3 | BATP_OV
U105 | 4 | BATP_OV
U105 | 5 | BATP_S
U105 | 6 | BATP_EN
R125 | 1 | BATP_S
R125 | 2 | BATP_OV
R126 | 1 | BATP_OV
R126 | 2 | GND
C122 | 1 | BATP_S
C122 | 2 | GND
U201 | 1 | GND
U201 | 2 | +3V3
U201 | 3 | EN
U201 | 4 | VBAT_SENSE
U201 | 5 | MOTA_ISENSE
U201 | 6 | MOTB_ISENSE
U201 | 7 | IR_L
U201 | 8 | ENC1_A
U201 | 9 | ENC1_B
U201 | 10 | ENC2_A
U201 | 11 | ENC2_B
U201 | 12 | I2C_SDA
U201 | 13 | USB_D-
U201 | 14 | USB_D+
U201 | 15 | EXP_IO3
U201 | 17 | I2C_SCL
U201 | 18 | IR_C
U201 | 19 | MOTA_IN1
U201 | 20 | MOTA_IN2
U201 | 21 | MOTB_IN1
U201 | 22 | MOTB_IN2
U201 | 23 | MOT_NFAULT
U201 | 24 | BUZZER
U201 | 25 | RGB_DATA
U201 | 27 | BOOT
U201 | 28 | SERVO3
U201 | 29 | SERVO4
U201 | 30 | EXP_IO37
U201 | 31 | SERVO1
U201 | 32 | SERVO2
U201 | 33 | US_TRIG
U201 | 34 | US_ECHO
U201 | 35 | USER_BTN
U201 | 36 | UART_RX
U201 | 37 | UART_TX
U201 | 38 | IR_R
U201 | 39 | IMU_INT1
U201 | 40 | GND
U201 | 41 | GND
C201 | 1 | +3V3
C201 | 2 | GND
C202 | 1 | +3V3
C202 | 2 | GND
R201 | 1 | +3V3
R201 | 2 | EN
SW201 | 1 | EN
SW201 | 2 | GND
C203 | 1 | EN
C203 | 2 | GND
R202 | 1 | +3V3
R202 | 2 | BOOT
SW202 | 1 | BOOT
SW202 | 2 | GND
R203 | 1 | +3V3
R203 | 2 | USER_BTN
SW203 | 1 | USER_BTN
SW203 | 2 | GND
R207 | 1 | +3V3
R207 | 2 | I2C_SDA
R208 | 1 | +3V3
R208 | 2 | I2C_SCL
J201 | 1 | GND
J201 | 2 | +3V3
J201 | 3 | I2C_SDA
J201 | 4 | I2C_SCL
R204 | 1 | RGB_DATA
R204 | 2 | RGB_DIN
D201 | 1 | RGB_DOUT
D201 | 2 | GND
D201 | 3 | RGB_DIN
D201 | 4 | +3V3
C204 | 1 | +3V3
C204 | 2 | GND
BZ201 | 1 | VSYS_SW
BZ201 | 2 | BUZZ_DRV
D202 | 1 | VSYS_SW
D202 | 2 | BUZZ_DRV
Q201 | 1 | BUZZ_GATE
Q201 | 2 | GND
Q201 | 3 | BUZZ_DRV
R205 | 1 | BUZZER
R205 | 2 | BUZZ_GATE
R206 | 1 | BUZZ_GATE
R206 | 2 | GND
U202 | 1 | GND
U202 | 2 | GND
U202 | 3 | GND
U202 | 4 | IMU_INT1
U202 | 5 | +3V3
U202 | 6 | GND
U202 | 7 | GND
U202 | 8 | +3V3
U202 | 12 | +3V3
U202 | 13 | I2C_SCL
U202 | 14 | I2C_SDA
C205 | 1 | +3V3
C205 | 2 | GND
C206 | 1 | +3V3
C206 | 2 | GND
U301 | 10 | VMOT
U301 | 15 | +3V3
U301 | 14 | MOTA_IN1
U301 | 13 | MOTA_IN2
U301 | 7 | MOTB_IN1
U301 | 8 | MOTB_IN2
U301 | 6 | MOT_NFAULT
U301 | 16 | MOTA_P
U301 | 2 | MOTA_N
U301 | 5 | MOTB_N
U301 | 3 | MOTB_P
U301 | 12 | MOTA_ISENSE
U301 | 9 | MOTB_ISENSE
U301 | 11 | GND
U301 | 1 | GND
U301 | 4 | GND
U301 | 17 | GND
C301 | 1 | VMOT
C301 | 2 | GND
C302 | 1 | VMOT
C302 | 2 | GND
C303 | 1 | VMOT
C303 | 2 | GND
R303 | 1 | +3V3
R303 | 2 | MOT_NFAULT
R302 | 1 | MOTB_ISENSE
R302 | 2 | GND
C305 | 1 | MOTB_ISENSE
C305 | 2 | GND
R301 | 1 | MOTA_ISENSE
R301 | 2 | GND
C304 | 1 | MOTA_ISENSE
C304 | 2 | GND
J301 | 1 | MOTA_P
J301 | 2 | MOTA_N
J301 | 3 | +3V3
J301 | 4 | ENC1_A
J301 | 5 | ENC1_B
J301 | 6 | GND
R304 | 1 | +3V3
R304 | 2 | ENC1_A
R305 | 1 | +3V3
R305 | 2 | ENC1_B
J302 | 1 | MOTB_P
J302 | 2 | MOTB_N
J302 | 3 | +3V3
J302 | 4 | ENC2_A
J302 | 5 | ENC2_B
J302 | 6 | GND
R306 | 1 | +3V3
R306 | 2 | ENC2_A
R307 | 1 | +3V3
R307 | 2 | ENC2_B
J401 | 1 | SERVO1_HDR
J401 | 2 | VMOT
J401 | 3 | GND
J402 | 1 | SERVO2_HDR
J402 | 2 | VMOT
J402 | 3 | GND
J407 | 1 | SERVO3_HDR
J407 | 2 | VMOT
J407 | 3 | GND
J408 | 1 | SERVO4_HDR
J408 | 2 | VMOT
J408 | 3 | GND
C401 | 1 | VMOT
C401 | 2 | GND
C402 | 1 | VMOT
C402 | 2 | GND
J403 | 1 | +3V3
J403 | 2 | US_TRIG_HDR
J403 | 3 | US_ECHO_HDR
J403 | 4 | GND
J404 | 1 | +3V3
J404 | 2 | GND
J404 | 3 | IR_L_HDR
J404 | 4 | IR_C_HDR
J404 | 5 | IR_R_HDR
J405 | 1 | +3V3
J405 | 2 | GND
J405 | 3 | IR_L_HDR
J405 | 4 | IR_C_HDR
J405 | 5 | IR_R_HDR
J405 | 6 | US_TRIG_HDR
J405 | 7 | US_ECHO_HDR
J405 | 8 | SERVO1_HDR
J405 | 9 | SERVO2_HDR
J405 | 10 | BUZZER
J405 | 11 | RGB_DOUT
J405 | 12 | EXP_IO3_HDR
J405 | 13 | VMOT
J405 | 14 | GND
J406 | 1 | +3V3
J406 | 2 | GND
J406 | 3 | I2C_SDA
J406 | 4 | I2C_SCL
J406 | 5 | UART_TX_HDR
J406 | 6 | UART_RX_HDR
J406 | 7 | SERVO3_HDR
J406 | 8 | SERVO4_HDR
J406 | 9 | EXP_IO37_HDR
J406 | 10 | IMU_INT1
J406 | 11 | USER_BTN
J406 | 12 | EN
J406 | 13 | VSYS_SW
J406 | 14 | GND
R401 | 1 | SERVO1
R401 | 2 | SERVO1_HDR
R402 | 1 | SERVO2
R402 | 2 | SERVO2_HDR
R403 | 1 | US_TRIG
R403 | 2 | US_TRIG_HDR
R404 | 1 | US_ECHO
R404 | 2 | US_ECHO_HDR
R405 | 1 | IR_L
R405 | 2 | IR_L_HDR
R406 | 1 | IR_C
R406 | 2 | IR_C_HDR
R407 | 1 | IR_R
R407 | 2 | IR_R_HDR
R408 | 1 | EXP_IO3
R408 | 2 | EXP_IO3_HDR
R409 | 1 | SERVO3
R409 | 2 | SERVO3_HDR
R410 | 1 | SERVO4
R410 | 2 | SERVO4_HDR
R411 | 1 | EXP_IO37
R411 | 2 | EXP_IO37_HDR
R412 | 1 | UART_TX
R412 | 2 | UART_TX_HDR
R413 | 1 | UART_RX
R413 | 2 | UART_RX_HDR
