Plastal-Bot-Builders/RoboCoreDocumentation/hardware/sensors/line_sensor/intended_nets.tsv

R1 | 1 | +3V3
R1 | 2 | IRLED_L
R2 | 1 | +3V3
R2 | 2 | IR_L
U1 | 4 | IRLED_L
U1 | 3 | GND
U1 | 1 | IR_L
U1 | 2 | GND
R3 | 1 | +3V3
R3 | 2 | IRLED_C
R4 | 1 | +3V3
R4 | 2 | IR_C
U2 | 4 | IRLED_C
U2 | 3 | GND
U2 | 1 | IR_C
U2 | 2 | GND
R5 | 1 | +3V3
R5 | 2 | IRLED_R
R6 | 1 | +3V3
R6 | 2 | IR_R
U3 | 4 | IRLED_R
U3 | 3 | GND
U3 | 1 | IR_R
U3 | 2 | GND
J1 | 1 | GND
J1 | 2 | +3V3
J1 | 3 | IR_L
J1 | 4 | IR_C
J1 | 5 | IR_R
C1 | 1 | +3V3
C1 | 2 | GND
C2 | 1 | +3V3
C2 | 2 | GND
U4 | 5 | VREF
U4 | 4 | IR_L
U4 | 7 | VREF
U4 | 6 | IR_C
U4 | 9 | VREF
U4 | 8 | IR_R
U4 | 11 | GND
U4 | 10 | VREF
U4 | 2 | IND_L
U4 | 1 | IND_C
U4 | 14 | IND_R
U4 | 3 | +3V3
U4 | 12 | GND
R7 | 1 | +3V3
R7 | 2 | VREF
R8 | 1 | VREF
R8 | 2 | GND
C3 | 1 | VREF
C3 | 2 | GND
C4 | 1 | +3V3
C4 | 2 | GND
R9 | 1 | +3V3
R9 | 2 | LEDA_L
R10 | 1 | +3V3
R10 | 2 | LEDA_C
R11 | 1 | +3V3
R11 | 2 | LEDA_R
D1 | 1 | IND_L
D1 | 2 | LEDA_L
D2 | 1 | IND_C
D2 | 2 | LEDA_C
D3 | 1 | IND_R
D3 | 2 | LEDA_R
