Plastal-Bot-Builders/RoboCoreDocumentation/hardware/sensors/ultrasonic/intended_nets.tsv

J1 | 1 | GND
J1 | 2 | +3V3
J1 | 3 | TRIG
J1 | 4 | ECHO
R1 | 1 | +3V3
R1 | 2 | VCC
C1 | 1 | VCC
C1 | 2 | GND
R3 | 1 | TRIG
R3 | 2 | GND
U1 | 8 | TRIG
U1 | 7 | ECHO
U1 | 16 | GND
U1 | 5 | AMP_OUT
U1 | 6 | COMP_OUT
U1 | 10 | TX_P
U1 | 11 | TX_N
U1 | 2 | RX_P
U1 | 1 | RX_N
U1 | 13 | XTAL_I
U1 | 14 | XTAL_O
U1 | 4 | VCC
U1 | 9 | VCC
U1 | 3 | GND
U1 | 12 | GND
C2 | 1 | VCC
C2 | 2 | GND
C3 | 1 | VCC
C3 | 2 | GND
Y1 | 1 | XTAL_I
Y1 | 2 | GND
Y1 | 3 | XTAL_O
Y1 | 4 | GND
C4 | 1 | XTAL_I
C4 | 2 | GND
C5 | 1 | XTAL_O
C5 | 2 | GND
R2 | 1 | RX_P
R2 | 2 | GND
LS1 | 1 | TX_P
LS1 | 2 | TX_N
LS2 | 1 | RX_P
LS2 | 2 | RX_N
TP1 | 1 | AMP_OUT
TP2 | 1 | COMP_OUT
