Plastal-Bot-Builders/RoboCoreDocumentation/hardware/controller_v2/fab/PCBWay_V2_2026-10-07/RoboCore_V2_order_overview.png

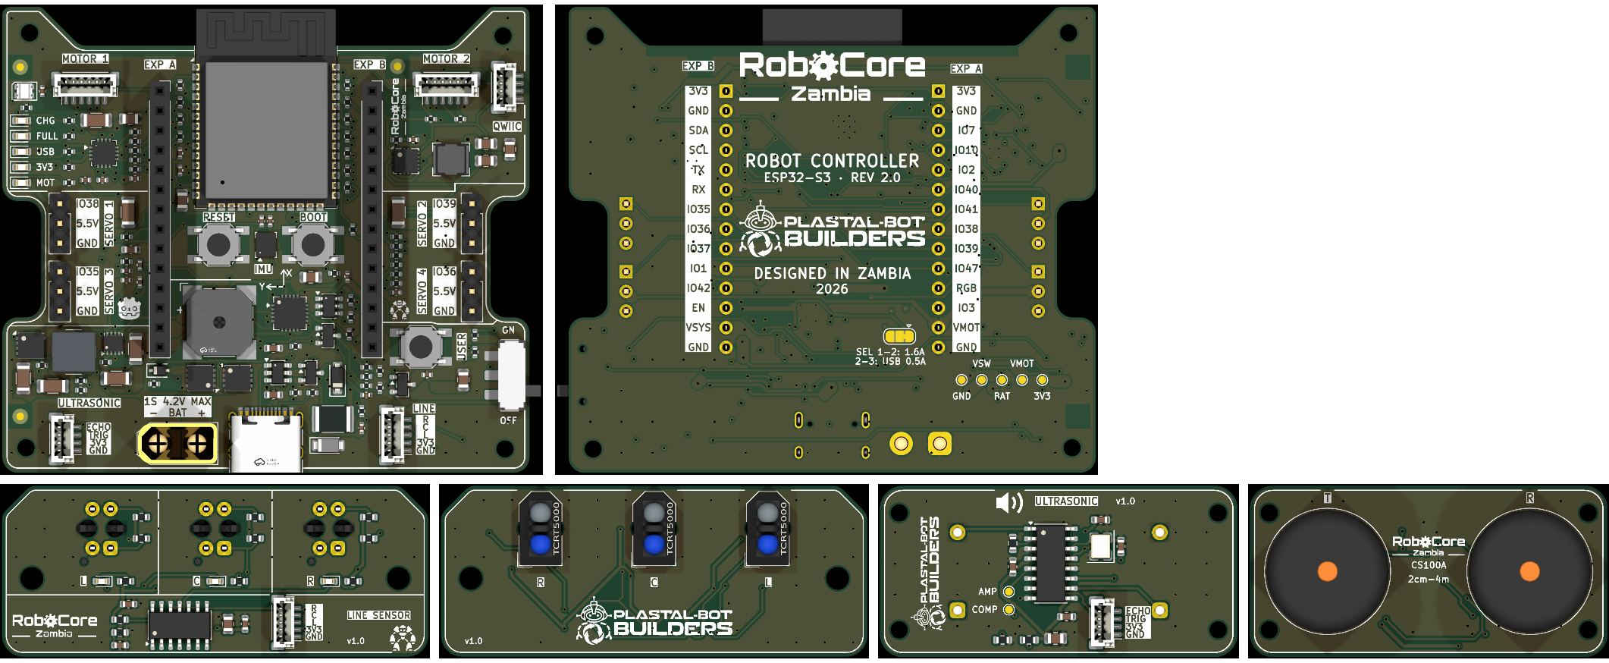
hardware/controller_v2/fab/PCBWay_V2_2026-10-07/RoboCore_V2_order_overview.png
