Plastal-Bot-Builders/RoboCoreDocumentation/mechanical/board_step/RoboCore_LineSensor.step

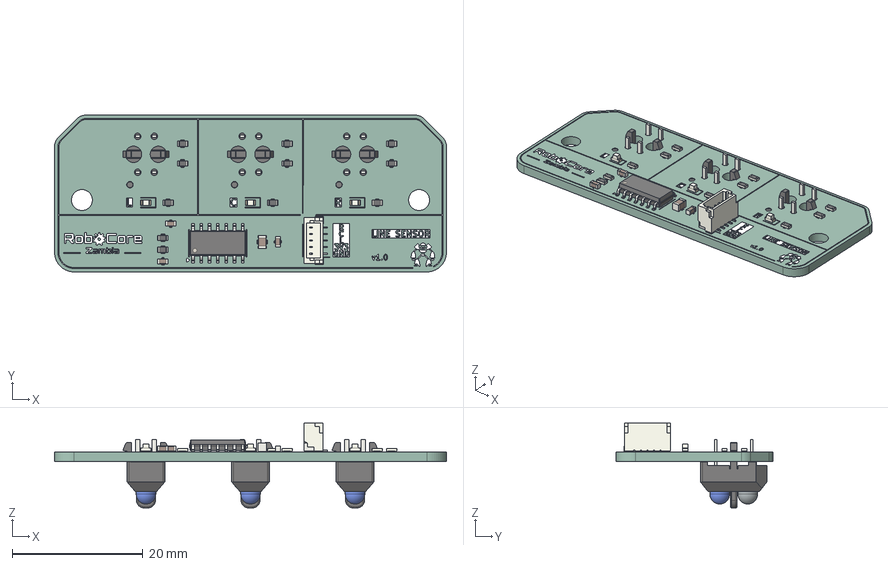
[picture p117: CAD file, 2026-10-12]
mechanical/board_step/RoboCore_LineSensor.step
60.0 x 24.0 x 13.0 mm
C_0805_2012Metric
SOIC-14_3.9x8.7mm_P1.27mm
LED_0603_1608Metric x 3
C_0603_1608Metric x 3
R_0603_1608Metric x 11
JST_SH_BM05B-SRSS-TB_1x05-1MP_P1.00mm_Vertical
Vishay_TCRT5000 x 3
RoboCore_LineSensor_silkscreen x 2
RoboCore_LineSensor_PCB
