Plastal-Bot-Builders/RoboCoreDocumentation/mechanical/reference/RoboCore_V2.step

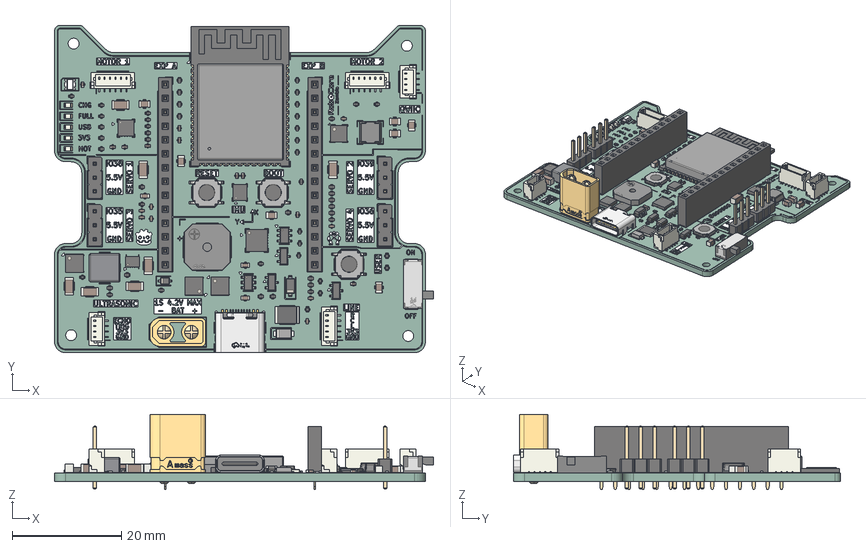
[picture p118: CAD file, 2026-10-12]
mechanical/reference/RoboCore_V2.step
69.5 x 60.0 x 13.8 mm
C_0402_1005Metric x 18
R_0402_1005Metric x 54
PinSocket_1x14_P2.54mm_Vertical x 2
WQFN-16-1EP_3x3mm_P0.5mm_EP1.6x1.6mm
D_SOD-123
PinHeader_1x03_P2.54mm_Vertical x 4
C_0603_1608Metric x 3
SOT-23-6
JST_SH_BM05B-SRSS-TB_1x05-1MP_P1.00mm_Vertical
QFN-20-1EP_4x4mm_P0.5mm_EP2.5x2.5mm
C_1206_3216Metric x 7
VSON-10-1EP_3x3mm_P0.5mm_EP1.65x2.4mm
LED_0603_1608Metric x 5
SW_SPST_SKQG_WithoutStem x 3
C_0805_2012Metric x 7
JST_SH_BM04B-SRSS-TB_1x04-1MP_P1.00mm_Vertical x 2
L_Bourns-SRN4018
DFN-10-1EP_2x3mm_P0.5mm_EP0.64x2.4mm
TSOT-23-6
R_1812_4532Metric
SOT-23 x 3
BUZ-SMD_4P-L8.5-W8.5-P8.50-TL-A
JST_SH_BM06B-SRSS-TB_1x06-1MP_P1.00mm_Vertical x 2
D_SOD-323
VSON-8_3.3x3.3mm_P0.65mm_NexFET x 3
USB-C_SMD-TYPE-C-31-M-12_1
LGA-14_3x2.5mm_P0.5mm_LayoutBorder3x4y
L_Bourns_SRP5030T
D_SMF
ESP32-S3-WROOM-1
SW-SMD_JS102011SAQN
LED-SMD_4P-L2.0-W2.0-H0.8-TL_WS2812B-2020
CONN-TH_XT30UPB-M
RoboCore_V2_silkscreen x 2
RoboCore_V2_PCB
