Plastal-Bot-Builders/RoboCoreDocumentation/mechanical/board_step/RoboCore_Ultrasonic.step

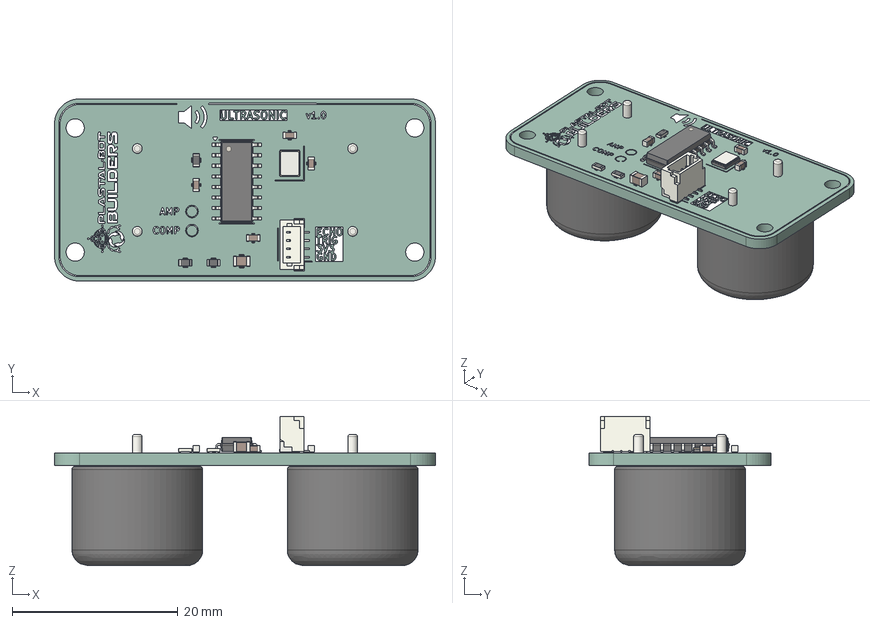
[picture p119: CAD file, 2026-10-12]
mechanical/board_step/RoboCore_Ultrasonic.step
46.0 x 22.0 x 18.0 mm
Crystal_SMD_3225-4Pin_3.2x2.5mm
R_0603_1608Metric x 3
C_0603_1608Metric x 4
C_0805_2012Metric
JST_SH_BM04B-SRSS-TB_1x04-1MP_P1.00mm_Vertical
SOIC-16_3.9x9.9mm_P1.27mm
Buzzer_12x9.5RM7.6 x 2
RoboCore_Ultrasonic_silkscreen x 2
RoboCore_Ultrasonic_PCB
