Plastal-Bot-Builders/RoboCoreDocumentation/mechanical/robot_v2/cardboard/cad/cardboard_chassis_flat.obj

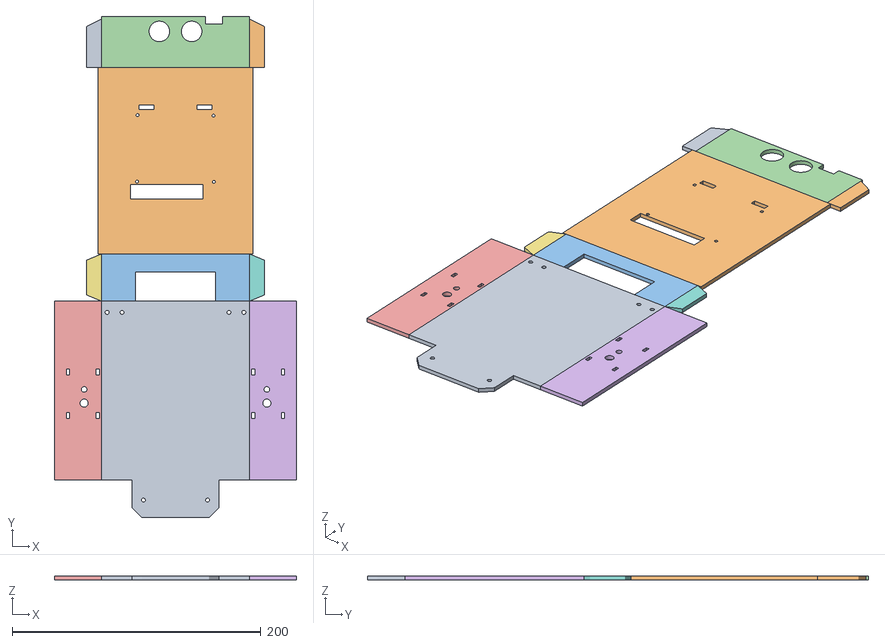
[picture p120: CAD file, 2026-10-12, an earlier design]
mechanical/robot_v2/cardboard/cad/cardboard_chassis_flat.obj
195.0 x 403.0 x 3.00
floor
deck
rear_wall
flap
left_wall
right_wall
glue_tab_L
glue_tab_R
flap_tab_L
flap_tab_R
