Plastal-Bot-Builders/RoboCoreDocumentation/mechanical/robot_v2/export/components/cables/Cable_ultrasonic_SH4-DU4_100.step

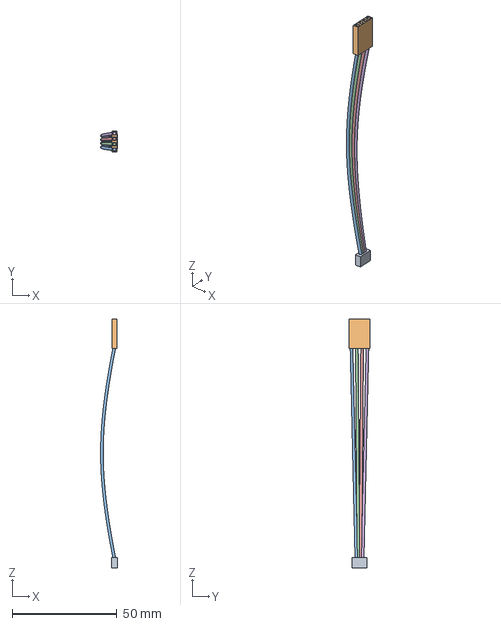
[picture p121: CAD file, 2026-10-12, an earlier design]
mechanical/robot_v2/export/components/cables/Cable_ultrasonic_SH4-DU4_100.step
8.05 x 10.2 x 119.0 mm
