Plastal-Bot-Builders/RoboCoreDocumentation/mechanical/robot_v2/export/components/RoboCore_V2_Sonar_bracket.step

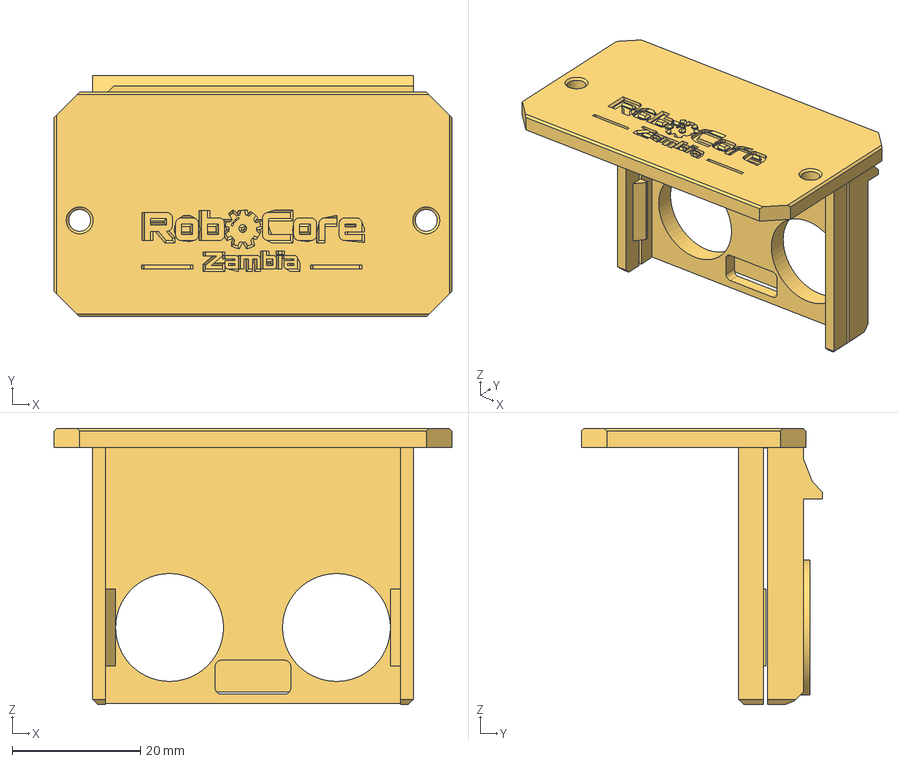
[picture p122: CAD file, 2026-10-12, an earlier design]
mechanical/robot_v2/export/components/RoboCore_V2_Sonar_bracket.step
62.0 x 37.6 x 43.0 mm
