Plastal-Bot-Builders/RoboCoreDocumentation/mechanical/robot_v2/packaging/out/insert.dxf

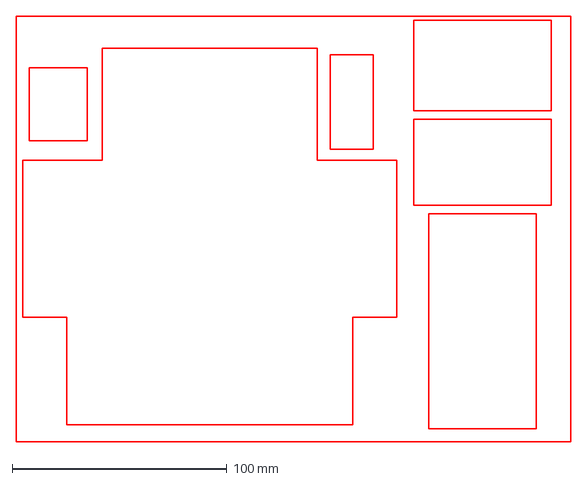
[picture p123: CAD file, 2026-11-07, an earlier design]
mechanical/robot_v2/packaging/out/insert.dxf
258.0 x 198.0 mm
