Plastal-Bot-Builders/RoboCoreDocumentation/mechanical/robot_v2/packaging/out_v3/box_net.dxf

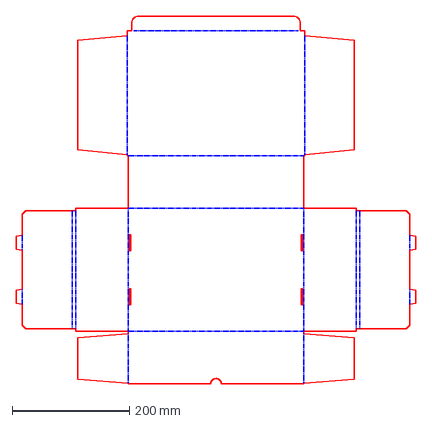
[picture p124: CAD file, 2026-11-07, an earlier design]
mechanical/robot_v2/packaging/out_v3/box_net.dxf
681.0 x 627.0 mm
