Plastal-Bot-Builders/RoboCoreDocumentation/mechanical/robot_v2/print/rev2/RoboCore_V2_Side_pod_L.3mf

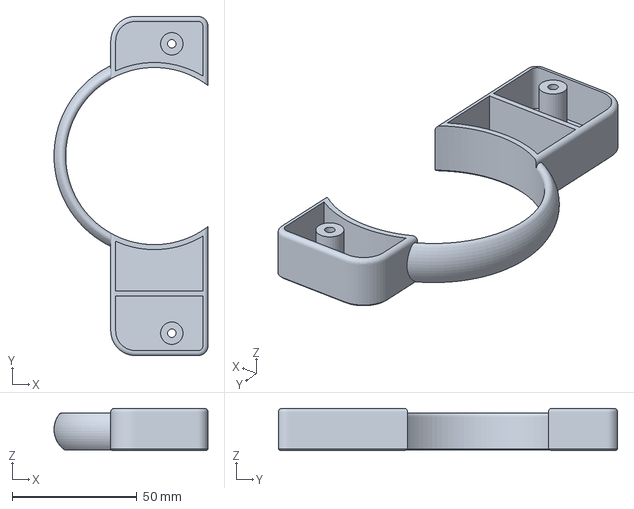
[picture p125: CAD file, 2026-10-12, an earlier design]
mechanical/robot_v2/print/rev2/RoboCore_V2_Side_pod_L.3mf
61.7 x 136.0 x 17.0 mm
