Plastal-Bot-Builders/RoboCoreDocumentation/mechanical/robot_v2/print/rev3/RoboCore_V2_Arm.3mf

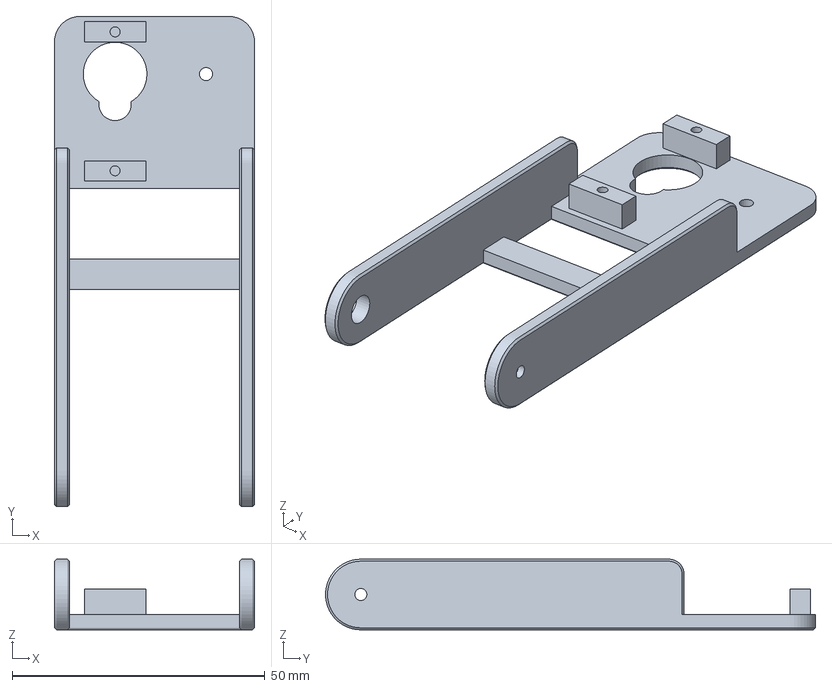
[picture p126: CAD file, 2026-10-12, an earlier design]
mechanical/robot_v2/print/rev3/RoboCore_V2_Arm.3mf
39.6 x 97.0 x 14.0 mm
