Plastal-Bot-Builders/RoboCoreDocumentation/mechanical/robot_v2/print/rev4/RoboCore_V2_Sonar_bracket.3mf

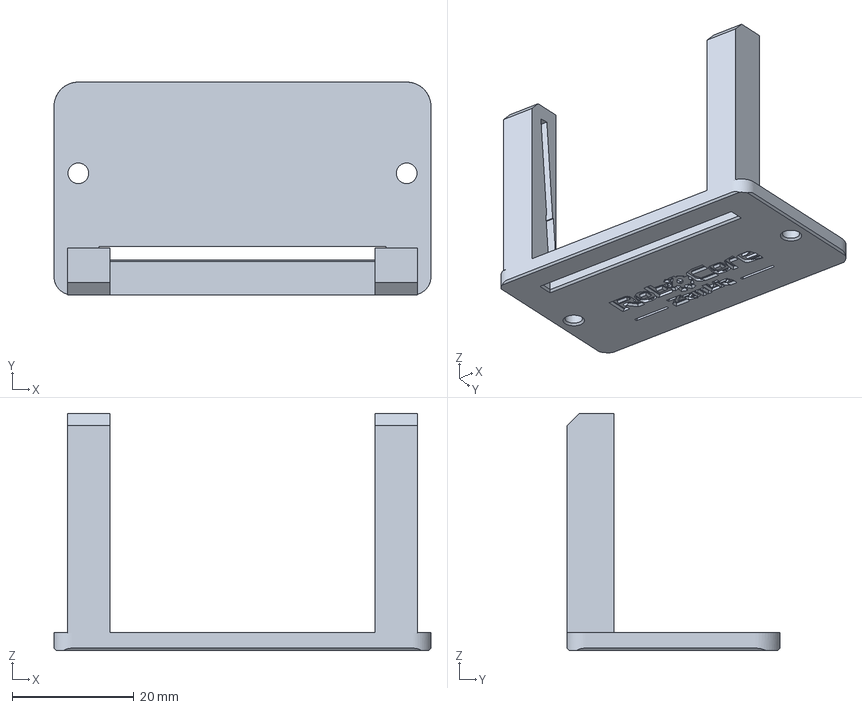
[picture p127: CAD file, 2026-10-12, an earlier design]
mechanical/robot_v2/print/rev4/RoboCore_V2_Sonar_bracket.3mf
62.0 x 35.0 x 39.0 mm
