Plastal-Bot-Builders/RoboCoreDocumentation/mechanical/robot_v2/print/RoboCore_V2_Chassis.3mf

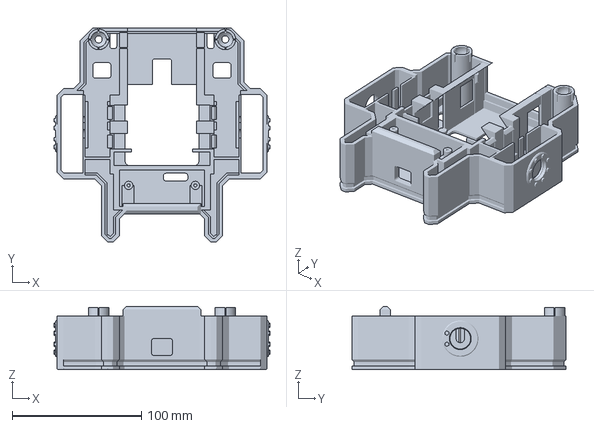
[picture p128: CAD file, 2026-10-23, an earlier design]
mechanical/robot_v2/print/RoboCore_V2_Chassis.3mf
167.2 x 166.0 x 49.0 mm
