Plastal-Bot-Builders/RoboCoreDocumentation/mechanical/robot_v2/topo/yoke_web_blocky_raised.stl

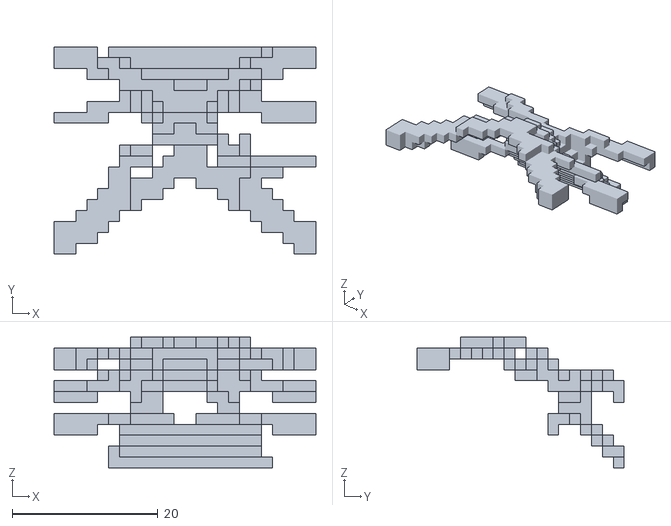
[picture p130: CAD file, 2026-10-23, an earlier design]
mechanical/robot_v2/topo/yoke_web_blocky_raised.stl
36.0 x 28.5 x 18.0
