Plastal-Bot-Builders/RoboCoreDocumentation/mechanical/robot_v2/cardboard/cad/cardboard_net.dxf

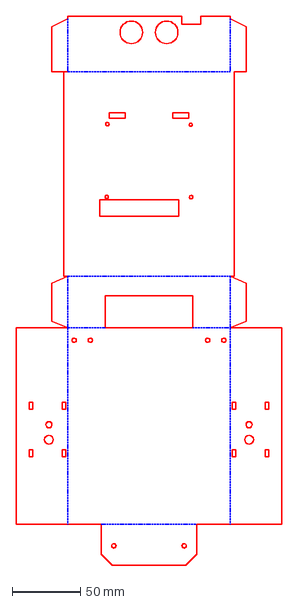
[picture p131: CAD file, 2026-10-12, an earlier design]
mechanical/robot_v2/cardboard/cad/cardboard_net.dxf
195.0 x 403.0 mm
