Plastal-Bot-Builders/RoboCoreDocumentation/mechanical/robot_v2/export/components/cables/Cable_SH4-SH4_100_Qwiic.step

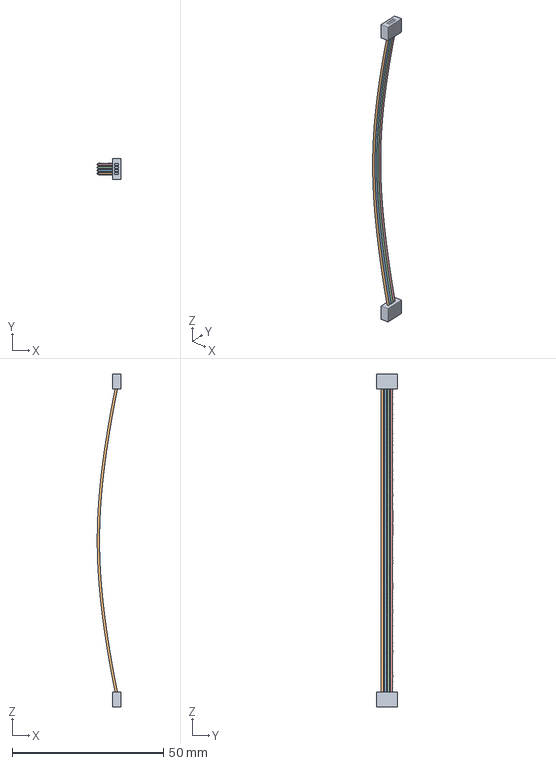
[picture p132: CAD file, 2026-10-12, an earlier design]
mechanical/robot_v2/export/components/cables/Cable_SH4-SH4_100_Qwiic.step
7.80 x 7.00 x 110.0 mm
