Plastal-Bot-Builders/RoboCoreDocumentation/(list of files, cad)

Other CAD files:
mechanical/board_step/RoboCore_V2.step
mechanical/robot_v2/export/components/RoboCore_V2_Rail_coupon.step
mechanical/robot_v2/RoboCore_V2_Robot.f3d
mechanical/robot_v2/cardboard/cad/cardboard_chassis.obj
mechanical/robot_v2/export/components/Battery_holder_3x18650.step
mechanical/robot_v2/export/components/Caster_ball_12.7.step
mechanical/robot_v2/export/components/DG01D-E_motor_with_encoder.step
mechanical/robot_v2/export/components/HC-SR04_ultrasonic.step
mechanical/robot_v2/export/components/Micro_servo_MG90S.step
mechanical/robot_v2/export/components/Micro_servo_SG90.step
mechanical/robot_v2/export/components/RoboCore_V2_Arm.step
mechanical/robot_v2/export/components/RoboCore_V2_Arm.stl
mechanical/robot_v2/export/components/RoboCore_V2_Arm_base.step
mechanical/robot_v2/export/components/RoboCore_V2_Arm_base.stl
mechanical/robot_v2/export/components/RoboCore_V2_Ballast_clip.step
mechanical/robot_v2/export/components/RoboCore_V2_Ballast_clip.stl
mechanical/robot_v2/export/components/RoboCore_V2_Bus_clip.step
mechanical/robot_v2/export/components/RoboCore_V2_Bus_clip.stl
mechanical/robot_v2/export/components/RoboCore_V2_Chassis.step
mechanical/robot_v2/export/components/RoboCore_V2_Chassis.stl
mechanical/robot_v2/export/components/RoboCore_V2_Jaw_L_driven.step
mechanical/robot_v2/export/components/RoboCore_V2_Jaw_L_driven.stl
mechanical/robot_v2/export/components/RoboCore_V2_Jaw_R_idle.step
mechanical/robot_v2/export/components/RoboCore_V2_Jaw_R_idle.stl
mechanical/robot_v2/export/components/RoboCore_V2_Line_sled.step
mechanical/robot_v2/export/components/RoboCore_V2_Line_sled.stl
mechanical/robot_v2/export/components/RoboCore_V2_Sonar_bracket.stl
mechanical/robot_v2/export/components/RoboCore_V2_Tyre_TPU.step
mechanical/robot_v2/export/components/RoboCore_V2_Tyre_TPU.stl
mechanical/robot_v2/export/components/RoboCore_V2_Wheel.step
mechanical/robot_v2/export/components/RoboCore_V2_Wheel.stl
mechanical/robot_v2/export/components/RoboCore_V2_controller_board.step
mechanical/robot_v2/export/components/RoboCore_line_sensor_board.step
mechanical/robot_v2/export/components/SG90_horn.step
mechanical/robot_v2/export/components/TT_motor_encoder_cover.step
mechanical/robot_v2/export/components/TT_motor_encoder_cover.stl
mechanical/robot_v2/export/components/cables/Cable_line_sensor_DU5-DU5_80.step
mechanical/robot_v2/export/components/cables/Cable_motor_encoder_SH6-PH6_120.step
mechanical/robot_v2/export/components/cables/Cable_servo_extension_DU3-DU3_150.step
mechanical/robot_v2/fusion/rev2/RoboCore_V2_Robot_rev2.f3d
mechanical/robot_v2/fusion/rev3/RoboCore_V2_Robot_rev3.f3d
mechanical/robot_v2/fusion/rev4/RoboCore_V2_Robot_rev4.f3d
mechanical/robot_v2/packaging/out/box_closed.obj
mechanical/robot_v2/packaging/out/box_flat.obj
mechanical/robot_v2/packaging/out/box_net.dxf
mechanical/robot_v2/packaging/out/box_open.obj
mechanical/robot_v2/packaging/out_v3/insert.dxf
mechanical/robot_v2/print/RoboCore_V2_Arm.3mf
mechanical/robot_v2/print/RoboCore_V2_Arm.stl
mechanical/robot_v2/print/RoboCore_V2_Arm_base.3mf
mechanical/robot_v2/print/RoboCore_V2_Arm_base.stl
mechanical/robot_v2/print/RoboCore_V2_Ballast_clip.3mf
mechanical/robot_v2/print/RoboCore_V2_Ballast_clip.stl
mechanical/robot_v2/print/RoboCore_V2_Bus_clip.3mf
mechanical/robot_v2/print/RoboCore_V2_Bus_clip.stl
mechanical/robot_v2/print/RoboCore_V2_Chassis.stl
mechanical/robot_v2/print/RoboCore_V2_Fastener_coupon.3mf
mechanical/robot_v2/print/RoboCore_V2_Fastener_coupon.stl
mechanical/robot_v2/print/RoboCore_V2_Jaw_L_driven.3mf
mechanical/robot_v2/print/RoboCore_V2_Jaw_L_driven.stl
mechanical/robot_v2/print/RoboCore_V2_Jaw_R_idle.3mf
mechanical/robot_v2/print/RoboCore_V2_Jaw_R_idle.stl
mechanical/robot_v2/print/RoboCore_V2_Line_sled_10.5.3mf
mechanical/robot_v2/print/RoboCore_V2_Line_sled_10.5.stl
mechanical/robot_v2/print/RoboCore_V2_Line_sled_11.5.3mf
mechanical/robot_v2/print/RoboCore_V2_Line_sled_11.5.stl
mechanical/robot_v2/print/RoboCore_V2_Line_sled_9.5.3mf
mechanical/robot_v2/print/RoboCore_V2_Line_sled_9.5.stl
mechanical/robot_v2/print/RoboCore_V2_Rail_coupon.3mf
mechanical/robot_v2/print/RoboCore_V2_Rail_coupon.stl
mechanical/robot_v2/print/RoboCore_V2_Sonar_bracket.3mf
mechanical/robot_v2/print/RoboCore_V2_Sonar_bracket.stl
mechanical/robot_v2/print/RoboCore_V2_Tyre_TPU.3mf
mechanical/robot_v2/print/RoboCore_V2_Tyre_TPU.stl
mechanical/robot_v2/print/RoboCore_V2_Wheel.3mf
mechanical/robot_v2/print/RoboCore_V2_Wheel.stl
mechanical/robot_v2/print/rev2/RoboCore_V2_1S2P_spacer.3mf
mechanical/robot_v2/print/rev2/RoboCore_V2_1S2P_spacer.stl
mechanical/robot_v2/print/rev2/RoboCore_V2_Battery_door.3mf
mechanical/robot_v2/print/rev2/RoboCore_V2_Battery_door.stl
mechanical/robot_v2/print/rev2/RoboCore_V2_Bumper_ring.3mf
mechanical/robot_v2/print/rev2/RoboCore_V2_Bumper_ring.stl
mechanical/robot_v2/print/rev2/RoboCore_V2_Caster.3mf
mechanical/robot_v2/print/rev2/RoboCore_V2_Caster.stl
mechanical/robot_v2/print/rev2/RoboCore_V2_Chassis.3mf
mechanical/robot_v2/print/rev2/RoboCore_V2_Chassis.stl
mechanical/robot_v2/print/rev2/RoboCore_V2_Front_bezel.3mf
mechanical/robot_v2/print/rev2/RoboCore_V2_Front_bezel.stl
mechanical/robot_v2/print/rev2/RoboCore_V2_Side_pod_L.stl
mechanical/robot_v2/print/rev2/RoboCore_V2_Side_pod_R.3mf
mechanical/robot_v2/print/rev2/RoboCore_V2_Side_pod_R.stl
mechanical/robot_v2/print/rev2/RoboCore_V2_Tyre_TPU.3mf
mechanical/robot_v2/print/rev2/RoboCore_V2_Tyre_TPU.stl
mechanical/robot_v2/print/rev2/RoboCore_V2_Wheel.3mf
mechanical/robot_v2/print/rev2/RoboCore_V2_Wheel.stl
mechanical/robot_v2/print/rev3/RoboCore_V2_1S2P_spacer.3mf
mechanical/robot_v2/print/rev3/RoboCore_V2_1S2P_spacer.stl
mechanical/robot_v2/print/rev3/RoboCore_V2_Arm.stl
mechanical/robot_v2/print/rev3/RoboCore_V2_Arm_base.3mf
mechanical/robot_v2/print/rev3/RoboCore_V2_Arm_base.stl
mechanical/robot_v2/print/rev3/RoboCore_V2_Battery_door.3mf
mechanical/robot_v2/print/rev3/RoboCore_V2_Battery_door.stl
mechanical/robot_v2/print/rev3/RoboCore_V2_Bus_clip.3mf
mechanical/robot_v2/print/rev3/RoboCore_V2_Bus_clip.stl
mechanical/robot_v2/print/rev3/RoboCore_V2_Chassis.3mf
mechanical/robot_v2/print/rev3/RoboCore_V2_Chassis.stl
mechanical/robot_v2/print/rev3/RoboCore_V2_Dock_cap.3mf
mechanical/robot_v2/print/rev3/RoboCore_V2_Dock_cap.stl
mechanical/robot_v2/print/rev3/RoboCore_V2_Jaw_L_driven.3mf
mechanical/robot_v2/print/rev3/RoboCore_V2_Jaw_L_driven.stl
mechanical/robot_v2/print/rev3/RoboCore_V2_Jaw_R_idle.3mf
mechanical/robot_v2/print/rev3/RoboCore_V2_Jaw_R_idle.stl
mechanical/robot_v2/print/rev3/RoboCore_V2_Line_sled_10.5.3mf
mechanical/robot_v2/print/rev3/RoboCore_V2_Line_sled_10.5.stl
mechanical/robot_v2/print/rev3/RoboCore_V2_Line_sled_11.5.3mf
mechanical/robot_v2/print/rev3/RoboCore_V2_Line_sled_11.5.stl
mechanical/robot_v2/print/rev3/RoboCore_V2_Line_sled_9.5.3mf
mechanical/robot_v2/print/rev3/RoboCore_V2_Line_sled_9.5.stl
mechanical/robot_v2/print/rev3/RoboCore_V2_Rail_coupon.3mf
mechanical/robot_v2/print/rev3/RoboCore_V2_Rail_coupon.stl
mechanical/robot_v2/print/rev3/RoboCore_V2_Tyre_TPU.3mf
mechanical/robot_v2/print/rev3/RoboCore_V2_Tyre_TPU.stl
mechanical/robot_v2/print/rev3/RoboCore_V2_Wheel.3mf
mechanical/robot_v2/print/rev4/RoboCore_V2_1S2P_spacer.3mf
mechanical/robot_v2/print/rev4/RoboCore_V2_1S2P_spacer.stl
mechanical/robot_v2/print/rev4/RoboCore_V2_Arm.3mf
mechanical/robot_v2/print/rev4/RoboCore_V2_Arm.stl
mechanical/robot_v2/print/rev4/RoboCore_V2_Arm_base.3mf
mechanical/robot_v2/print/rev4/RoboCore_V2_Arm_base.stl
mechanical/robot_v2/print/rev4/RoboCore_V2_Battery_door.3mf
mechanical/robot_v2/print/rev4/RoboCore_V2_Battery_door.stl
mechanical/robot_v2/print/rev4/RoboCore_V2_Bus_clip.3mf
mechanical/robot_v2/print/rev4/RoboCore_V2_Bus_clip.stl
mechanical/robot_v2/print/rev4/RoboCore_V2_Chassis.3mf
mechanical/robot_v2/print/rev4/RoboCore_V2_Chassis.stl
mechanical/robot_v2/print/rev4/RoboCore_V2_Jaw_L_driven.3mf
mechanical/robot_v2/print/rev4/RoboCore_V2_Jaw_L_driven.stl
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
