Plastal-Bot-Builders/RoboCoreDocumentation/design/event_branding/review/kit_7_Section_Print_specs.png

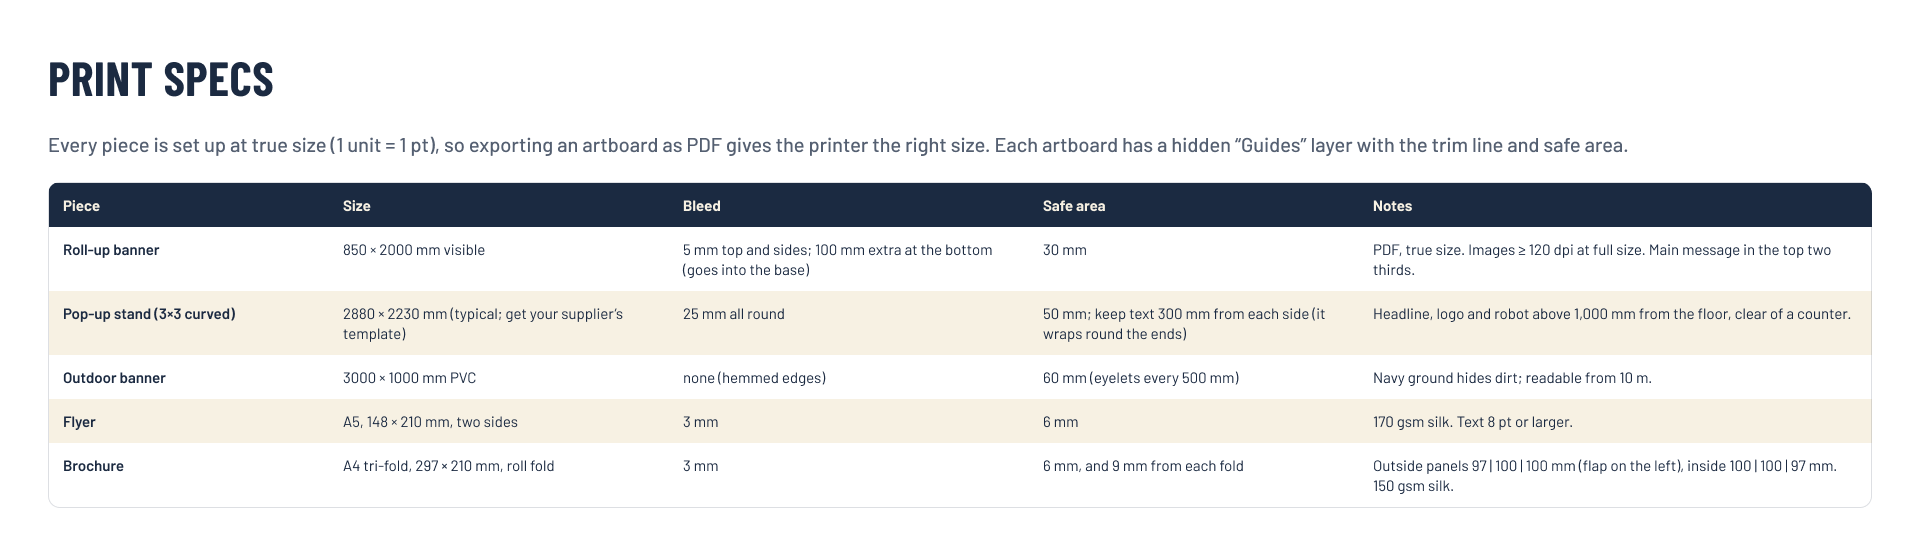
design/event_branding/review/kit_7_Section_Print_specs.png
