Plastal-Bot-Builders/RoboCoreDocumentation/design/event_branding/3d/test/L0.3/robot_iso_fl.png

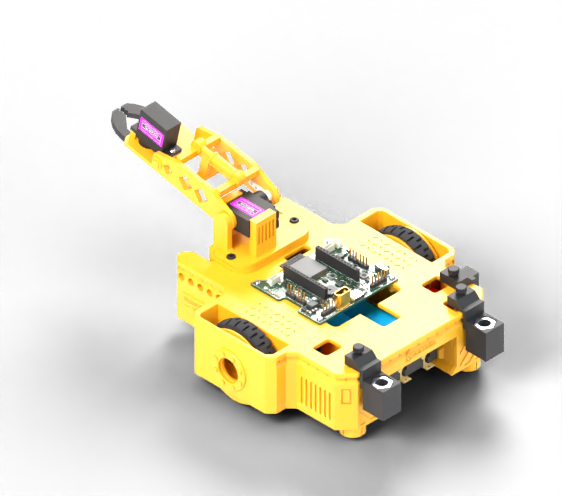
design/event_branding/3d/test/L0.3/robot_iso_fl.png
