Plastal-Bot-Builders/RoboCoreDocumentation/design/event_branding/3d/test/robot_front.png

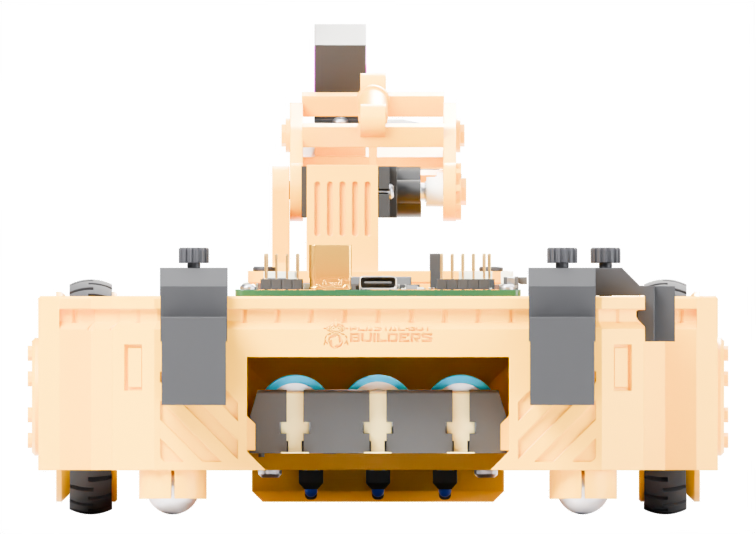
design/event_branding/3d/test/robot_front.png
