Plastal-Bot-Builders/RoboCoreDocumentation/design/event_branding/3d/test/robot_left.png

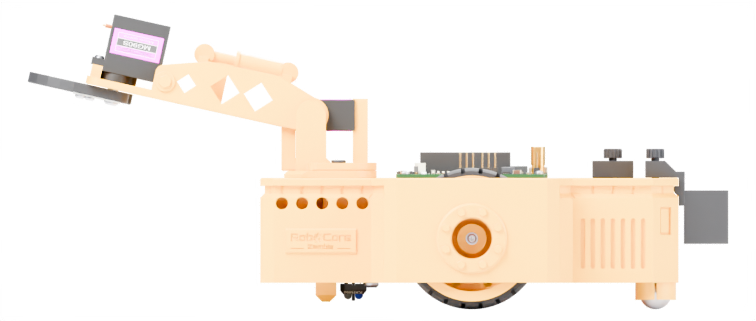
design/event_branding/3d/test/robot_left.png
