Plastal-Bot-Builders/RoboCoreDocumentation/design/event_branding/3d/test/robot_top.png

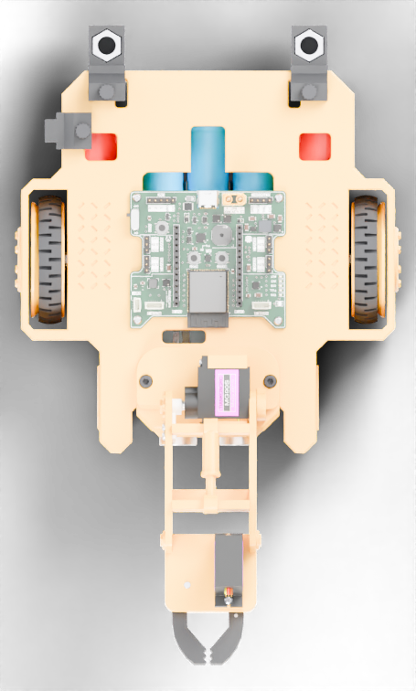
design/event_branding/3d/test/robot_top.png
