Plastal-Bot-Builders/RoboCoreDocumentation/design/event_branding/3d/test/v2/box_closed_front.png

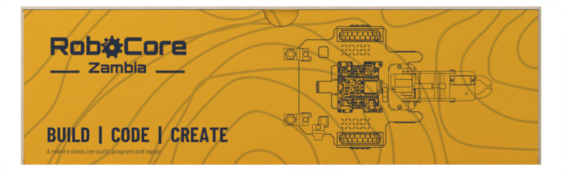
design/event_branding/3d/test/v2/box_closed_front.png
