Plastal-Bot-Builders/RoboCoreDocumentation/design/event_branding/3d/test/v2/box_open_iso_fl.png

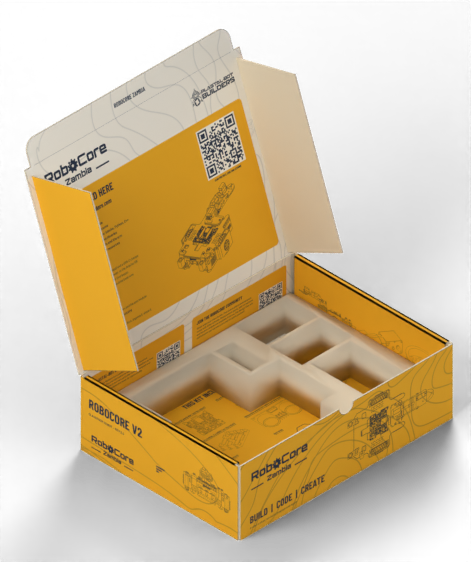
design/event_branding/3d/test/v2/box_open_iso_fl.png
