Plastal-Bot-Builders/RoboCoreDocumentation/docs/posters/RoboCore_posters_A4.pdf

### R O B O C O R E · V 2 C O N T R O L L E R

# RoboCore V2 · robot controller, rev 2.0

1 / 30
RoboCore Zambia · technical reference 2026-10-09

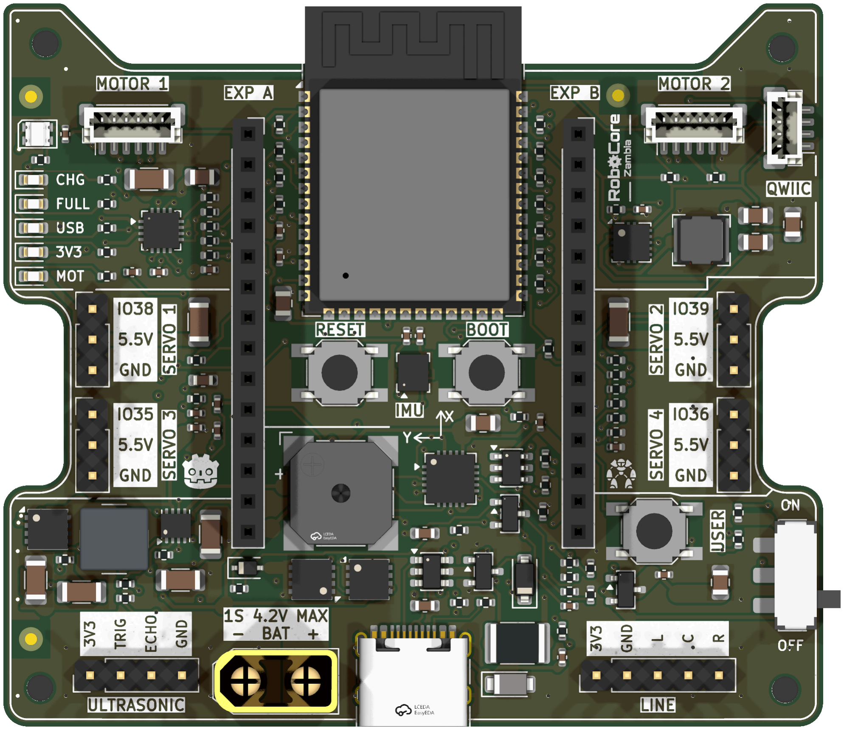
[picture p144: figure]

Top side — all SMD parts are on top; white knockout boxes carry the pin names of every header (servos, ultrasonic, line follower, battery)

### AT A GLANCE

Board | 68 × 60 × 1.6 mm, 4 layers, ENIG, green mask / white silk
Brain | ESP32-S3 (dual-core 240 MHz, 8 MB flash, 2 MB PSRAM)
Drives | 2 DC motors with encoders, 4 servos, buzzer, RGB LED
Senses | IMU, 3-channel line follower, ultrasonic, battery voltage, motor current
Power | 1S Li-ion pack (XT30), USB-C charging, 3.3 V + 5.5 V rails
Mounting | 4 × M2 holes (2.2 mm), side notches for the servo cables
Design | Open-STEM XRP-compatible pinout, drawn from scratch in KiCad 10

### MAIN PARTS

Function | Part | Note
MCU | ESP32-S3-WROOM-1- N8R2 | Wi-Fi + BLE, native USB (one-click upload). Alternates N16R2, N8; never R8/R16V (octal PSRAM takes IO35–37)
Motor driver | TI DRV8411A (WQFN-16) | Both motors, 4 A peak; current limit 1.0 A (JST-SH contact rating)
Motor connectors | JST SH 6-pin ×2 | XRP motor plug: M+, M−, 3.3 V, Enc A, Enc B, GND
IMU | ST LSM6DSOX (LGA-14) | 6-axis; mounted at the board centre, over the wheel axle. Alternate LSM6DSO32
3.3 V rail | TI TPS63001 buck-boost | Up to ~1.2 A from a 1S cell, holds 3.3 V down to a flat cell
Motor / servo rail | TI TPS61089 boost → 5.5 V | SG90-type servos stay inside 4.8–6 V; Q102 P-FET cuts the boost when OFF
Charger | MCP73871 (USB-C) | 1 A charge, power-path; charging works with the switch off. JP101 selects 1.65 A / 500 mA
Battery input | XT30 + reverse/over- voltage cut-off | 1S Li-ion only (3.0–4.2 V). Q103/Q104 + TPS3700 survive a reversed or 2S/3S pack
Power switch | C&K JS102011 slide switch | Right edge; grounds the P-FET gates. OFF draws ~0.03 mA
USB-C | HRO TYPE-C-31-M-12 + ESD | Charging and programming
Lights | WS2812B-2020-V6 RGB + 5 status LEDs | CHG, FULL, USB, 3V3, MOT
Sound / buttons | CMT-8504 buzzer; RESET, BOOT, USER | PWM tones; USER on IO42
Ports | Qwiic (I2C), 2 × 14-pin expansion | 3.3 V, VMOT, switched battery, spare GPIOs, UART, I2C
RoboCore_V2.kicad_pcb (2026-10-08) · render: kicad-cli pcb render · docs/RoboCore_V2_spec.md | A4 landscape · print at 100 % (no scaling)

### R O B O C O R E · V 2 C O N T R O L L E R

# Connectors and pinout

2 / 30

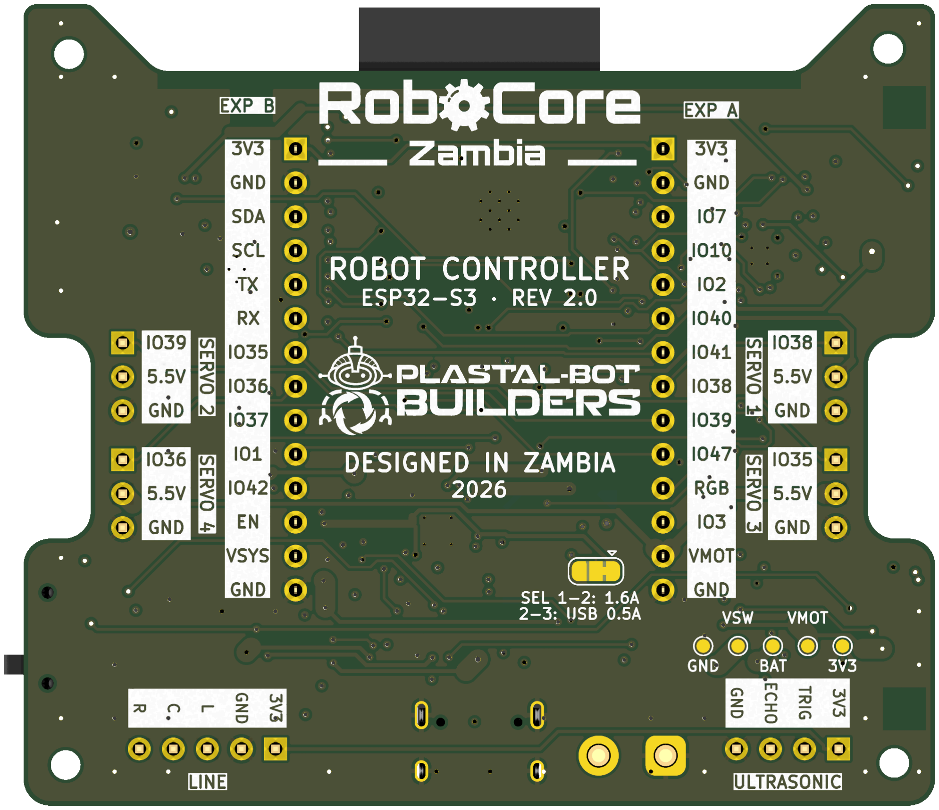
[picture p145: figure]

Bottom side — artwork, test pads, charge-current jumper JP101 and the pin names of both expansion headers

IR inputs use ADC1, which keeps working with Wi-Fi on. IMU axes: +X towards the top edge, +Y towards the left edge (firmware remaps).

### CONNECTORS

Ref | Name | Type | Pins / notes
J301 / J302 | Motor 1 / 2 JST SH 6 M+, M−, 3V3, ENC A, ENC B,
| | | GND (XRP order)
J401 J407 / J402 J408 | Servo 1 3 / 2 4 | 2.54 mm 1×3 ×4 | Signal, 5.5 V, GND — 1 + 3 on the left notch, 2 + 4 on the right
J403 | Ultrasonic | 2.54 mm 1×4 | 3V3, TRIG, ECHO, GND (HC- SR04 order: straight cable). 3.3 V module (HC-SR04+, RCWL- 1601)
J404 | Line follower | 2.54 mm 1×5 | 3V3, GND, L, C, R — 3-channel TCRT5000-type module, analog outputs
J405 / J406 | Expansion A / B | 1×14 female ×2 | See the pin order table
J201 | Qwiic | JST SH 4 | GND, 3V3, SDA, SCL
J102 | Battery | XT30 | 1S Li-ion only, 4.2 V max; 1S2P/3P/4P packs need no change
J101 | USB-C | 16-pin | Charging + programming
JP101 | Charge current
solder
jumper
(back)

1-2 adapter 1.65 A (default), 2-3 USB 500 mA

TP101–105 | Test pads (back) | 3V3, BAT, GND and rails

### ESP32-S3 GPIO MAP

GPIO | Signal
IO0 | BOOT button
IO1 | IMU INT1
IO2 | IR right (ADC)
IO3 | Expansion (strapping pin)
IO4 | Battery voltage (ADC, ÷2)
IO5 / IO6 | Motor 1 / 2 current sense (ADC)
IO7 | IR left (ADC)
IO8 / IO9 | I2C SDA / SCL (IMU, Qwiic)
IO10 | IR centre (ADC)
IO11 / IO12 | Motor 1 IN1 / IN2
IO13 / IO14 | Motor 2 IN1 / IN2
IO15 / IO16 | Encoder 1 A / B

### EXPANSION HEADERS (PIN 1 AT THE TOP)

Pin | J405 EXPANSION A | J406 EXPANSION B
1 | 3.3 V | 3.3 V
2 | GND | GND
3 | IR left (IO7) | I2C SDA (IO8)
4 | IR centre (IO10) | I2C SCL (IO9)
5 | IR right (IO2) | UART TX (IO43)
6 | Ultrasonic TRIG (IO40) | UART RX (IO44)
7 | Ultrasonic ECHO (IO41) | Servo 3 (IO35)
8 | Servo 1 (IO38) | Servo 4 (IO36)
9 | Servo 2 (IO39) | IO37
10 | Buzzer (IO47) | IMU INT1 (IO1)
11 | RGB LED data out | USER button (IO42)
12 | IO3 | EN (reset)
13 | VMOT 5.5 V | VSYS_SW (switched battery)
14 | GND | GND

### GPIO MAP (CONTINUED)

GPIO | Signal
IO17 / IO18 | Encoder 2 A / B
IO19 / IO20 | USB D− / D+
IO21 | Motor driver nFAULT
IO35 / IO36 | Servo 3 / 4
IO37 | Expansion B
IO38 / IO39 | Servo 1 / 2
IO40 / IO41 | Ultrasonic TRIG / ECHO
IO42 | USER button
IO43 / IO44 | UART TX / RX → expansion
IO47 | Buzzer (PWM)
IO48 | WS2812 RGB LED
IO45 / IO46 | strapping pins, unused
docs/RoboCore_V2_spec.md · tools/spec_v2.py | A4 landscape · print at 100 % (no scaling)

# 3D views

3 / 30

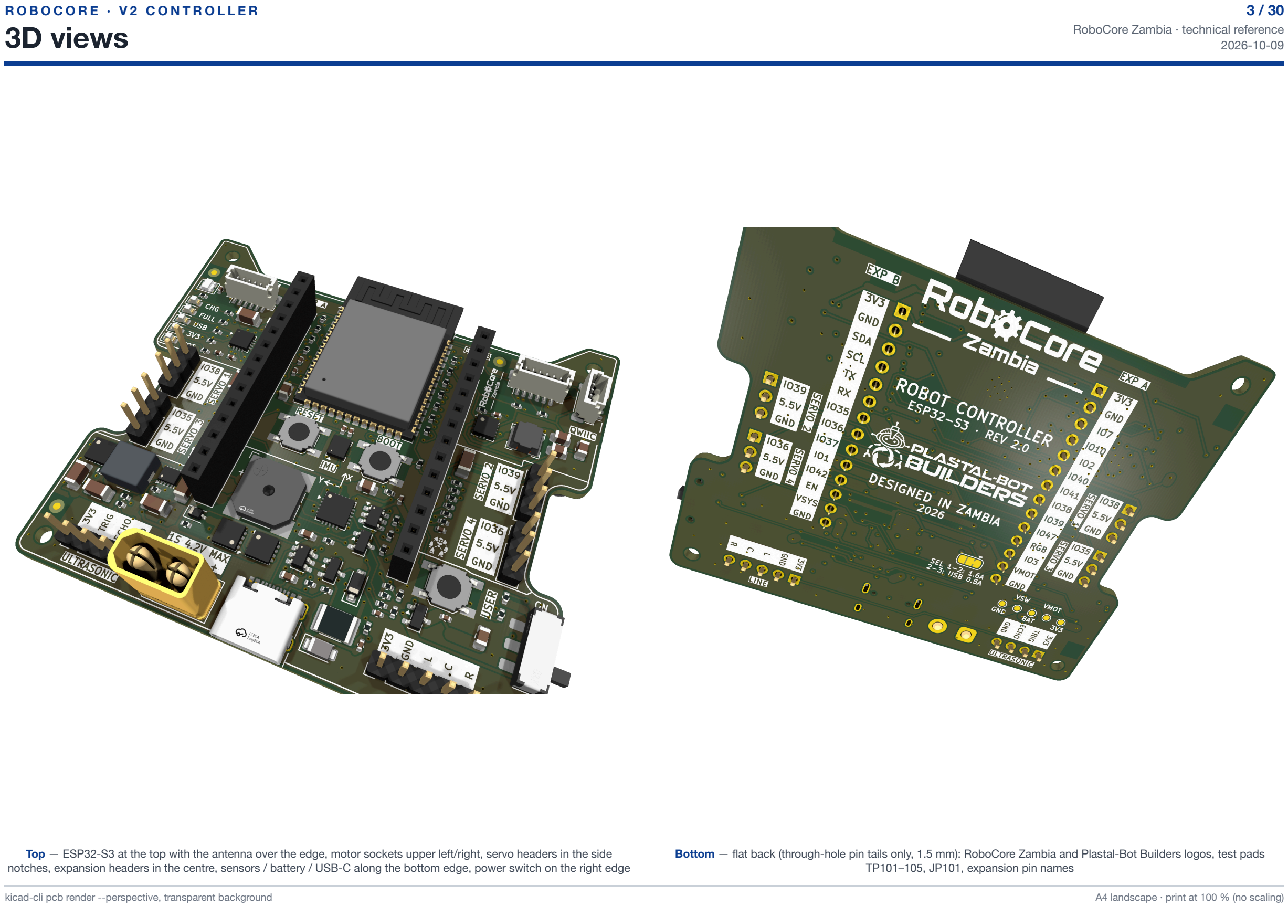
[picture p146: page 3]

### R O B O C O R E · V 2 C O N T R O L L E R

Top — ESP32-S3 at the top with the antenna over the edge, motor sockets upper left/right, servo headers in the side notches, expansion headers in the centre, sensors / battery / USB-C along the bottom edge, power switch on the right edge

Bottom — flat back (through-hole pin tails only, 1.5 mm): RoboCore Zambia and Plastal-Bot Builders logos, test pads TP101–105, JP101, expansion pin names

kicad-cli pcb render --perspective, transparent background | A4 landscape · print at 100 % (no scaling)

### R O B O C O R E · V 2 C O N T R O L L E R

# Copper layers · 1 : 1 plots

4 / 30

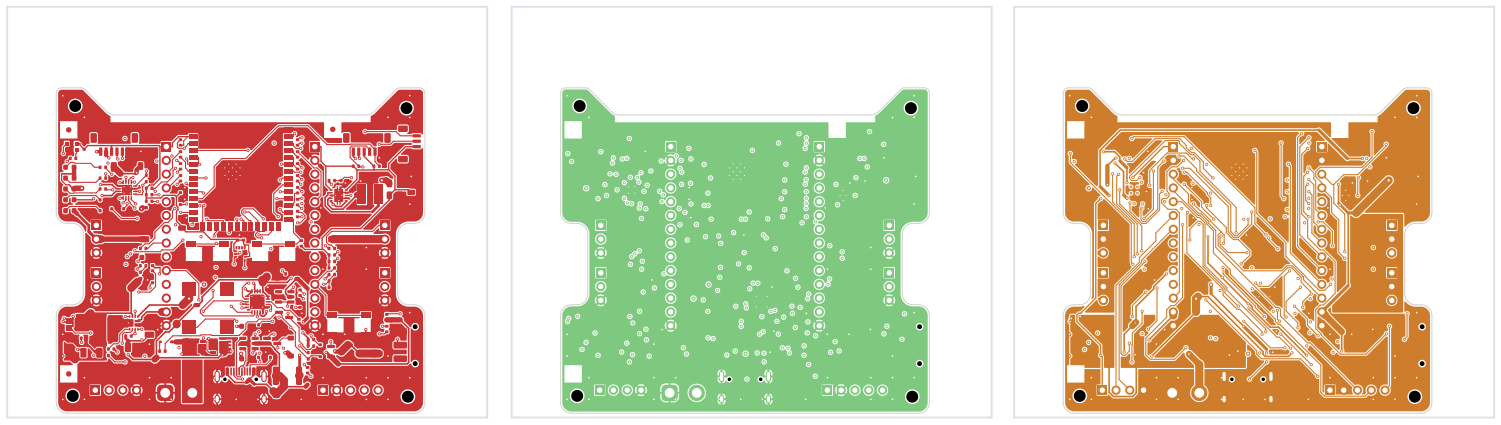
[picture p147: figure]

F.Cu — top signal layer | In1.Cu — inner 1, power / ground pours | In2.Cu — inner 2, signal and battery tracks | B.Cu — bottom signal layer

F.SilkS — front silkscreen

### STACK-UP AND RULES

Item | Value
Layers | 4: F.Cu · In1.Cu · In2.Cu · B.Cu, 1 oz copper outer and inner
Material | FR-4 S1000H TG150, 1.6 mm, green mask, white silkscreen, ENIG
Track / space | 0.2 mm signals (6 / 6 mil rules); fat tracks for VMOT and the battery
Vias | 0.3 mm hole / 0.6 mm ring, tented; 0.2 mm thermal vias in the IC pads (no resin fill)
Mask | no solder-mask web on the 0.15 mm gaps of U202 (LGA-14, 0.5 mm pitch)
Holes | 4 × 2.2 mm non-plated (M2); side notches 5 mm deep for the servo cables
Artwork | front: knockout pin boxes beside every header, icons, dividers; back: logos and project text, 20 tented vias under it
Checks | DRC 0 errors, 0 unconnected; schematic parity clean (2026-10-08)

Plots are at 1 : 1 as seen from the top (the bottom layer is not mirrored). Made with kicad-cli pcb export svg.

RoboCore_V2.kicad_pcb · kicad-cli pcb export svg | A4 landscape · print at 100 % (no scaling)

# RoboCore V2 schematic · Root sheet scale 1.04

5 / 30

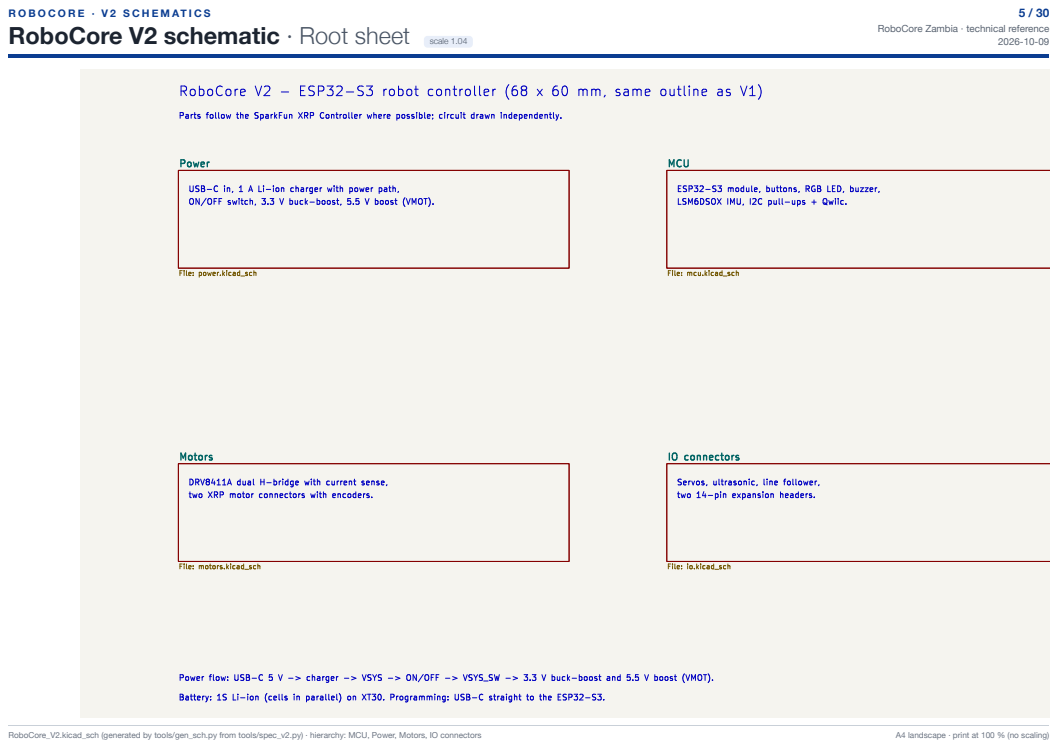
[picture p148: page 5]
RoboCore_V2.kicad_sch (generated by tools/gen_sch.py from tools/spec_v2.py) · hierarchy: MCU, Power, Motors, IO connectors; A4 landscape · print at 100 % (no scaling)

# RoboCore V2 schematic · MCU · part 1 of 2 (top) scale 0.95

6 / 30

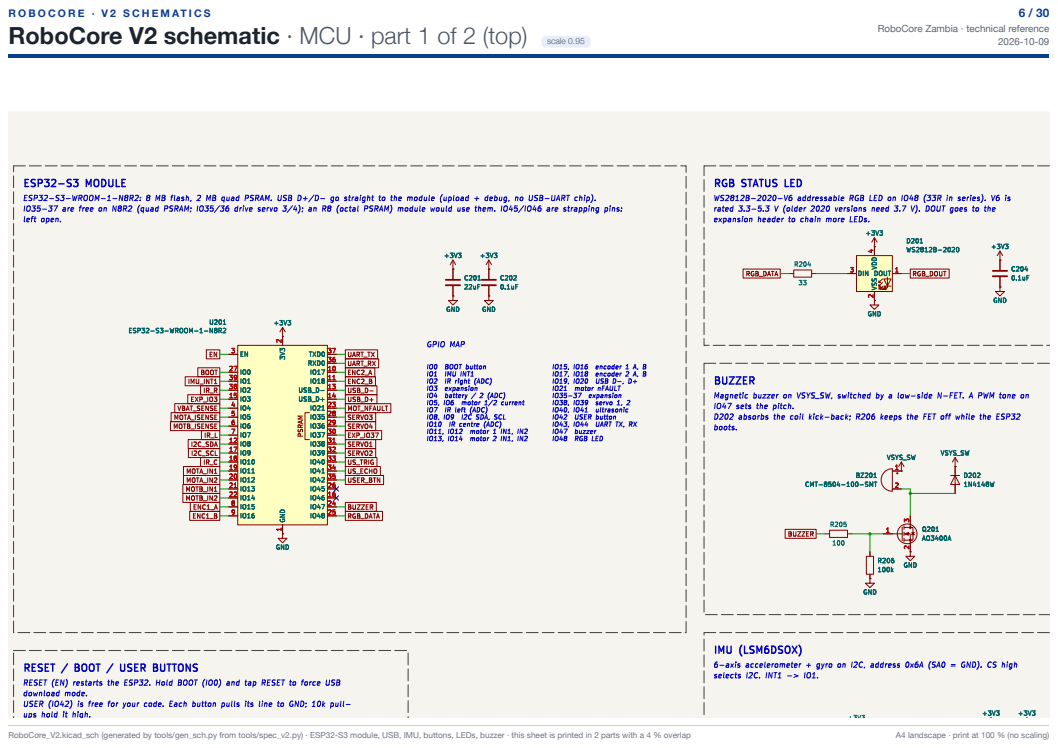
[picture p149: page 6]
RoboCore_V2.kicad_sch (generated by tools/gen_sch.py from tools/spec_v2.py) · ESP32-S3 module, USB, IMU, buttons, LEDs, buzzer · this sheet is printed in 2 parts with a 4 % overlap; A4 landscape · print at 100 % (no scaling)

# RoboCore V2 schematic · MCU · part 2 of 2 (bottom) scale 0.95

7 / 30

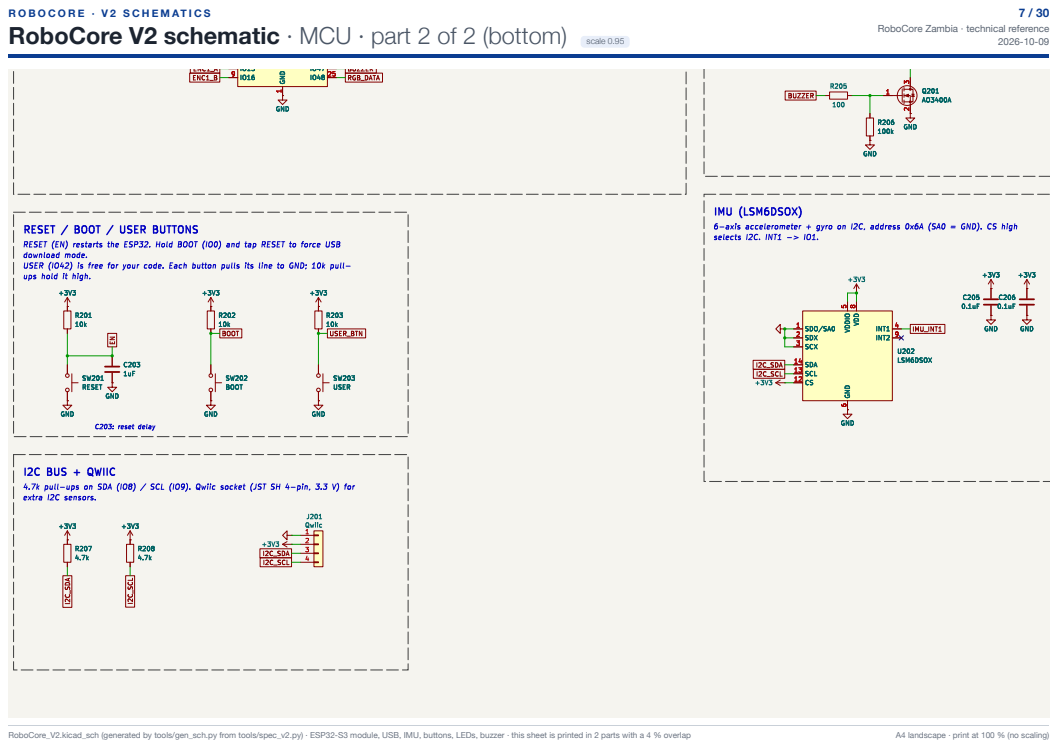
[picture p150: page 7]
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

# RoboCore V2 schematic · Power · part 1 of 4 (top left) scale 1.28

8 / 30

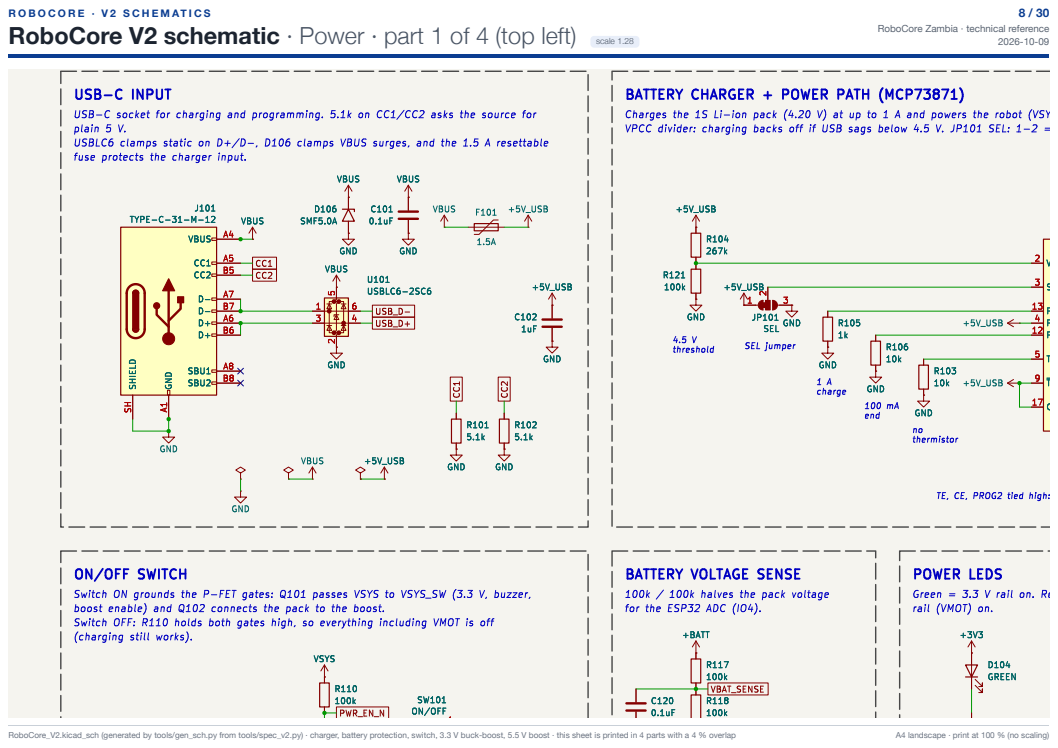
[picture p151: page 8]
RoboCore_V2.kicad_sch (generated by tools/gen_sch.py from tools/spec_v2.py) · charger, battery protection, switch, 3.3 V buck-boost, 5.5 V boost · this sheet is printed in 4 parts with a 4 % overlap; A4 landscape · print at 100 % (no scaling)

# RoboCore V2 schematic · Power · part 2 of 4 (top right) scale 1.28

9 / 30

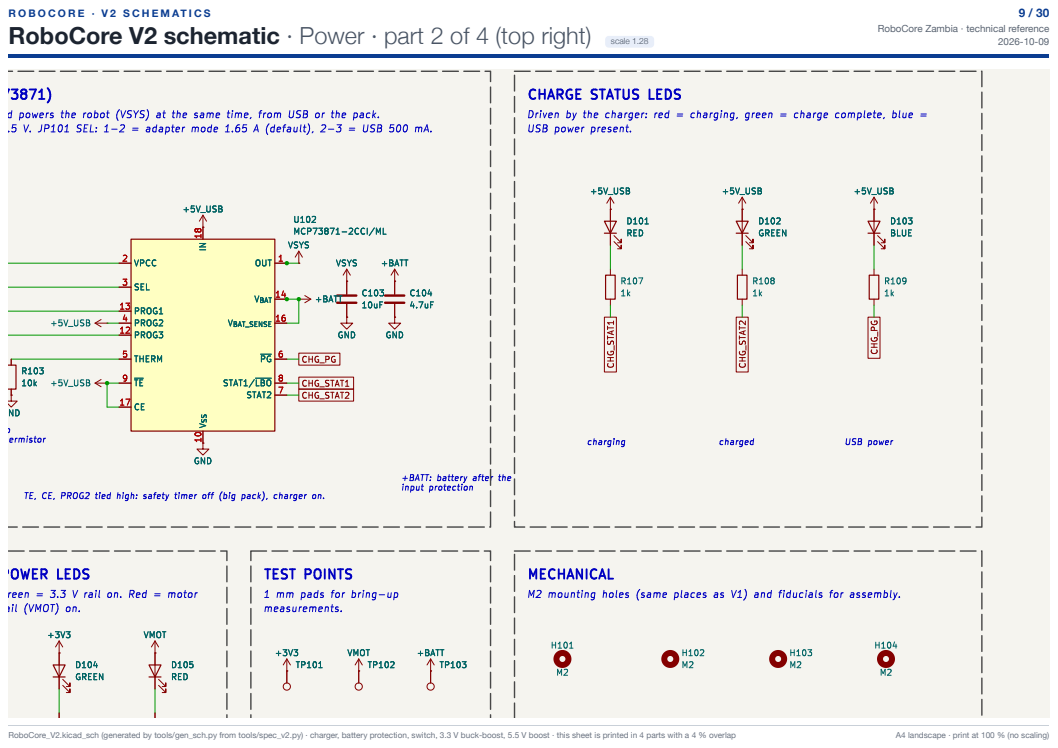
[picture p152: page 9]
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

# RoboCore V2 schematic · Power · part 3 of 4 (bottom left) scale 1.28

10 / 30

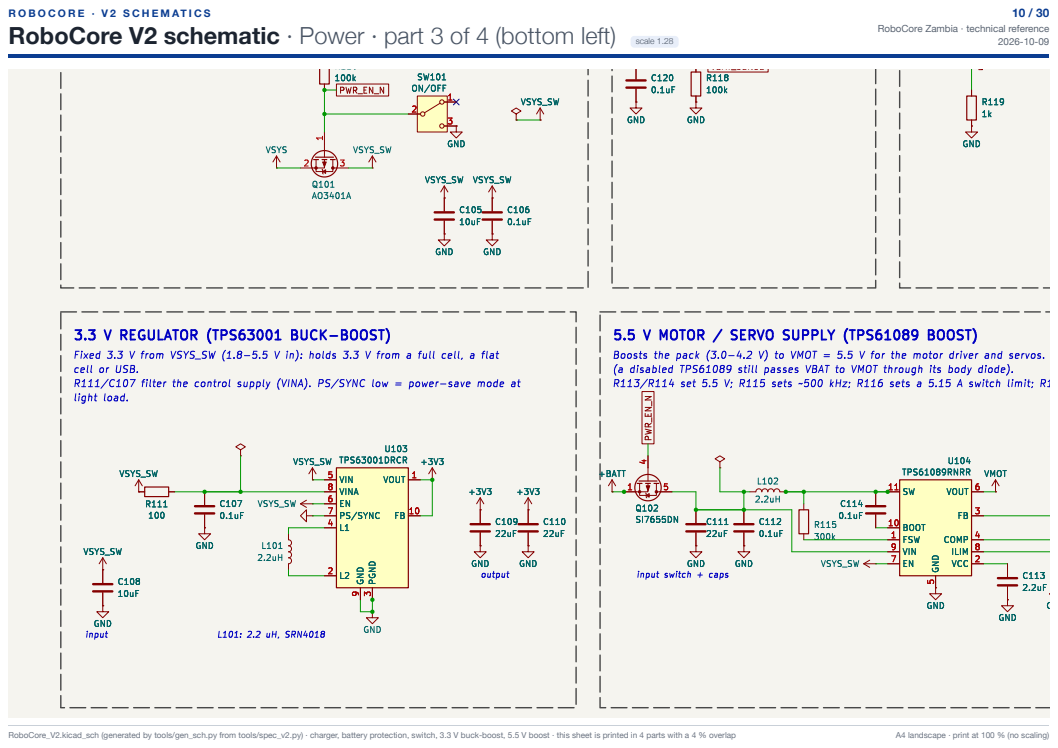
[picture p153: page 10]
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

# RoboCore V2 schematic · Power · part 4 of 4 (bottom right) scale 1.28

11 / 30

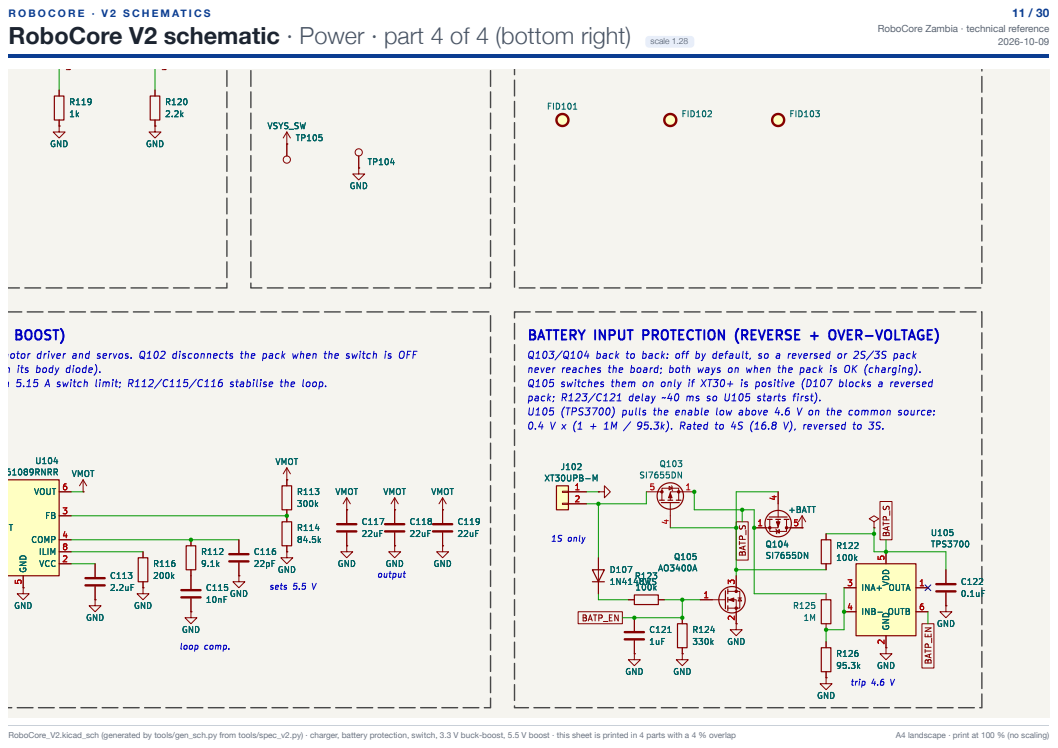
[picture p154: page 11]
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

# RoboCore V2 schematic · Motors scale 0.97

12 / 30

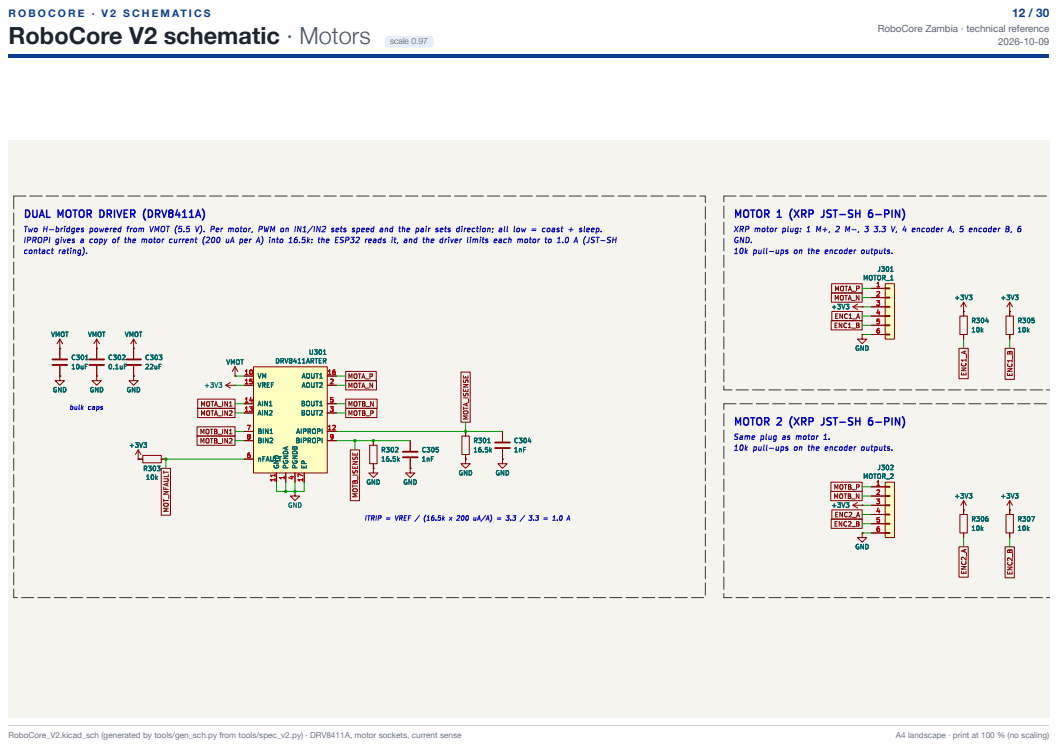
[picture p155: page 12]
RoboCore_V2.kicad_sch (generated by tools/gen_sch.py from tools/spec_v2.py) · DRV8411A, motor sockets, current sense; A4 landscape · print at 100 % (no scaling)

# RoboCore V2 schematic · IO connectors scale 0.82

13 / 30

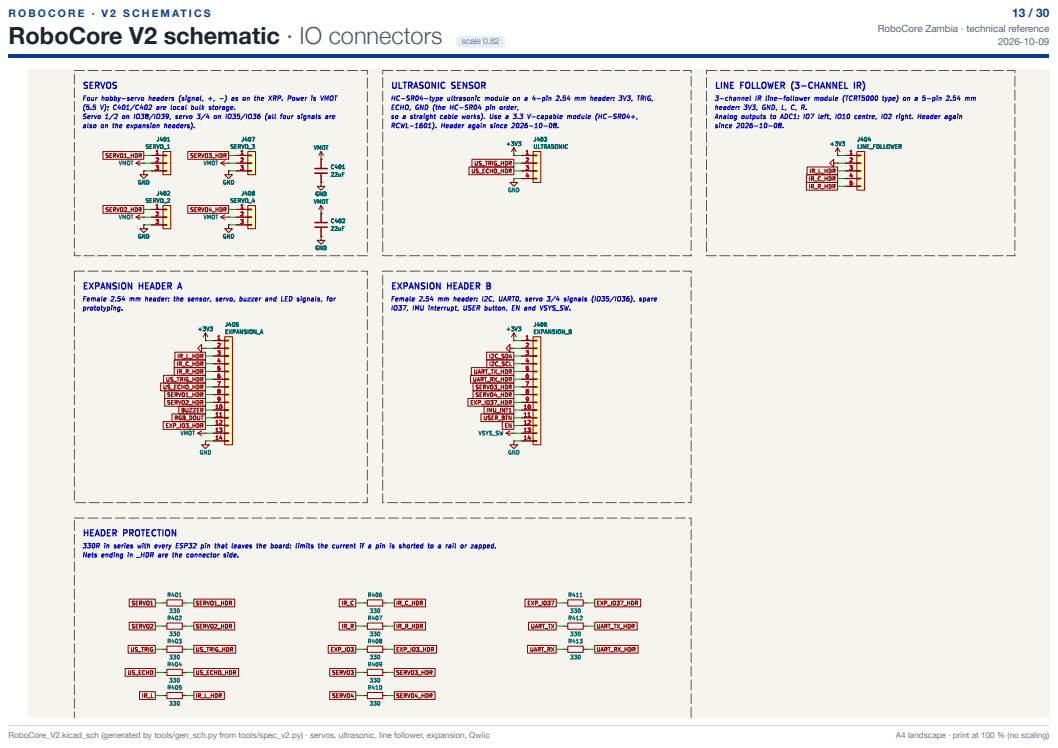
[picture p156: page 13]
RoboCore_V2.kicad_sch (generated by tools/gen_sch.py from tools/spec_v2.py) · servos, ultrasonic, line follower, expansion, Qwiic; A4 landscape · print at 100 % (no scaling)

### R O B O C O R E · S E N S O R B O A R D S

# Line sensor and ultrasonic · our own versions of the two bought-in modules

14 / 30

LINE SENSOR 60 × 24 MM, 2 LAYERS

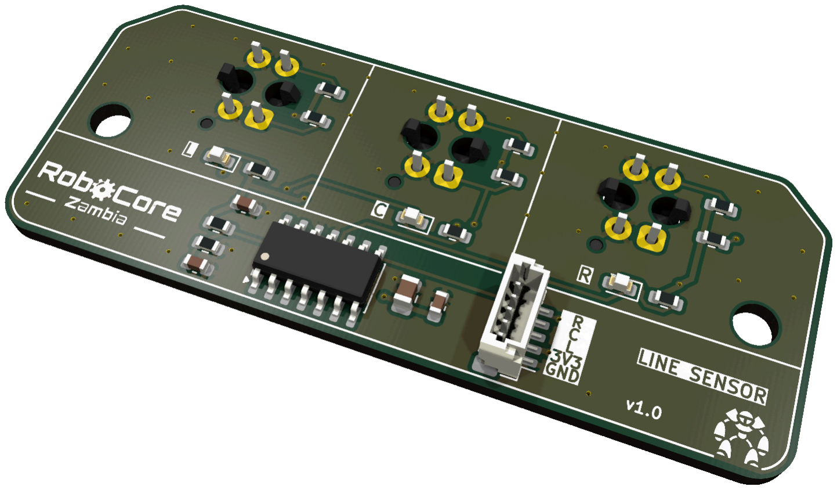
[picture p157: figure]

3 × TCRT5000 on the underside, LM339 comparator, 3 green indicator LEDs

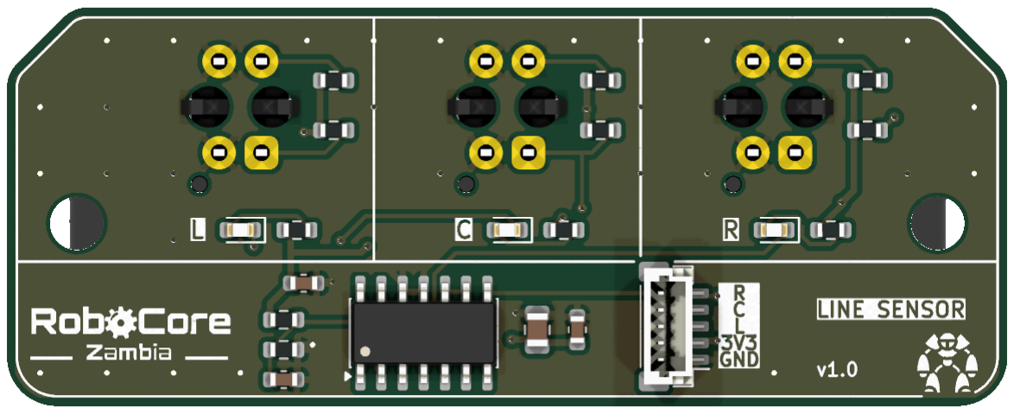
[picture p158: figure]
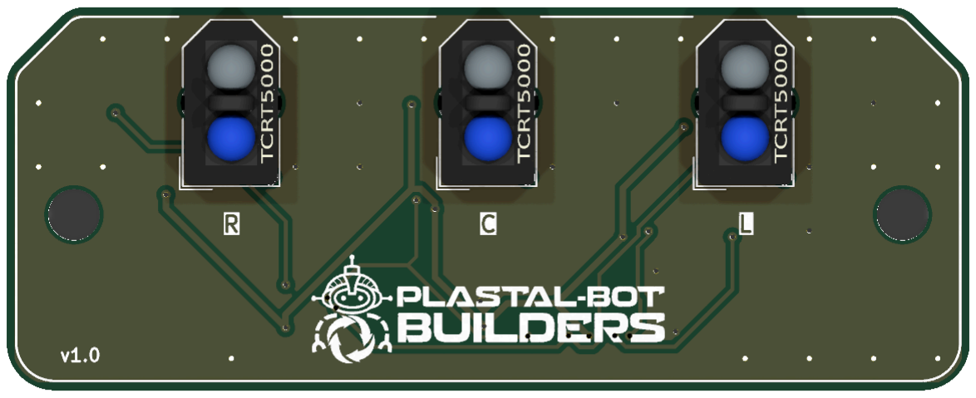
[picture p159: figure]

top | underside (mirrored silkscreen)
Item | Value
Connector | JST SH 5: GND, 3V3, L, C, R (analog, 0.3 V white … 2.8 V black)
Supply | 3.3 V, about 45 mA
Mounting | 2 × M3, 51.6 mm apart; underside 9–13 mm above the floor
Sensors | 16 mm apart, for 19 mm tape; LEDs show which channel sees the line
ULTRASONIC | 46 × 22 MM, 2 LAYERS (HC-SR04 SIZE)

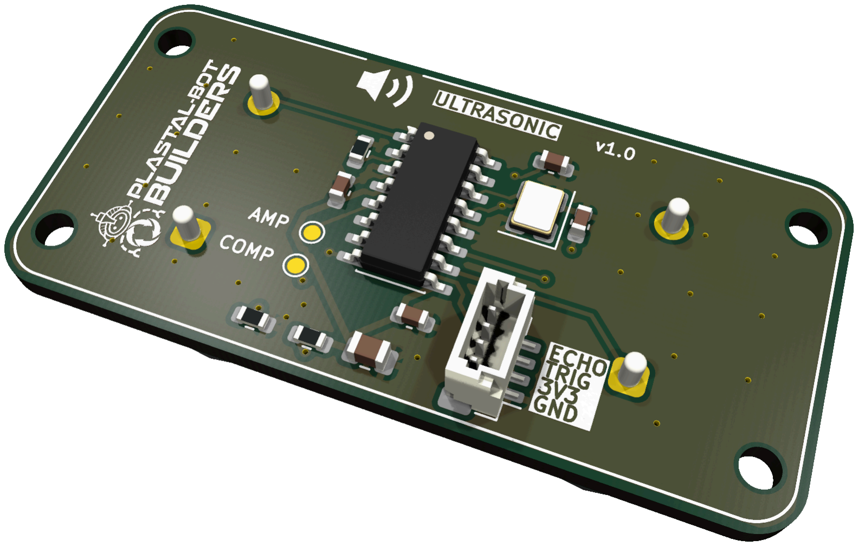
[picture p160: figure]

CS100A ranging chip, 8 MHz crystal, 40 kHz transmit + receive transducers

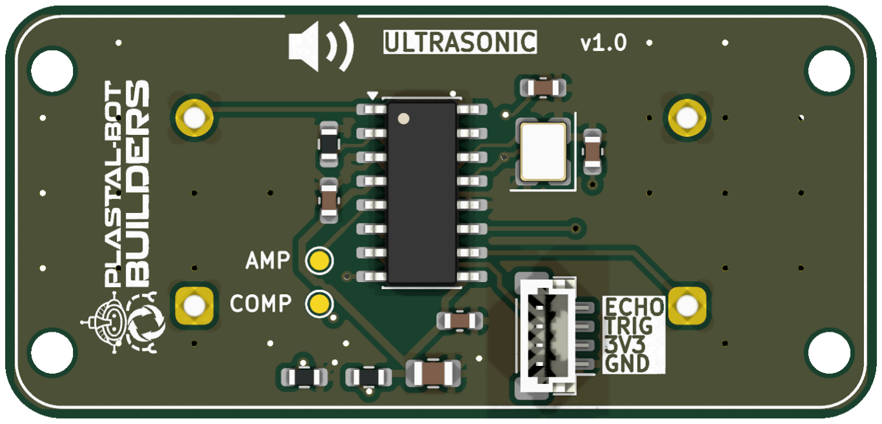
[picture p161: figure]
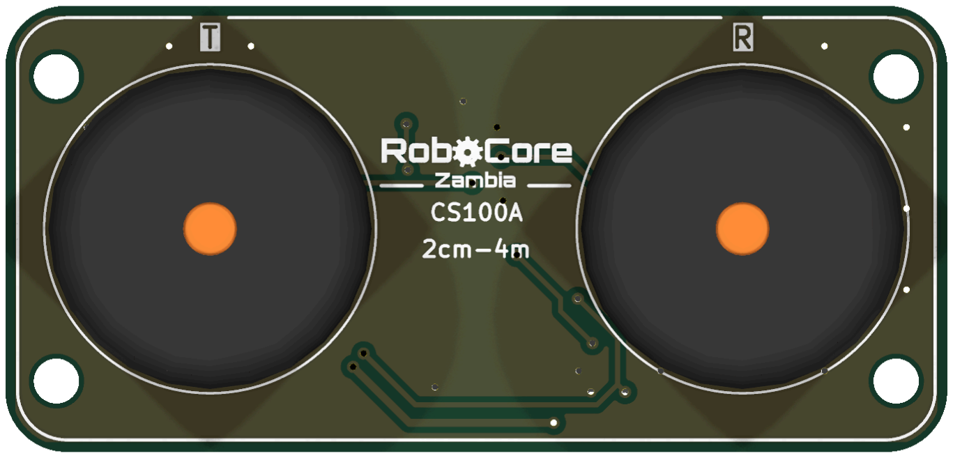
[picture p162: figure]

rear face: chip, crystal, connector | front face: transducers, T left / R right
Item | Value
Connector | JST SH 4: GND, 3V3, TRIG, ECHO (HC-SR04 timing: 58 µs per cm)
Supply | 3.3 V, 5.3 mA
Mounting | 4 × M2 at (±20.5, ±7.5) mm; ≥ 4–5 cm above the floor (70° beam)
Range | 2 cm to about 4 m; T left, R right seen from the front
sensors/line_sensor, sensors/ultrasonic · docs/RoboCore_Sensors.md · shelved 2026-10-08: the robot uses bought-in HC-SR04 / 3-channel modules on 2.54 mm headers for now | A4 landscape · print at 100 % (no scaling)

# Line sensor schematic · Line sensor scale 1.24

15 / 30

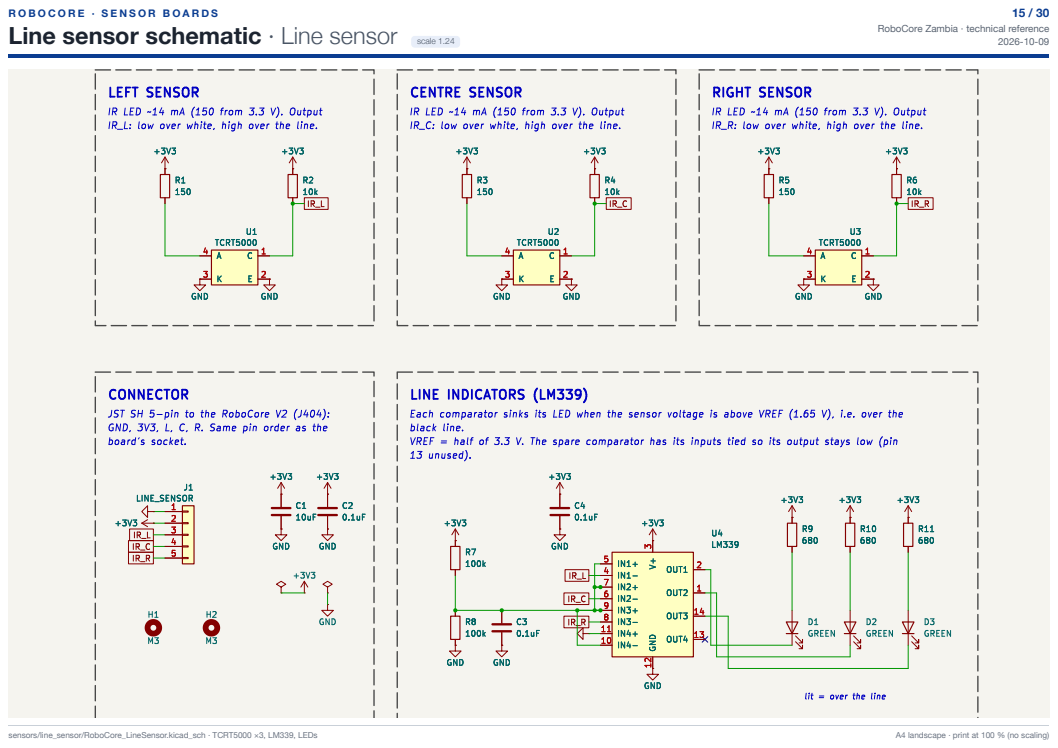
[picture p163: page 15]
sensors/line_sensor/RoboCore_LineSensor.kicad_sch · TCRT5000 ×3, LM339, LEDs; A4 landscape · print at 100 % (no scaling)

# Ultrasonic schematic · Ultrasonic scale 1.17

16 / 30

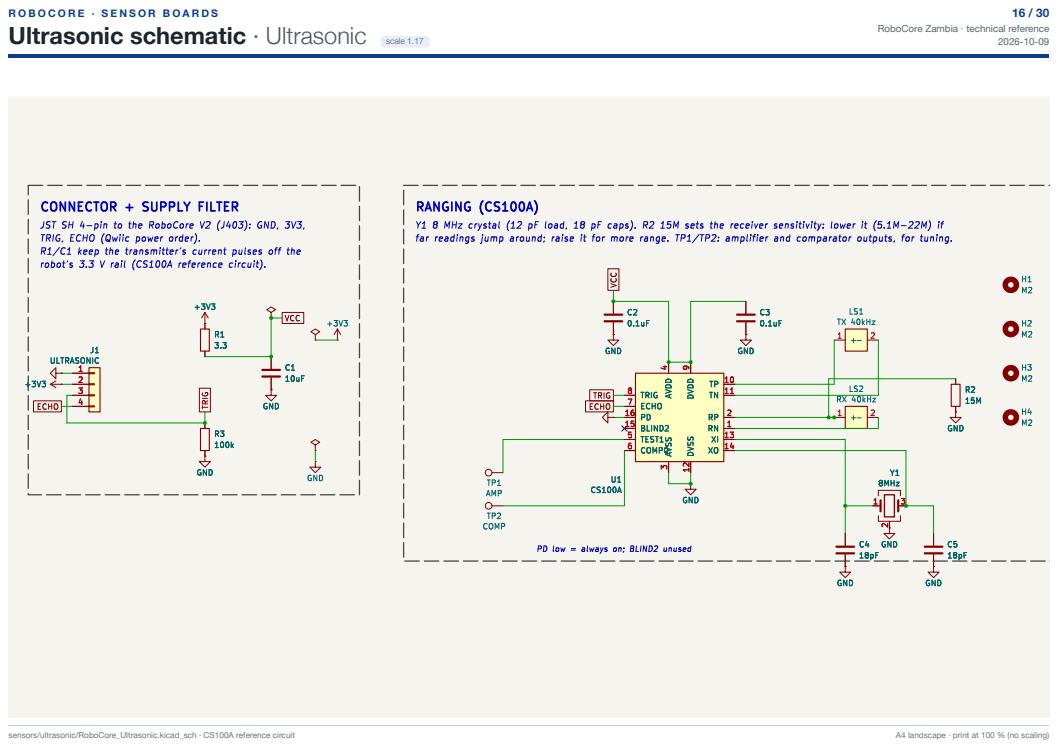
[picture p164: page 16]
sensors/ultrasonic/RoboCore_Ultrasonic.kicad_sch · CS100A reference circuit; A4 landscape · print at 100 % (no scaling)

### R O B O C O R E · R O B O T

# RoboCore V2 robot · chassis rev 5 (Fusion 360)

17 / 30

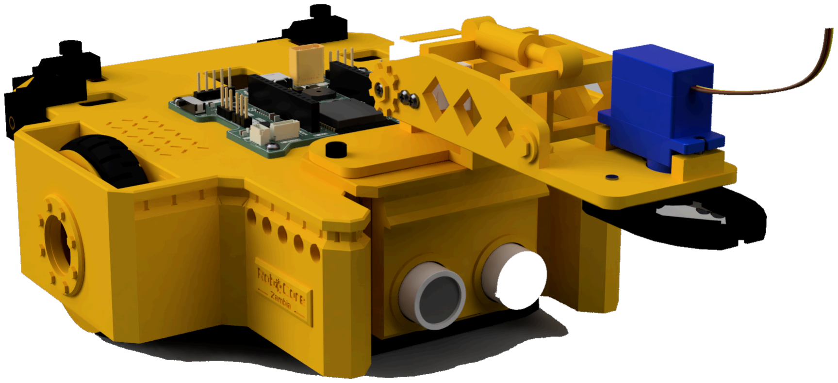
[picture p165: figure]

Rev 5 with the arm module — construction-yellow scheme. Deck-down print, no supports; motors snap in from below; battery slides in from the back

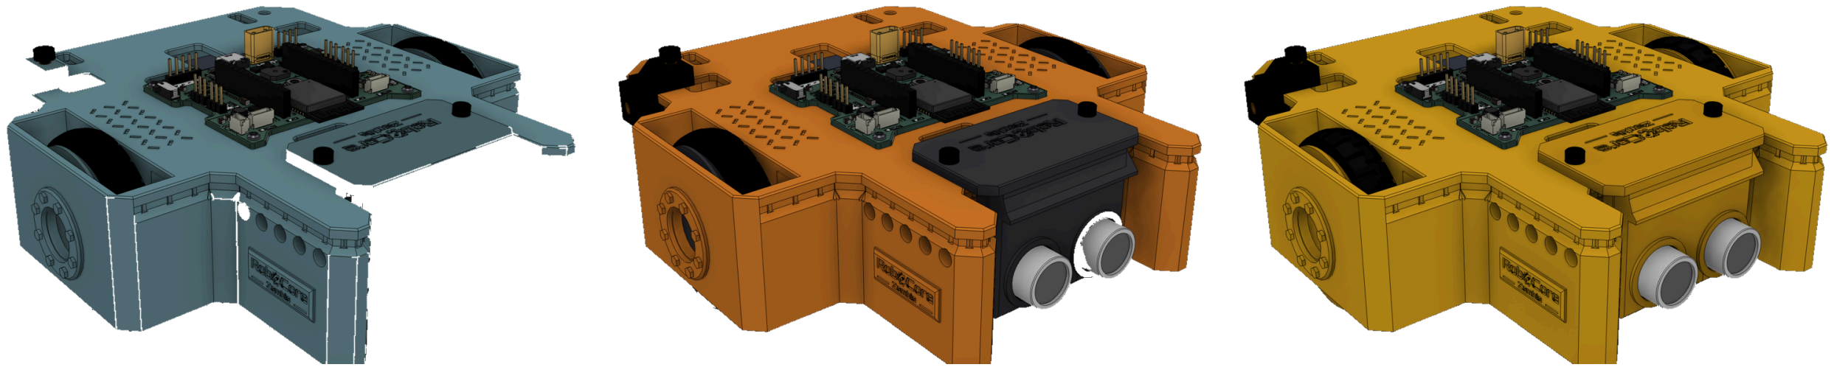
[picture p166: figure]

Colour schemes: teal, orange, construction yellow

### KEY NUMBERS

Item | Value
Body | 162 × 166 mm over the walls, 52 mm to the deck top; cross-shaped plan, every corner chamfered 45°
Drive | 2 × TT gear motors with encoders (6 V, 160 rpm), wheels clamp to the shaft; twin ½" ball casters at the rear
Board | RoboCore V2 on the deck, 4 × M2 heat-set inserts; IMU over the wheel axle
Battery | BatteryHolder3S, 3 × 18650 wired 1S3P, slides in from the back behind two snap flaps
Sensors | HC-SR04 in a headlight-style pod on the front dock; line-sensor sled under the nose (3 heights)
Arm | excavator-style boom, MG90S shoulder, SG90 gripper; bolts to the front dock with 2 × M3

Expansion flush bus groove with 54 detents, 10 Technic-pitch holes, M3 dock inserts, 8 mm grid Printing chassis deck-down with no supports, ≥ 20 % infill; every file in print/ is already oriented

### WHAT IT FIXES (VS. THE XRP)

Real tyres with 2 mm frame clearance, wheels screwed to the shaft, not press-fit
IMU directly over the axle and a rigid 4-screw board mount: no drift from flex
Li-ion pack with USB-C charging and reverse / over-voltage protection instead of AA cells Motors held by snap hooks and stops, swappable in minutes; screws + inserts where students take things apart
Antenna left in the open at the top edge
mech/robot/RoboCore_V2_Robot.f3d · renders by fusion/view.py · mech/robot/README.md | A4 landscape · print at 100 % (no scaling)

# Views · rev 5

18 / 30

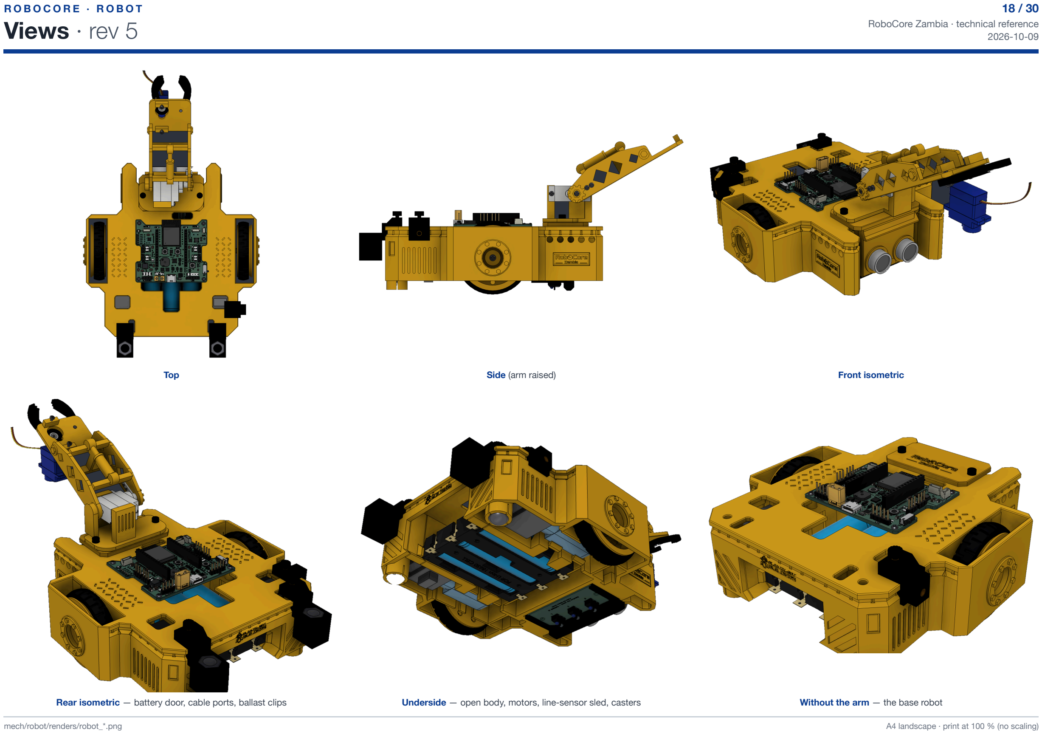
[picture p167: page 18]

### R O B O C O R E · R O B O T

Top | Side (arm raised) | Front isometric
Rear isometric — battery door, cable ports, ballast clips | Underside — open body, motors, line-sensor sled, casters | Without the arm — the base robot
mech/robot/renders/robot_*.png | | A4 landscape · print at 100 % (no scaling)

# Arm module · excavator-style

19 / 30

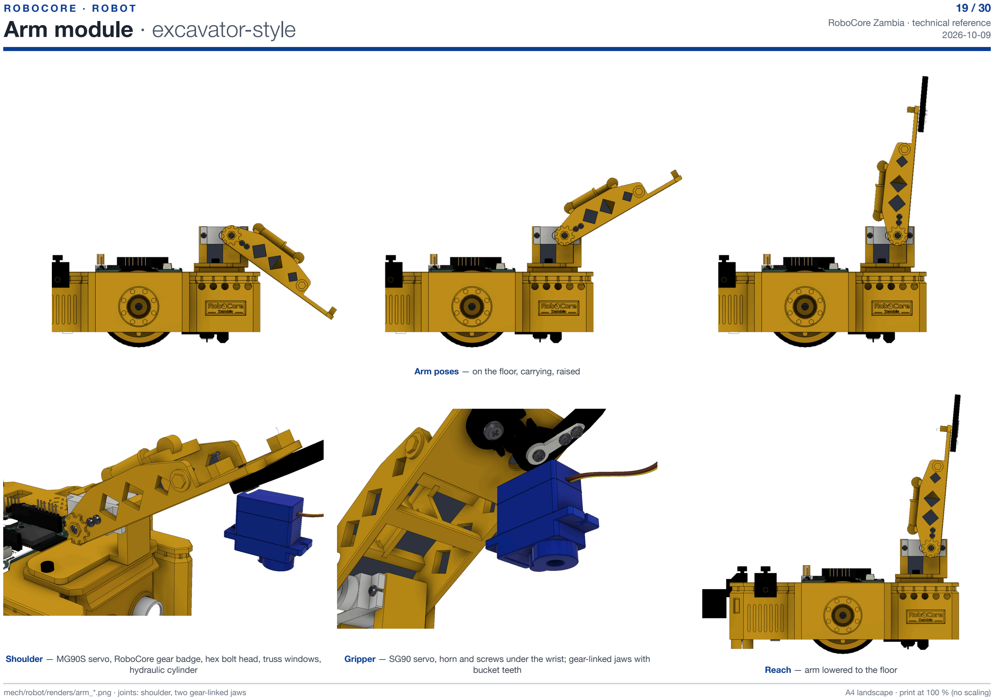
[picture p168: page 19]

### R O B O C O R E · R O B O T

Arm poses — on the floor, carrying, raised

Shoulder — MG90S servo, RoboCore gear badge, hex bolt head, truss windows, hydraulic cylinder

Gripper — SG90 servo, horn and screws under the wrist; gear-linked jaws with
bucket teeth | Reach — arm lowered to the floor
mech/robot/renders/arm_*.png · joints: shoulder, two gear-linked jaws | A4 landscape · print at 100 % (no scaling)

### R O B O C O R E · R O B O T

# Chassis details · rev 5

20 / 30

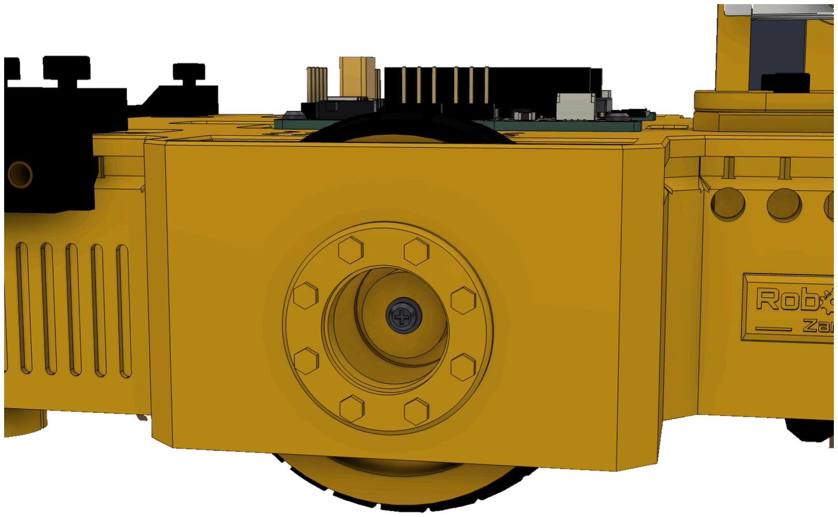
[picture p169: figure]

Wheel side — hub, fender arch, engine louvres, RoboCore badge, Ø16 access

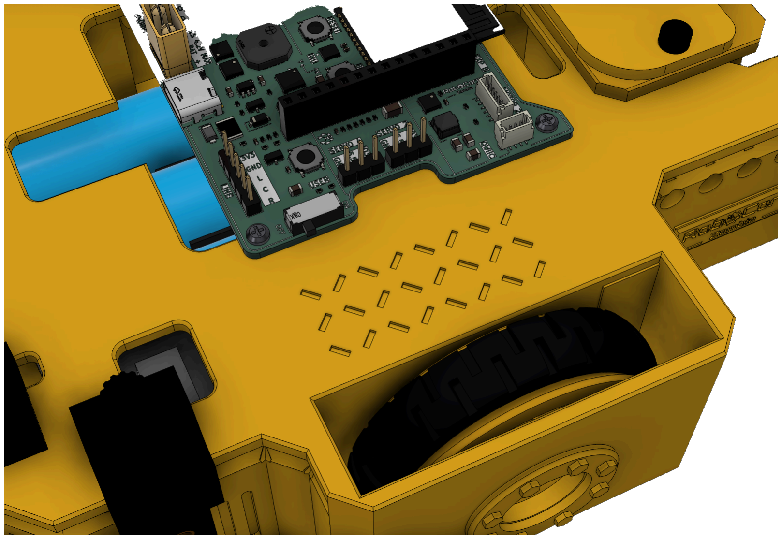
[picture p170: figure]
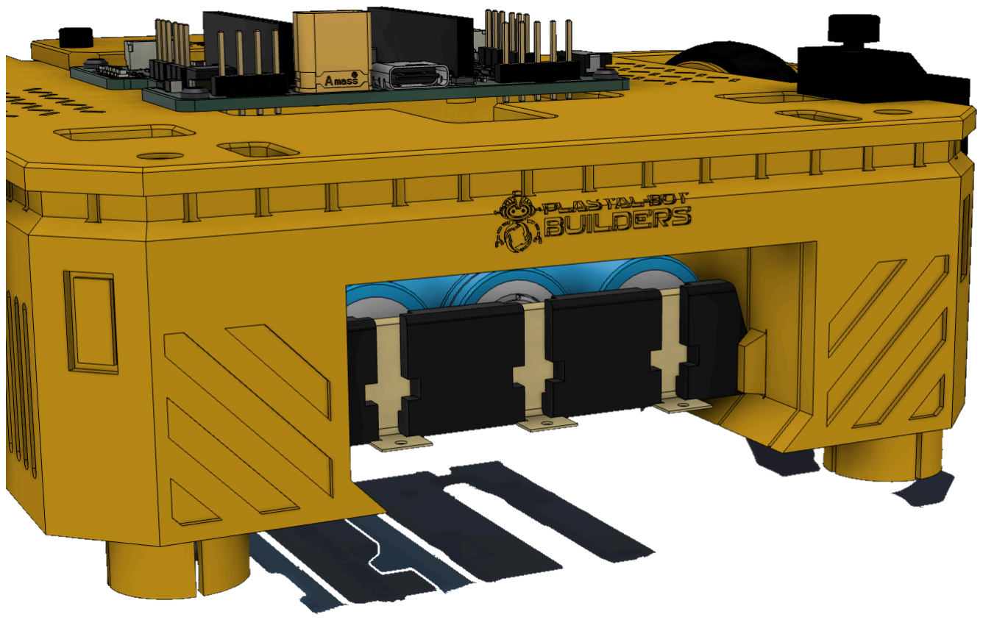
[picture p171: figure]

hole for the wheel screw | Rear — hazard chevrons, tail lights, battery opening with snap flaps, cable ports | Deck — tread-plate walkways, board window, plug slots

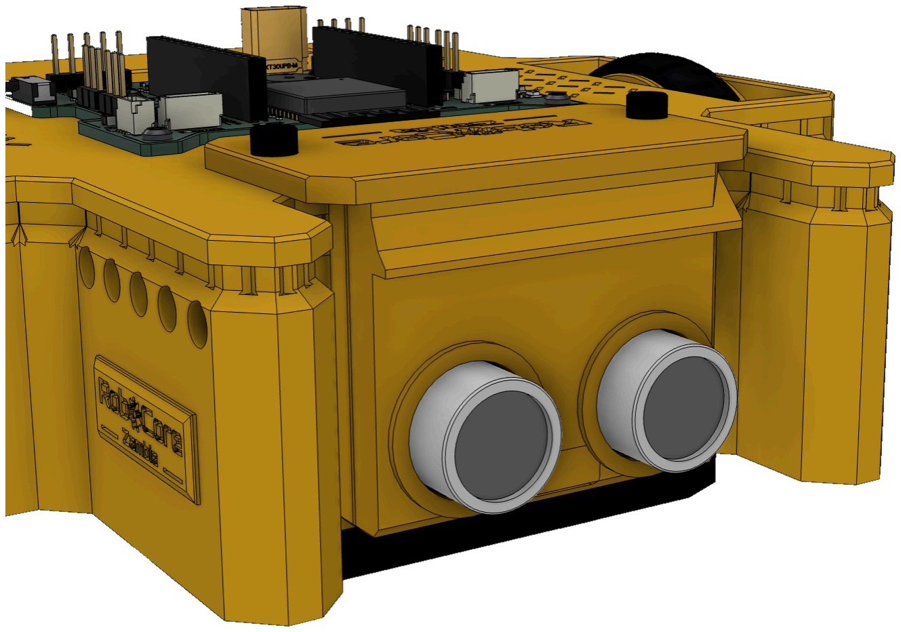
[picture p172: figure]

Sonar pod — headlight-style, on the dock plate; the HC-SR04 snaps in from the

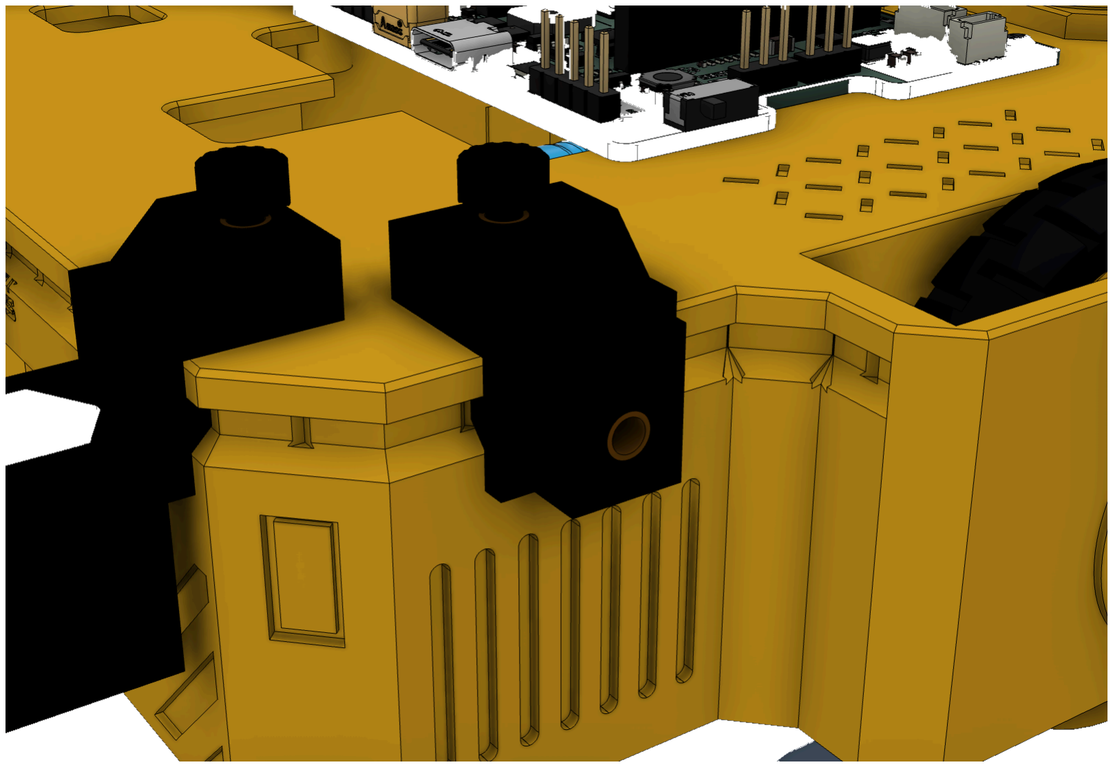
[picture p173: figure]
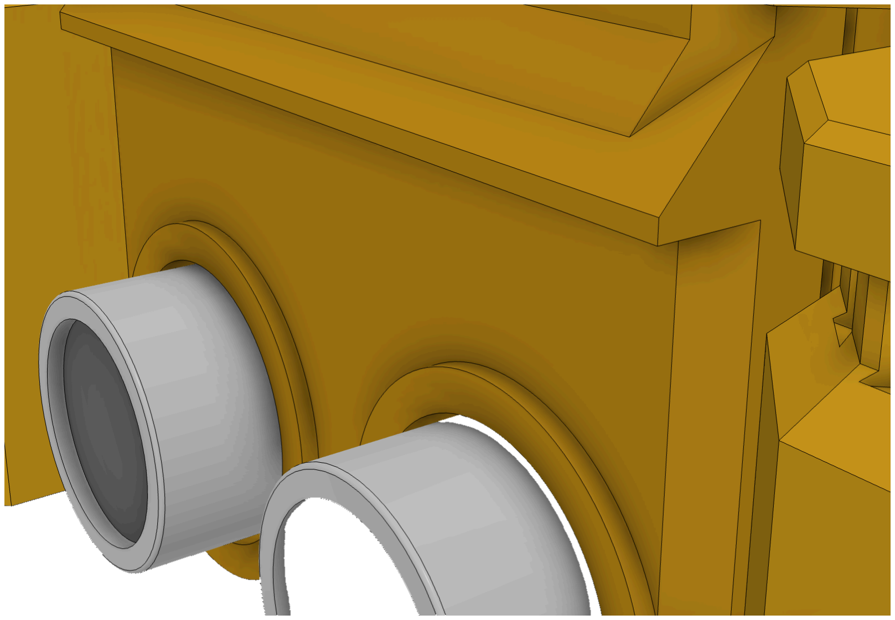
[picture p174: figure]

back | Sonar pod, rear — header up, Dupont plugs inside the pod Bus clip — tongue in the groove, thumb screw on the deck, M3 boss for
| accessories
mech/robot/renders/chassis_*.png, sonar_pod*.png, bus_clip.png | A4 landscape · print at 100 % (no scaling)

### R O B O C O R E · R O B O T

# Expansion bus · rev 5

21 / 30

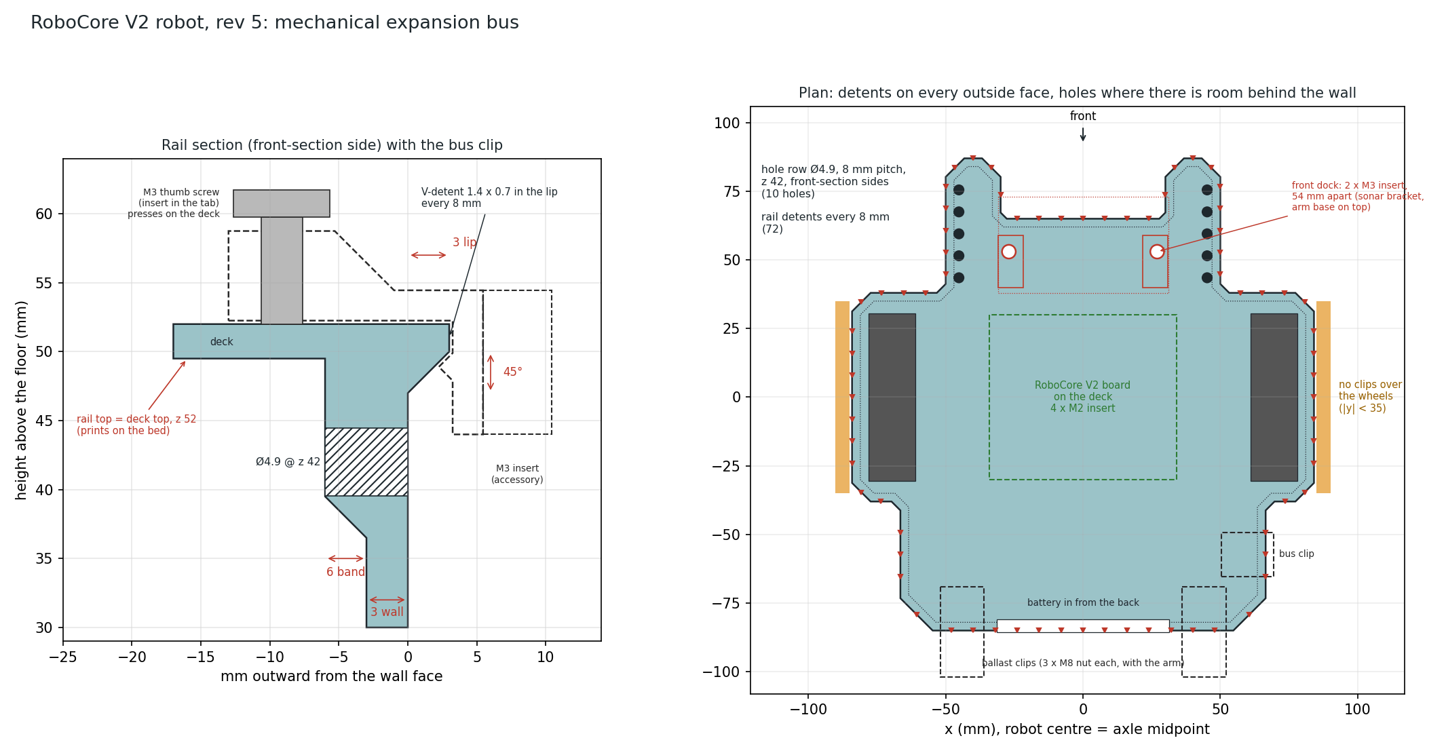
[picture p175: figure]

Expansion bus drawing — groove, detents, hole row and front dock; origin at the floor point under the axle middle, x right, y forward, z up (mm)

### ATTACHMENT POINTS

Feature | Value
Bus groove | 1.8 mm deep, back face z 46–49, flat top, 45° underside; every straight run and outside chamfer except the wheel sides
Detents | V-notches 1.4 × 0.7 mm every 8 mm along each run, plus one per chamfer: 54 in all
Bus clip | tongue in the groove + tab on the deck with an M3 insert and an M3 × 8 thumb screw; 10 × 10 mm boss with an M3 insert for the accessory
Hole row | Ø4.9 at z 42, 8 mm pitch, front-section sides only (10 holes); 6 mm wall so Technic pins grip
Front dock | 2 × M3 inserts 54 mm apart at (±27, 53), z 52; carries the sonar bracket and the arm module
Deck | z 49.5–52, solid except: board window, USB relief, cable slots, encoder plug slots, rear cable ports, caster vents, wheel wells
Ballast clips | on the rear wall at x ±44, 3 × M8 nuts each; fit them whenever the arm is on
Grid | everything on an 8 mm (LEGO Technic) pitch

Print the Rail_coupon first (40 mm of deck, wall and groove, about 20 min). If the clip is tight or loose, change CLIP_GAP (0.25 mm) in fusion/rc_params.py and re-export the clip.

mech/robot/EXPANSION_BUS.md · renders/rev5/bus_spec.png (fusion/bus_drawing.py) | A4 landscape · print at 100 % (no scaling)

### R O B O C O R E · V 1 C O N T R O L L E R

# RoboCore V1 · first board, ESP32-C3

22 / 30

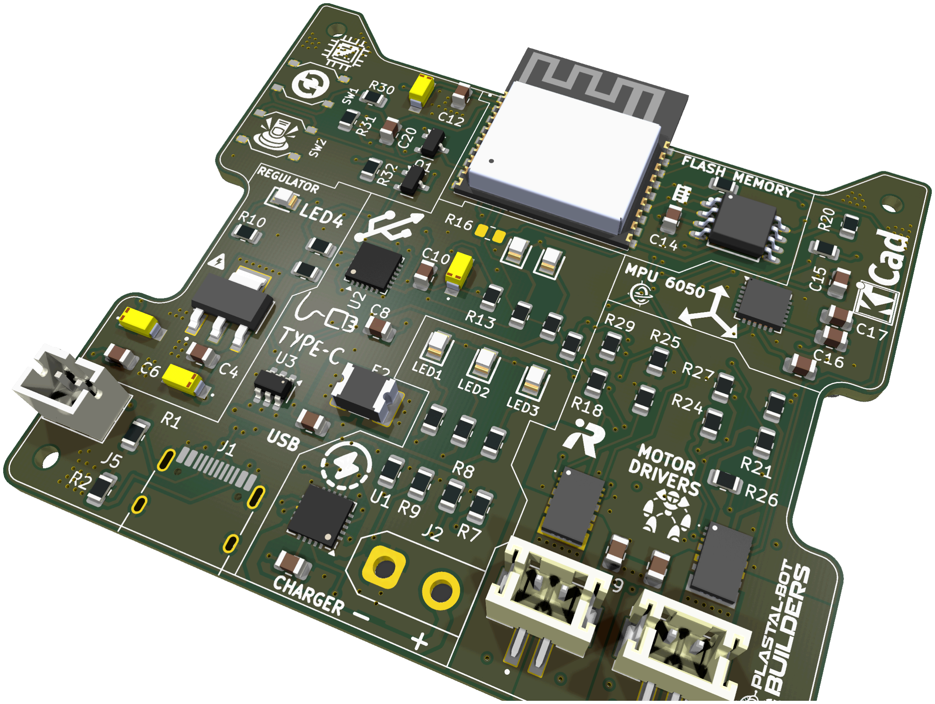
[picture p176: figure]

RoboCore V1 — ESP32-C3, two DRV8245 motor drivers, MPU-6050 IMU, reworked 2026-10-01 (DRC 0 errors)

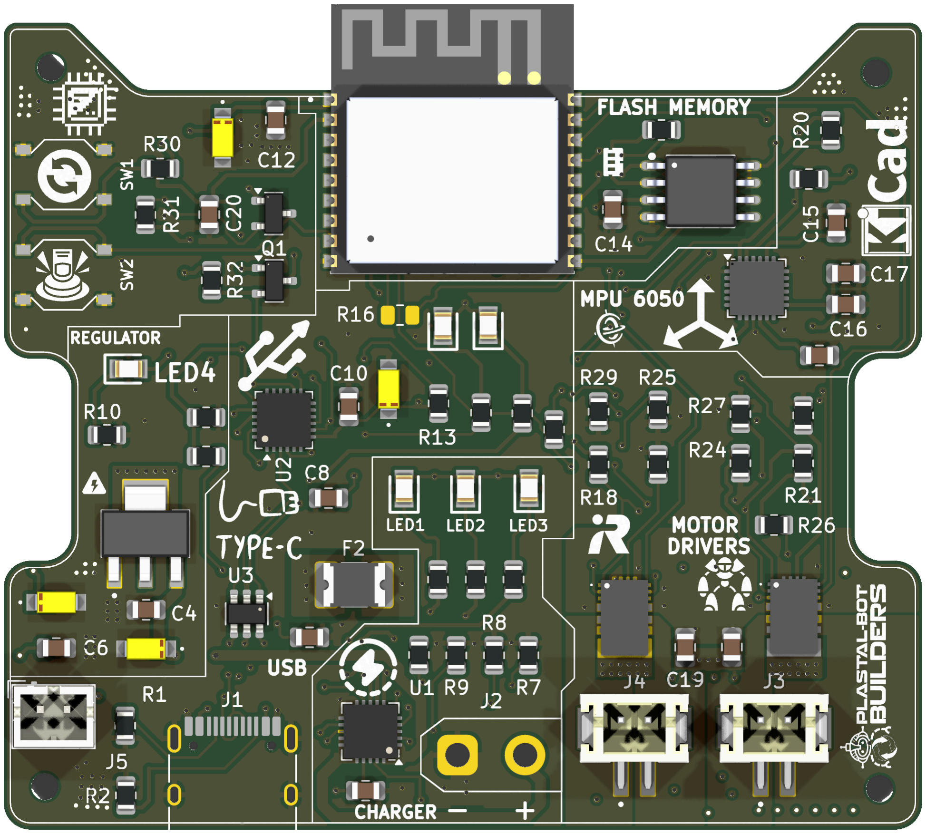
[picture p177: figure]
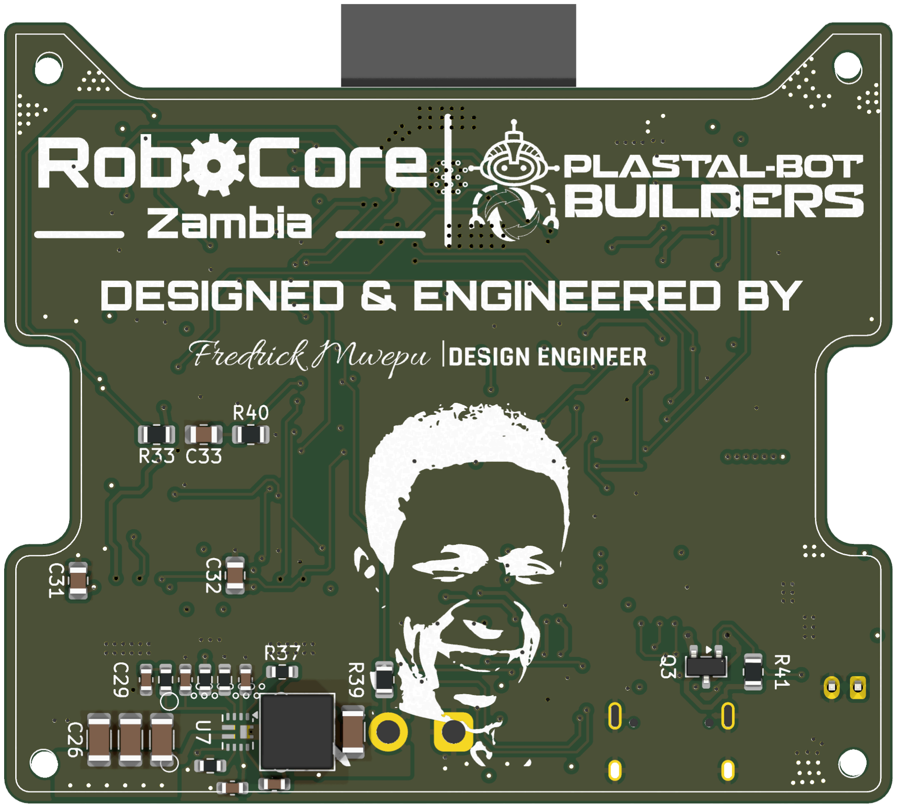
[picture p178: figure]

top | bottom — boost converter and a few small parts

### AT A GLANCE

Item | Value
Board | 68 × 60 mm, 2 layers, same outline and holes as V2
MCU | ESP32-C3-WROOM-02 with a CP2102N USB-UART (auto-reset upload)
Motors 2 × TI DRV8245 (one per motor), 6.06 V rail from a TPS61089 boost
IMU | MPU-6050 (obsolete part — replaced by the LSM6DSOX in V2)
Power | 1S Li-ion on XT30, MCP73871 USB-C charger (1 A), TLV1117LV33 3.3 V LDO, J5 chassis switch
Extras | W25Q32 SPI flash, battery sense on IO0, artwork on the front

### ESP32-C3 PIN MAP

GPIO | Function
IO0 | VBAT_SENSE (÷2)
IO1 / IO2 | PWM_A / DIR_A
IO3 / IO4 | PWM_B / DIR_B
IO5 | nFAULT (both drivers)
IO6 | nSLEEP (both drivers)
IO7 / IO10 / IO18 / IO19 | SPI to the W25Q32 flash
IO8 / IO9 | I2C SDA / SCL (MPU-6050); IO9 = BOOT
TXD / RXD | UART to the CP2102N

### WHAT V2 CHANGED

ESP32-S3 with native USB (no UART bridge), XRP-compatible pinout and 4 servo headers
One DRV8411A for both motors, current-limited to 1 A; encoder inputs on the motor sockets TPS63001 buck-boost for 3.3 V (works down to a flat cell), 5.5 V servo rail, battery reverse / over-voltage cut-off
4 layers, all parts on top, back reserved for artwork
RoboCore/RoboCore.kicad_pcb · review/RoboCore_V1_summary_2026-10-01.md | A4 landscape · print at 100 % (no scaling)

# RoboCore V1 schematic · Root sheet · part 1 of 4 (top left) scale 1.33

23 / 30

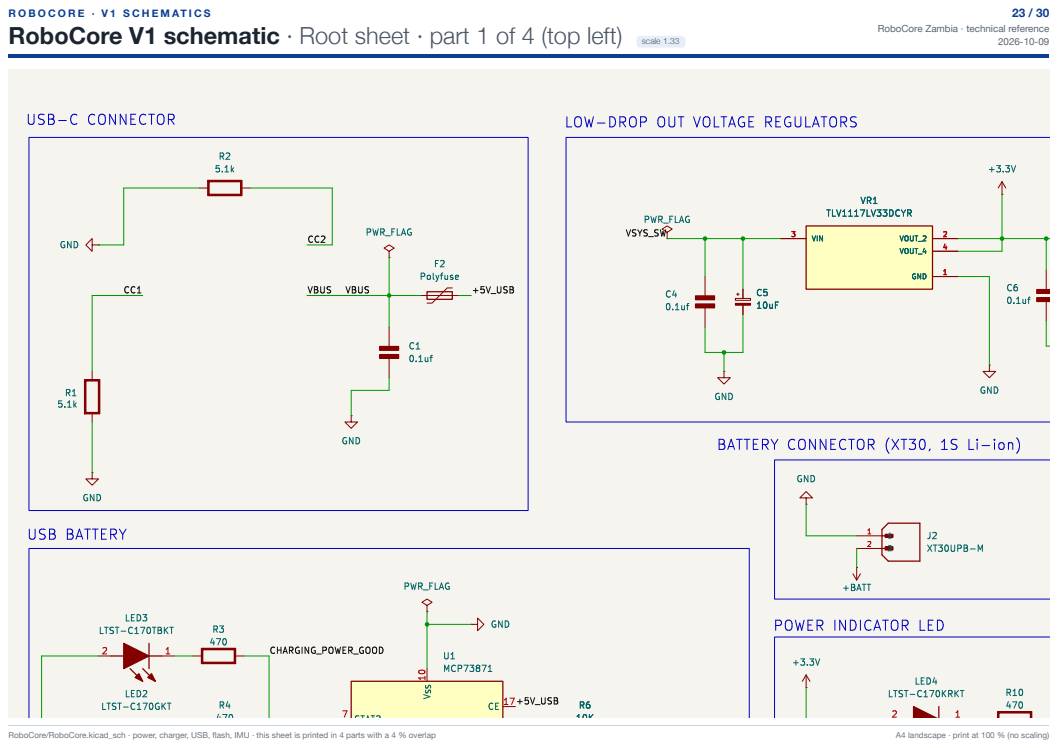
[picture p179: page 23]
RoboCore/RoboCore.kicad_sch · power, charger, USB, flash, IMU · this sheet is printed in 4 parts with a 4 % overlap; A4 landscape · print at 100 % (no scaling)

# RoboCore V1 schematic · Root sheet · part 2 of 4 (top right) scale 1.33

24 / 30

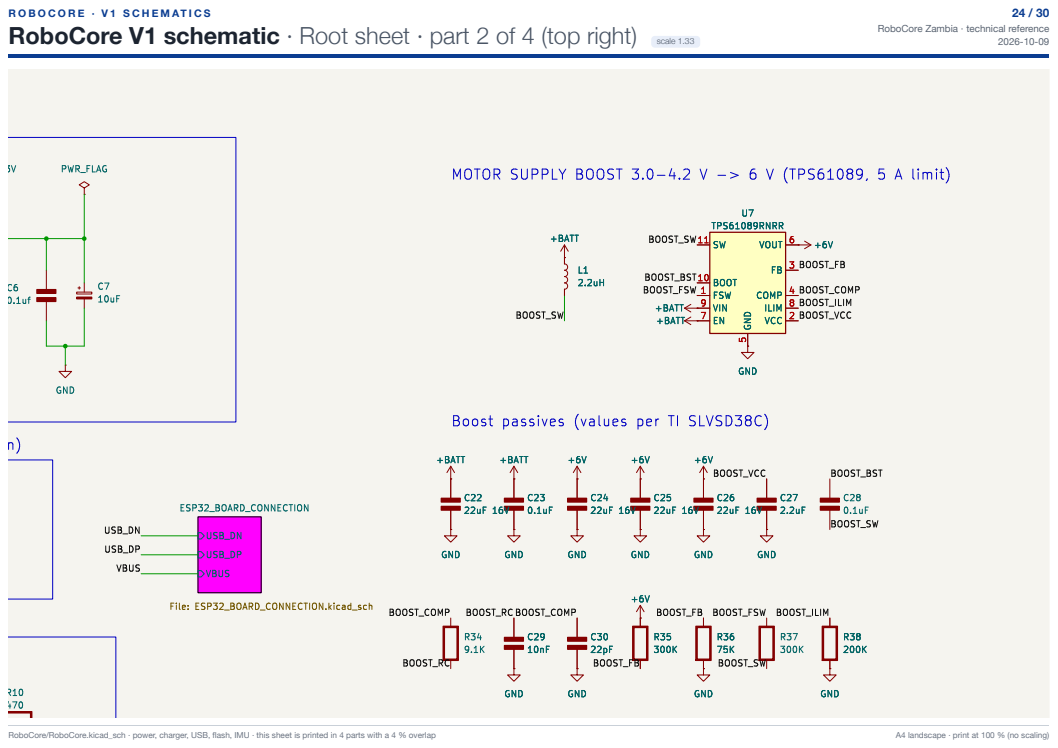
[picture p180: page 24]
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

# RoboCore V1 schematic · Root sheet · part 3 of 4 (bottom left) scale 1.33

25 / 30

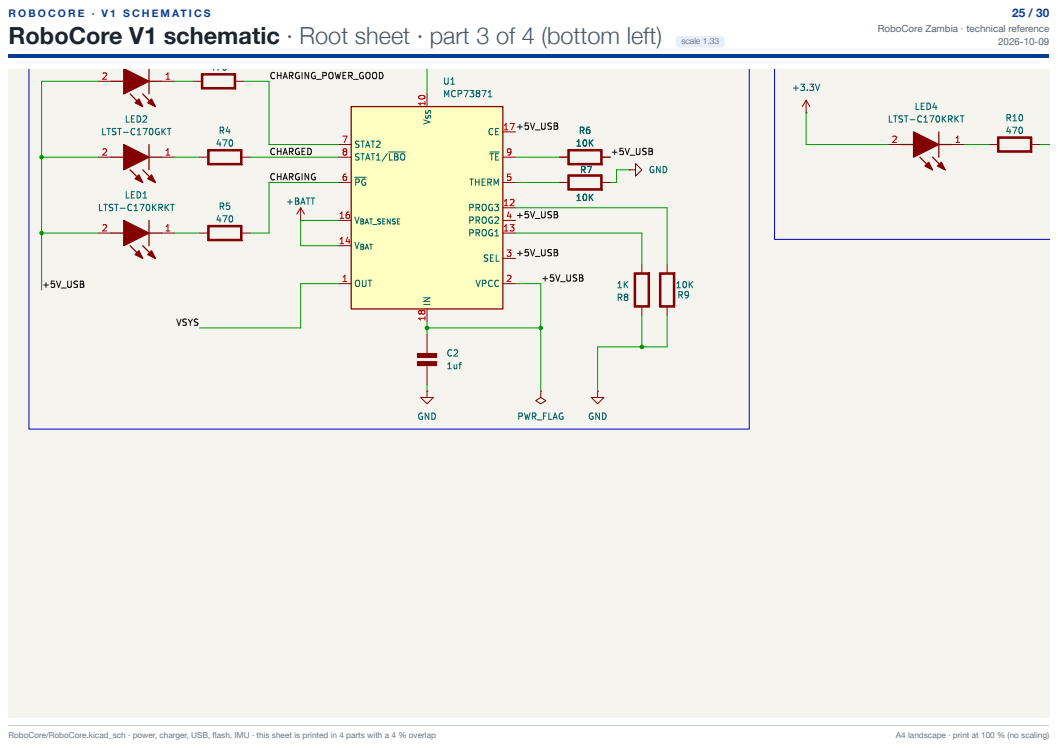
[picture p181: page 25]
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

# RoboCore V1 schematic · Root sheet · part 4 of 4 (bottom right) scale 1.33

26 / 30

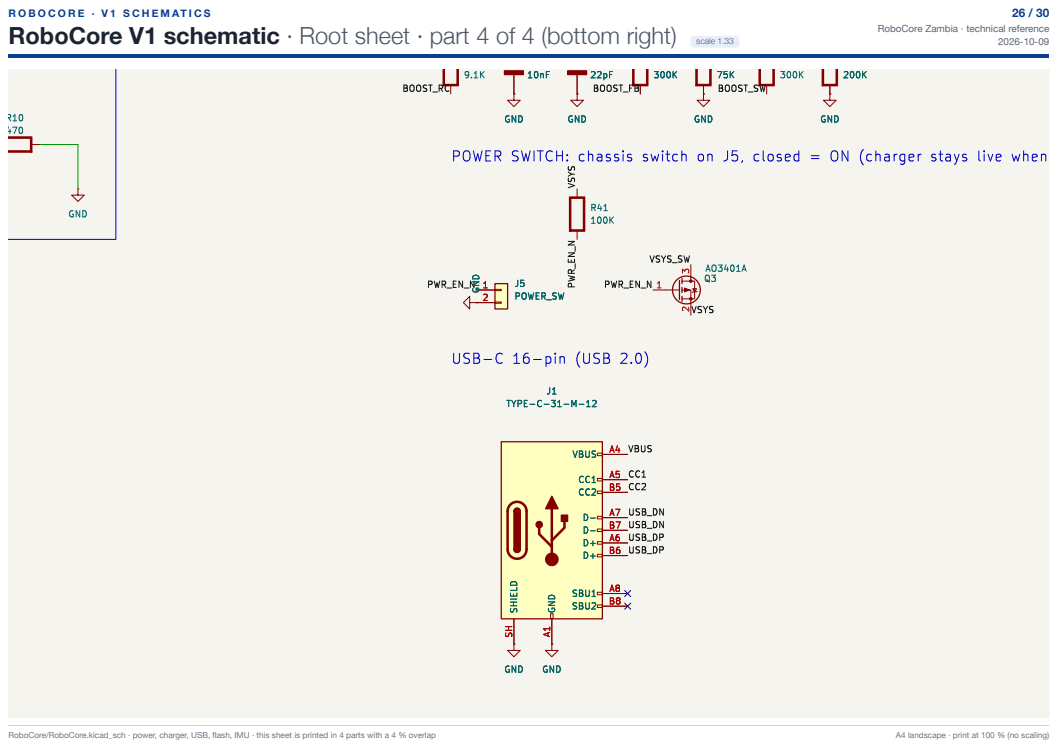
[picture p182: page 26]
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

# RoboCore V1 schematic · ESP32 board connection · part 1 of 2 (left) scale 0.95

27 / 30

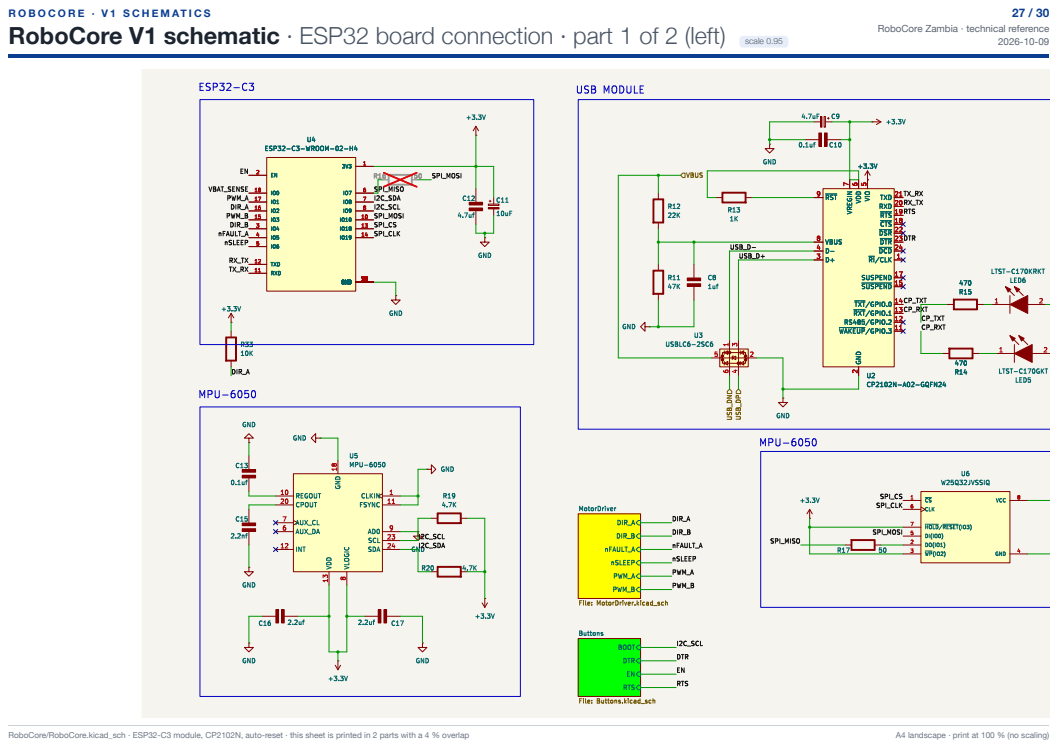
[picture p183: page 27]
RoboCore/RoboCore.kicad_sch · ESP32-C3 module, CP2102N, auto-reset · this sheet is printed in 2 parts with a 4 % overlap; A4 landscape · print at 100 % (no scaling)

# RoboCore V1 schematic · ESP32 board connection · part 2 of 2 (right) scale 0.95

28 / 30

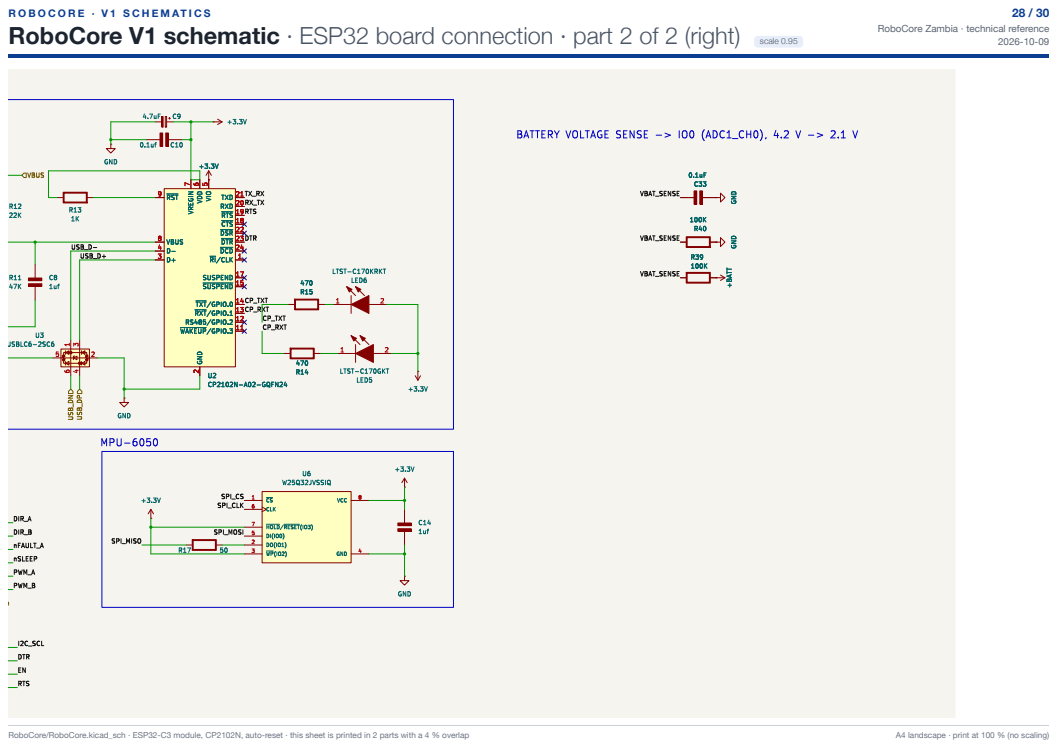
[picture p184: page 28]
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

# RoboCore V1 schematic · Motor driver scale 1.11

29 / 30

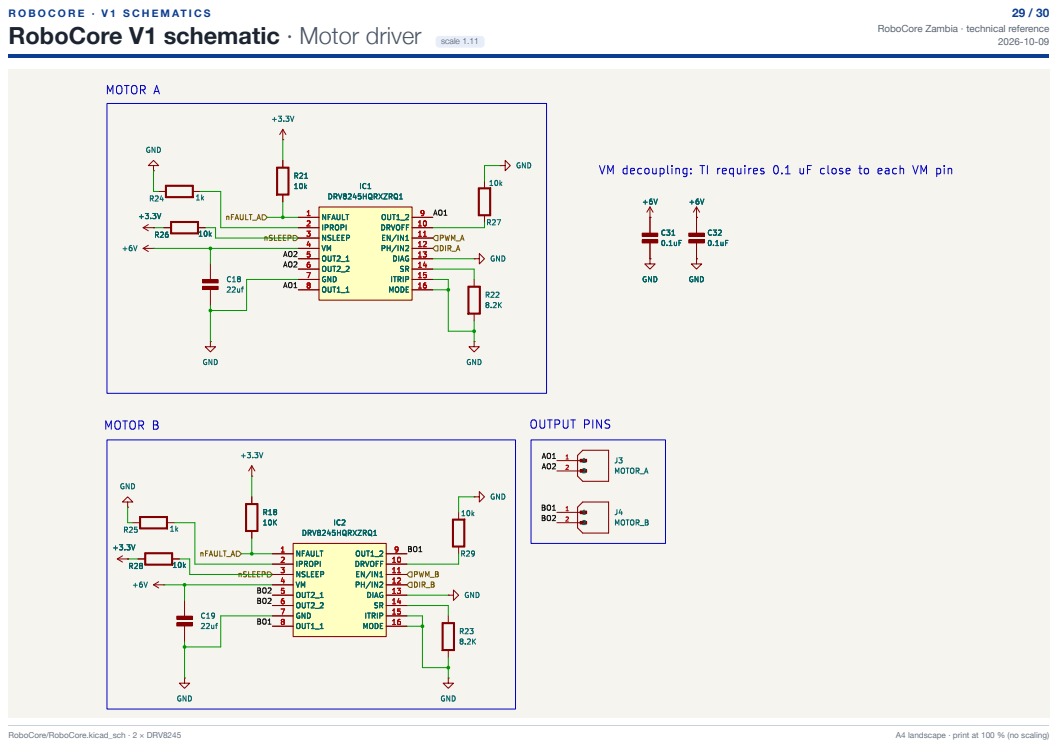
[picture p185: page 29]
RoboCore/RoboCore.kicad_sch · 2 × DRV8245; A4 landscape · print at 100 % (no scaling)

# RoboCore V1 schematic · Buttons scale 1.30

30 / 30

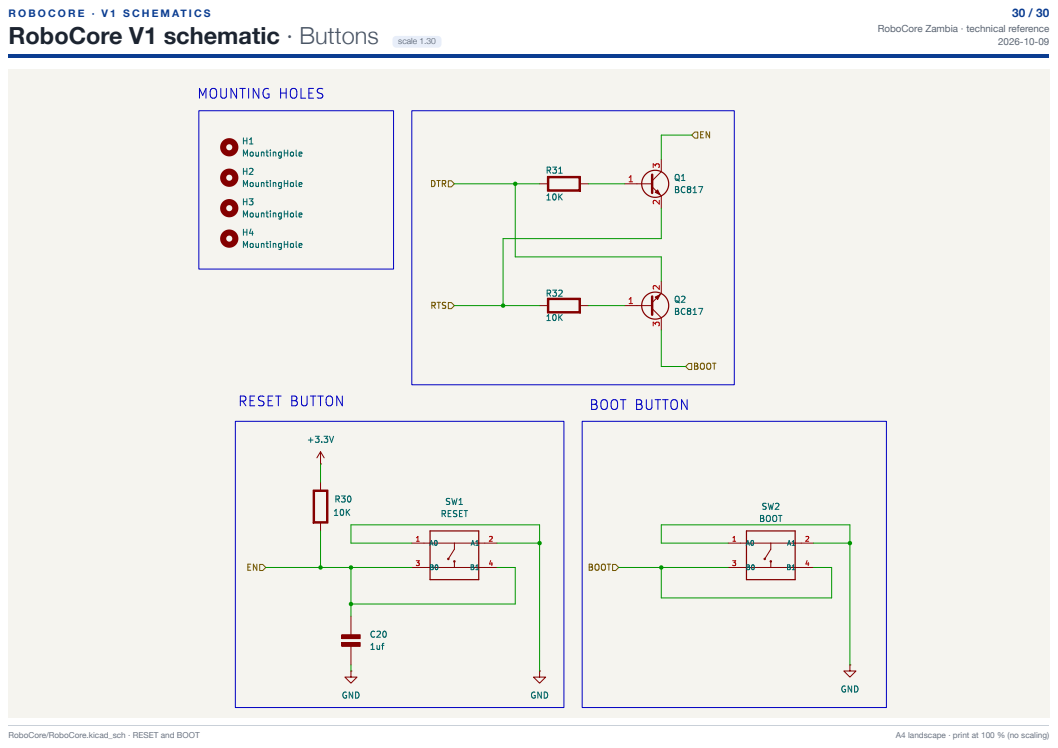
[picture p186: page 30]
RoboCore/RoboCore.kicad_sch · RESET and BOOT; A4 landscape · print at 100 % (no scaling)
