Plastal-Bot-Builders/RoboCoreDocumentation/docs/sponsorship/PCBWay_sensor_boards/attachments/09_line_sensor_schematic.pdf

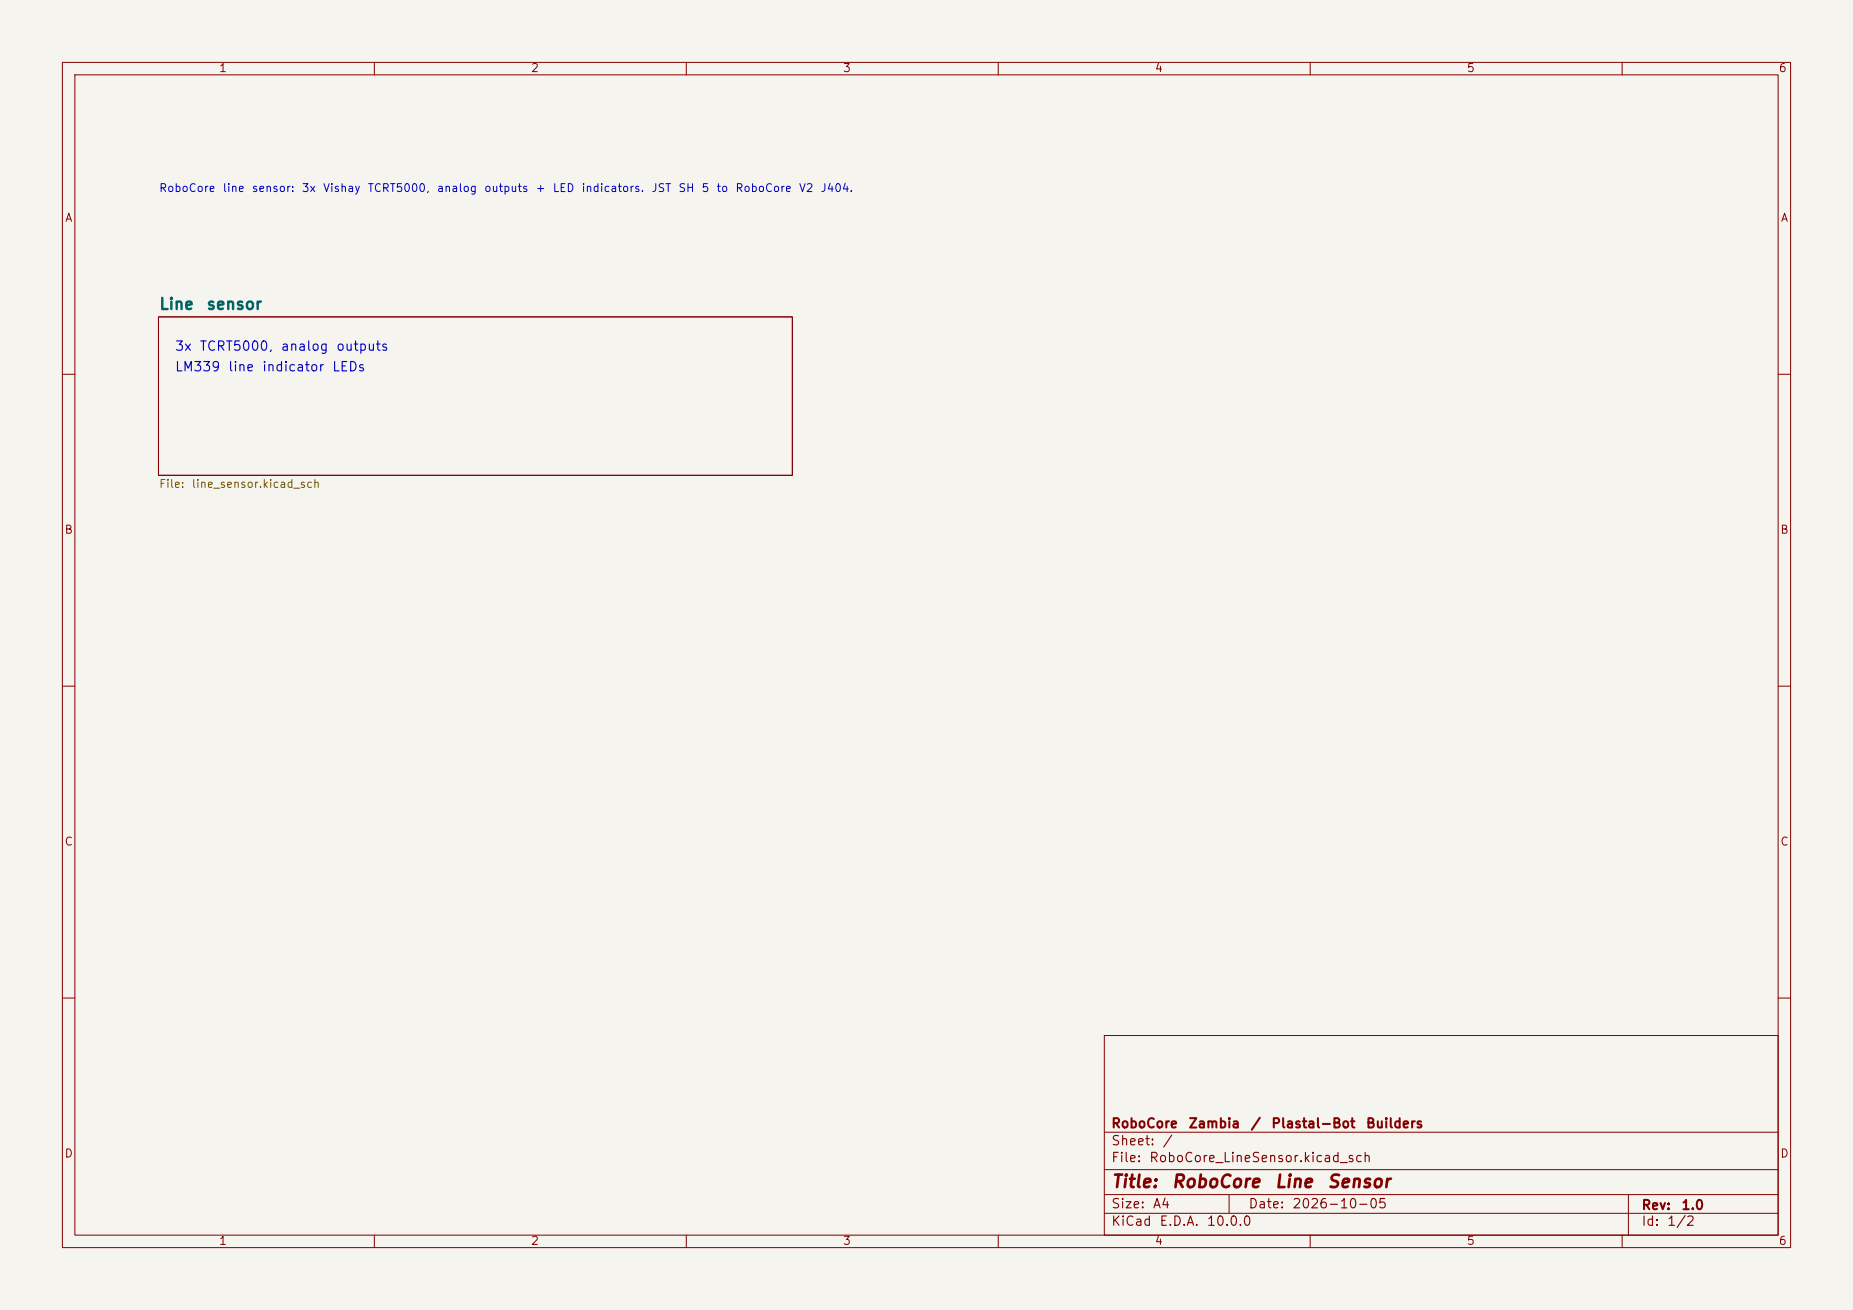
[picture p187: page 1]

LM339 line indicator LEDs RoboCore line sensor: 3x Vishay TCRT5000, analog outputs + LED indicators. JST SH 5 to RoboCore V2 J404.

RoboCore Zambia / Plastal-Bot Builders
Sheet: /
D Date: 2026-10-05 KiCad E.D.A. 10.0.0
File: RoboCore_LineSensor.kicad_sch
Title: RoboCore Line Sensor

Size: A4 | Rev: 1.0

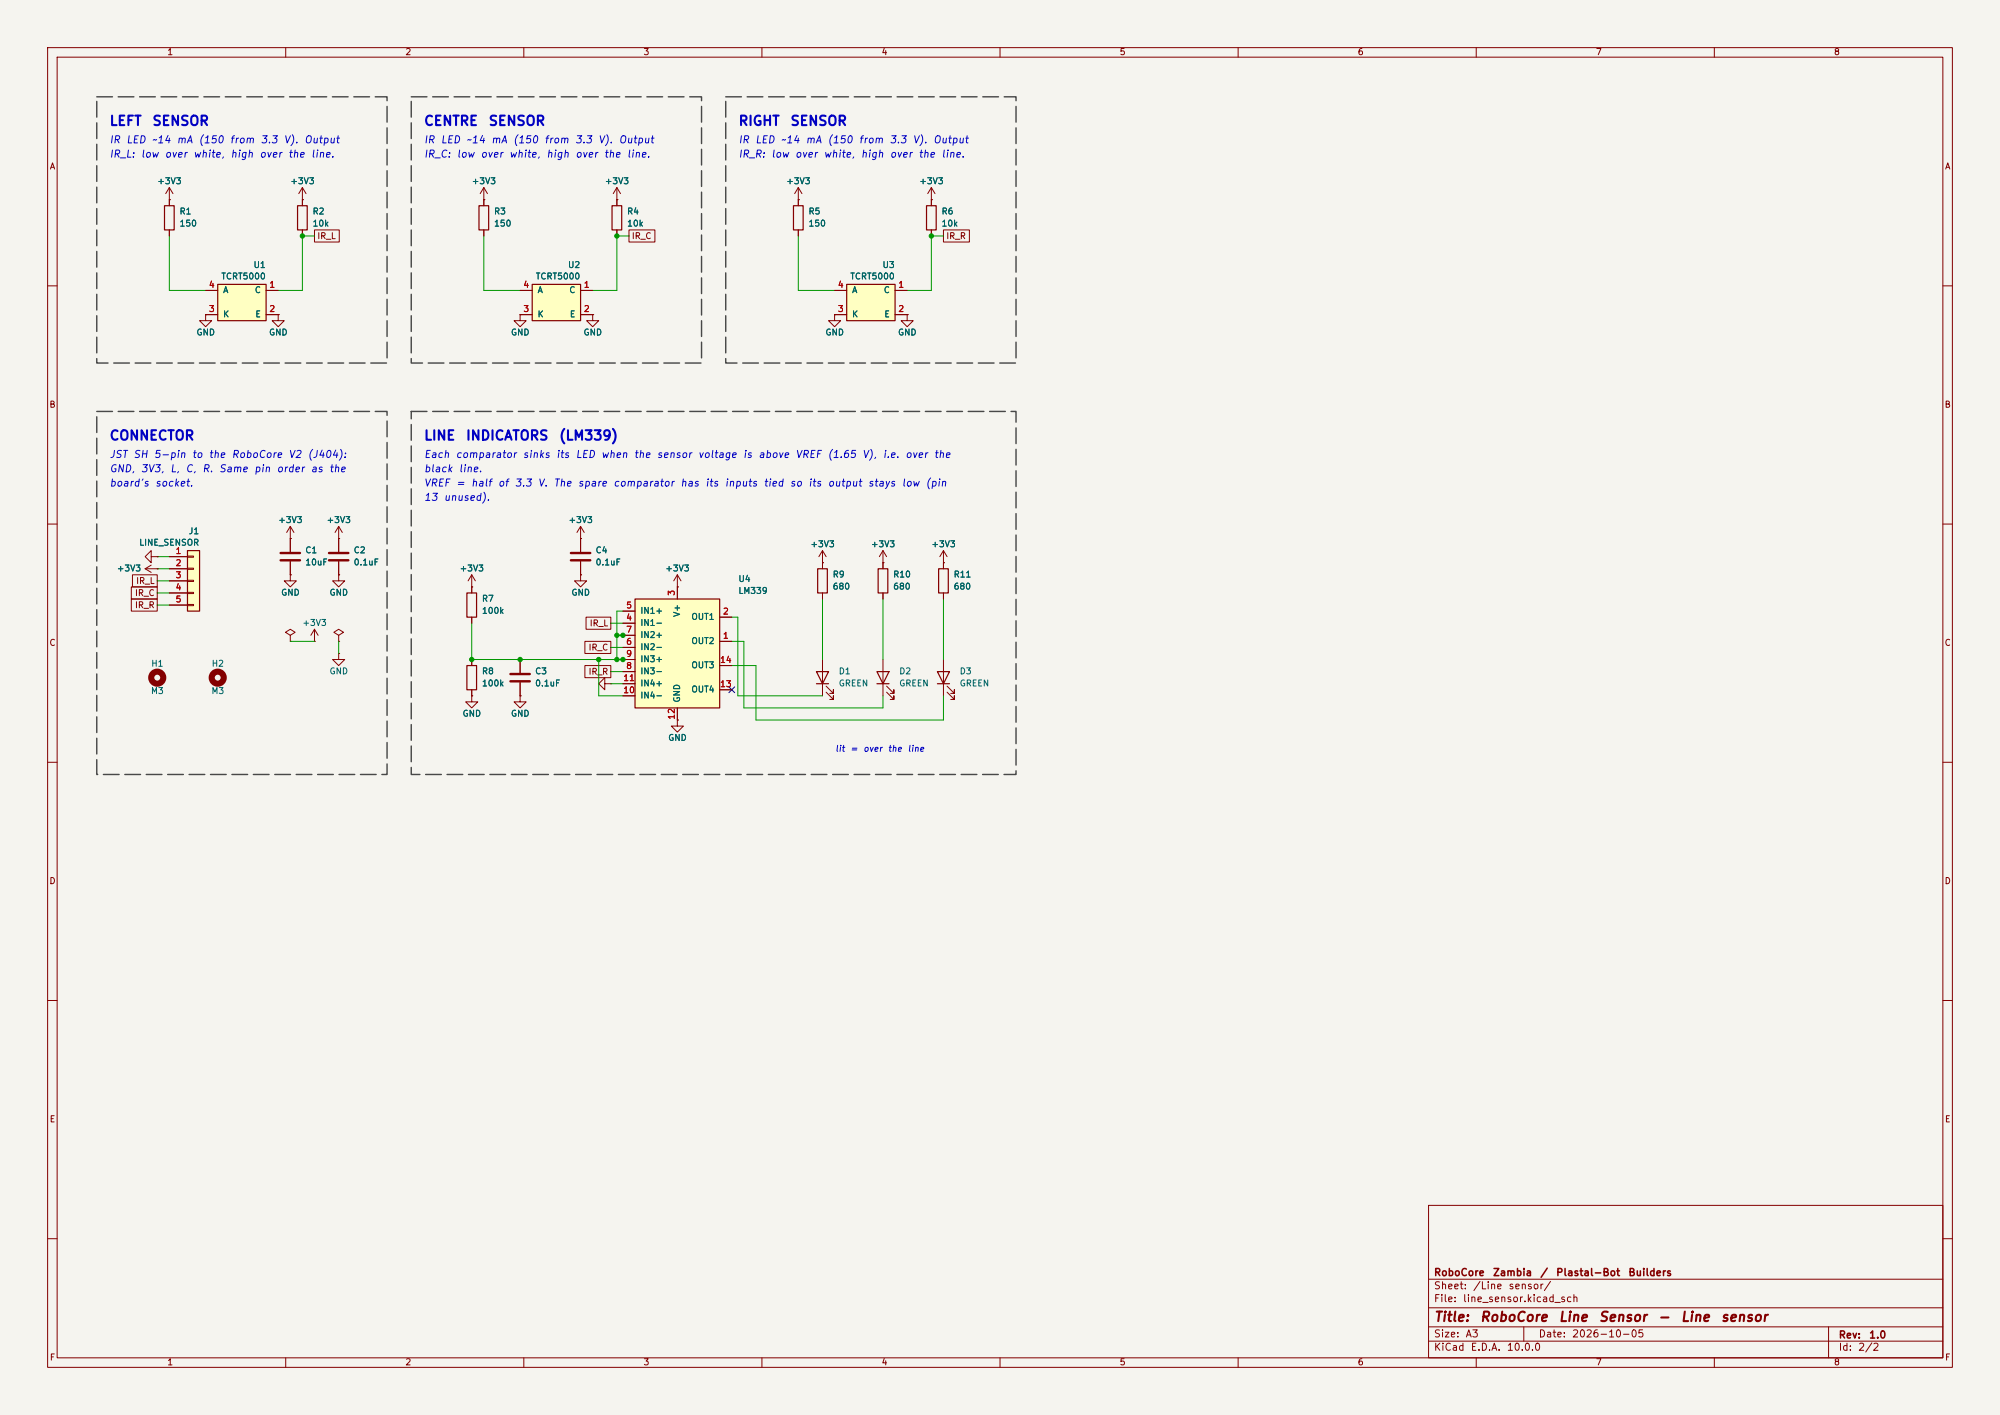
[picture p188: page 2]

GND, 3V3, L, C, R. Same pin order as the board's socket. LEFT SENSOR
IR LED ~14 mA (150 from 3.3 V). Output
IR_L: low over white, high over the line.

IR_C: low over white, high over the line.
680D3GREEN +3V3R5

IR_R: low over white, high over the line.

CONNECTOR
JST SH 5-pin to the RoboCore V2 (J404):

Each comparator sinks its LED when the sensor voltage is above VREF (1.65 V), i.e. over the 13 unused).

lit = over the line VREF = half of 3.3 V. The spare comparator has its inputs tied so its output stays low (pin

RoboCore Zambia / Plastal-Bot Builders
Sheet: /Line sensor/
Title: RoboCore Line Sensor - Line sensor File: line_sensor.kicad_sch

Size: A3 | Rev: 1.0 | F Date: 2026-10-05 KiCad E.D.A. 10.0.0
