Plastal-Bot-Builders/RoboCoreDocumentation/docs/sponsorship/PCBWay_sensor_boards/attachments/10_ultrasonic_schematic.pdf

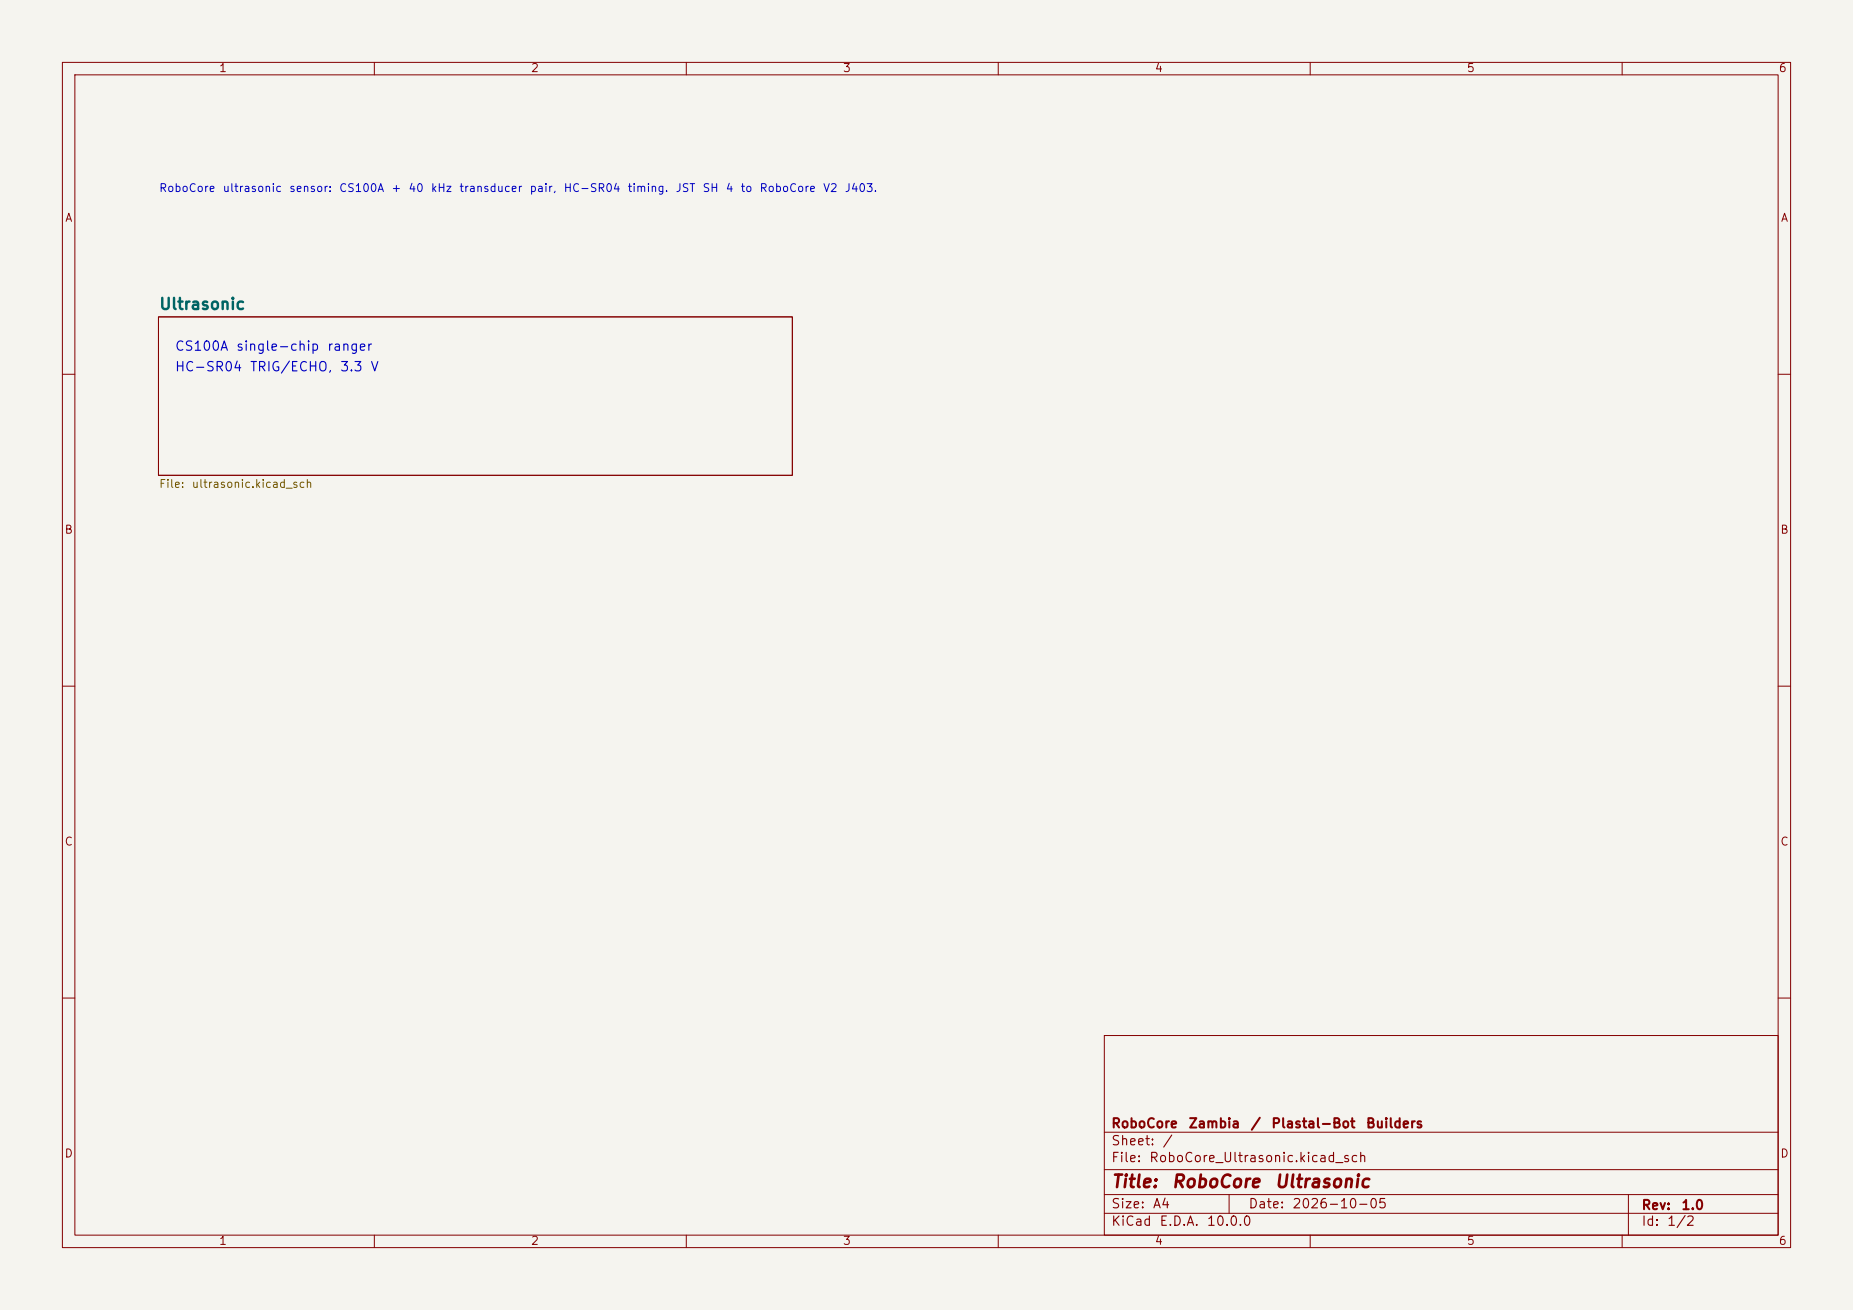
[picture p189: page 1]

RoboCore ultrasonic sensor: CS100A + 40 kHz transducer pair, HC-SR04 timing. JST SH 4 to RoboCore V2 J403.

File: ultrasonic.kicad_sch CS100A single-chip ranger HC-SR04 TRIG/ECHO, 3.3 V

RoboCore Zambia / Plastal-Bot Builders
Sheet: /
D Date: 2026-10-05 KiCad E.D.A. 10.0.0
File: RoboCore_Ultrasonic.kicad_sch
Title: RoboCore Ultrasonic

Size: A4 | Rev: 1.0

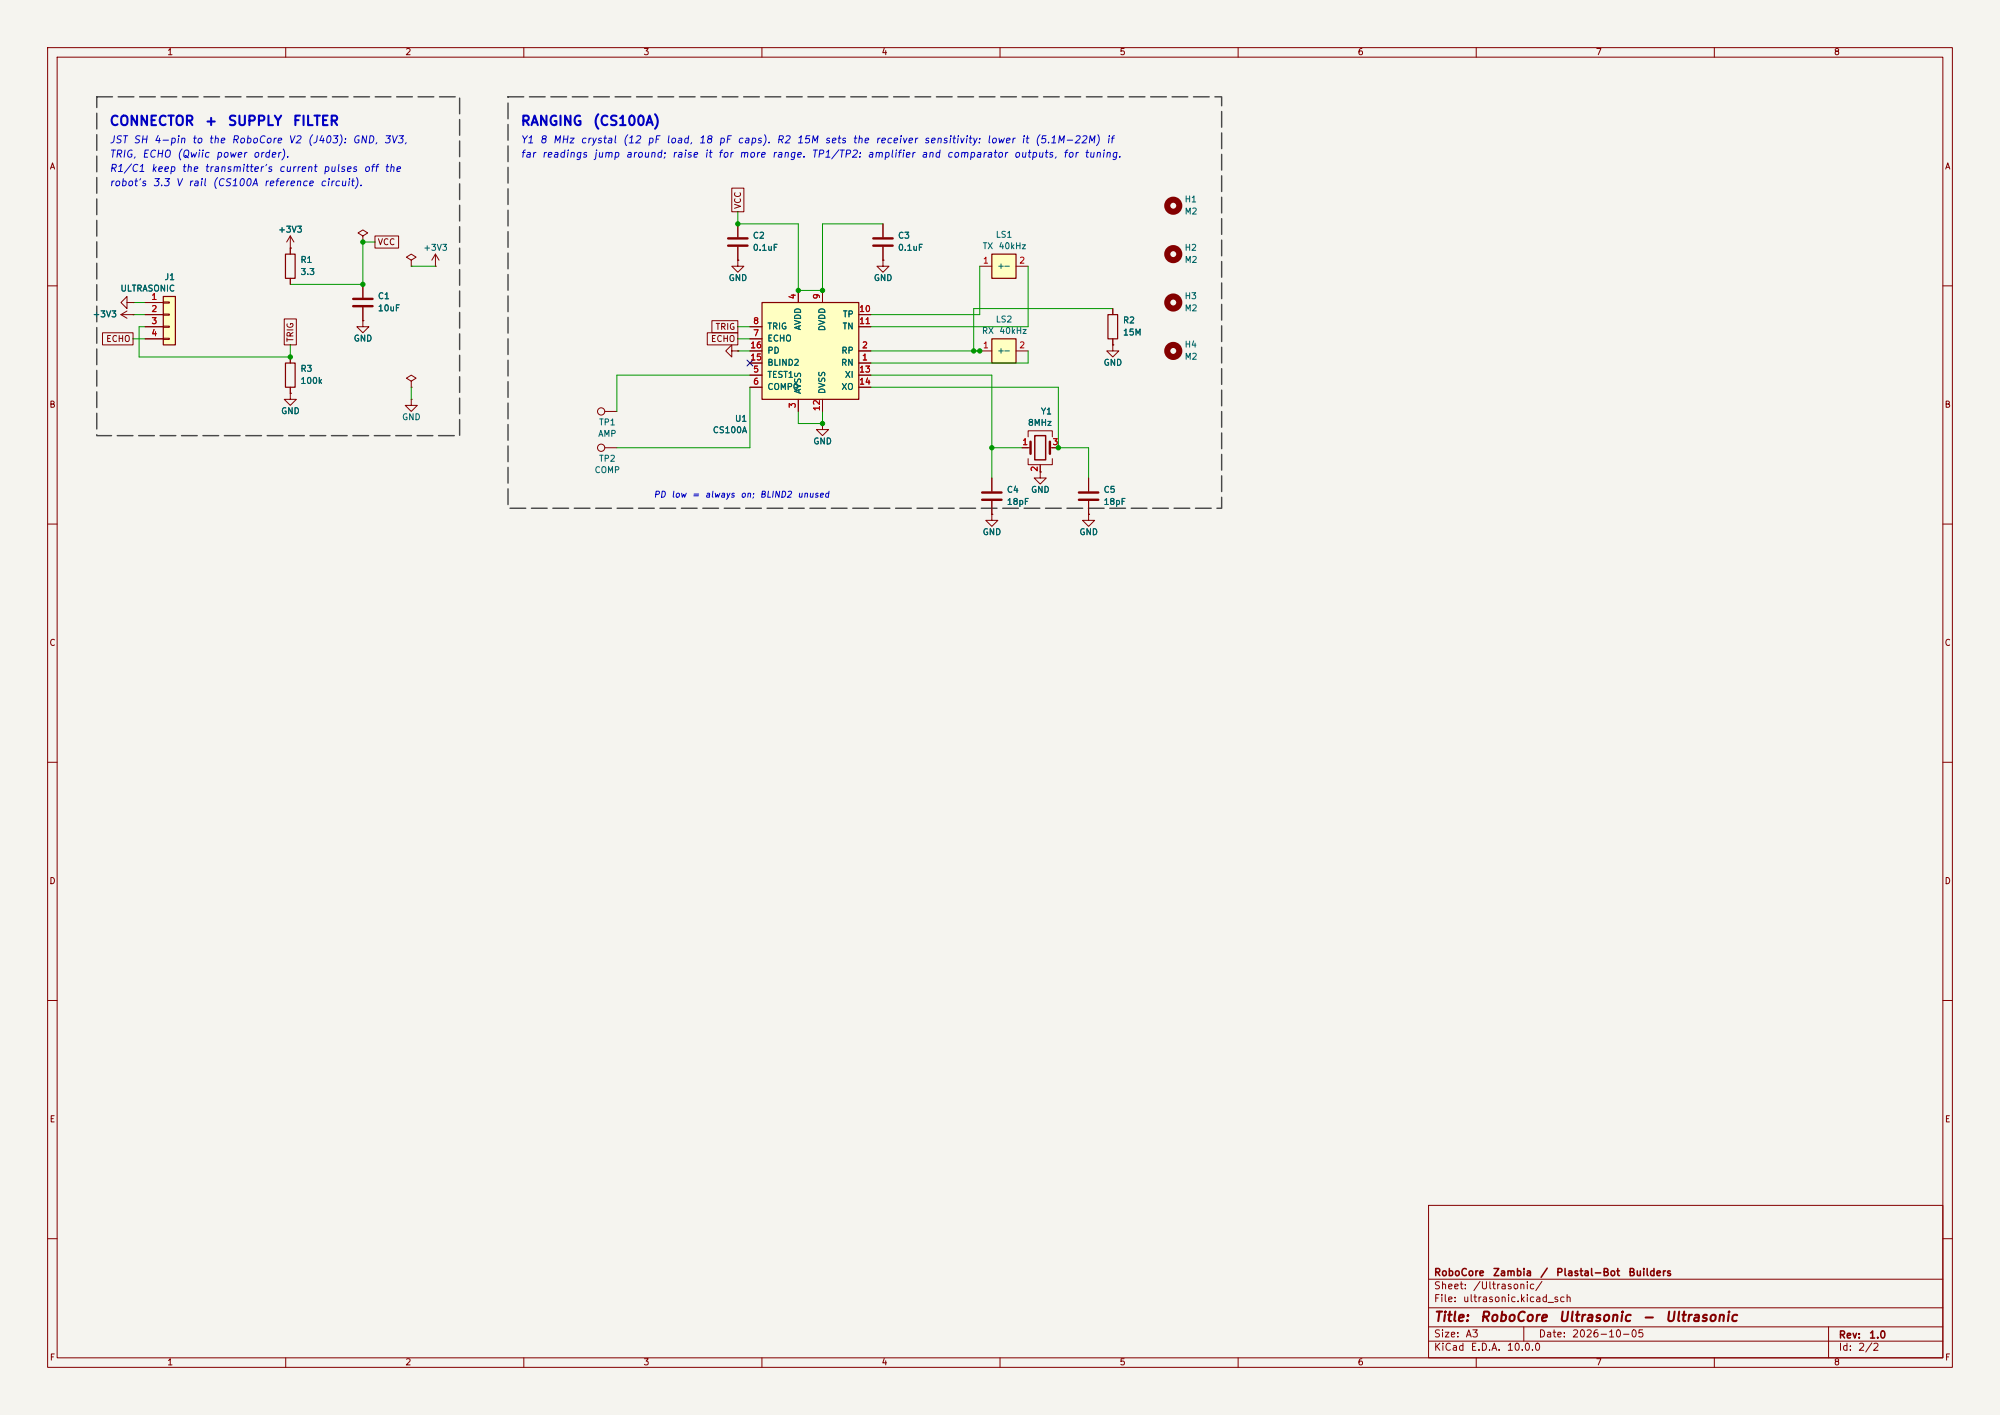
[picture p190: page 2]

CONNECTOR + SUPPLY FILTER
JST SH 4-pin to the RoboCore V2 (J403): GND, 3V3,
TRIG, ECHO (Qwiic power order).
R1/C1 keep the transmitter's current pulses off the
robot's 3.3 V rail (CS100A reference circuit).

ECHO RANGING (CS100A)
Y1 8 MHz crystal (12 pF load, 18 pF caps). R2 15M sets the receiver sensitivity: lower it (5.1M-22M) if
far readings jump around; raise it for more range. TP1/TP2: amplifier and comparator outputs, for tuning.

PD low = always on; BLIND2 unused

RoboCore Zambia / Plastal-Bot Builders
Sheet: /Ultrasonic/
File: ultrasonic.kicad_sch
Title: RoboCore Ultrasonic - Ultrasonic

Size: A3 | Rev: 1.0 | F Date: 2026-10-05 KiCad E.D.A. 10.0.0
