Plastal-Bot-Builders/RoboCoreDocumentation/hardware/controller_v2/fab/PCBWay_V2_2026-10-07/RoboCore_LineSensor/RoboCore_LineSensor_assembly_bottom.pdf

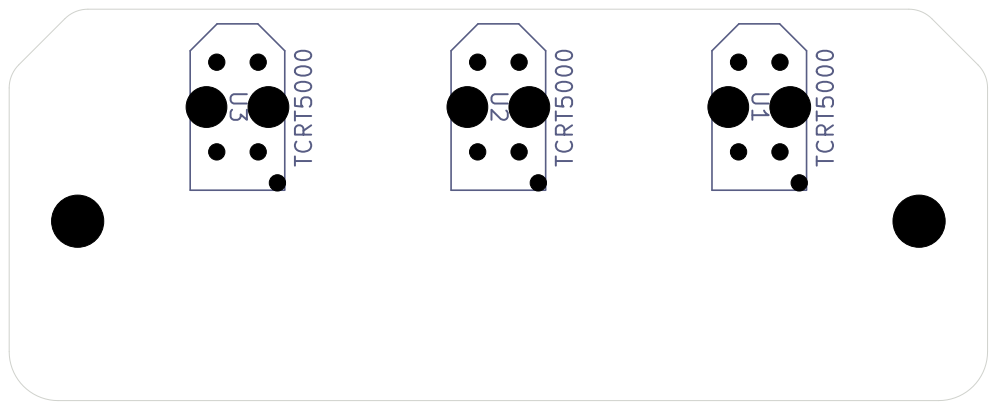
[picture p191: page 1]

Sheet:
D Date: 2026-10-05 KiCad E.D.A. 10.0.0
File: RoboCore_LineSensor.kicad_pcb
Title: RoboCore Line Sensor

Size: A4 | Rev: 1.0
