Plastal-Bot-Builders/RoboCoreDocumentation/hardware/controller_v2/fab/PCBWay_V2_2026-10-07/RoboCore_V2_Controller/RoboCore_V2_Controller_assembly_bottom.pdf

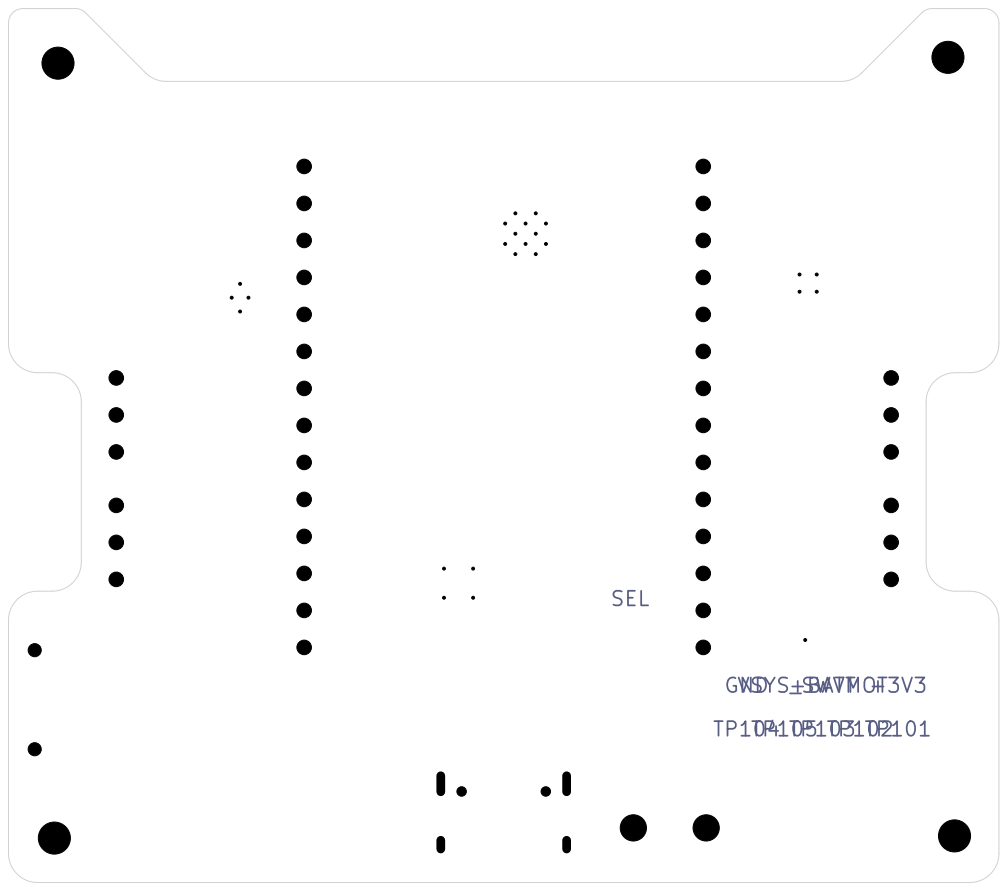
[picture p192: page 1]

RoboCore Zambia / Plastal-Bot Builders
Sheet:
D Date: 2026-10-04 KiCad E.D.A. 10.0.0
File: RoboCore_V2.kicad_pcb
Title: RoboCore V2

Size: A4 | Rev: 2.0
