Plastal-Bot-Builders/RoboCoreDocumentation/hardware/controller_v2/fab/PCBWay_V2_2026-10-07/RoboCore_Ultrasonic/RoboCore_Ultrasonic_assembly_bottom.pdf

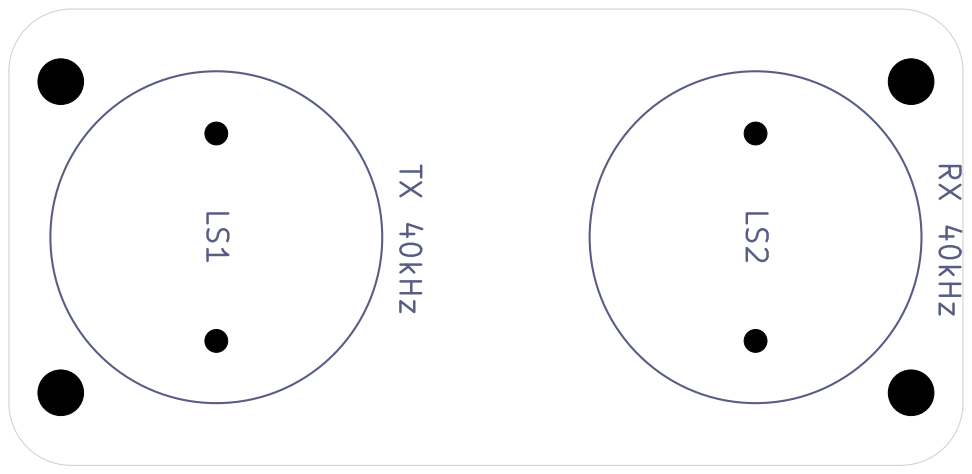
[picture p193: page 1]

Size: A4 | Rev: 1.0
