Plastal-Bot-Builders/RoboCoreDocumentation/mechanical/robot_v2/packaging/out/box_inside_A3_tiles.pdf

# GET STARTED HERE

# www.plastalbotbuilders.com

### On this page you will find:

### – Assembly and first-run guide – Step-by-step classroom lessons – Programming environments: blocks, Python, C++ – Firmware, example code and libraries – 3D-print files for the chassis and the arm – Support forum and teacher resources

SCAN FOR DOCS, CODE AND LESSONS

Replacement parts, add-on sensors and the arm module:

## plastalbotbuilders.com/robocore

Design files are published. Print it, fix it, improve it, share it.

## BEFORE YOU START

– 3 x 18650 lithium cells (not included) and a USB-C charger – A computer or tablet with a browser, or the Arduino IDE – Charge the robot fully before the first lesson
– Fit the arm module only after the drive base runs

# PLASTAL-BOT BUILDERS

Plastal-Bot Builders is a Lusaka makerspace that teaches robotics, coding and fabrication to learners and teachers across Zambia. RoboCore is our own controller family, designed so a class can build, program and repair its robots locally.

# JOIN THE ROBOCORE COMMUNITY

Share what your class builds, find lesson plans and compare notes with other schools. Replacement parts, add-on sensors and the arm module are available from us; the design files are published so you can also print and fix parts yourself.

# ROBOCORE ZAMBIA

RoboCore V2 box, inside, tile 1 of 6 (row 1, column 1), 1:1. Overlap 10 mm with the neighbouring tiles.

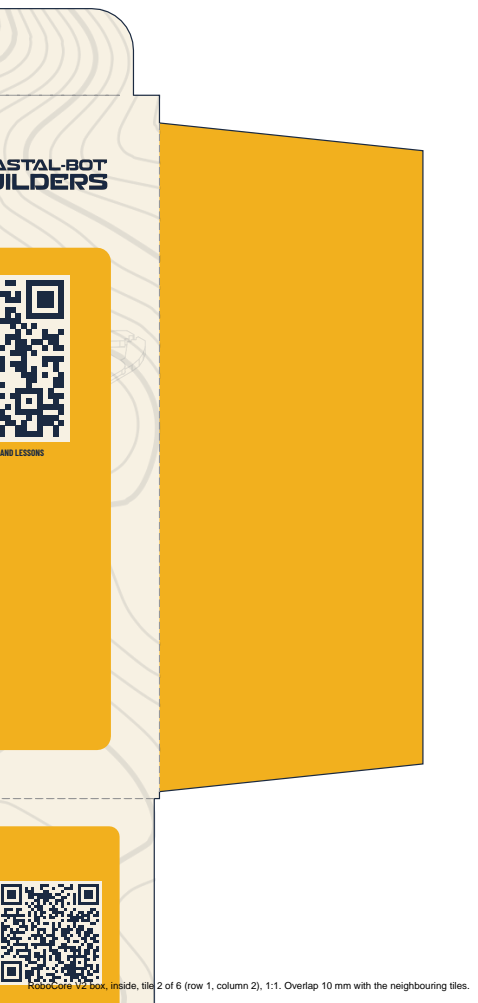
[picture p195: page 2]

SCAN FOR DOCS, CODE AND LESSONS

RoboCore V2 box, inside, tile 2 of 6 (row 1, column 2), 1:1. Overlap 10 mm with the neighbouring tiles.

# THIS KIT INCLUDES

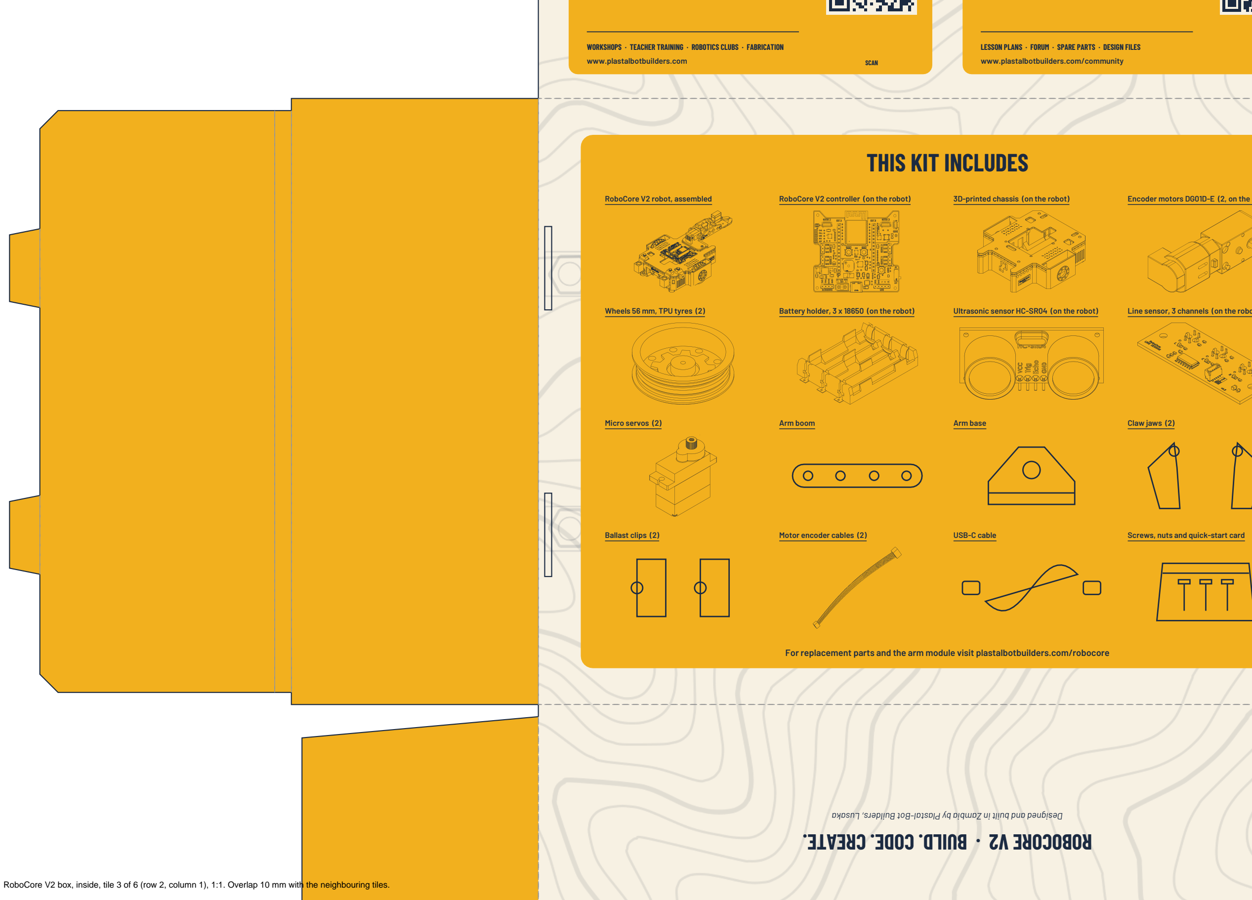
[picture p196: page 3]

WORKSHOPS · TEACHER TRAINING · ROBOTICS CLUBS · FABRICATION
www.plastalbotbuilders.com | SCAN

LESSON PLANS · FORUM · SPARE PARTS · DESIGN FILES
www.plastalbotbuilders.com/community | SCAN
RoboCore V2 robot, assembled | RoboCore V2 controller (on the robot) | 3D-printed chassis (on the robot) | Encoder motors DG01D-E (2, on the robot)
Wheels 56 mm, TPU tyres (2) | Battery holder, 3 x 18650 (on the robot) | Ultrasonic sensor HC-SR04 (on the robot) | Line sensor, 3 channels (on the robot)
Micro servos (2) | Arm boom | Arm base | Claw jaws (2)
Ballast clips (2) | Motor encoder cables (2) | USB-C cable | Screws, nuts and quick-start card

For replacement parts and the arm module visit plastalbotbuilders.com/robocore

RoboCore V2 box, inside, tile 3 of 6 (row 2, column 1), 1:1. Overlap 10 mm with the neighbouring tiles.

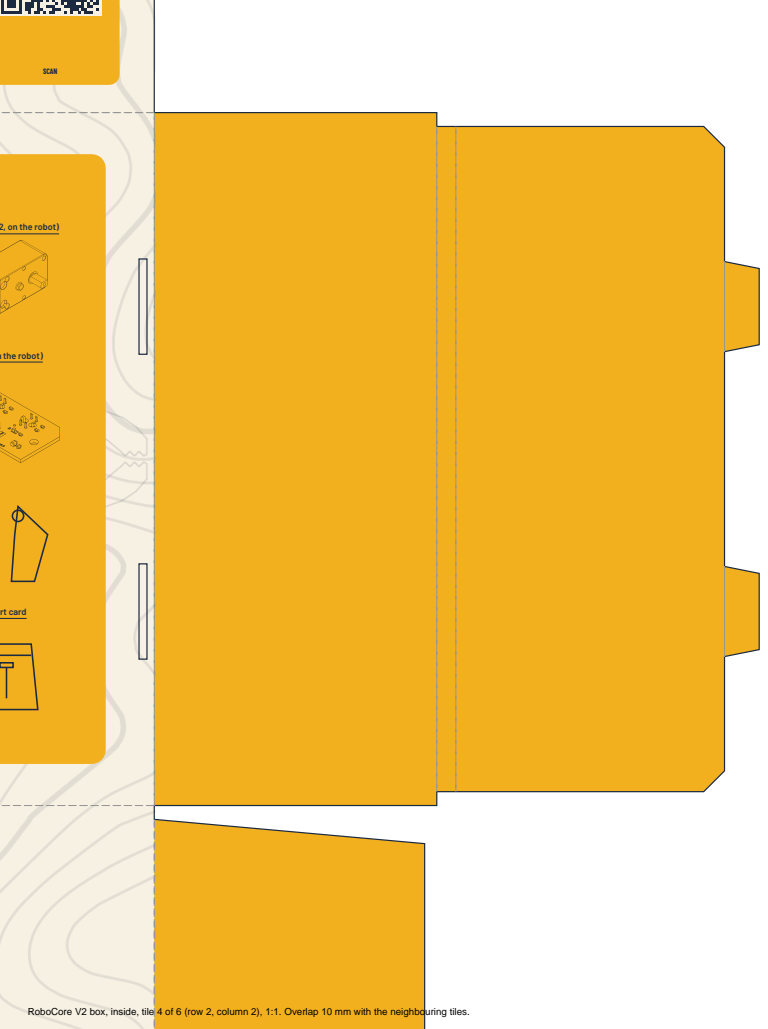
[picture p197: page 4]
www.plastalbotbuilders.com/community; SCAN; RoboCore V2 robot, assembled; RoboCore V2 controller (on the robot); 3D-printed chassis (on the robot); Encoder motors DG01D-E (2, on the robot); Wheels 56 mm, TPU tyres (2); Battery holder, 3 x 18650 (on the robot); Ultrasonic sensor HC-SR04 (on the robot); Line sensor, 3 channels (on the robot); Ballast clips (2); Motor encoder cables (2); USB-C cable; Screws, nuts and quick-start card

RoboCore V2 box, inside, tile 4 of 6 (row 2, column 2), 1:1. Overlap 10 mm with the neighbouring tiles.

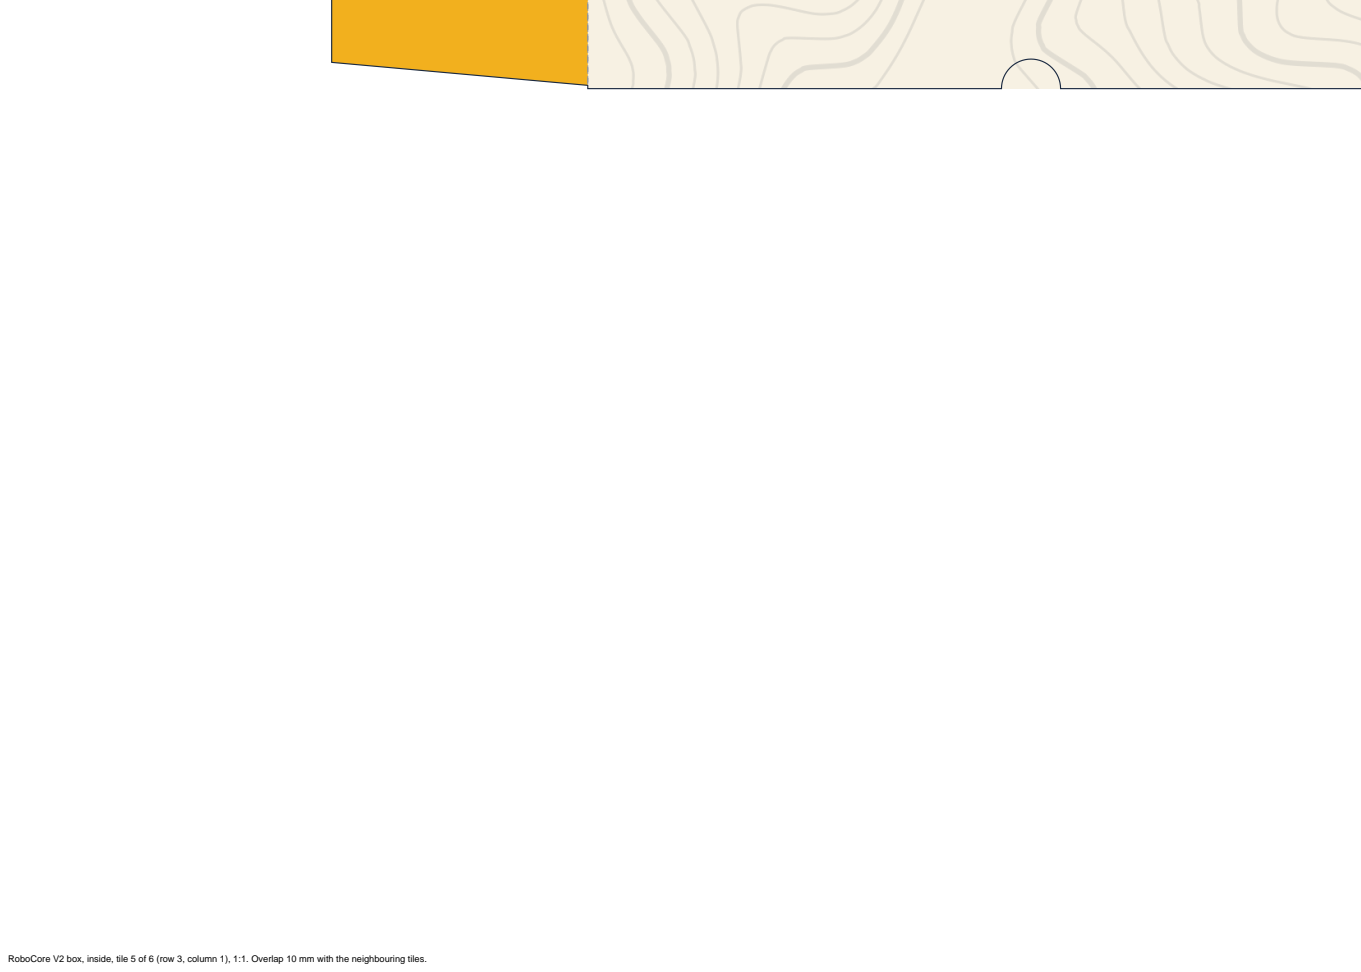
[picture p198: page 5]

RoboCore V2 box, inside, tile 5 of 6 (row 3, column 1), 1:1. Overlap 10 mm with the neighbouring tiles.

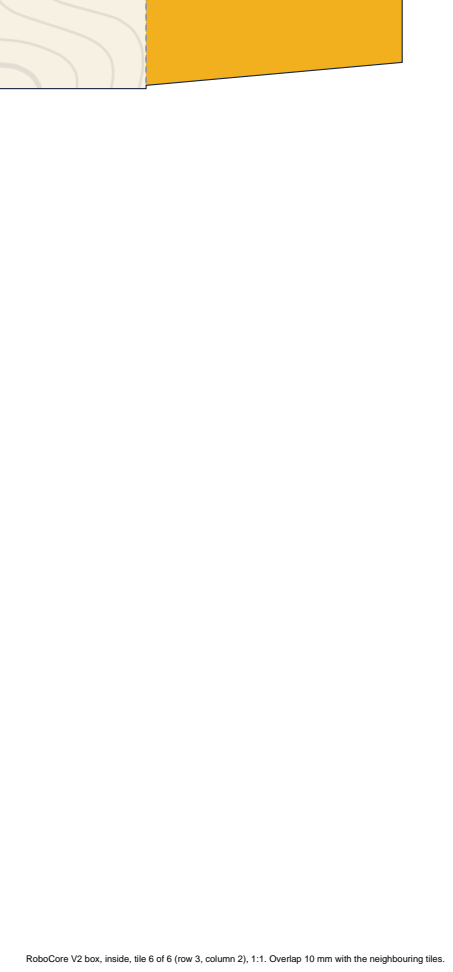
[picture p199: page 6]

RoboCore V2 box, inside, tile 6 of 6 (row 3, column 2), 1:1. Overlap 10 mm with the neighbouring tiles.
