Plastal-Bot-Builders/RoboCoreDocumentation/mechanical/robot_v2/packaging/out_v3/box_outside_A3_tiles.pdf

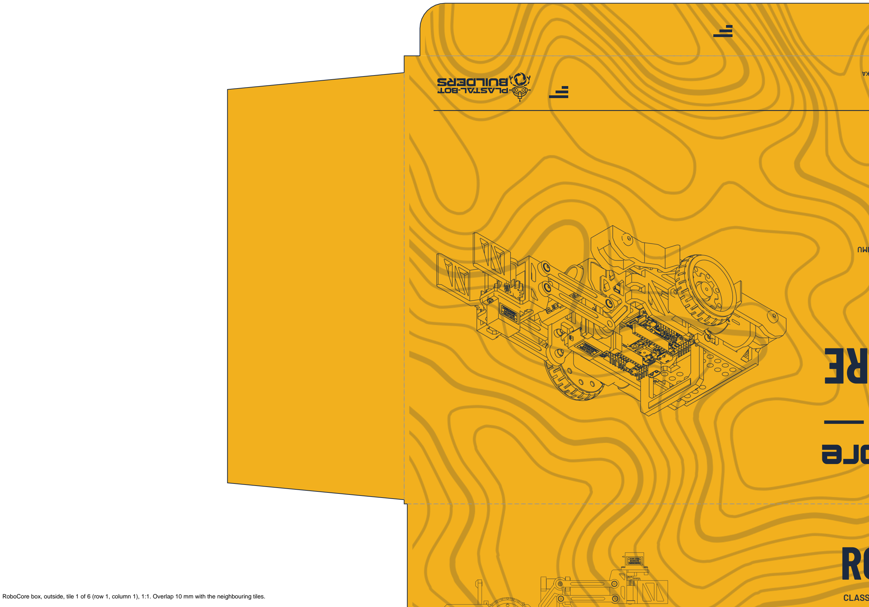
[picture p205: page 1]

# ROBOCORE

## CLASSROOM ROBOT · DESIGNED IN ZAMBIA

RoboCore box, outside, tile 1 of 6 (row 1, column 1), 1:1. Overlap 10 mm with the neighbouring tiles.

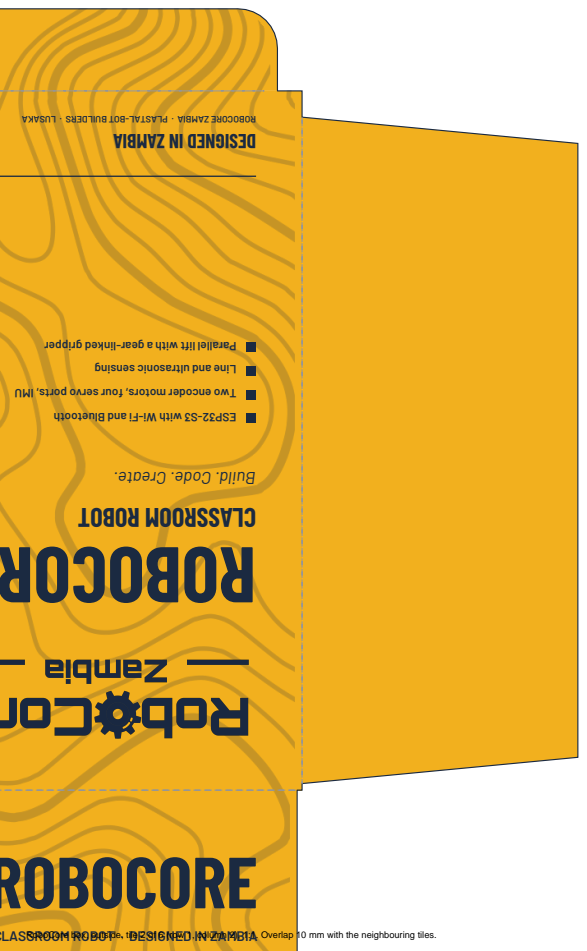
[picture p206: page 2]
ROBOCORE

RoboCore box, outside, tile 2 of 6 (row 1, column 2), 1:1. Overlap 10 mm with the neighbouring tiles.

# MEET ROBOCORE

A classroom robot designed and built in Zambia. Its RoboCore V2 controller puts an ESP32-S3 with Wi-Fi and Bluetooth, two encoder motor drives, four servo ports, a motion sensor and sockets for line and ultrasonic sensing on one board, running from 1S lithium cells with USB-C charging. The robot arrives assembled, with its lift and gripper fitted.
ESP32-S3 with Wi-Fi and Bluetooth
Two encoder motors, four servo ports, IMU
Line and ultrasonic sensing
Parallel lift with a gear-linked gripper

# WHAT'S IN THE BOX

ROBOT, ASSEMBLED | V2 CONTROLLER | 2 ENCODER MOTORS | ULTRASONIC | LINE SENSOR | LIFT + GRIPPER

RoboCore robot, assembled: printed frame, lift and gripper with 2 micro servos, RoboCore V2 controller, 2 encoder motors, HC-SR04 ultrasonic, 3-channel line sensor, 4 V-wheels and the battery cradle · USB-C cable · Screw pack · Quick-start card. 18650 cells are not included.

## SPECIFICATIONS

Controller RoboCore V2, ESP32-S3, 68 x 60 mm
Power 1S Li-ion, 3 x 18650 in parallel, USB-C charging
Drive 2 x DG01D-E encoder motors, 56 mm wheels, 4 V-wheels

Sensing 3-channel line sensor, HC-SR04 ultrasonic, IMU Robot 154 x 286 x 111 mm (lift level), about 620 g
Box 303 x 213 x 91 mm, E-flute card

DOCS & CODE

7 8 0 1 2 6 R C 2 0 2 6

Not a toy. Contains small parts and screws: not for children under 8. Use only 1S lithium cells; charge through USB-C under supervision. Keep metal away from the antenna.

# ROBOCORE

# ROBOCORE

### CLASSROOM ROBOT

# DESIGNED IN ZAMBIA

RoboCore · 2026 · plastalbotbuilders.com

RoboCore box, outside, tile 3 of 6 (row 2, column 1), 1:1. Overlap 10 mm with the neighbouring tiles.

# ROBOCORE

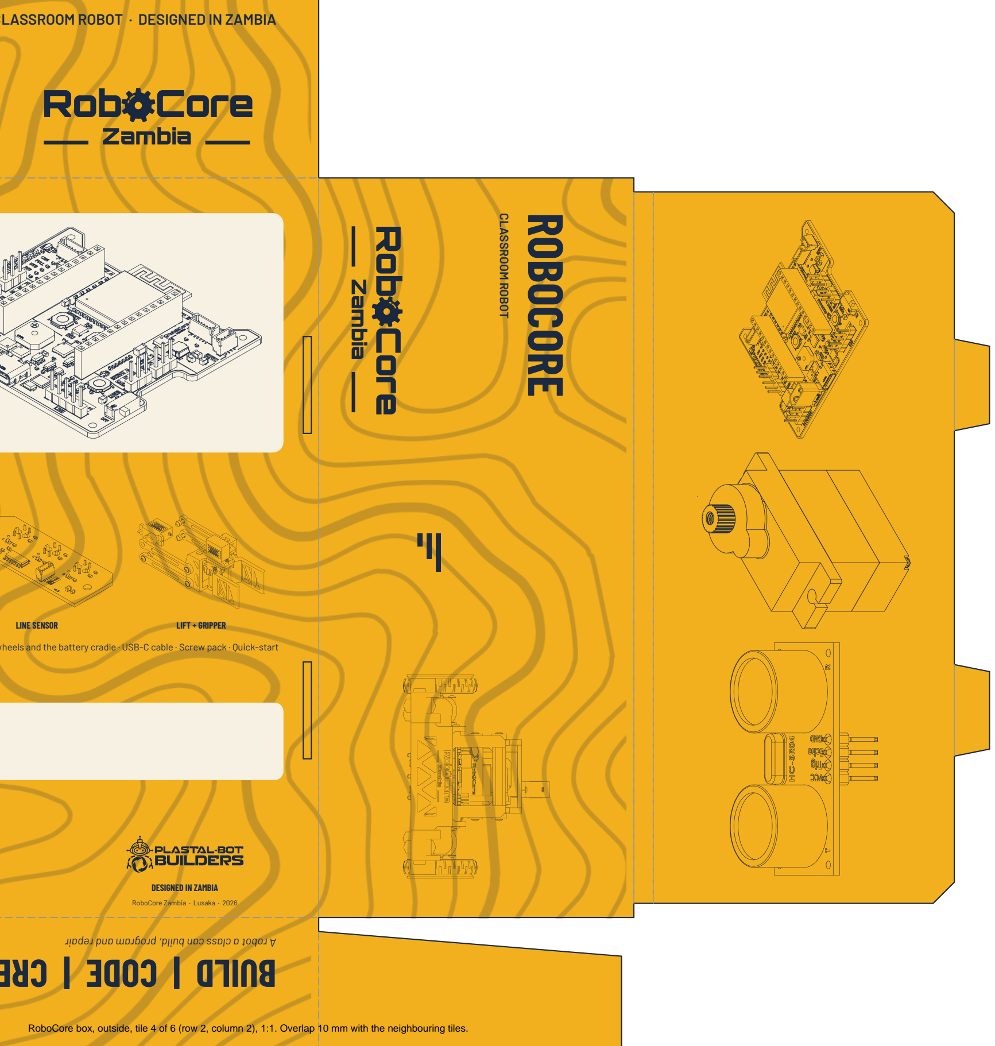
[picture p207: page 4]

ROBOT, ASSEMBLED | V2 CONTROLLER | 2 ENCODER MOTORS | ULTRASONIC | LINE SENSOR | LIFT + GRIPPER

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

DESIGNED IN ZAMBIA

RoboCore Zambia · Lusaka · 2026

### CLASSROOM ROBOT

# ROBOCORE

RoboCore box, outside, tile 4 of 6 (row 2, column 2), 1:1. Overlap 10 mm with the neighbouring tiles.

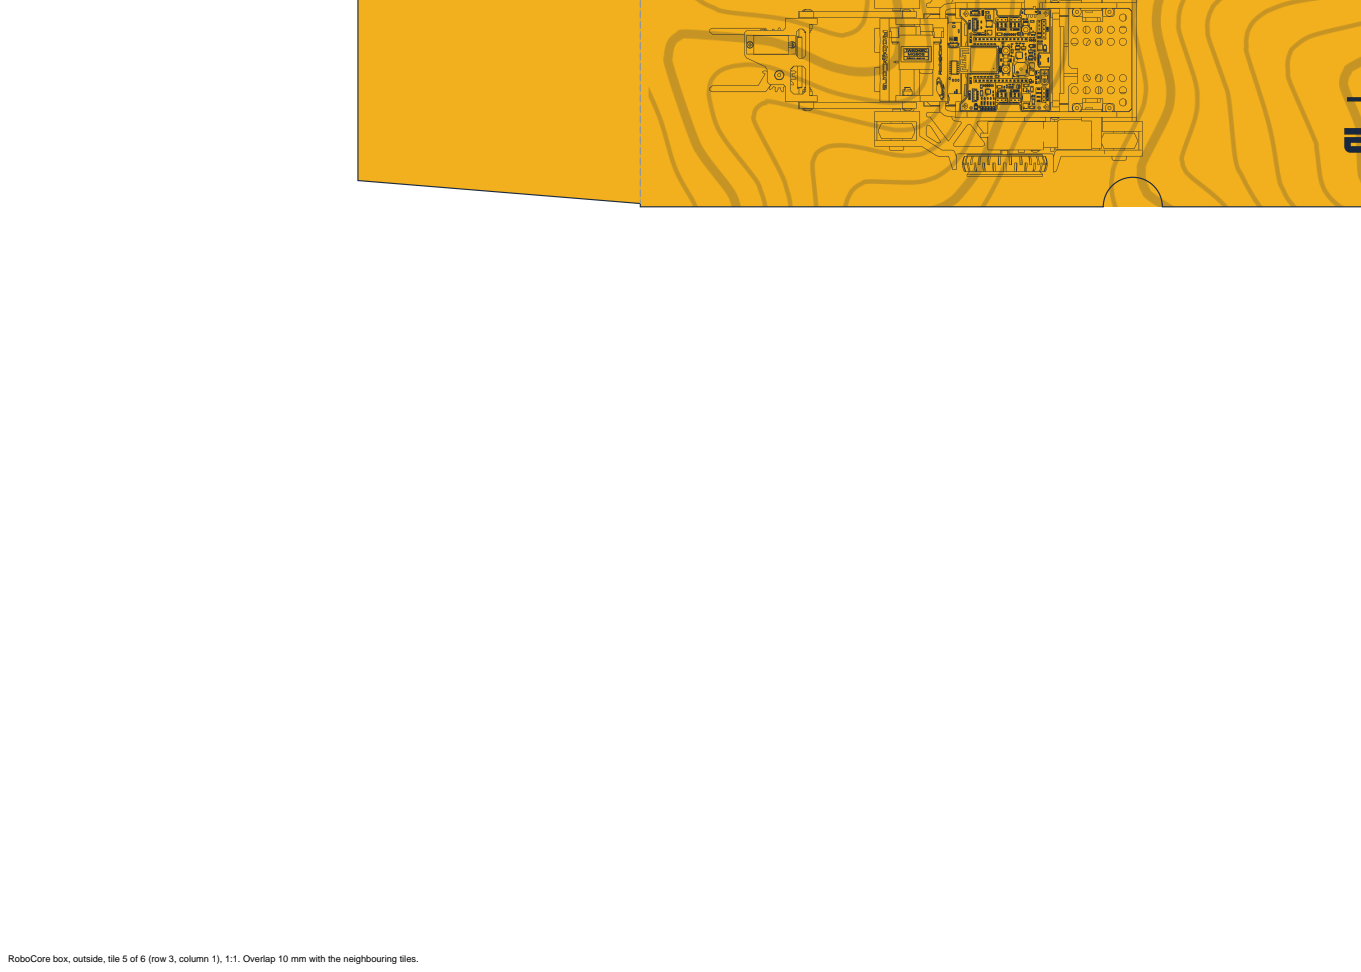
[picture p208: page 5]

RoboCore box, outside, tile 5 of 6 (row 3, column 1), 1:1. Overlap 10 mm with the neighbouring tiles.

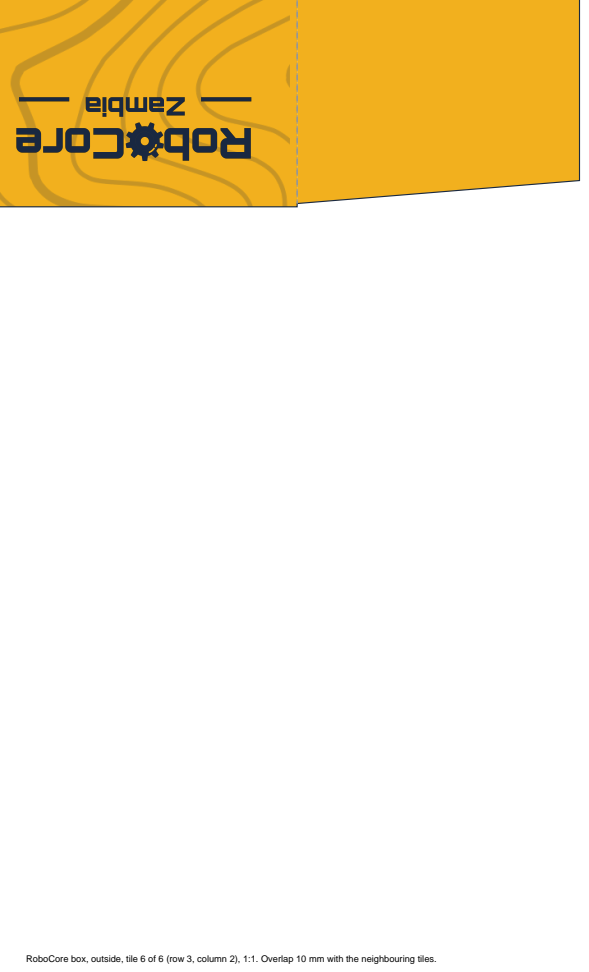
[picture p209: page 6]

RoboCore box, outside, tile 6 of 6 (row 3, column 2), 1:1. Overlap 10 mm with the neighbouring tiles.
