Plastal-Bot-Builders/RoboCoreDocumentation/hardware/controller_v1/RoboCore.kicad_pcb

## KiCad design hardware/controller_v1/RoboCore.kicad_pcb (2026-10-12, an earlier design)

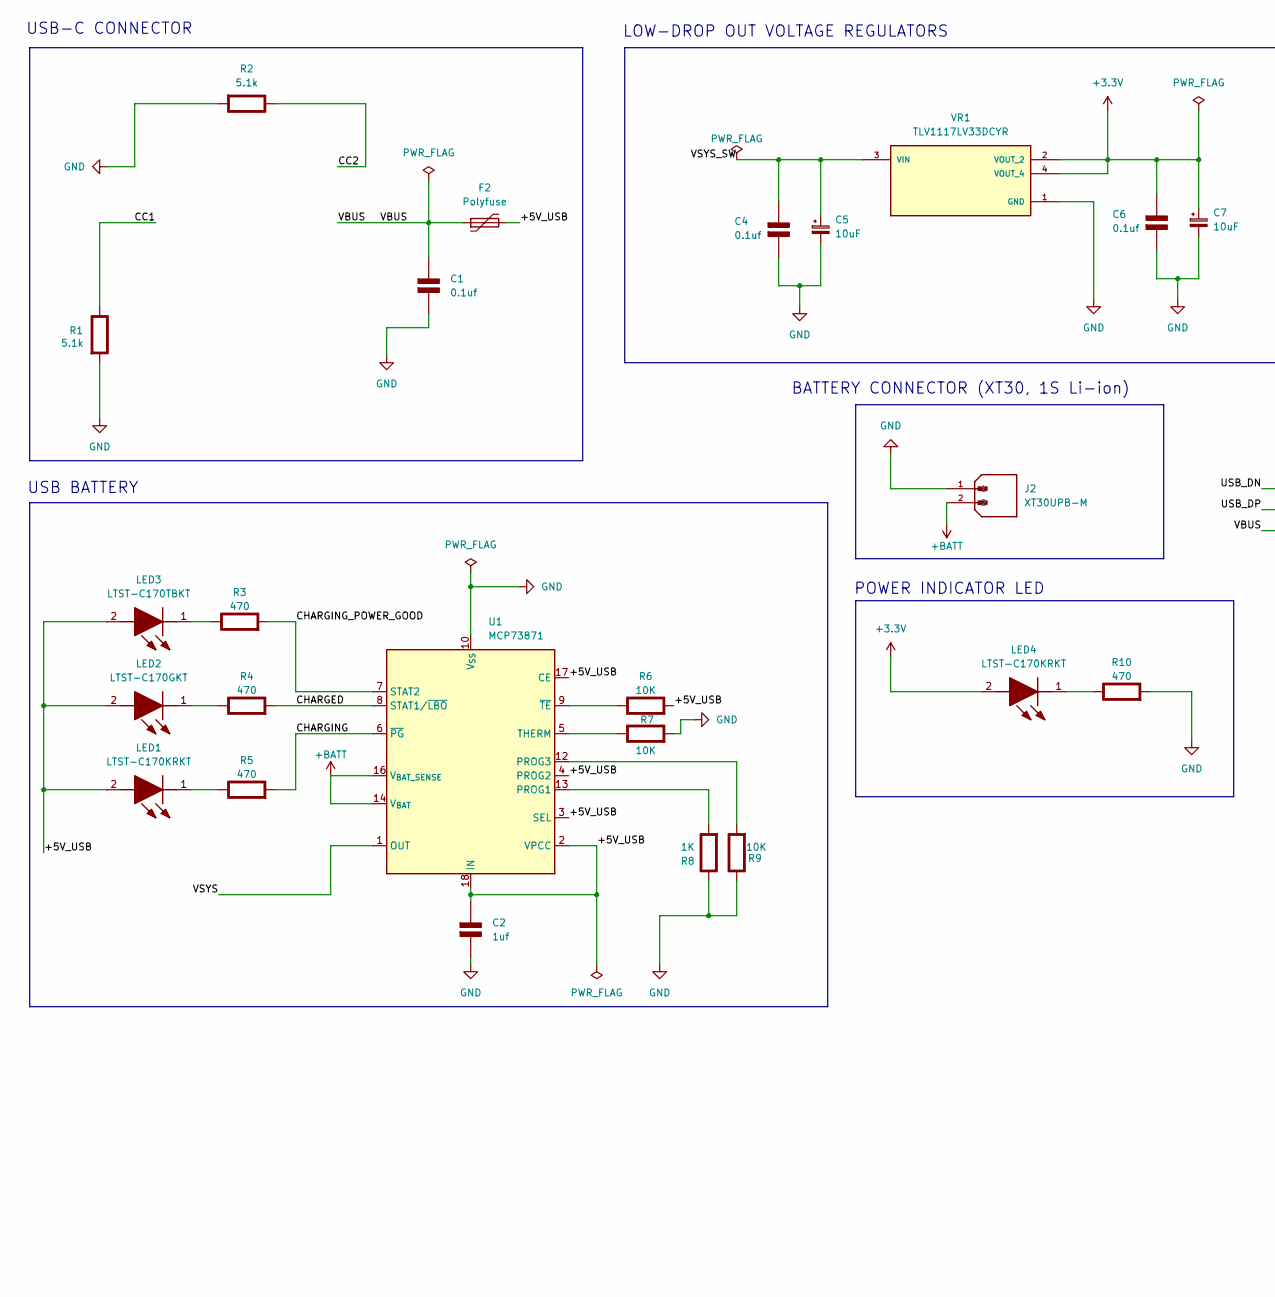
[picture p210: schematic RoboCore.kicad_sch, part in row 1, column 1]

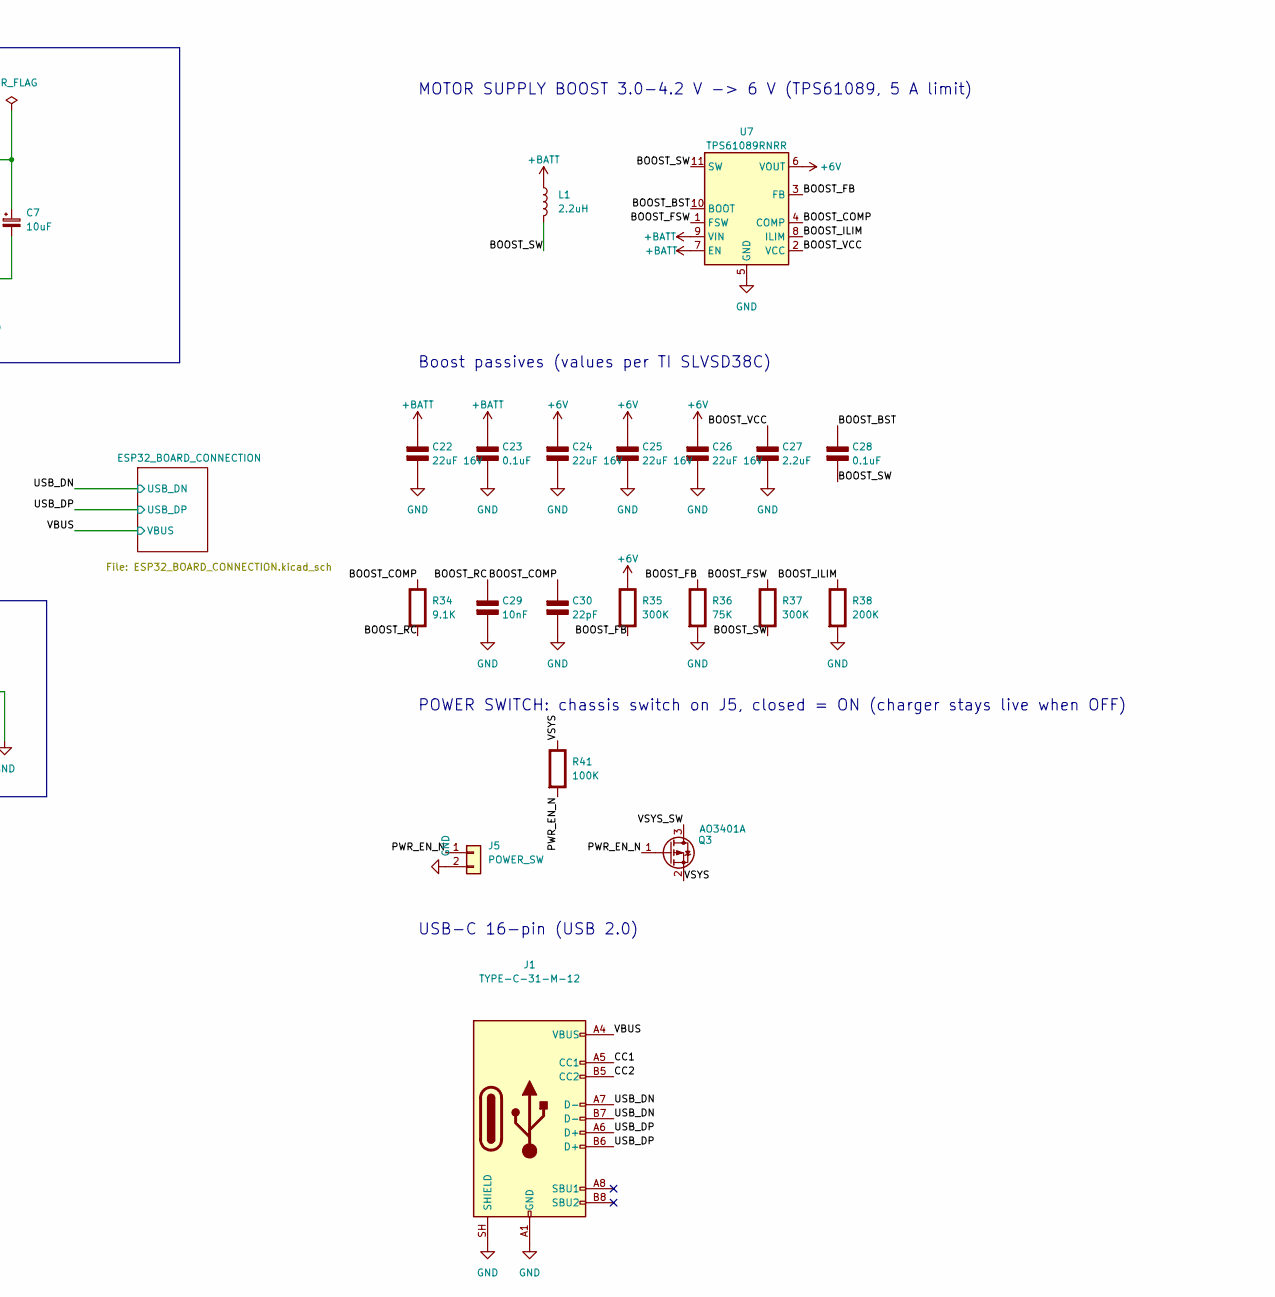
[picture p211: schematic RoboCore.kicad_sch, part in row 1, column 2]

Parts:
C1, C4, C6: 0.1uf; C_0805_2012Metric; Rating V
C2: 1uf; C_0805_2012Metric; Rating V
C5, C7: 10uF; T491A
C22, C24, C25, C26: 22uF 16V; C_1206_3216Metric
C23, C28: 0.1uF; C_0603_1608Metric
C27: 2.2uF; C_0603_1608Metric
C29: 10nF; C_0603_1608Metric
C30: 22pF; C_0603_1608Metric
F2: Polyfuse; FUSSC324X455X250-2N
J1: TYPE-C-31-M-12; USB_C_Receptacle_HRO_TYPE-C-31-M-12
J2: XT30UPB-M; AMASS_XT30UPB-M_1x02_P5.0mm_Vertical; PARTREV N/A
J5: POWER_SW; JST_PH_B2B-PH-K_1x02_P2.00mm_Vertical
L1: 2.2uH; L_Coilcraft_XAL5030-XXX
LED1, LED4: LTST-C170KRKT; LEDC2012X120N; Manufacturer_Part_Number LTST-C170KRKT; Mouser Part Number 859-LTST-C170KRKT
LED2: LTST-C170GKT; LEDC2012X120N; Manufacturer_Part_Number LTST-C170GKT; Mouser Part Number 859-LTST-C170GKT
LED3: LTST-C170TBKT; LEDC2012X120N; Manufacturer_Part_Number LTST-C170TBKT; Mouser Part Number 859-LTST-C170TBKT
Q3: AO3401A; SOT-23
R1, R2: 5.1k; R_0805_2012Metric; Rating W
R3, R4, R5, R10: 470; R_0805_2012Metric; Rating W
R6, R7, R9: 10K; R_0805_2012Metric; Rating W
R8: 1K; R_0805_2012Metric; Rating W
R34: 9.1K; R_0603_1608Metric
R35, R37: 300K; R_0603_1608Metric
R36: 75K; R_0603_1608Metric
R38: 200K; R_0603_1608Metric
R41: 100K; R_0805_2012Metric
U1: MCP73871; QFN-20-1EP_4x4mm_P0.5mm_EP2.5x2.5mm
U7: TPS61089RNRR; Texas_VQFN-RNR0011A-11
VR1: TLV1117LV33DCYR; VREG_LM1117MPX-3.3_NOPB

Connections:
+3.3V: C6.1 (+), C7.1, LED4.2 (A), VR1.2 (VOUT_2), VR1.4 (VOUT_4); also elsewhere on the board
+6V: C24.1 (+), C25.1 (+), C26.1 (+), R35.1 (+), U7.6 (VOUT); also elsewhere on the board
+BATT: C22.1 (+), C23.1 (+), J2.2, L1.1, U1.14 (V_{BAT}), U1.15 (V_{BAT}), U1.16 (V_{BAT_SENSE}), U7.7 (EN), U7.9 (VIN); also elsewhere on the board
/+5V_USB: C2.1 (+), F2.2, LED1.2 (A), LED2.2 (A), LED3.2 (A), R6.2 (-), U1.2 (VPCC), U1.3 (SEL), U1.4 (PROG2), U1.17 (CE), U1.18 (IN), U1.19 (IN)
/BOOST_BST: C28.1 (+), U7.10 (BOOT)
/BOOST_COMP: C30.1 (+), R34.1 (+), U7.4 (COMP)
/BOOST_FB: R35.2 (-), R36.1 (+), U7.3 (FB)
/BOOST_FSW: R37.1 (+), U7.1 (FSW)
/BOOST_ILIM: R38.1 (+), U7.8 (ILIM)
/BOOST_RC: C29.1 (+), R34.2 (-)
/BOOST_SW: C28.2 (-), L1.2, R37.2 (-), U7.11 (SW)
/BOOST_VCC: C27.1 (+), U7.2 (VCC)
/CC1: J1.A5 (CC1), R1.1 (+)
/CC2: J1.B5 (CC2), R2.1 (+)
/CHARGED: R4.2 (-), U1.8 (STAT1/~LBO)
/CHARGING: R5.2 (-), U1.6 (~PG)
/CHARGING_POWER_GOOD: R3.2 (-), U1.7 (STAT2)
/PWR_EN_N: J5.1, Q3.1 (G), R41.2 (-)
/USB_DN: J1.A7 (D-), J1.B7 (D-); also elsewhere on the board
/USB_DP: J1.A6 (D+), J1.B6 (D+); also elsewhere on the board
/VBUS: C1.1 (+), F2.1, J1.A4 (VBUS), J1.A9 (VBUS), J1.B4 (VBUS), J1.B9 (VBUS); also elsewhere on the board
/VSYS: Q3.2 (S), R41.1 (+), U1.1 (OUT), U1.20 (OUT)
/VSYS_SW: C4.1 (+), C5.1, Q3.3 (D), VR1.3 (VIN)
unnamed: LED1.1 (K), R5.1 (+)
unnamed: LED2.1 (K), R4.1 (+)
unnamed: LED3.1 (K), R3.1 (+)
unnamed: LED4.1 (K), R10.1 (+)
unnamed: R6.1 (+), U1.9 (~TE)
unnamed: R7.1 (+), U1.5 (THERM)
unnamed: R8.2 (-), U1.13 (PROG1)
unnamed: R9.2 (-), U1.12 (PROG3)

Notes on the sheet:
USB BATTERY
Boost passives (values per TI SLVSD38C)
POWER INDICATOR LED
BATTERY CONNECTOR (XT30, 1S Li-ion)
LOW-DROP OUT VOLTAGE REGULATORS
USB-C 16-pin (USB 2.0)
MOTOR SUPPLY BOOST 3.0-4.2 V -> 6 V (TPS61089, 5 A limit)
POWER SWITCH: chassis switch on J5, closed = ON (charger stays live when OFF)
USB-C CONNECTOR

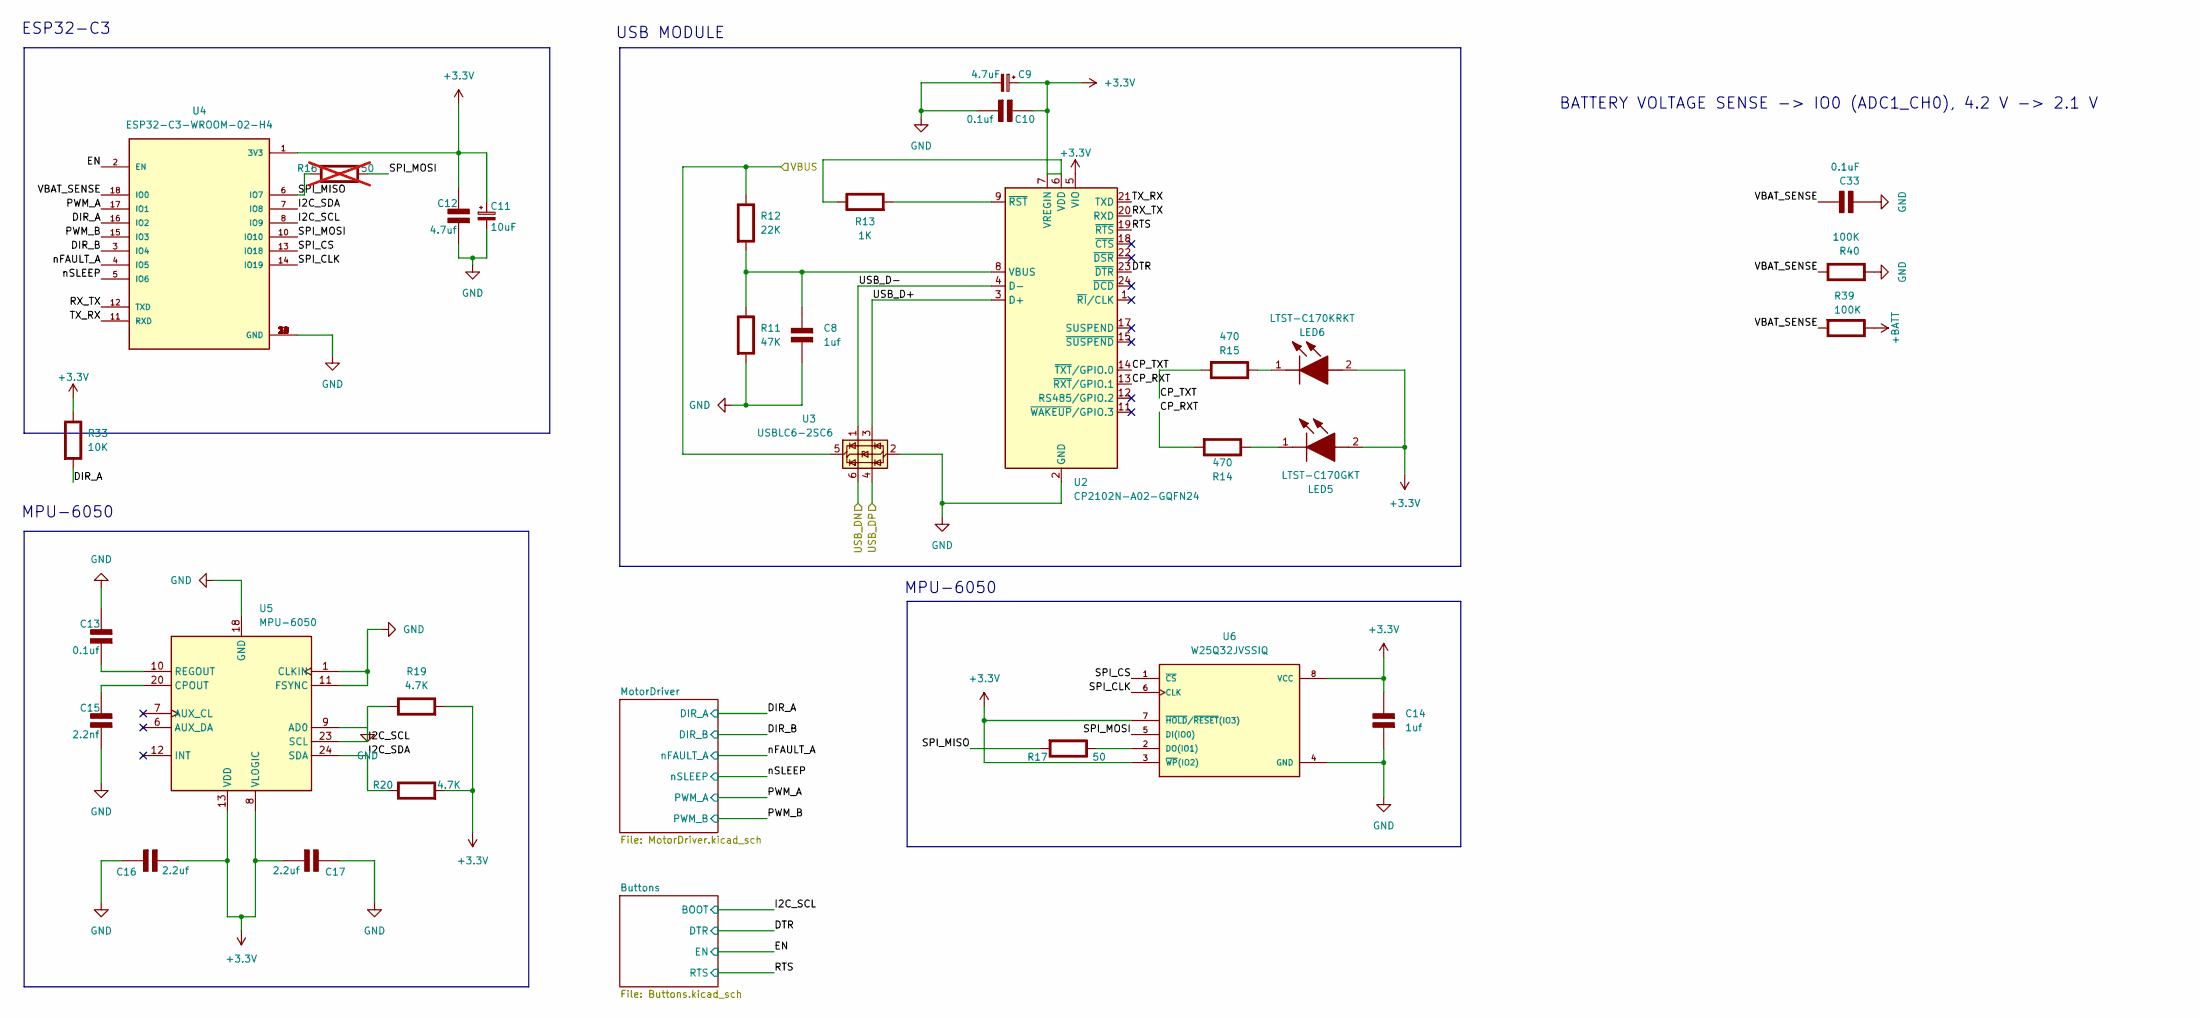
[picture p212: schematic ESP32_BOARD_CONNECTION.kicad_sch]

Parts:
C8, C14: 1uf; C_0805_2012Metric; Rating V
C9: 4.7uF; T491A
C10, C13: 0.1uf; C_0805_2012Metric; Rating V
C11: 10uF; T491A
C12: 4.7uf; C_0805_2012Metric; Rating V
C15: 2.2nf; C_0805_2012Metric; Rating V
C16, C17: 2.2uf; C_0805_2012Metric; Rating V
C33: 0.1uF; C_0805_2012Metric
LED5: LTST-C170GKT; LEDC2012X120N; Manufacturer_Part_Number LTST-C170GKT; Mouser Part Number 859-LTST-C170GKT
LED6: LTST-C170KRKT; LEDC2012X120N; Manufacturer_Part_Number LTST-C170KRKT; Mouser Part Number 859-LTST-C170KRKT
R11: 47K; R_0805_2012Metric; Rating W
R12: 22K; R_0805_2012Metric; Rating W
R13: 1K; R_0805_2012Metric; Rating W
R14, R15: 470; R_0805_2012Metric; Rating W
R16: 50; R_0805_2012Metric; Rating W; not fitted
R17: 50; R_0805_2012Metric; Rating W
R19, R20: 4.7K; R_0805_2012Metric; Rating W
R33: 10K; R_0805_2012Metric
R39, R40: 100K; R_0805_2012Metric
U2: CP2102N-A02-GQFN24; QFN-24-1EP_4x4mm_P0.5mm_EP2.6x2.6mm
U3: USBLC6-2SC6; SOT-23-6
U4: ESP32-C3-WROOM-02-H4; MODULE_ESP32-C3-WROOM-02-H4
U5: MPU-6050; InvenSense_QFN-24_4x4mm_P0.5mm
U6: W25Q32JVSSIQ; SOIC127P790X216-8N; M_PART_NUMBER W25QXX

Connections:
+3.3V: C9.1, C10.1 (+), C11.1, C12.2 (-), C14.2 (-), C16.1 (+), C17.1 (+), LED5.2 (A), LED6.2 (A), R13.1 (+), R19.2 (-), R20.2 (-), R33.1 (+), U2.5 (VIO), U2.6 (VDD), U2.7 (VREGIN), U4.1 (3V3), U5.8 (VLOGIC), U5.13 (VDD), U6.3 (~WP(IO2)), U6.7 (~HOLD/~RESET(IO3)), U6.8 (VCC); also elsewhere on the board
+BATT: R39.1 (+); also elsewhere on the board
/ESP32_BOARD_CONNECTION/CP_RXT: R14.2 (-), U2.13 (~RXT/GPIO.1)
/ESP32_BOARD_CONNECTION/CP_TXT: R15.2 (-), U2.14 (~TXT/GPIO.0)
/ESP32_BOARD_CONNECTION/DIR_A: R33.2 (-), U4.16 (IO2); also elsewhere on the board
/ESP32_BOARD_CONNECTION/DIR_B: U4.3 (IO4); also elsewhere on the board
/ESP32_BOARD_CONNECTION/DTR: U2.23 (~DTR); also elsewhere on the board
/ESP32_BOARD_CONNECTION/EN: U4.2 (EN); also elsewhere on the board
/ESP32_BOARD_CONNECTION/I2C_SDA: R20.1 (+), U4.7 (IO8), U5.24 (SDA)
/ESP32_BOARD_CONNECTION/PWM_A: U4.17 (IO1); also elsewhere on the board
/ESP32_BOARD_CONNECTION/PWM_B: U4.15 (IO3); also elsewhere on the board
/ESP32_BOARD_CONNECTION/RTS: U2.19 (~RTS); also elsewhere on the board
/ESP32_BOARD_CONNECTION/RX_TX: U2.20 (RXD), U4.12 (TXD)
/ESP32_BOARD_CONNECTION/SPI_CLK: U4.14 (IO19), U6.6 (CLK)
/ESP32_BOARD_CONNECTION/SPI_CS: U4.13 (IO18), U6.1 (~CS)
/ESP32_BOARD_CONNECTION/SPI_MISO: R16.1 (+), R17.2 (-), U4.6 (IO7)
/ESP32_BOARD_CONNECTION/SPI_MOSI: R16.2 (-), U4.10 (IO10), U6.5 (DI(IO0))
/ESP32_BOARD_CONNECTION/TX_RX: U2.21 (TXD), U4.11 (RXD)
/ESP32_BOARD_CONNECTION/USB_D+: U2.3 (D+), U3.3 (I/O2)
/ESP32_BOARD_CONNECTION/USB_D-: U2.4 (D-), U3.1 (I/O1)
/ESP32_BOARD_CONNECTION/VBAT_SENSE: C33.1 (+), R39.2 (-), R40.1 (+), U4.18 (IO0)
/ESP32_BOARD_CONNECTION/nFAULT_A: U4.4 (IO5); also elsewhere on the board
/ESP32_BOARD_CONNECTION/nSLEEP: U4.5 (IO6); also elsewhere on the board
/USB_DN: U3.6 (I/O1); also elsewhere on the board
/USB_DP: U3.4 (I/O2); also elsewhere on the board
/VBUS: R12.1 (+), U3.5 (VBUS); also elsewhere on the board
unnamed: C8.2 (-), R11.1 (+), R12.2 (-), U2.8 (VBUS)
unnamed: C13.1 (+), U5.10 (REGOUT)
unnamed: C15.2 (-), U5.20 (CPOUT)
unnamed: LED5.1 (K), R14.1 (+)
unnamed: LED6.1 (K), R15.1 (+)
unnamed: R13.2 (-), U2.9 (~RST)
unnamed: R17.1 (+), U6.2 (DO(IO1))

Notes on the sheet:
BATTERY VOLTAGE SENSE -> IO0 (ADC1_CH0), 4.2 V -> 2.1 V
USB MODULE
ESP32-C3
MPU-6050

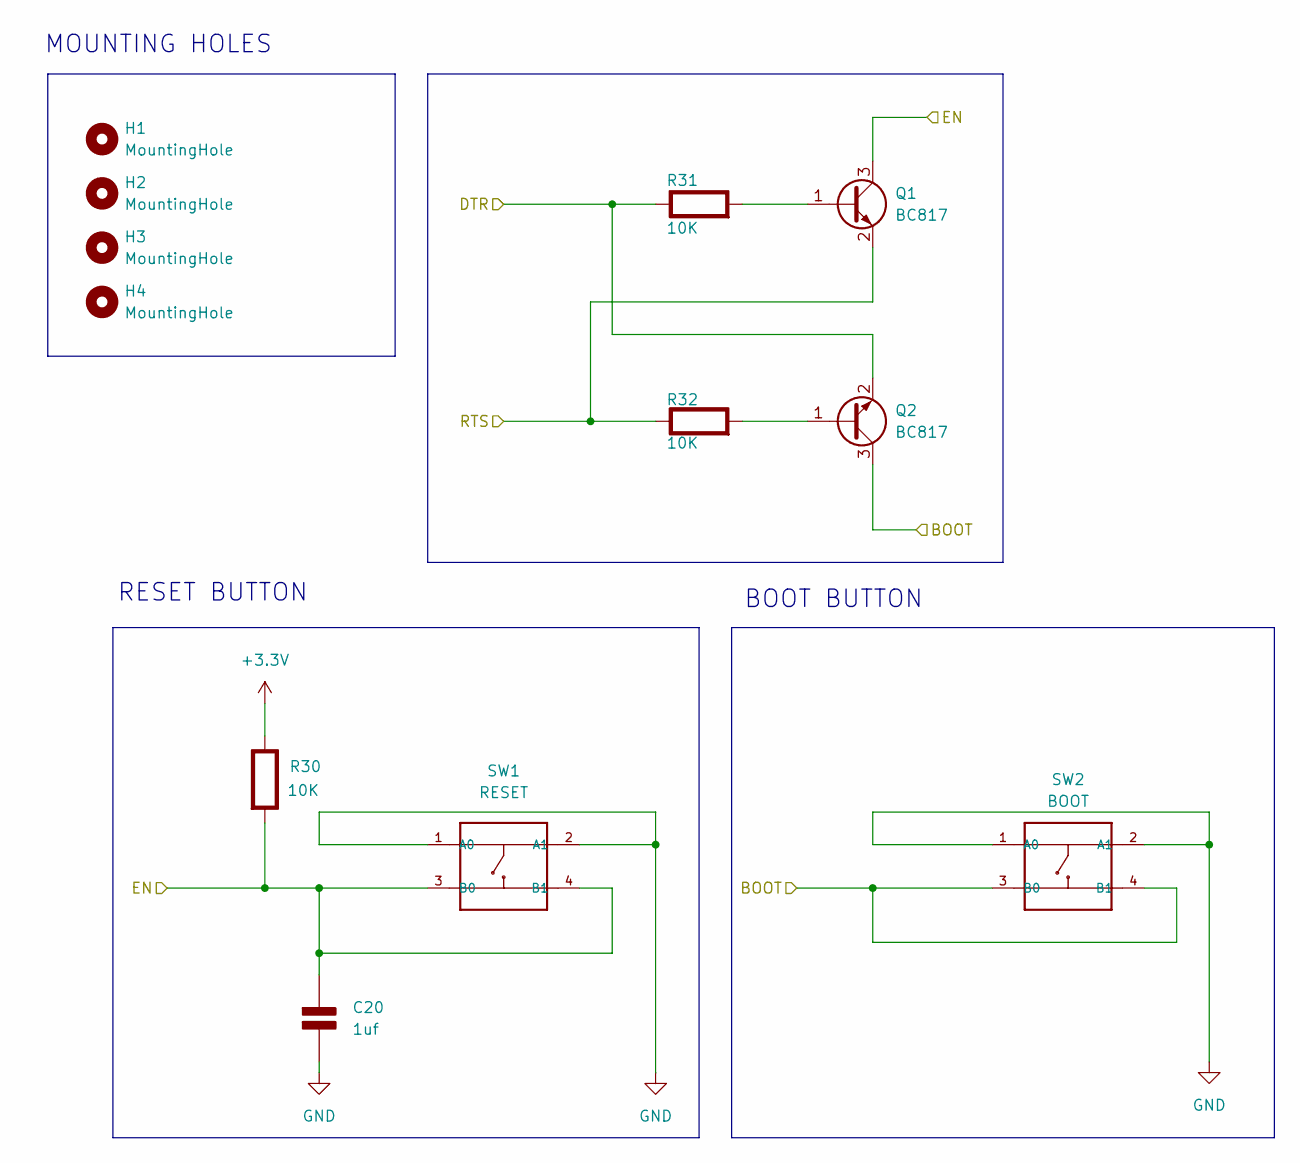
[picture p213: schematic Buttons.kicad_sch]

Parts:
C20: 1uf; C_0805_2012Metric; Rating V
H1, H2, H3, H4: MountingHole; MountingHole_2mm
Q1, Q2: BC817; SOT-23
R30, R31, R32: 10K; R_0805_2012Metric; Rating W
SW1: RESET; SW4-SMD-5.2X5.2X1.5MM
SW2: BOOT; SW4-SMD-5.2X5.2X1.5MM

Connections:
+3.3V: R30.1 (+); also elsewhere on the board
/ESP32_BOARD_CONNECTION/DTR: Q2.2 (E), R31.1 (+); also elsewhere on the board
/ESP32_BOARD_CONNECTION/EN: C20.1 (+), Q1.3 (C), R30.2 (-), SW1.3 (B0), SW1.4 (B1); also elsewhere on the board
/ESP32_BOARD_CONNECTION/RTS: Q1.2 (E), R32.1 (+); also elsewhere on the board
unnamed: Q1.1 (B), R31.2 (-)
unnamed: Q2.1 (B), R32.2 (-)

Notes on the sheet:
MOUNTING HOLES
RESET BUTTON
BOOT BUTTON

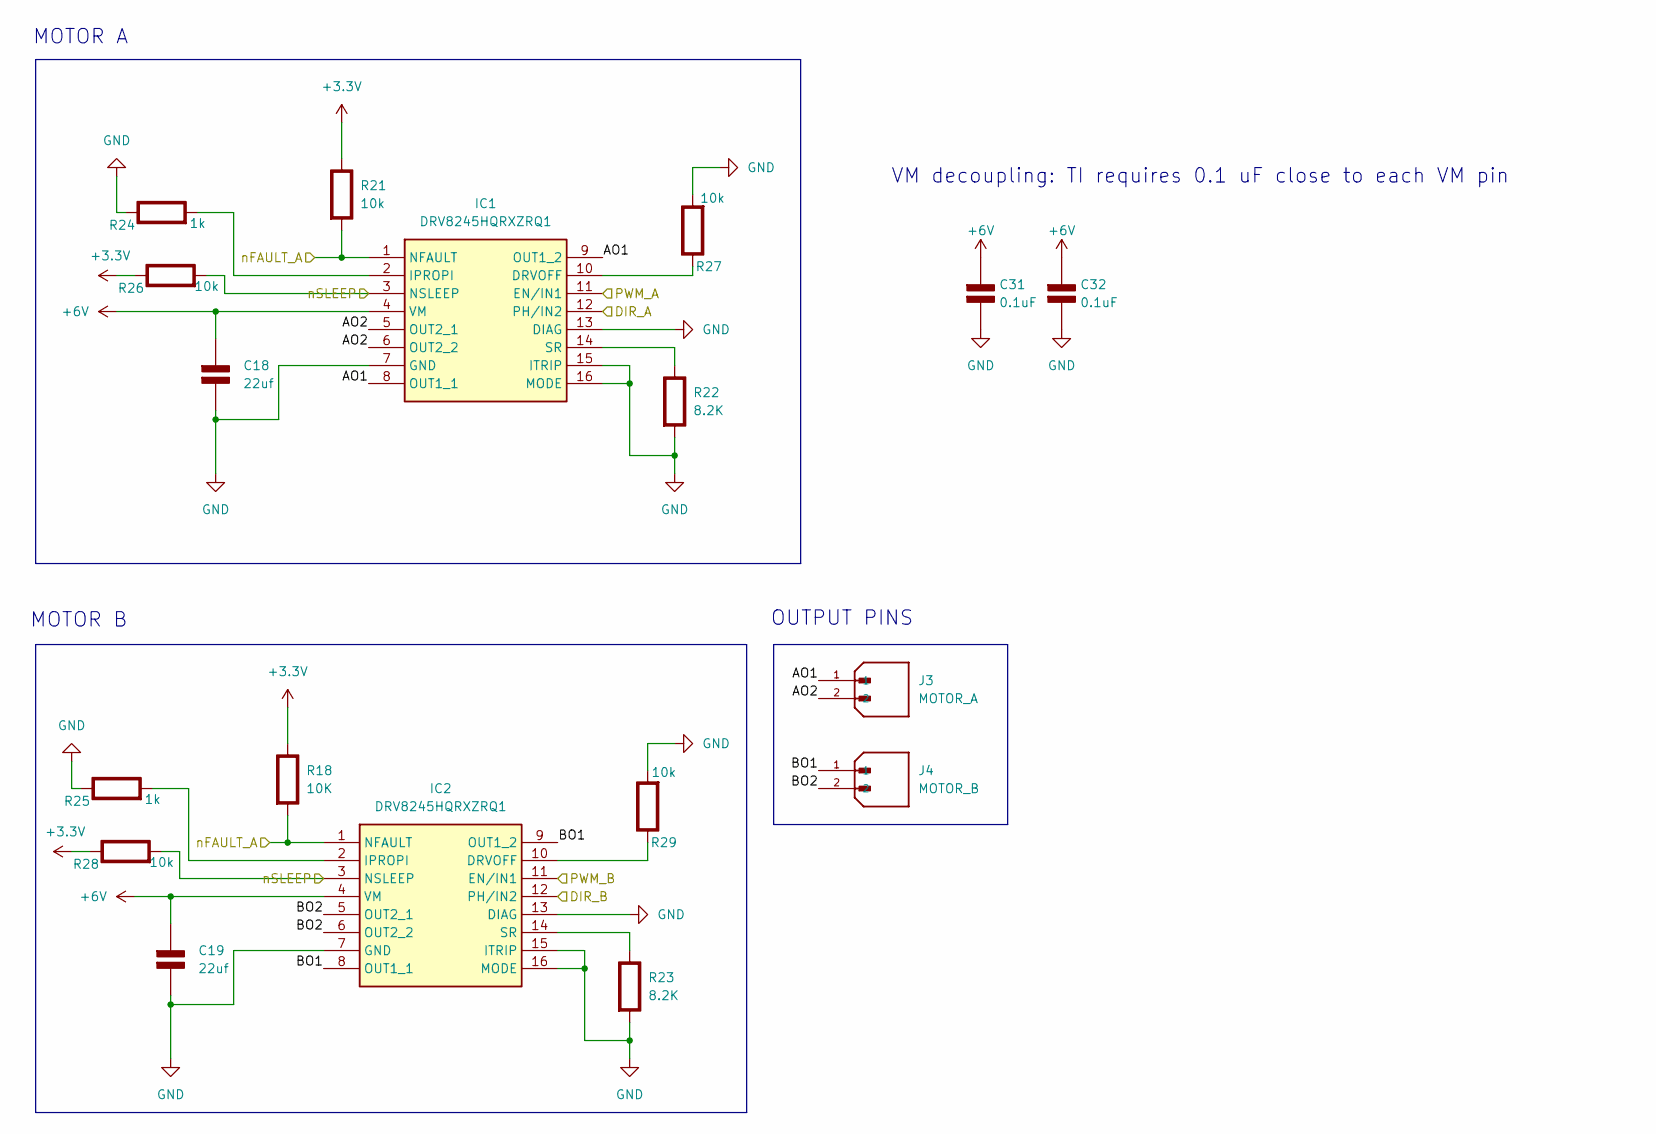
[picture p214: schematic MotorDriver.kicad_sch]

Parts:
C18, C19: 22uf; C_0805_2012Metric; Rating V
C31, C32: 0.1uF; C_0805_2012Metric
IC1, IC2: DRV8245HQRXZRQ1; Manufacturer_Part_Number DRV8245HQRXZRQ1; Mouser Part Number 595-DRV8245HQRXZRQ1
J3: MOTOR_A; JST_B2B-PH-SM4-TB; PARTREV N/A
J4: MOTOR_B; JST_B2B-PH-SM4-TB; PARTREV N/A
R18: 10K; R_0805_2012Metric; Rating W
R21, R26, R27, R28, R29: 10k; R_0805_2012Metric; Rating W
R22, R23: 8.2K; R_0805_2012Metric; Rating W
R24, R25: 1k; R_0805_2012Metric; Rating W

Connections:
+3.3V: R18.1 (+), R21.1 (+), R26.1 (+), R28.1 (+); also elsewhere on the board
+6V: C18.1 (+), C19.1 (+), C31.1 (+), C32.1 (+), IC1.4 (VM), IC2.4 (VM); also elsewhere on the board
/ESP32_BOARD_CONNECTION/DIR_A: IC1.12 (PH/IN2); also elsewhere on the board
/ESP32_BOARD_CONNECTION/DIR_B: IC2.12 (PH/IN2); also elsewhere on the board
/ESP32_BOARD_CONNECTION/MotorDriver/AO1: IC1.8 (OUT1_1), IC1.9 (OUT1_2), J3.1
/ESP32_BOARD_CONNECTION/MotorDriver/AO2: IC1.5 (OUT2_1), IC1.6 (OUT2_2), J3.2
/ESP32_BOARD_CONNECTION/MotorDriver/BO1: IC2.8 (OUT1_1), IC2.9 (OUT1_2), J4.1
/ESP32_BOARD_CONNECTION/MotorDriver/BO2: IC2.5 (OUT2_1), IC2.6 (OUT2_2), J4.2
/ESP32_BOARD_CONNECTION/PWM_A: IC1.11 (EN/IN1); also elsewhere on the board
/ESP32_BOARD_CONNECTION/PWM_B: IC2.11 (EN/IN1); also elsewhere on the board
/ESP32_BOARD_CONNECTION/nFAULT_A: IC1.1 (NFAULT), IC2.1 (NFAULT), R18.2 (-), R21.2 (-); also elsewhere on the board
/ESP32_BOARD_CONNECTION/nSLEEP: IC1.3 (NSLEEP), IC2.3 (NSLEEP), R26.2 (-), R28.2 (-); also elsewhere on the board
unnamed: IC1.10 (DRVOFF), R27.1 (+)
unnamed: IC1.2 (IPROPI), R24.2 (-)
unnamed: IC1.14 (SR), R22.1 (+)
unnamed: IC2.10 (DRVOFF), R29.1 (+)
unnamed: IC2.2 (IPROPI), R25.2 (-)
unnamed: IC2.14 (SR), R23.1 (+)

Notes on the sheet:
VM decoupling: TI requires 0.1 uF close to each VM pin
MOTOR A
OUTPUT PINS
MOTOR B

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
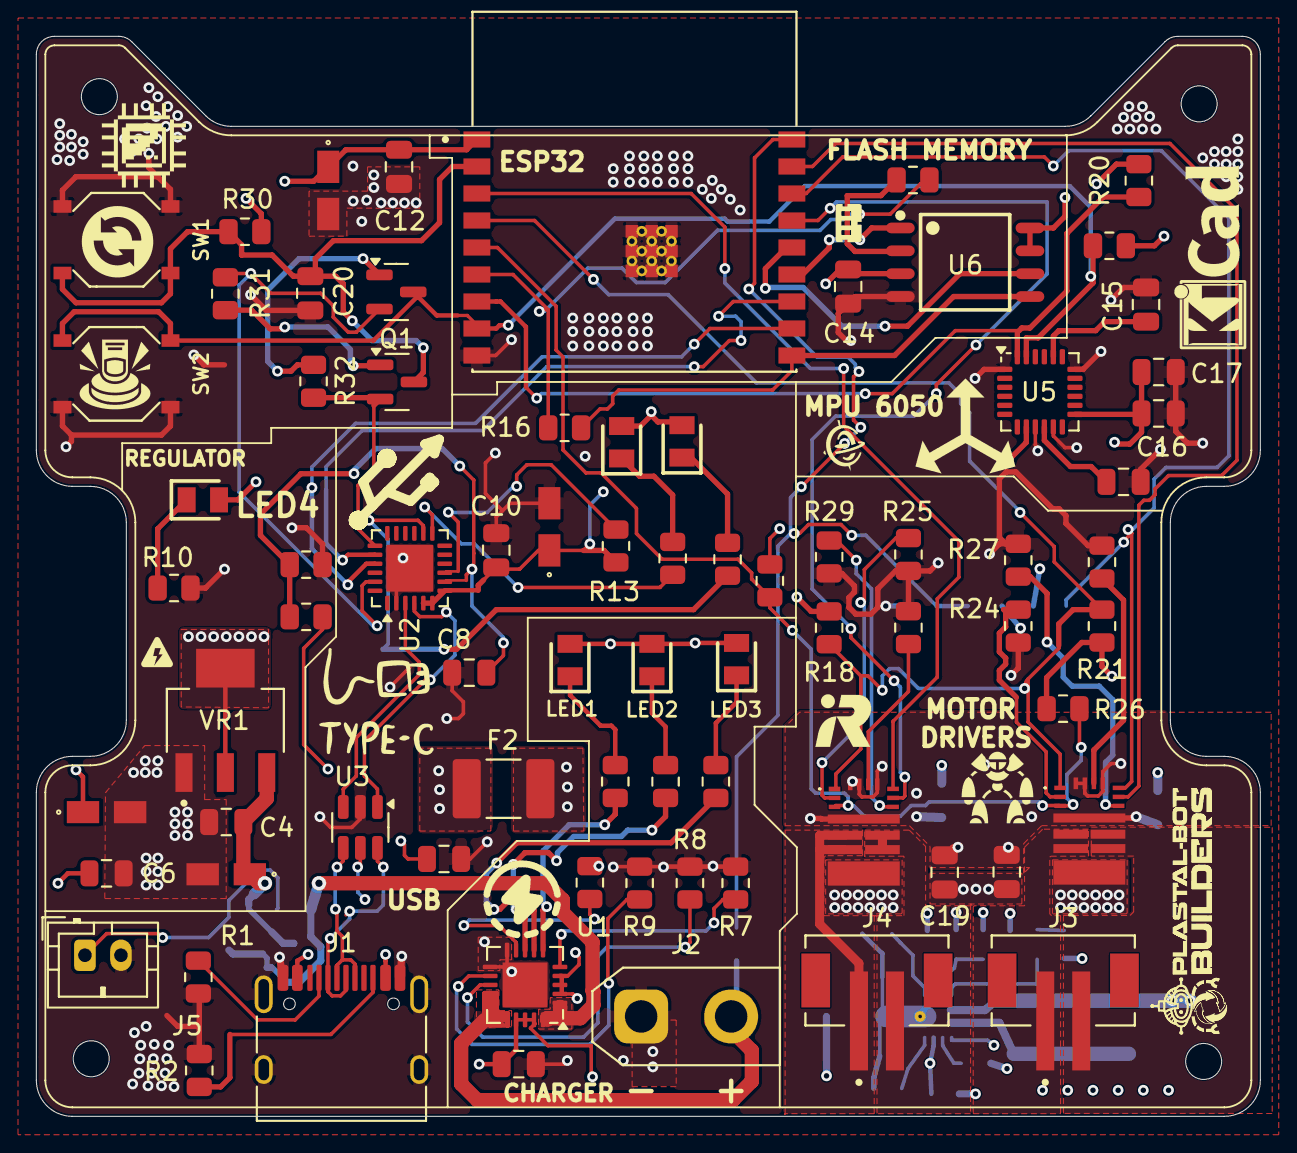
[picture p215: board RoboCore.kicad_pcb from above]

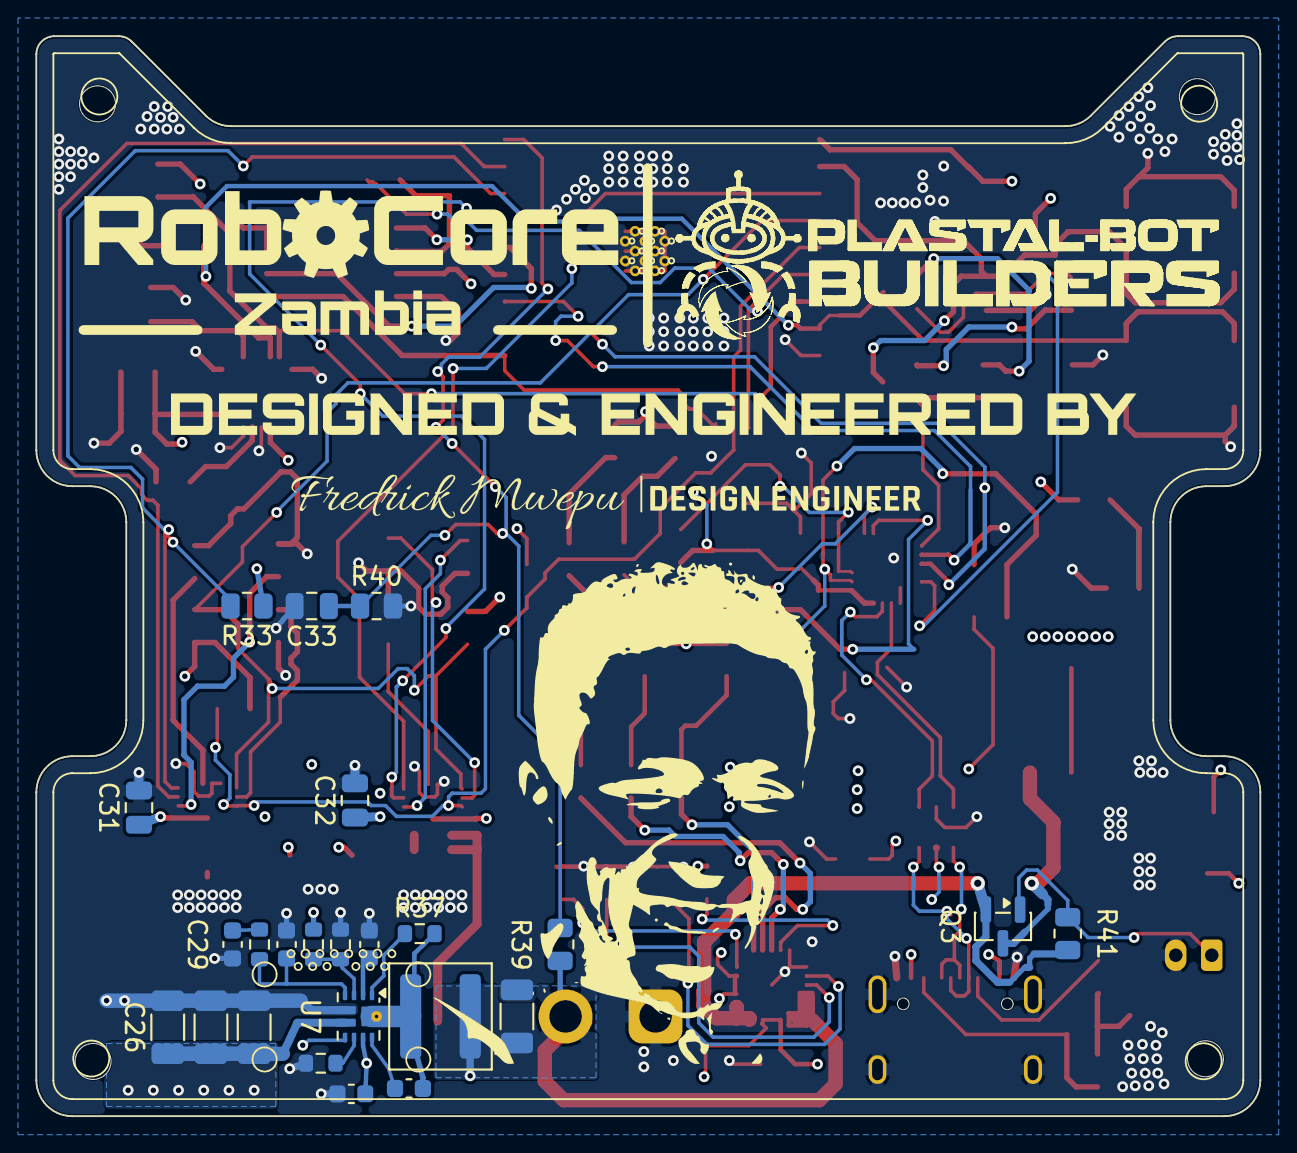
[picture p216: board RoboCore.kicad_pcb from below]

Board: 4 copper layers, 68.0 x 60.0 mm, 104 parts (24 on the bottom side), 73 nets.
