Plastal-Bot-Builders/RoboCoreDocumentation/hardware/sensors/line_sensor/RoboCore_LineSensor.kicad_pcb

## KiCad design hardware/sensors/line_sensor/RoboCore_LineSensor.kicad_pcb (2026-10-12)

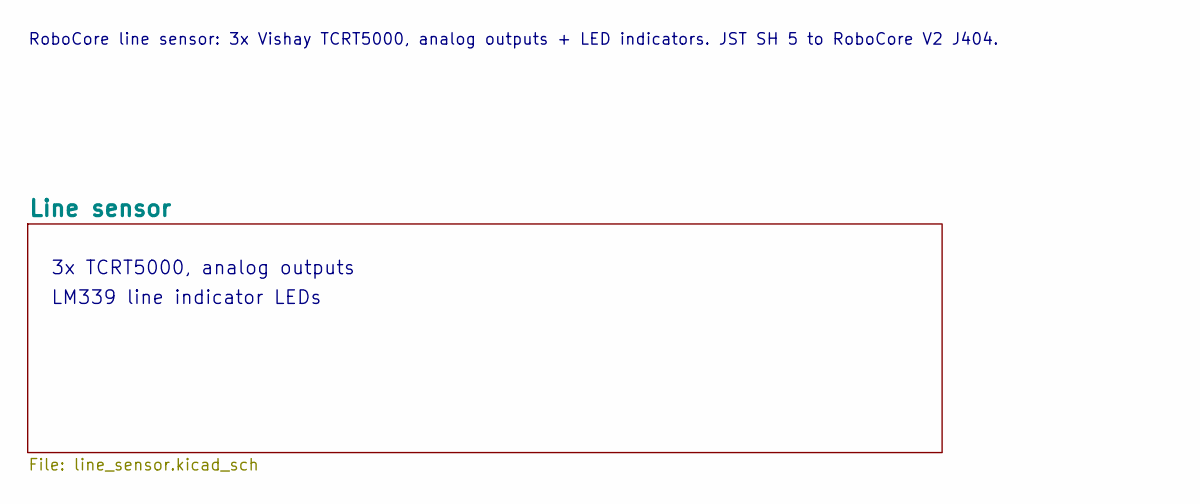
[picture p217: schematic RoboCore_LineSensor.kicad_sch, RoboCore Line Sensor]

Notes on the sheet:
3x TCRT5000, analog outputs
LM339 line indicator LEDs
RoboCore line sensor: 3x Vishay TCRT5000, analog outputs + LED indicators. JST SH 5 to RoboCore V2 J404.

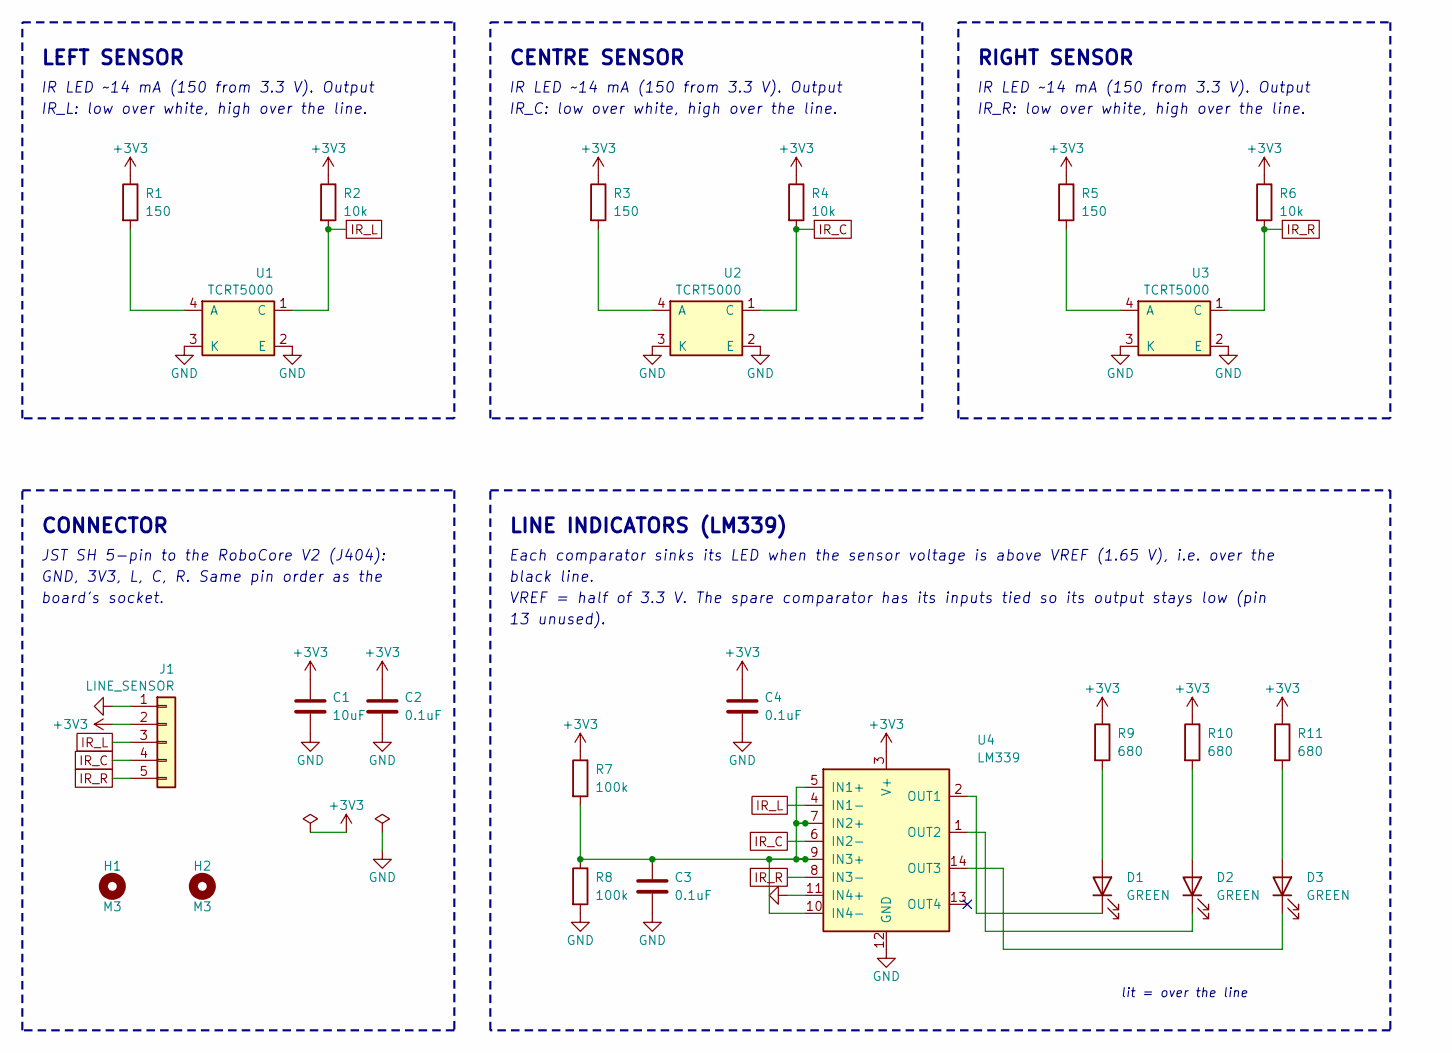
[picture p218: schematic line_sensor.kicad_sch, RoboCore Line Sensor - Line sensor]

Parts:
C1: 10uF; C_0805_2012Metric; LCSC C1713
C2, C3, C4: 0.1uF; C_0603_1608Metric; LCSC C1591
D1, D2, D3: GREEN; LED_0603_1608Metric; LCSC C125098
H1, H2: M3; MountingHole_3.2mm_M3
J1: LINE_SENSOR; JST_SH_BM05B-SRSS-TB_1x05-1MP_P1.00mm_Vertical; LCSC C160391
R1, R3, R5: 150; R_0603_1608Metric; LCSC C22808
R2, R4, R6: 10k; R_0603_1608Metric; LCSC C98220
R7, R8: 100k; R_0603_1608Metric; LCSC C25803
R9, R10, R11: 680; R_0603_1608Metric; LCSC C23228
U1, U2, U3: TCRT5000; Vishay_TCRT5000; LCSC C2984661
U4: LM339; SOIC-14_3.9x8.7mm_P1.27mm; LCSC C2829428

Connections:
+3V3: C1.1, C2.1, C4.1, J1.2, R1.1, R2.1, R3.1, R4.1, R5.1, R6.1, R7.1, R9.1, R10.1, R11.1, U4.3 (V+)
GND: C1.2, C2.2, C3.2, C4.2, J1.1, R8.2, U1.2 (E), U1.3 (K), U2.2 (E), U2.3 (K), U3.2 (E), U3.3 (K), U4.11 (IN4+), U4.12 (GND)
IR_C: J1.4, R4.2, U2.1 (C), U4.6 (IN2-)
IR_L: J1.3, R2.2, U1.1 (C), U4.4 (IN1-)
IR_R: J1.5, R6.2, U3.1 (C), U4.8 (IN3-)
unnamed: D1.2 (A), R9.2
unnamed: D1.1 (K), U4.2 (OUT1)
unnamed: D2.2 (A), R10.2
unnamed: D2.1 (K), U4.1 (OUT2)
unnamed: D3.2 (A), R11.2
unnamed: D3.1 (K), U4.14 (OUT3)
unnamed: R1.2, U1.4 (A)
unnamed: R3.2, U2.4 (A)
unnamed: R5.2, U3.4 (A)
unnamed: C3.1, R7.2, R8.1, U4.5 (IN1+), U4.7 (IN2+), U4.9 (IN3+), U4.10 (IN4-)

Notes on the sheet:
LEFT SENSOR
IR LED ~14 mA (150 from 3.3 V). Output
IR_L: low over white, high over the line.
CENTRE SENSOR
IR_C: low over white, high over the line.
RIGHT SENSOR
IR_R: low over white, high over the line.
CONNECTOR
JST SH 5-pin to the RoboCore V2 (J404):
GND, 3V3, L, C, R. Same pin order as the
board's socket.
LINE INDICATORS (LM339)
Each comparator sinks its LED when the sensor voltage is above VREF (1.65 V), i.e. over the
black line.
VREF = half of 3.3 V. The spare comparator has its inputs tied so its output stays low (pin
13 unused).
lit = over the line

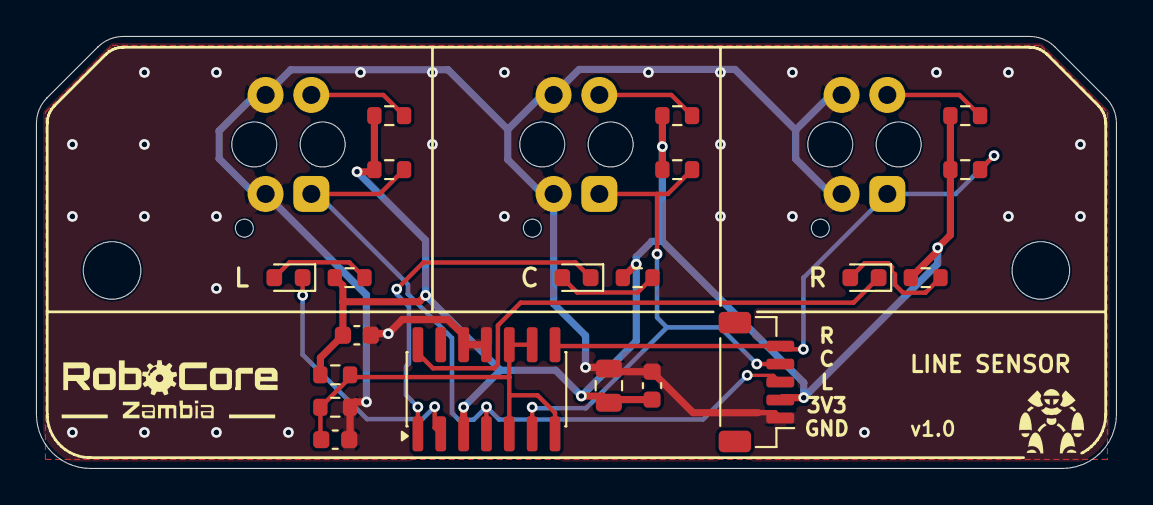
[picture p219: board RoboCore_LineSensor.kicad_pcb from above]

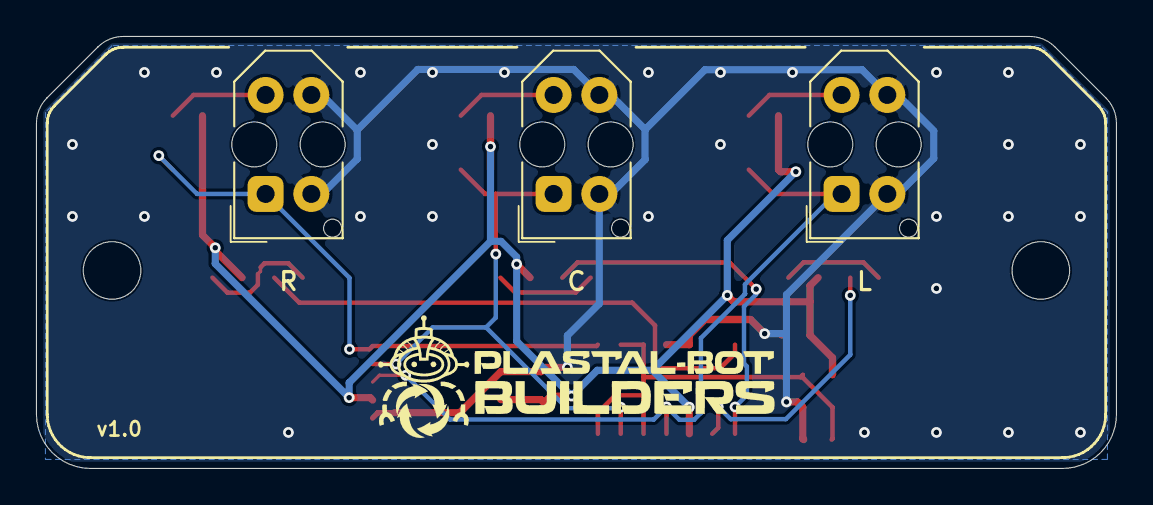
[picture p220: board RoboCore_LineSensor.kicad_pcb from below]

Board: 2 copper layers, 60.0 x 24.0 mm, 25 parts (3 on the bottom side), 15 nets.
