Plastal-Bot-Builders/RoboCoreDocumentation/hardware/sensors/ultrasonic/RoboCore_Ultrasonic.kicad_pcb

## KiCad design hardware/sensors/ultrasonic/RoboCore_Ultrasonic.kicad_pcb (2026-10-12)

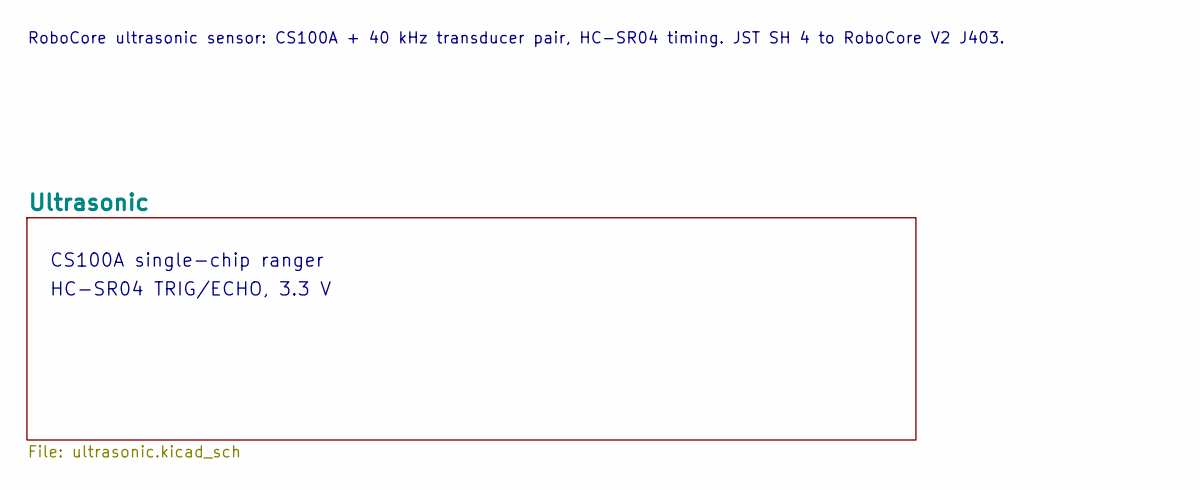
[picture p221: schematic RoboCore_Ultrasonic.kicad_sch, RoboCore Ultrasonic]

Notes on the sheet:
CS100A single-chip ranger
HC-SR04 TRIG/ECHO, 3.3 V
RoboCore ultrasonic sensor: CS100A + 40 kHz transducer pair, HC-SR04 timing. JST SH 4 to RoboCore V2 J403.
