Plastal-Bot-Builders/RoboCoreDocumentation/hardware/sensors/ultrasonic/RoboCore_Ultrasonic.kicad_pcb

## KiCad design hardware/sensors/ultrasonic/RoboCore_Ultrasonic.kicad_pcb (continued)

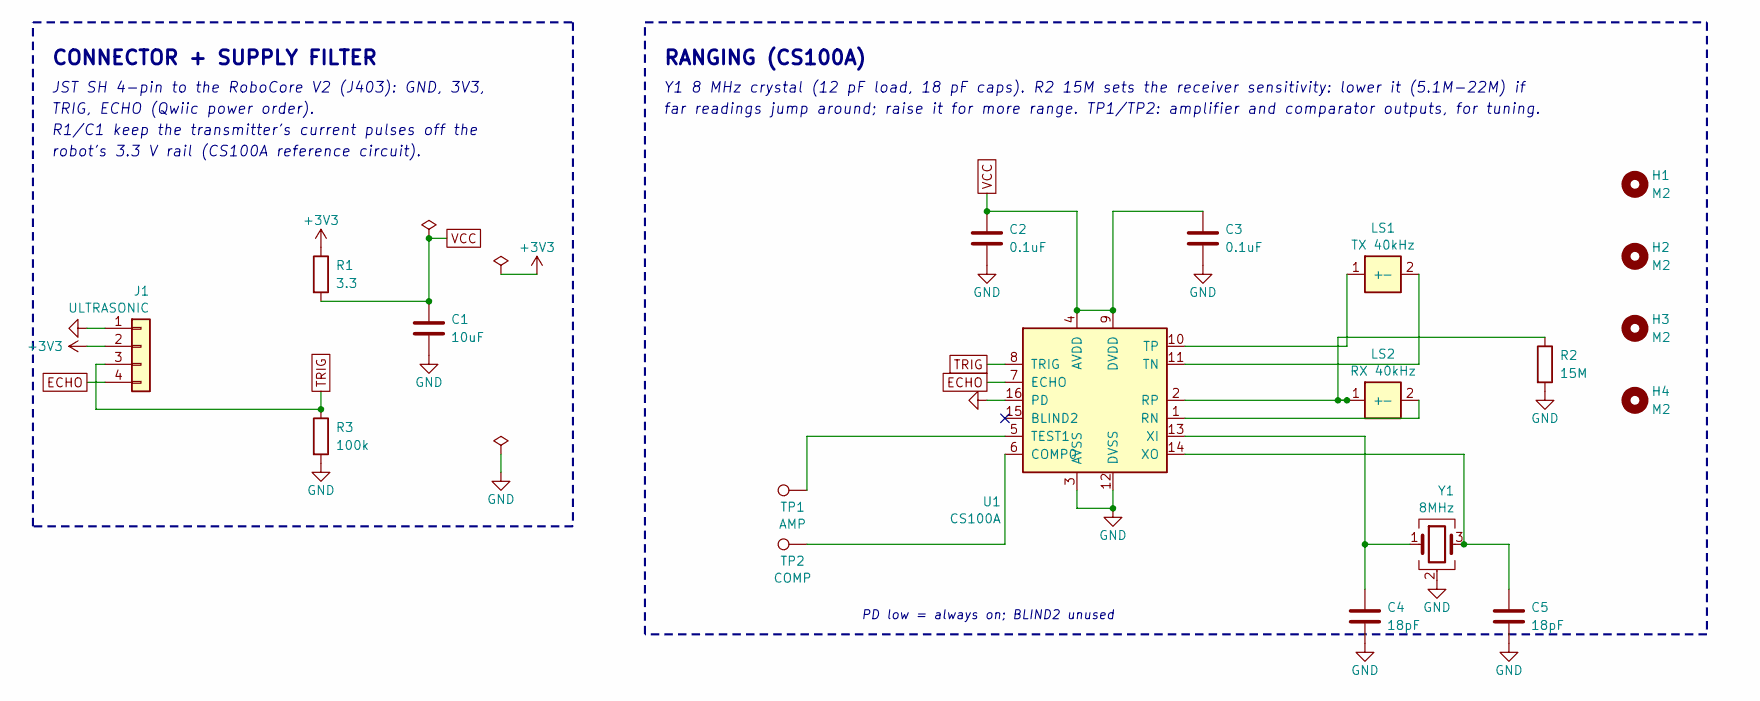
[picture p222: schematic ultrasonic.kicad_sch, RoboCore Ultrasonic - Ultrasonic]

Parts:
C1: 10uF; C_0805_2012Metric; LCSC C1713
C2, C3: 0.1uF; C_0603_1608Metric; LCSC C1591
C4, C5: 18pF; C_0603_1608Metric; LCSC C1647
H1, H2, H3, H4: M2; MountingHole_2.2mm_M2
J1: ULTRASONIC; JST_SH_BM04B-SRSS-TB_1x04-1MP_P1.00mm_Vertical; LCSC C160390
LS1: TX 40kHz; Ultrasonic_Transducer_D16.0mm_P10.00mm; LCSC C17701106
LS2: RX 40kHz; Ultrasonic_Transducer_D16.0mm_P10.00mm; LCSC C17701107
R1: 3.3; R_0603_1608Metric; LCSC C137725
R2: 15M; R_0603_1608Metric; LCSC C80615
R3: 100k; R_0603_1608Metric; LCSC C25803
TP1: AMP; TestPoint_Pad_D1.0mm
TP2: COMP; TestPoint_Pad_D1.0mm
U1: CS100A; SOIC-16_3.9x9.9mm_P1.27mm
Y1: 8MHz; Crystal_SMD_3225-4Pin_3.2x2.5mm; LCSC C2842191

Connections:
+3V3: J1.2, R1.1
ECHO: J1.4, U1.7 (ECHO)
GND: C1.2, C2.2, C3.2, C4.2, C5.2, J1.1, R2.2, R3.2, U1.3 (AVSS), U1.12 (DVSS), U1.16 (PD), Y1.2 (G), Y1.4 (G)
unnamed: LS1.1 (+), U1.10 (TP)
unnamed: LS1.2 (-), U1.11 (TN)
unnamed: LS2.1 (+), R2.1, U1.2 (RP)
unnamed: LS2.2 (-), U1.1 (RN)
unnamed: TP2.1, U1.6 (COMP0)
unnamed: TP1.1, U1.5 (TEST1)
unnamed: C4.1, U1.13 (XI), Y1.1
unnamed: C5.1, U1.14 (XO), Y1.3
TRIG: J1.3, R3.1, U1.8 (TRIG)
VCC: C1.1, C2.1, C3.1, R1.2, U1.4 (AVDD), U1.9 (DVDD)

Notes on the sheet:
CONNECTOR + SUPPLY FILTER
JST SH 4-pin to the RoboCore V2 (J403): GND, 3V3,
TRIG, ECHO (Qwiic power order).
R1/C1 keep the transmitter's current pulses off the
robot's 3.3 V rail (CS100A reference circuit).
RANGING (CS100A)
Y1 8 MHz crystal (12 pF load, 18 pF caps). R2 15M sets the receiver sensitivity: lower it (5.1M-22M) if
far readings jump around; raise it for more range. TP1/TP2: amplifier and comparator outputs, for tuning.
PD low = always on; BLIND2 unused

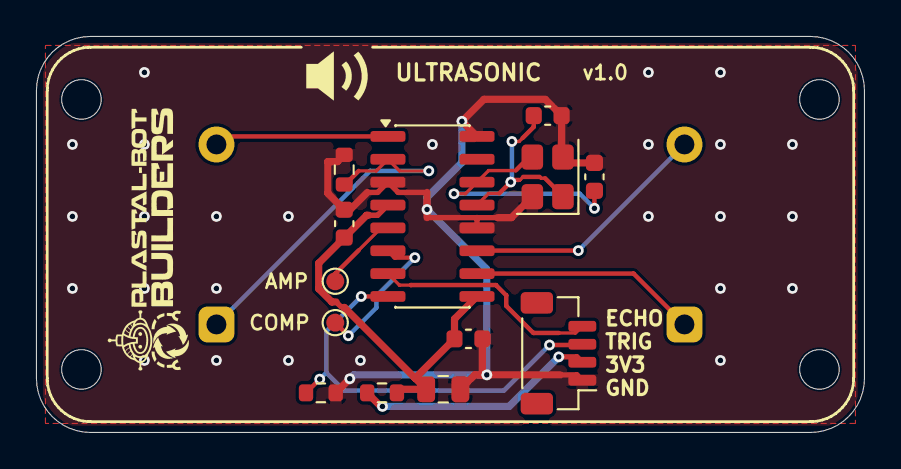
[picture p223: board RoboCore_Ultrasonic.kicad_pcb from above]

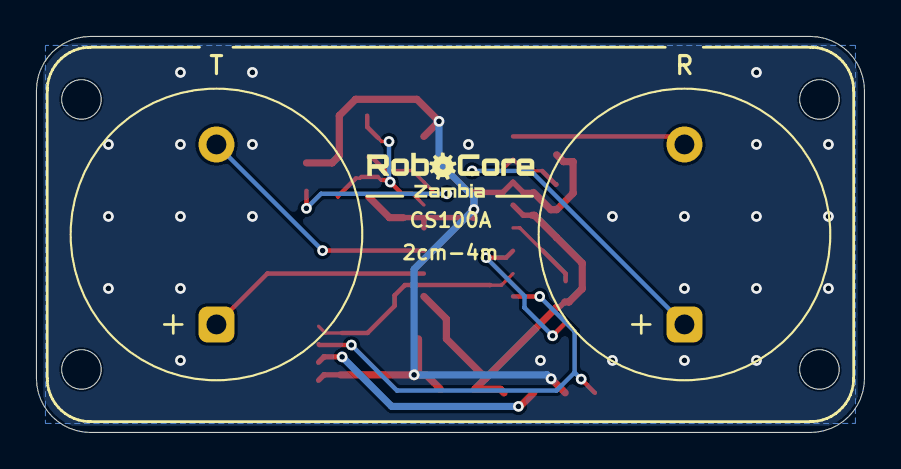
[picture p224: board RoboCore_Ultrasonic.kicad_pcb from below]

Board: 2 copper layers, 46.0 x 22.0 mm, 19 parts (2 on the bottom side), 13 nets.
