Plastal-Bot-Builders/RoboCoreDocumentation/hardware/controller_v2/RoboCore_V2.kicad_pcb

## KiCad design hardware/controller_v2/RoboCore_V2.kicad_pcb (2026-10-12)

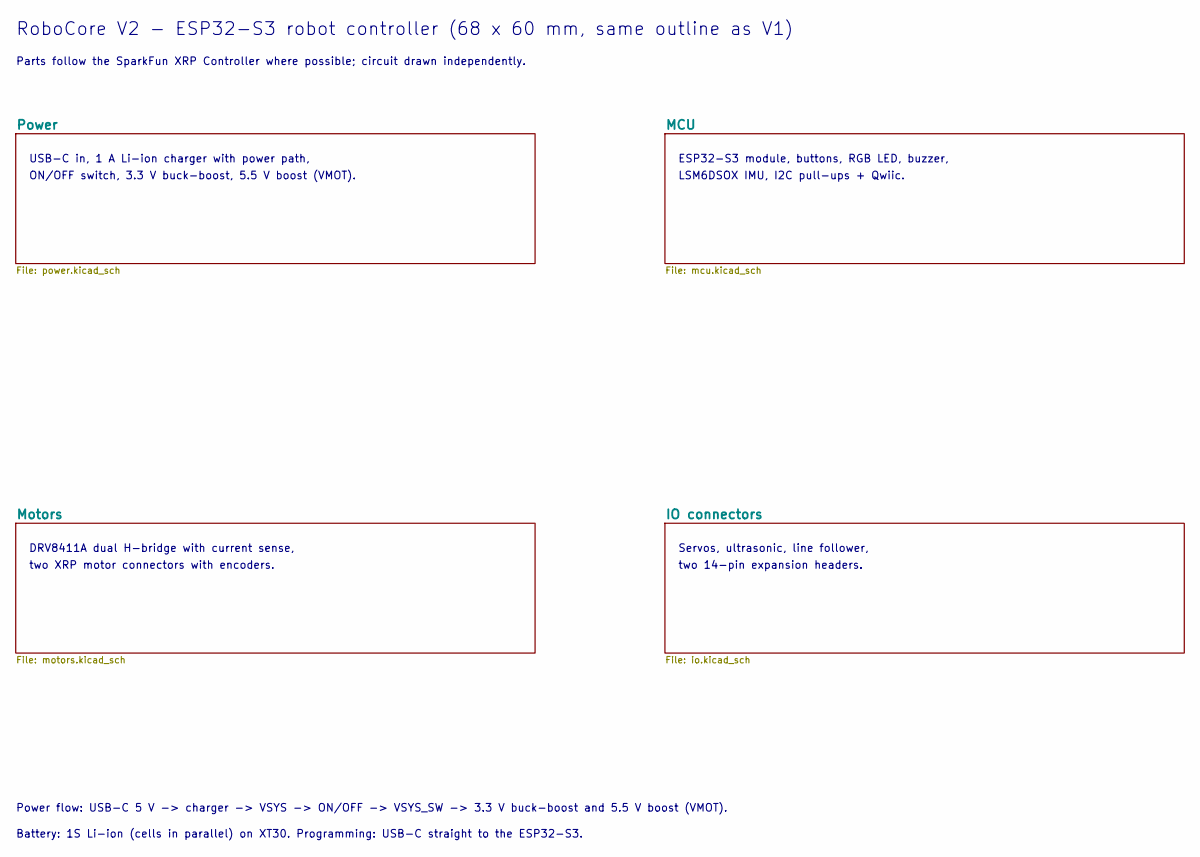
[picture p225: schematic RoboCore_V2.kicad_sch, RoboCore V2]

Notes on the sheet:
USB-C in, 1 A Li-ion charger with power path,
ON/OFF switch, 3.3 V buck-boost, 5.5 V boost (VMOT).
ESP32-S3 module, buttons, RGB LED, buzzer,
LSM6DSOX IMU, I2C pull-ups + Qwiic.
DRV8411A dual H-bridge with current sense,
two XRP motor connectors with encoders.
Servos, ultrasonic, line follower,
two 14-pin expansion headers.
RoboCore V2 - ESP32-S3 robot controller (68 x 60 mm, same outline as V1)
Parts follow the SparkFun XRP Controller where possible; circuit drawn independently.
Power flow: USB-C 5 V -> charger -> VSYS -> ON/OFF -> VSYS_SW -> 3.3 V buck-boost and 5.5 V boost (VMOT).
Battery: 1S Li-ion (cells in parallel) on XT30. Programming: USB-C straight to the ESP32-S3.

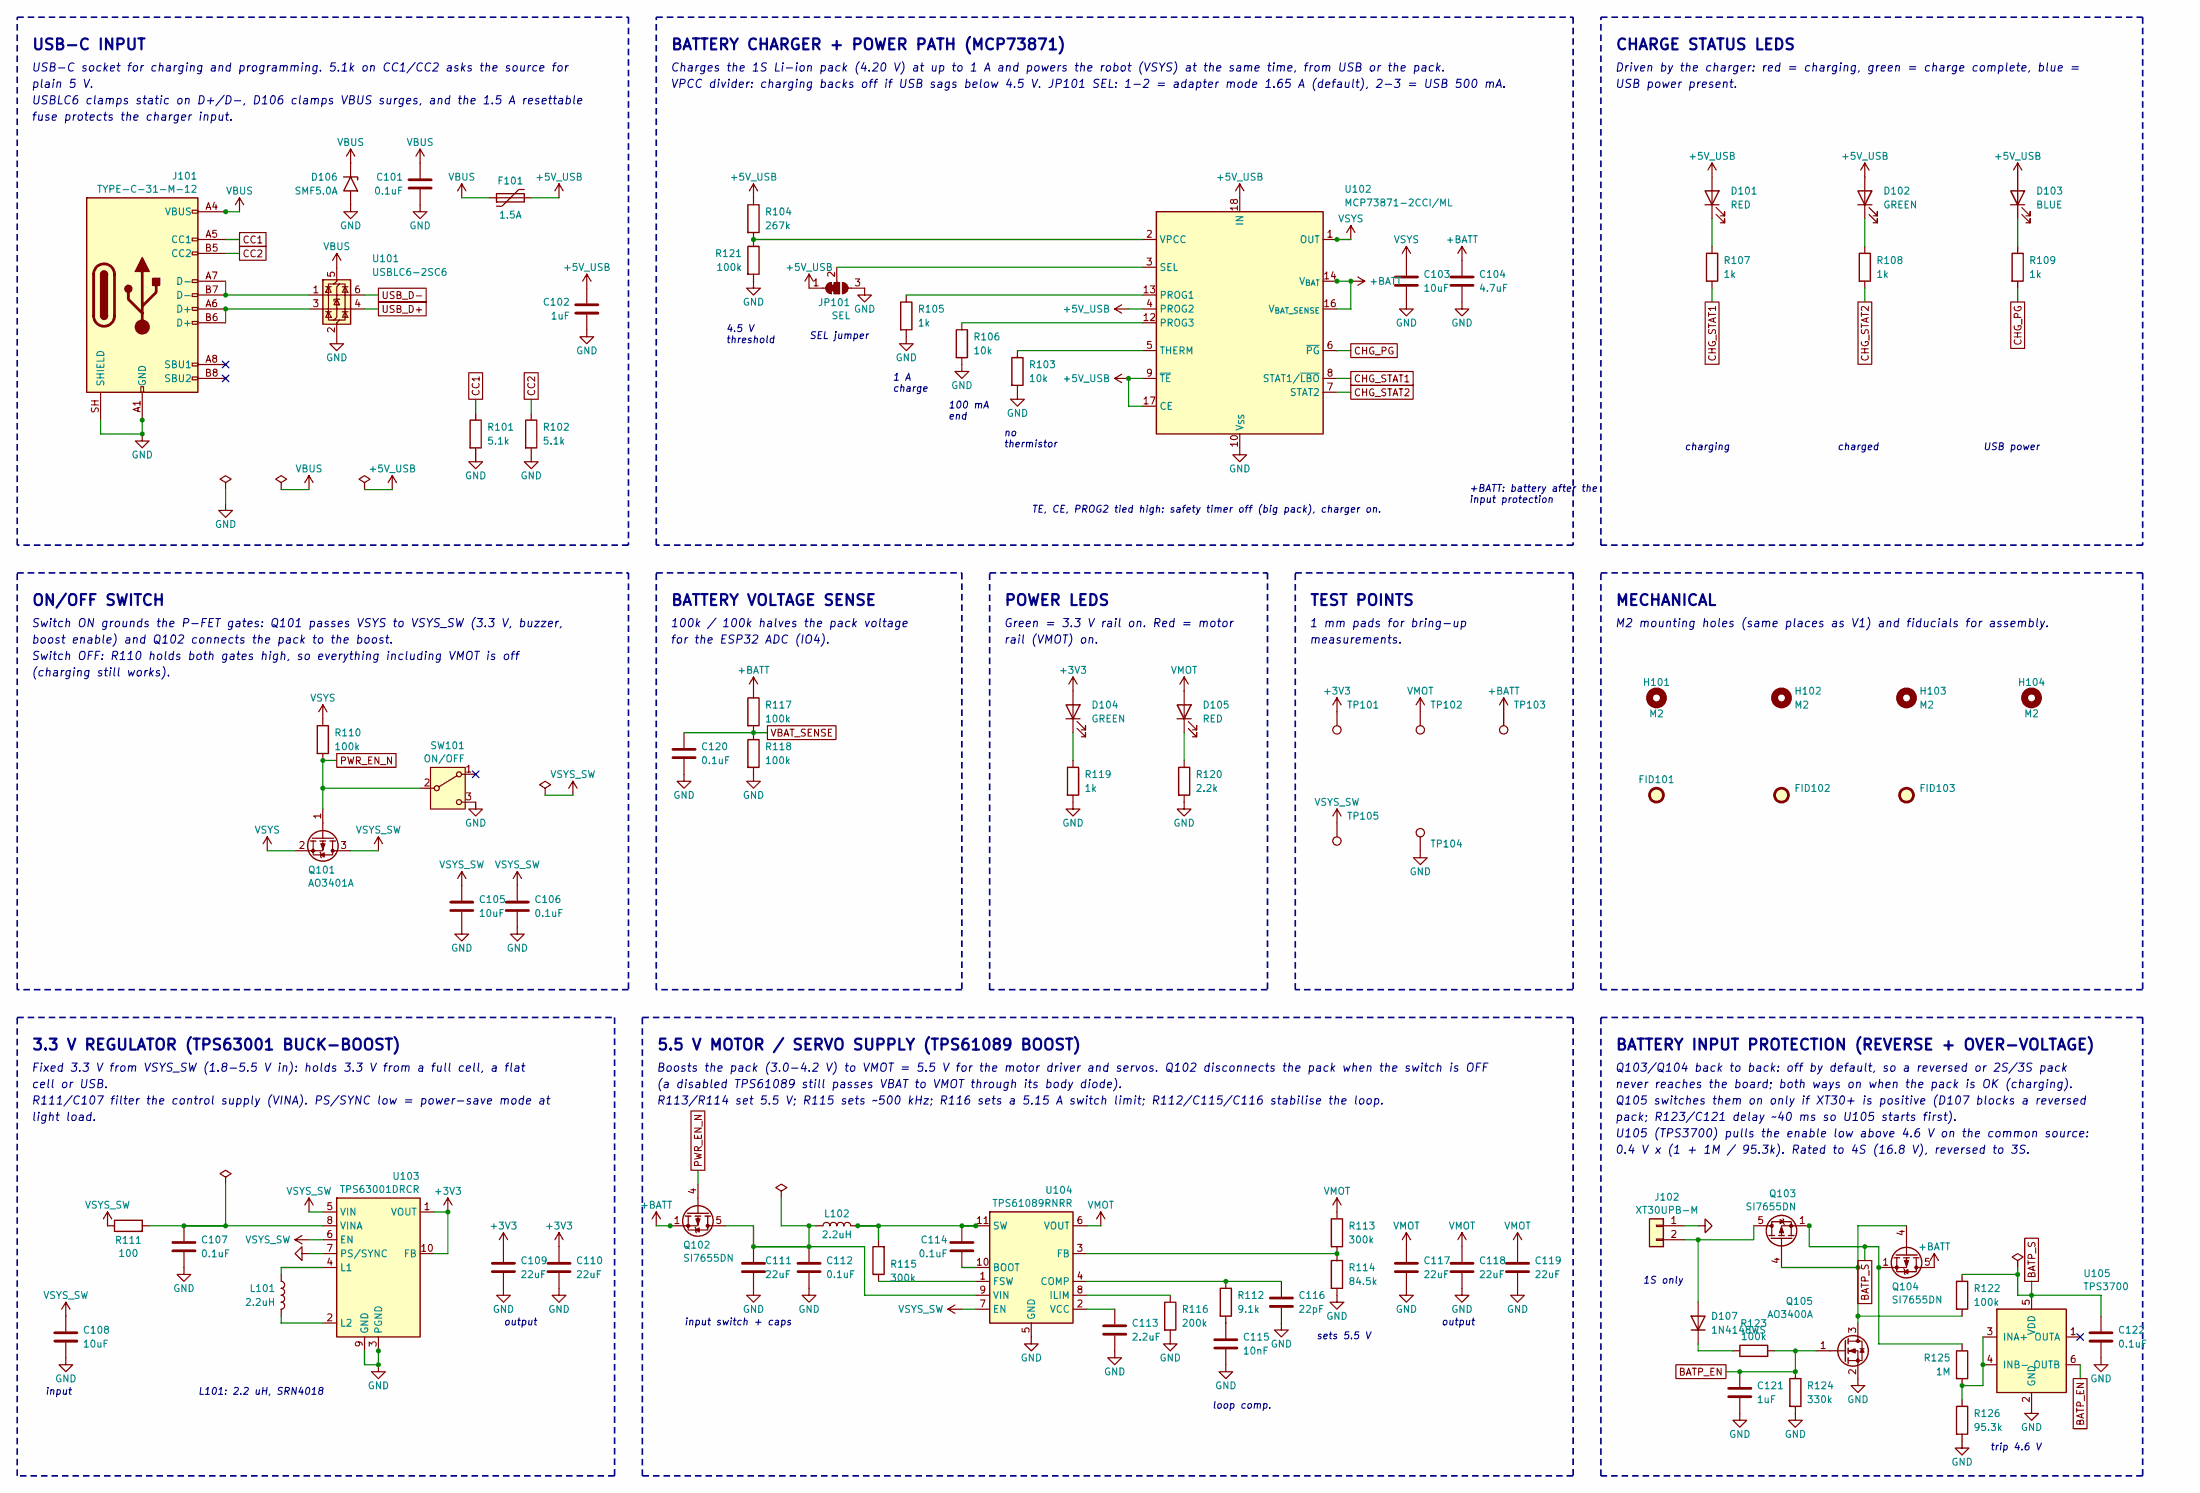
[picture p226: schematic power.kicad_sch, RoboCore V2 - Power]

Parts:
C101, C106, C107, C112, C114, C120, C122: 0.1uF; C_0402_1005Metric; LCSC C960916
C102: 1uF; C_0603_1608Metric; LCSC C5673
C103: 10uF; C_0603_1608Metric; LCSC C92487
C104: 4.7uF; C_0805_2012Metric; LCSC C1779
C105, C108: 10uF; C_0805_2012Metric; LCSC C1713
C109, C110: 22uF; C_0805_2012Metric; LCSC C45783
C111, C117, C118, C119: 22uF; C_1206_3216Metric; LCSC C12891
C113: 2.2uF; C_0603_1608Metric; LCSC C23630
C115: 10nF; C_0402_1005Metric; LCSC C15195
C116: 22pF; C_0402_1005Metric; LCSC C70464
C121: 1uF; C_0402_1005Metric; LCSC C16193167
D101, D105: RED; LED_0603_1608Metric; LCSC C125099
D102, D104: GREEN; LED_0603_1608Metric; LCSC C125098
D103: BLUE; LED_0603_1608Metric; LCSC C99290
D106: SMF5.0A; D_SMF; LCSC C151296
D107: 1N4148WS; D_SOD-323; LCSC C129905
F101: 1.5A; Fuse_1812_4532Metric; LCSC C78695
FID101, FID102, FID103: Fiducial; Fiducial_1mm_Mask2mm
H101, H102, H103, H104: M2; MountingHole_2.2mm_M2
J101: TYPE-C-31-M-12; USB_C_Receptacle_HRO_TYPE-C-31-M-12; LCSC C165948
J102: XT30UPB-M; AMASS_XT30UPB-M_1x02_P5.0mm_Vertical; LCSC C428721
JP101: SEL; SolderJumper-3_P1.3mm_Bridged12_RoundedPad1.0x1.5mm
L101: 2.2uH; L_Bourns-SRN4018; LCSC C913207
L102: 2.2uH; L_Bourns_SRP5030CA; LCSC C2046809
Q101: AO3401A; SOT-23; LCSC C15127
Q102, Q103, Q104: SI7655DN; Vishay_PowerPAK_1212-8_Single; LCSC C727830
Q105: AO3400A; SOT-23; LCSC C20917
R101, R102: 5.1k; R_0402_1005Metric; LCSC C25905
R103, R106: 10k; R_0402_1005Metric; LCSC C25744
R104: 267k; R_0402_1005Metric; LCSC C270622
R105, R107, R108, R109, R119: 1k; R_0402_1005Metric; LCSC C106235
R110, R117, R118, R121, R122, R123: 100k; R_0402_1005Metric; LCSC C25741
R111: 100; R_0402_1005Metric; LCSC C106232
R112: 9.1k; R_0402_1005Metric; LCSC C25926
R113, R115: 300k; R_0402_1005Metric; LCSC C25774
R114: 84.5k; R_0402_1005Metric; LCSC C26988
R116: 200k; R_0402_1005Metric; LCSC C25764
R120: 2.2k; R_0402_1005Metric; LCSC C25879
R124: 330k; R_0402_1005Metric; LCSC C25778
R125: 1M; R_0402_1005Metric; LCSC C26083
R126: 95.3k; R_0402_1005Metric; LCSC C26990
SW101: ON/OFF; SW_SPDT_CK_JS102011SAQN; LCSC C221660
TP101: +3V3; TestPoint_Pad_D1.0mm
TP102: VMOT; TestPoint_Pad_D1.0mm
TP103: +BATT; TestPoint_Pad_D1.0mm
TP104: GND; TestPoint_Pad_D1.0mm
TP105: VSYS_SW; TestPoint_Pad_D1.0mm
U101: USBLC6-2SC6; SOT-23-6; LCSC C7519
U102: MCP73871-2CCI/ML; QFN-20-1EP_4x4mm_P0.5mm_EP2.5x2.5mm_ThermalVias; LCSC C5121473
U103: TPS63001DRCR; Texas_DRC0010J_ThermalVias; LCSC C28060
U104: TPS61089RNRR; Texas_VQFN-RNR0011A-11; LCSC C165129
U105: TPS3700; TSOT-23-6; LCSC C33002

Connections:
+3V3: C109.1, C110.1, D104.2 (A), TP101.1, U103.1 (VOUT), U103.10 (FB); also elsewhere on the board
+5V_USB: C102.1, D101.2 (A), D102.2 (A), D103.2 (A), F101.2, JP101.1 (A), R104.1, U102.4 (PROG2), U102.9 (~TE), U102.17 (CE), U102.18 (IN), U102.19 (IN)
+BATT: C104.1, Q102.1 (S), Q102.2 (S), Q102.3 (S), Q104.5 (D), R117.1, TP103.1, U102.14 (V_{BAT}), U102.15 (V_{BAT}), U102.16 (V_{BAT_SENSE})
BATP_EN: C121.1, Q105.1 (G), R123.2, R124.1, U105.6 (OUTB)
BATP_S: C122.1, Q103.1 (S), Q103.2 (S), Q103.3 (S), Q104.1 (S), Q104.2 (S), Q104.3 (S), R122.1, R125.1, U105.5 (VDD)
CC1: J101.A5 (CC1), R101.1
CC2: J101.B5 (CC2), R102.1
CHG_PG: R109.2, U102.6 (~PG)
CHG_STAT1: R107.2, U102.8 (STAT1/~LBO)
CHG_STAT2: R108.2, U102.7 (STAT2)
GND: C101.2, C102.2, C103.2, C104.2, C105.2, C106.2, C107.2, C108.2, C109.2, C110.2, C111.2, C112.2, C113.2, C115.2, C116.2, C117.2, C118.2, C119.2, C120.2, C121.2, C122.2, D106.2 (A2), J101.A1 (GND), J101.A12 (GND), J101.B1 (GND), J101.B12 (GND), J101.SH (SHIELD), J102.1, JP101.3 (B), Q105.2 (S), R101.2, R102.2, R103.2, R105.2, R106.2, R114.2, R116.2, R118.2, R119.2, R120.2, R121.2, R124.2, R126.2, SW101.3 (C), TP104.1, U101.2 (GND), U102.10 (V_{SS}), U102.11 (V_{SS}), U102.21 (V_{SS}), U103.3 (PGND), U103.7 (PS/SYNC), U103.9 (GND), U103.11 (PGND), U104.5 (GND), U105.2 (GND); also elsewhere on the board
unnamed: C115.1, R112.2
unnamed: D101.1 (K), R107.1
unnamed: D102.1 (K), R108.1
unnamed: D103.1 (K), R109.1
unnamed: D104.1 (K), R119.1
unnamed: D105.1 (K), R120.1
unnamed: D107.2 (A), J102.2, Q103.5 (D)
unnamed: D107.1 (K), R123.1
unnamed: J101.A6 (D+), J101.B6 (D+), U101.3 (I/O2)
unnamed: J101.A7 (D-), J101.B7 (D-), U101.1 (I/O1)
unnamed: JP101.2 (C), U102.3 (SEL)
unnamed: C111.1, C112.1, L102.1, Q102.5 (D), U104.9 (VIN)
unnamed: Q103.4 (G), Q104.4 (G), Q105.3 (D), R122.2
unnamed: R105.1, U102.13 (PROG1)
unnamed: R106.1, U102.12 (PROG3)
unnamed: R103.1, U102.5 (THERM)
unnamed: R104.2, R121.1, U102.2 (VPCC)
unnamed: L101.1, U103.4 (L1)
unnamed: L101.2, U103.2 (L2)
unnamed: C107.1, R111.2, U103.8 (VINA)
unnamed: C114.1, U104.10 (BOOT)
unnamed: C116.1, R112.1, U104.4 (COMP)
unnamed: R113.2, R114.1, U104.3 (FB)
unnamed: R115.1, U104.1 (FSW)
unnamed: R116.1, U104.8 (ILIM)
unnamed: C114.2, L102.2, R115.2, U104.11 (SW)
unnamed: C113.1, U104.2 (VCC)
unnamed: R125.2, R126.1, U105.3 (INA+), U105.4 (INB-)
PWR_EN_N: Q101.1 (G), Q102.4 (G), R110.2, SW101.2 (B)
USB_D+: U101.4 (I/O2); also elsewhere on the board
USB_D-: U101.6 (I/O1); also elsewhere on the board
VBAT_SENSE: C120.1, R117.2, R118.1; also elsewhere on the board
VBUS: C101.1, D106.1 (A1), F101.1, J101.A4 (VBUS), J101.A9 (VBUS), J101.B4 (VBUS), J101.B9 (VBUS), U101.5 (VBUS)
VMOT: C117.1, C118.1, C119.1, D105.2 (A), R113.1, TP102.1, U104.6 (VOUT); also elsewhere on the board
VSYS: C103.1, Q101.2 (S), R110.1, U102.1 (OUT), U102.20 (OUT)
VSYS_SW: C105.1, C106.1, C108.1, Q101.3 (D), R111.1, TP105.1, U103.5 (VIN), U103.6 (EN), U104.7 (EN); also elsewhere on the board

Notes on the sheet:
USB-C INPUT
USB-C socket for charging and programming. 5.1k on CC1/CC2 asks the source for
plain 5 V.
USBLC6 clamps static on D+/D-, D106 clamps VBUS surges, and the 1.5 A resettable
fuse protects the charger input.
BATTERY CHARGER + POWER PATH (MCP73871)
Charges the 1S Li-ion pack (4.20 V) at up to 1 A and powers the robot (VSYS) at the same time, from USB or the pack.
VPCC divider: charging backs off if USB sags below 4.5 V. JP101 SEL: 1-2 = adapter mode 1.65 A (default), 2-3 = USB 500 mA.
4.5 V
threshold
SEL jumper
1 A
charge
100 mA
end
thermistor
TE, CE, PROG2 tied high: safety timer off (big pack), charger on.
+BATT: battery after the
input protection
CHARGE STATUS LEDS
Driven by the charger: red = charging, green = charge complete, blue =
USB power present.
charging
charged
USB power
ON/OFF SWITCH
Switch ON grounds the P-FET gates: Q101 passes VSYS to VSYS_SW (3.3 V, buzzer,
boost enable) and Q102 connects the pack to the boost.
Switch OFF: R110 holds both gates high, so everything including VMOT is off
(charging still works).
BATTERY VOLTAGE SENSE
100k / 100k halves the pack voltage
for the ESP32 ADC (IO4).
POWER LEDS
Green = 3.3 V rail on. Red = motor
rail (VMOT) on.
TEST POINTS
1 mm pads for bring-up
measurements.
MECHANICAL
M2 mounting holes (same places as V1) and fiducials for assembly.
3.3 V REGULATOR (TPS63001 BUCK-BOOST)
Fixed 3.3 V from VSYS_SW (1.8-5.5 V in): holds 3.3 V from a full cell, a flat
cell or USB.
R111/C107 filter the control supply (VINA). PS/SYNC low = power-save mode at
light load.
L101: 2.2 uH, SRN4018
input
output
5.5 V MOTOR / SERVO SUPPLY (TPS61089 BOOST)
Boosts the pack (3.0-4.2 V) to VMOT = 5.5 V for the motor driver and servos. Q102 disconnects the pack when the switch is OFF
(a disabled TPS61089 still passes VBAT to VMOT through its body diode).
R113/R114 set 5.5 V; R115 sets ~500 kHz; R116 sets a 5.15 A switch limit; R112/C115/C116 stabilise the loop.
input switch + caps
loop comp.
sets 5.5 V
BATTERY INPUT PROTECTION (REVERSE + OVER-VOLTAGE)
Q103/Q104 back to back: off by default, so a reversed or 2S/3S pack
never reaches the board; both ways on when the pack is OK (charging).
Q105 switches them on only if XT30+ is positive (D107 blocks a reversed
pack; R123/C121 delay ~40 ms so U105 starts first).
U105 (TPS3700) pulls the enable low above 4.6 V on the common source:
0.4 V x (1 + 1M / 95.3k). Rated to 4S (16.8 V), reversed to 3S.
1S only
trip 4.6 V

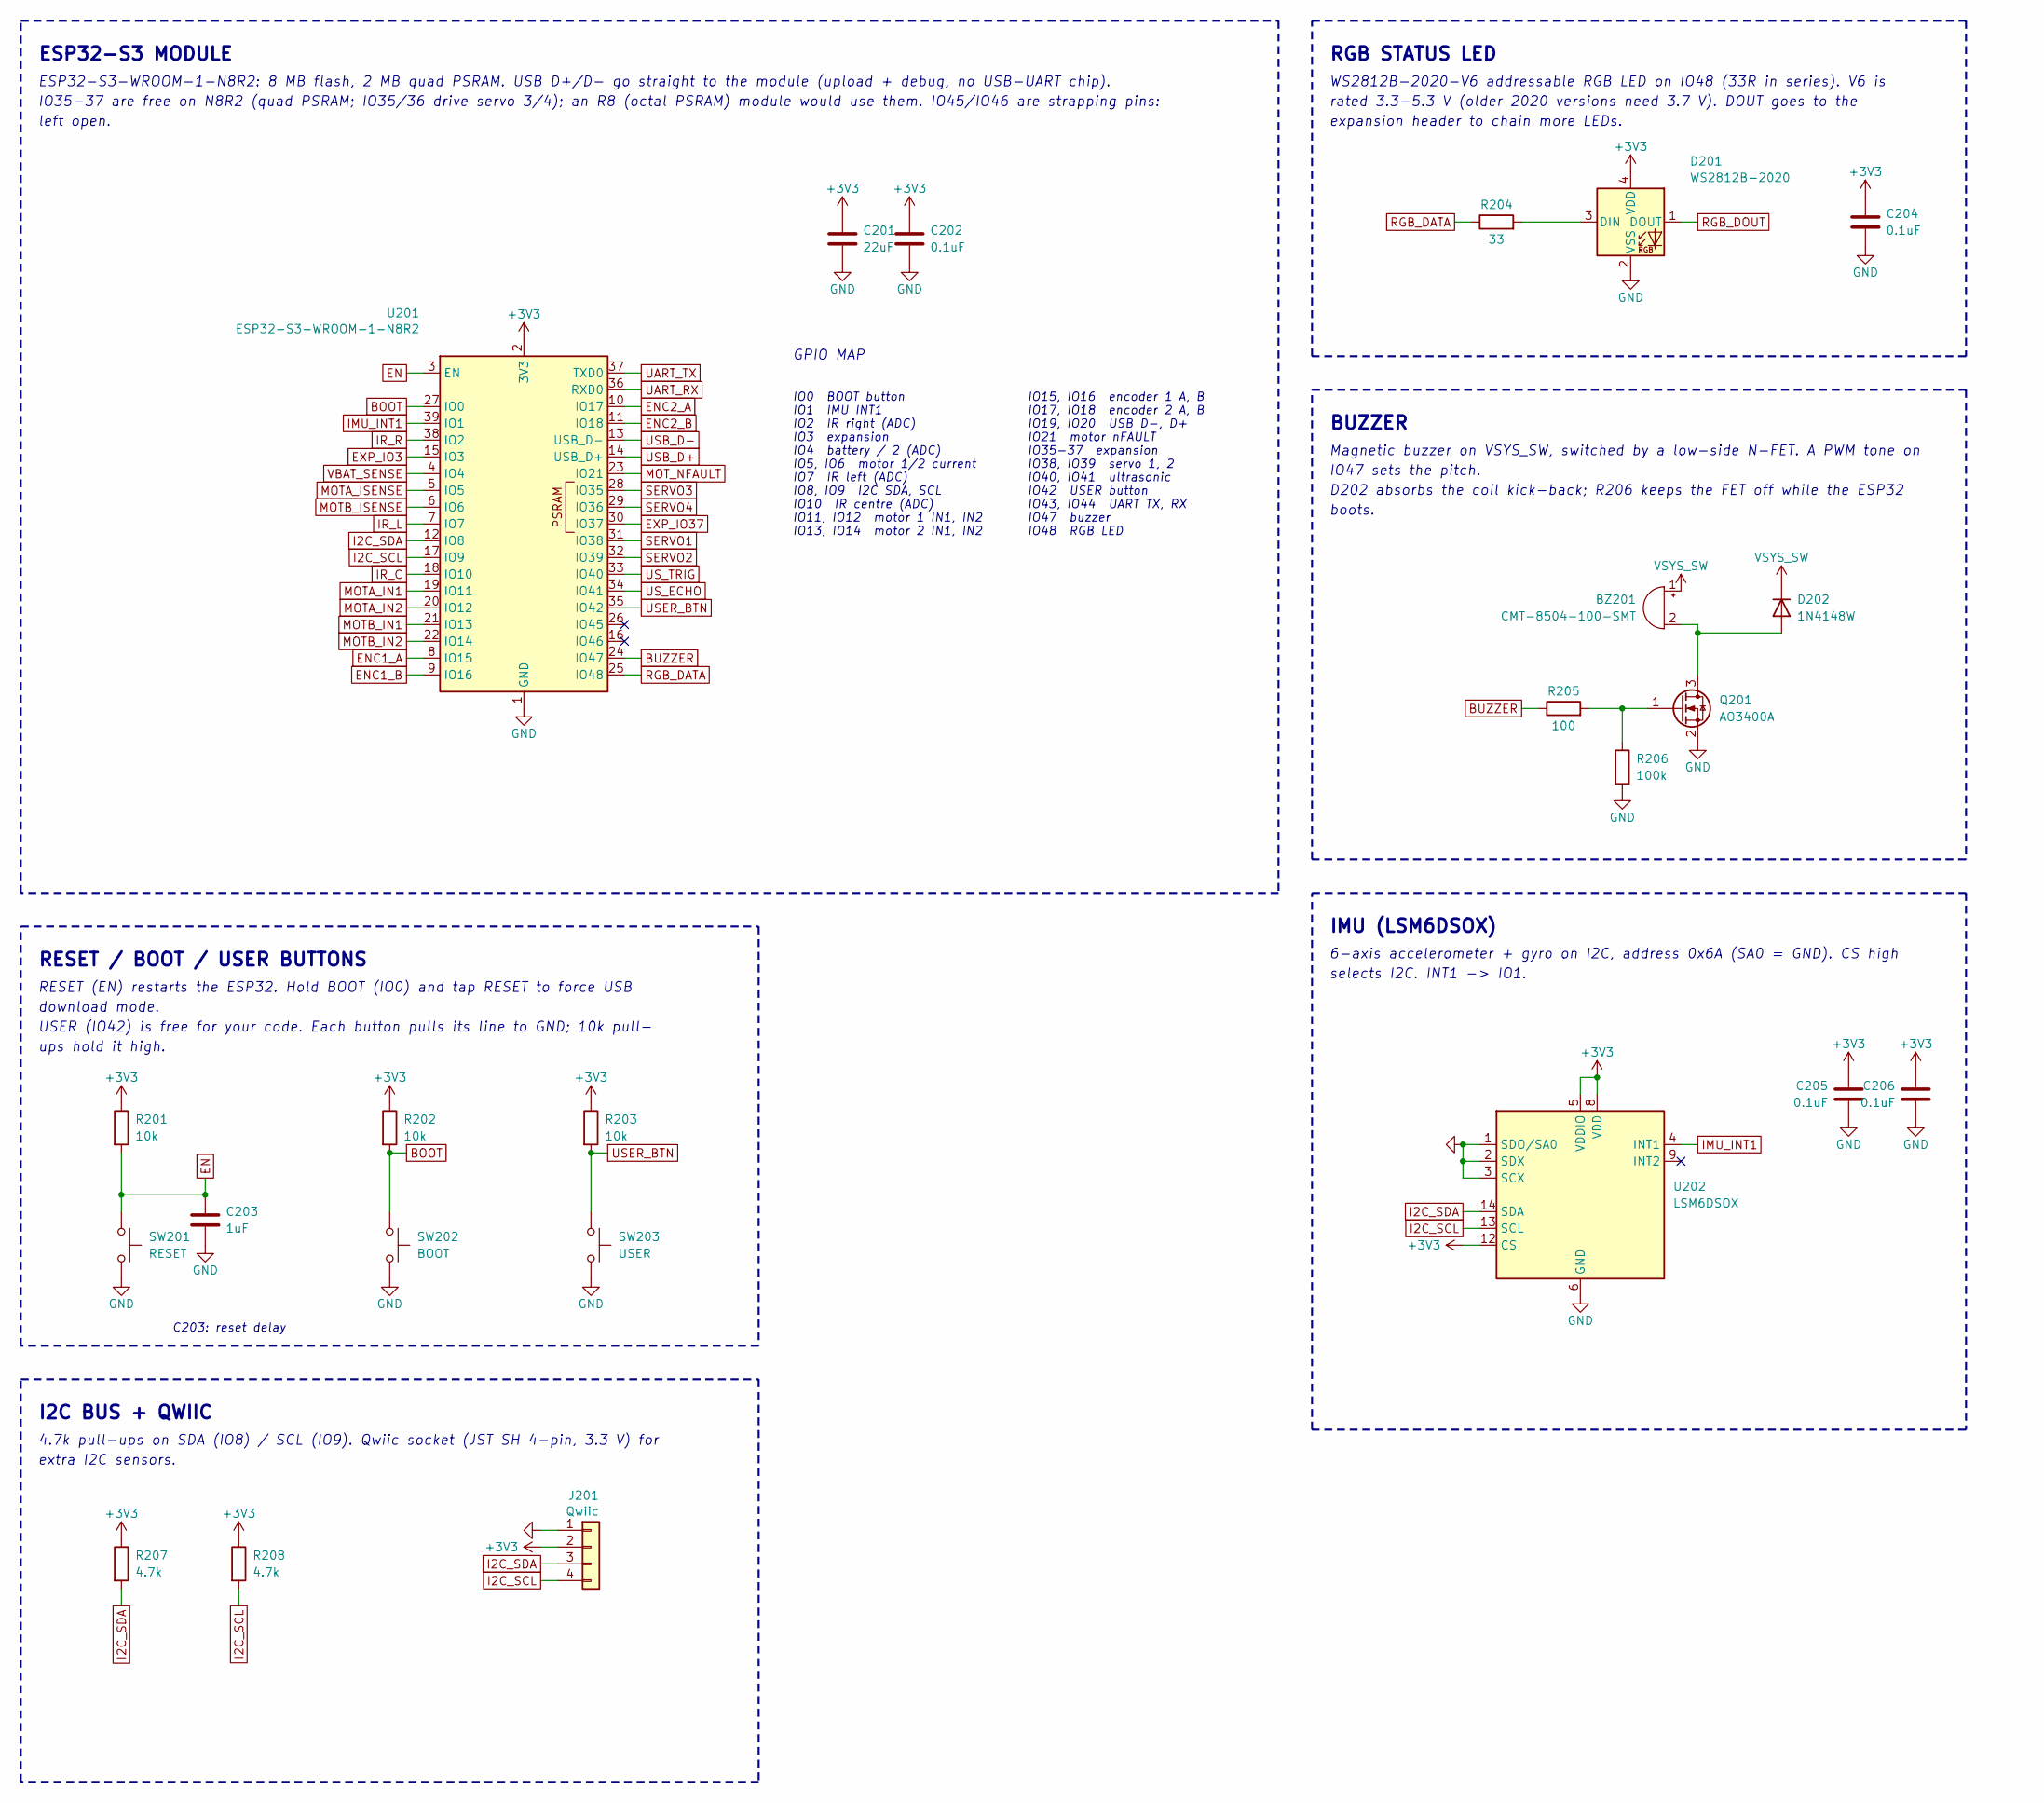
[picture p227: schematic mcu.kicad_sch, RoboCore V2 - MCU]

Parts:
BZ201: CMT-8504-100-SMT; MagneticBuzzer_CUI_CMT-8504-100-SMT; LCSC C22359707
C201: 22uF; C_0805_2012Metric; LCSC C45783
C202, C204, C205, C206: 0.1uF; C_0402_1005Metric; LCSC C960916
C203: 1uF; C_0402_1005Metric; LCSC C16193167
D201: WS2812B-2020; LED_WS2812B-2020_PLCC4_2.0x2.0mm; LCSC C52917434
D202: 1N4148W; D_SOD-123; LCSC C83528
J201: Qwiic; JST_SH_BM04B-SRSS-TB_1x04-1MP_P1.00mm_Vertical; LCSC C160390
Q201: AO3400A; SOT-23; LCSC C20917
R201, R202, R203: 10k; R_0402_1005Metric; LCSC C25744
R204: 33; R_0402_1005Metric; LCSC C138002
R205: 100; R_0402_1005Metric; LCSC C106232
R206: 100k; R_0402_1005Metric; LCSC C25741
R207, R208: 4.7k; R_0402_1005Metric; LCSC C25900
SW201: RESET; SW_SPST_SKQG_WithoutStem; LCSC C116647
SW202: BOOT; SW_SPST_SKQG_WithoutStem; LCSC C116647
SW203: USER; SW_SPST_SKQG_WithoutStem; LCSC C116647
U201: ESP32-S3-WROOM-1-N8R2; ESP32-S3-WROOM-1; LCSC C2913204
U202: LSM6DSOX; LGA-14_3x2.5mm_P0.5mm_LayoutBorder3x4y; LCSC C481766

Connections:
+3V3: C201.1, C202.1, C204.1, C205.1, C206.1, D201.4 (VDD), J201.2, R201.1, R202.1, R203.1, R207.1, R208.1, U201.2 (3V3), U202.5 (VDDIO), U202.8 (VDD), U202.12 (CS); also elsewhere on the board
BOOT: R202.2, SW202.1, U201.27 (IO0)
BUZZER: R205.1, U201.24 (IO47); also elsewhere on the board
EN: C203.1, R201.2, SW201.1, U201.3 (EN); also elsewhere on the board
ENC1_A: U201.8 (IO15); also elsewhere on the board
ENC1_B: U201.9 (IO16); also elsewhere on the board
ENC2_A: U201.10 (IO17); also elsewhere on the board
ENC2_B: U201.11 (IO18); also elsewhere on the board
EXP_IO3: U201.15 (IO3); also elsewhere on the board
EXP_IO37: U201.30 (IO37); also elsewhere on the board
GND: C201.2, C202.2, C203.2, C204.2, C205.2, C206.2, D201.2 (VSS), J201.1, Q201.2 (S), R206.2, SW201.2, SW202.2, SW203.2, U201.1 (GND), U201.40 (GND), U201.41 (GND), U202.1 (SDO/SA0), U202.2 (SDX), U202.3 (SCX), U202.6 (GND), U202.7 (GND); also elsewhere on the board
I2C_SCL: J201.4, R208.2, U201.17 (IO9), U202.13 (SCL); also elsewhere on the board
I2C_SDA: J201.3, R207.2, U201.12 (IO8), U202.14 (SDA); also elsewhere on the board
IMU_INT1: U201.39 (IO1), U202.4 (INT1); also elsewhere on the board
IR_C: U201.18 (IO10); also elsewhere on the board
IR_L: U201.7 (IO7); also elsewhere on the board
IR_R: U201.38 (IO2); also elsewhere on the board
MOTA_IN1: U201.19 (IO11); also elsewhere on the board
MOTA_IN2: U201.20 (IO12); also elsewhere on the board
MOTA_ISENSE: U201.5 (IO5); also elsewhere on the board
MOTB_IN1: U201.21 (IO13); also elsewhere on the board
MOTB_IN2: U201.22 (IO14); also elsewhere on the board
MOTB_ISENSE: U201.6 (IO6); also elsewhere on the board
MOT_NFAULT: U201.23 (IO21); also elsewhere on the board
unnamed: BZ201.2 (-), D202.2 (A), Q201.3 (D)
unnamed: D201.3 (DIN), R204.2
unnamed: Q201.1 (G), R205.2, R206.1
RGB_DATA: R204.1, U201.25 (IO48)
RGB_DOUT: D201.1 (DOUT); also elsewhere on the board
SERVO1: U201.31 (IO38); also elsewhere on the board
SERVO2: U201.32 (IO39); also elsewhere on the board
SERVO3: U201.28 (IO35); also elsewhere on the board
SERVO4: U201.29 (IO36); also elsewhere on the board
UART_RX: U201.36 (RXD0); also elsewhere on the board
UART_TX: U201.37 (TXD0); also elsewhere on the board
USB_D+: U201.14 (USB_D+); also elsewhere on the board
USB_D-: U201.13 (USB_D-); also elsewhere on the board
USER_BTN: R203.2, SW203.1, U201.35 (IO42); also elsewhere on the board
US_ECHO: U201.34 (IO41); also elsewhere on the board
US_TRIG: U201.33 (IO40); also elsewhere on the board
VBAT_SENSE: U201.4 (IO4); also elsewhere on the board
VSYS_SW: BZ201.1 (+), D202.1 (K); also elsewhere on the board

Notes on the sheet:
ESP32-S3 MODULE
ESP32-S3-WROOM-1-N8R2: 8 MB flash, 2 MB quad PSRAM. USB D+/D- go straight to the module (upload + debug, no USB-UART chip).
IO35-37 are free on N8R2 (quad PSRAM; IO35/36 drive servo 3/4); an R8 (octal PSRAM) module would use them. IO45/IO46 are strapping pins:
left open.
GPIO MAP
IO0 BOOT button
IO1 IMU INT1
IO2 IR right (ADC)
IO3 expansion
IO4 battery / 2 (ADC)
IO5, IO6 motor 1/2 current
IO7 IR left (ADC)
IO8, IO9 I2C SDA, SCL
IO10 IR centre (ADC)
IO11, IO12 motor 1 IN1, IN2
IO13, IO14 motor 2 IN1, IN2
IO15, IO16 encoder 1 A, B
IO17, IO18 encoder 2 A, B
IO19, IO20 USB D-, D+
IO21 motor nFAULT
IO35-37 expansion
IO38, IO39 servo 1, 2
IO40, IO41 ultrasonic
IO42 USER button
IO43, IO44 UART TX, RX
IO47 buzzer
IO48 RGB LED
RESET / BOOT / USER BUTTONS
RESET (EN) restarts the ESP32. Hold BOOT (IO0) and tap RESET to force USB
download mode.
USER (IO42) is free for your code. Each button pulls its line to GND; 10k pull-
ups hold it high.
C203: reset delay
I2C BUS + QWIIC
4.7k pull-ups on SDA (IO8) / SCL (IO9). Qwiic socket (JST SH 4-pin, 3.3 V) for
extra I2C sensors.
RGB STATUS LED
WS2812B-2020-V6 addressable RGB LED on IO48 (33R in series). V6 is
rated 3.3-5.3 V (older 2020 versions need 3.7 V). DOUT goes to the
expansion header to chain more LEDs.
BUZZER
Magnetic buzzer on VSYS_SW, switched by a low-side N-FET. A PWM tone on
IO47 sets the pitch.
D202 absorbs the coil kick-back; R206 keeps the FET off while the ESP32
boots.
IMU (LSM6DSOX)
6-axis accelerometer + gyro on I2C, address 0x6A (SA0 = GND). CS high
selects I2C. INT1 -> IO1.

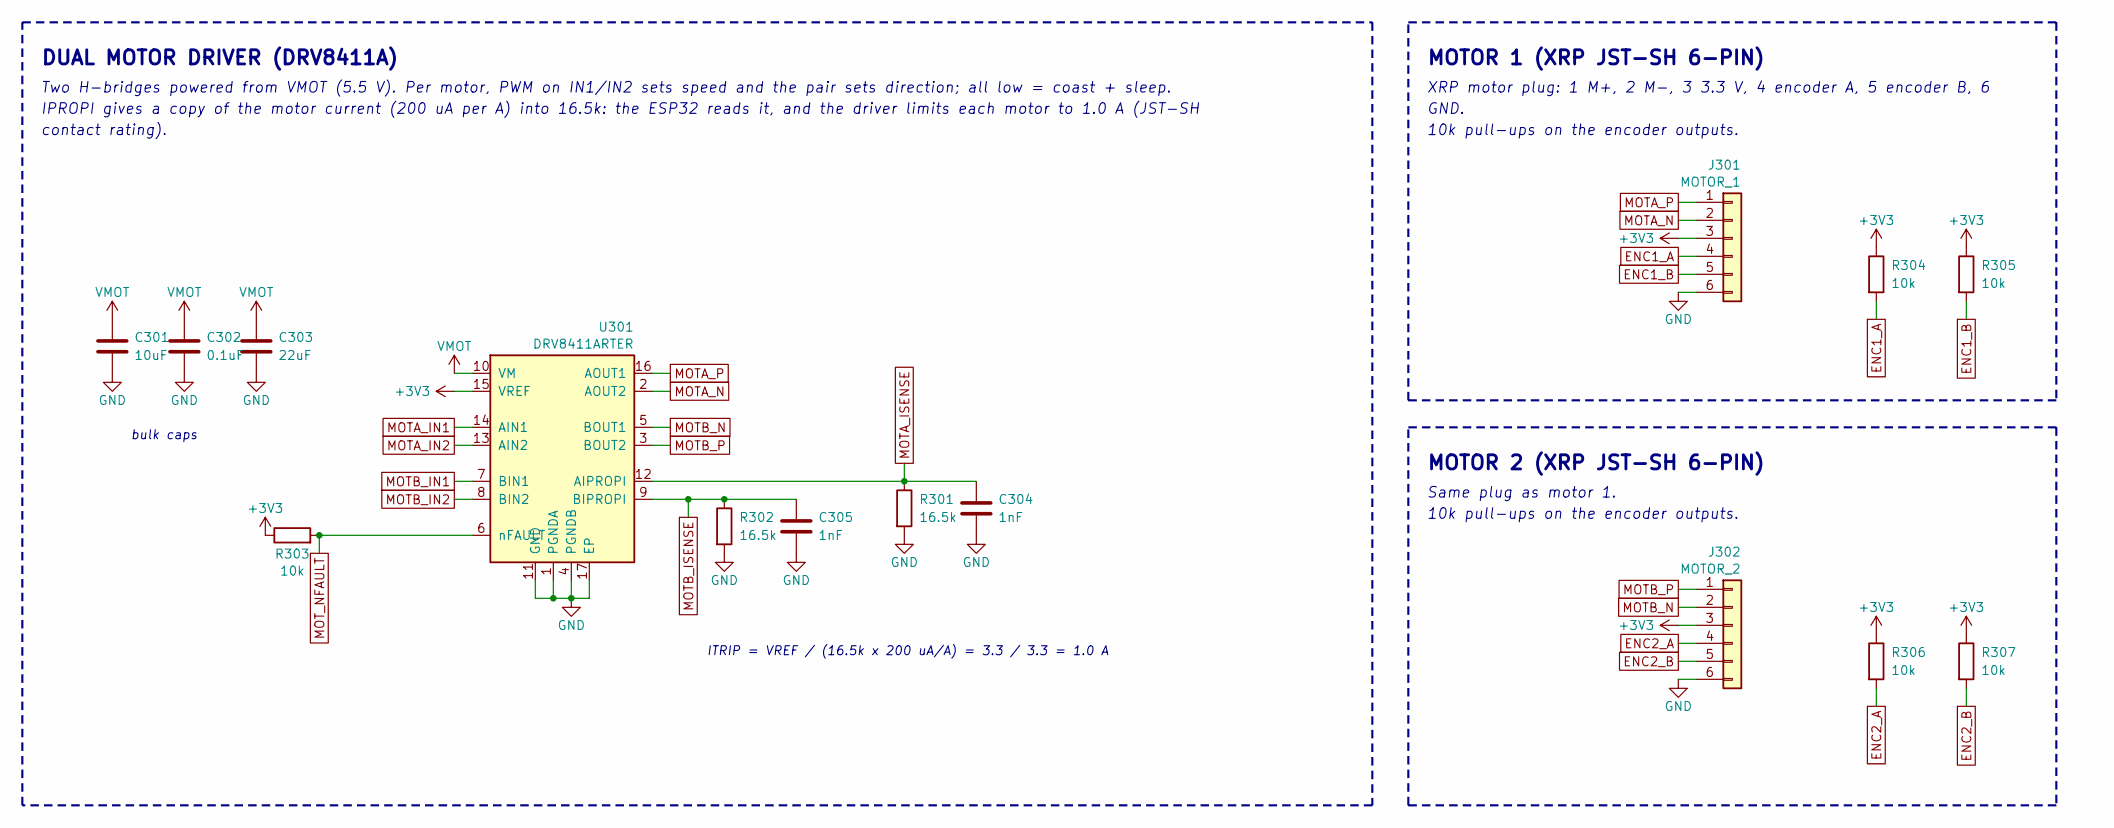
[picture p228: schematic motors.kicad_sch, RoboCore V2 - Motors]

Parts:
C301: 10uF; C_0805_2012Metric; LCSC C1713
C302: 0.1uF; C_0402_1005Metric; LCSC C960916
C303: 22uF; C_1206_3216Metric; LCSC C12891
C304, C305: 1nF; C_0402_1005Metric; LCSC C14442
J301: MOTOR_1; JST_SH_BM06B-SRSS-TB_1x06-1MP_P1.00mm_Vertical; LCSC C160392
J302: MOTOR_2; JST_SH_BM06B-SRSS-TB_1x06-1MP_P1.00mm_Vertical; LCSC C160392
R301, R302: 16.5k; R_0402_1005Metric; LCSC C25857
R303, R304, R305, R306, R307: 10k; R_0402_1005Metric; LCSC C25744
U301: DRV8411ARTER; WQFN-16-1EP_3x3mm_P0.5mm_EP1.68x1.68mm_ThermalVias; LCSC C18816315

Connections:
+3V3: J301.3, J302.3, R303.1, R304.1, R305.1, R306.1, R307.1, U301.15 (VREF); also elsewhere on the board
ENC1_A: J301.4, R304.2; also elsewhere on the board
ENC1_B: J301.5, R305.2; also elsewhere on the board
ENC2_A: J302.4, R306.2; also elsewhere on the board
ENC2_B: J302.5, R307.2; also elsewhere on the board
GND: C301.2, C302.2, C303.2, C304.2, C305.2, J301.6, J302.6, R301.2, R302.2, U301.1 (PGNDA), U301.4 (PGNDB), U301.11 (GND), U301.17 (EP); also elsewhere on the board
MOTA_IN1: U301.14 (AIN1); also elsewhere on the board
MOTA_IN2: U301.13 (AIN2); also elsewhere on the board
MOTA_ISENSE: C304.1, R301.1, U301.12 (AIPROPI); also elsewhere on the board
MOTA_N: J301.2, U301.2 (AOUT2)
MOTA_P: J301.1, U301.16 (AOUT1)
MOTB_IN1: U301.7 (BIN1); also elsewhere on the board
MOTB_IN2: U301.8 (BIN2); also elsewhere on the board
MOTB_ISENSE: C305.1, R302.1, U301.9 (BIPROPI); also elsewhere on the board
MOTB_N: J302.2, U301.5 (BOUT1)
MOTB_P: J302.1, U301.3 (BOUT2)
MOT_NFAULT: R303.2, U301.6 (nFAULT); also elsewhere on the board
VMOT: C301.1, C302.1, C303.1, U301.10 (VM); also elsewhere on the board

Notes on the sheet:
DUAL MOTOR DRIVER (DRV8411A)
Two H-bridges powered from VMOT (5.5 V). Per motor, PWM on IN1/IN2 sets speed and the pair sets direction; all low = coast + sleep.
IPROPI gives a copy of the motor current (200 uA per A) into 16.5k: the ESP32 reads it, and the driver limits each motor to 1.0 A (JST-SH
contact rating).
ITRIP = VREF / (16.5k x 200 uA/A) = 3.3 / 3.3 = 1.0 A
bulk caps
MOTOR 1 (XRP JST-SH 6-PIN)
XRP motor plug: 1 M+, 2 M-, 3 3.3 V, 4 encoder A, 5 encoder B, 6
GND.
10k pull-ups on the encoder outputs.
MOTOR 2 (XRP JST-SH 6-PIN)
Same plug as motor 1.
