Plastal-Bot-Builders/RoboCoreDocumentation/hardware/controller_v2/RoboCore_V2.kicad_pcb

## KiCad design hardware/controller_v2/RoboCore_V2.kicad_pcb (continued)

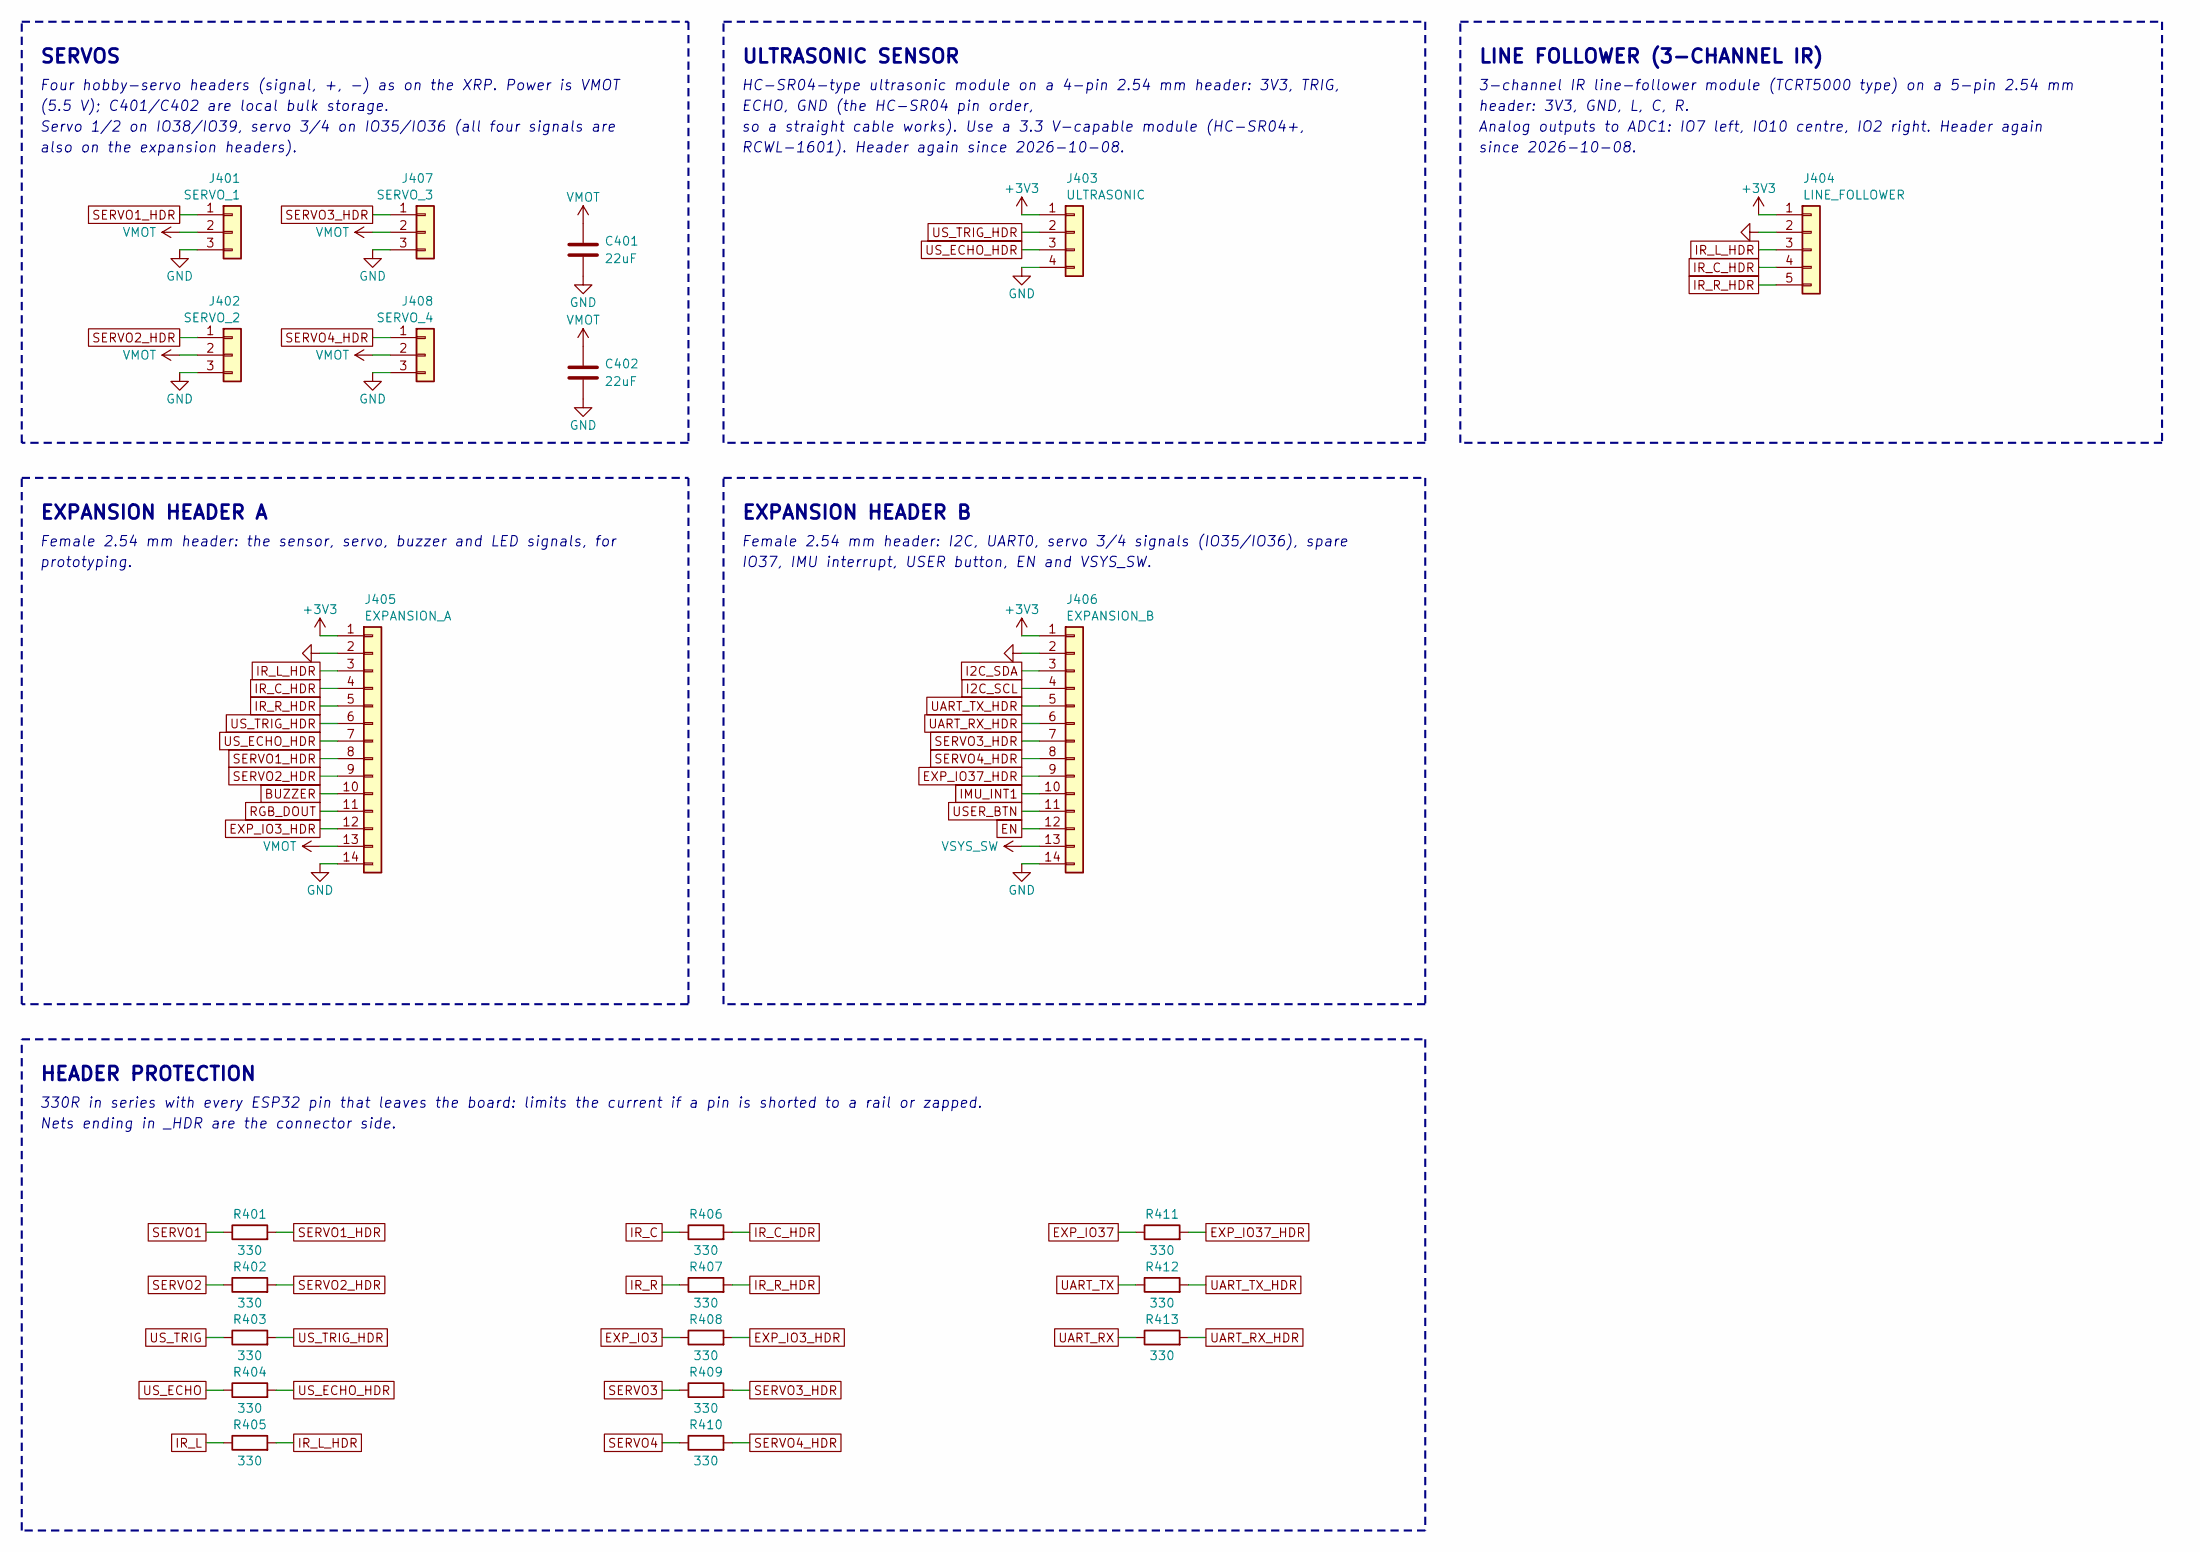
[picture p229: schematic io.kicad_sch, RoboCore V2 - IO connectors]

Parts:
C401, C402: 22uF; C_1206_3216Metric; LCSC C12891
J401: SERVO_1; PinHeader_1x03_P2.54mm_Vertical; LCSC C52016391
J402: SERVO_2; PinHeader_1x03_P2.54mm_Vertical; LCSC C52016391
J403: ULTRASONIC; PinHeader_1x04_P2.54mm_Vertical; LCSC C52016392
J404: LINE_FOLLOWER; PinHeader_1x05_P2.54mm_Vertical; LCSC C27985190
J405: EXPANSION_A; PinSocket_1x14_P2.54mm_Vertical; LCSC C22373900
J406: EXPANSION_B; PinSocket_1x14_P2.54mm_Vertical; LCSC C22373900
J407: SERVO_3; PinHeader_1x03_P2.54mm_Vertical; LCSC C52016391
J408: SERVO_4; PinHeader_1x03_P2.54mm_Vertical; LCSC C52016391
R401, R402, R403, R404, R405, R406, R407, R408, R409, R410, R411, R412, R413: 330; R_0402_1005Metric; LCSC C25104

Connections:
+3V3: J403.1, J404.1, J405.1, J406.1; also elsewhere on the board
BUZZER: J405.10; also elsewhere on the board
EN: J406.12; also elsewhere on the board
EXP_IO3: R408.1; also elsewhere on the board
EXP_IO3_HDR: J405.12, R408.2
EXP_IO37: R411.1; also elsewhere on the board
EXP_IO37_HDR: J406.9, R411.2
GND: C401.2, C402.2, J401.3, J402.3, J403.4, J404.2, J405.2, J405.14, J406.2, J406.14, J407.3, J408.3; also elsewhere on the board
I2C_SCL: J406.4; also elsewhere on the board
I2C_SDA: J406.3; also elsewhere on the board
IMU_INT1: J406.10; also elsewhere on the board
IR_C: R406.1; also elsewhere on the board
IR_C_HDR: J404.4, J405.4, R406.2
IR_L: R405.1; also elsewhere on the board
IR_L_HDR: J404.3, J405.3, R405.2
IR_R: R407.1; also elsewhere on the board
IR_R_HDR: J404.5, J405.5, R407.2
RGB_DOUT: J405.11; also elsewhere on the board
SERVO1: R401.1; also elsewhere on the board
SERVO1_HDR: J401.1, J405.8, R401.2
SERVO2: R402.1; also elsewhere on the board
SERVO2_HDR: J402.1, J405.9, R402.2
SERVO3: R409.1; also elsewhere on the board
SERVO3_HDR: J406.7, J407.1, R409.2
SERVO4: R410.1; also elsewhere on the board
SERVO4_HDR: J406.8, J408.1, R410.2
UART_RX: R413.1; also elsewhere on the board
UART_RX_HDR: J406.6, R413.2
UART_TX: R412.1; also elsewhere on the board
UART_TX_HDR: J406.5, R412.2
USER_BTN: J406.11; also elsewhere on the board
US_ECHO: R404.1; also elsewhere on the board
US_ECHO_HDR: J403.3, J405.7, R404.2
US_TRIG: R403.1; also elsewhere on the board
US_TRIG_HDR: J403.2, J405.6, R403.2
VMOT: C401.1, C402.1, J401.2, J402.2, J405.13, J407.2, J408.2; also elsewhere on the board
VSYS_SW: J406.13; also elsewhere on the board

Notes on the sheet:
SERVOS
Four hobby-servo headers (signal, +, -) as on the XRP. Power is VMOT
(5.5 V); C401/C402 are local bulk storage.
Servo 1/2 on IO38/IO39, servo 3/4 on IO35/IO36 (all four signals are
also on the expansion headers).
ULTRASONIC SENSOR
HC-SR04-type ultrasonic module on a 4-pin 2.54 mm header: 3V3, TRIG,
ECHO, GND (the HC-SR04 pin order,
so a straight cable works). Use a 3.3 V-capable module (HC-SR04+,
RCWL-1601). Header again since 2026-10-08.
LINE FOLLOWER (3-CHANNEL IR)
3-channel IR line-follower module (TCRT5000 type) on a 5-pin 2.54 mm
header: 3V3, GND, L, C, R.
Analog outputs to ADC1: IO7 left, IO10 centre, IO2 right. Header again
since 2026-10-08.
EXPANSION HEADER A
Female 2.54 mm header: the sensor, servo, buzzer and LED signals, for
prototyping.
EXPANSION HEADER B
Female 2.54 mm header: I2C, UART0, servo 3/4 signals (IO35/IO36), spare
IO37, IMU interrupt, USER button, EN and VSYS_SW.
HEADER PROTECTION
330R in series with every ESP32 pin that leaves the board: limits the current if a pin is shorted to a rail or zapped.
Nets ending in _HDR are the connector side.

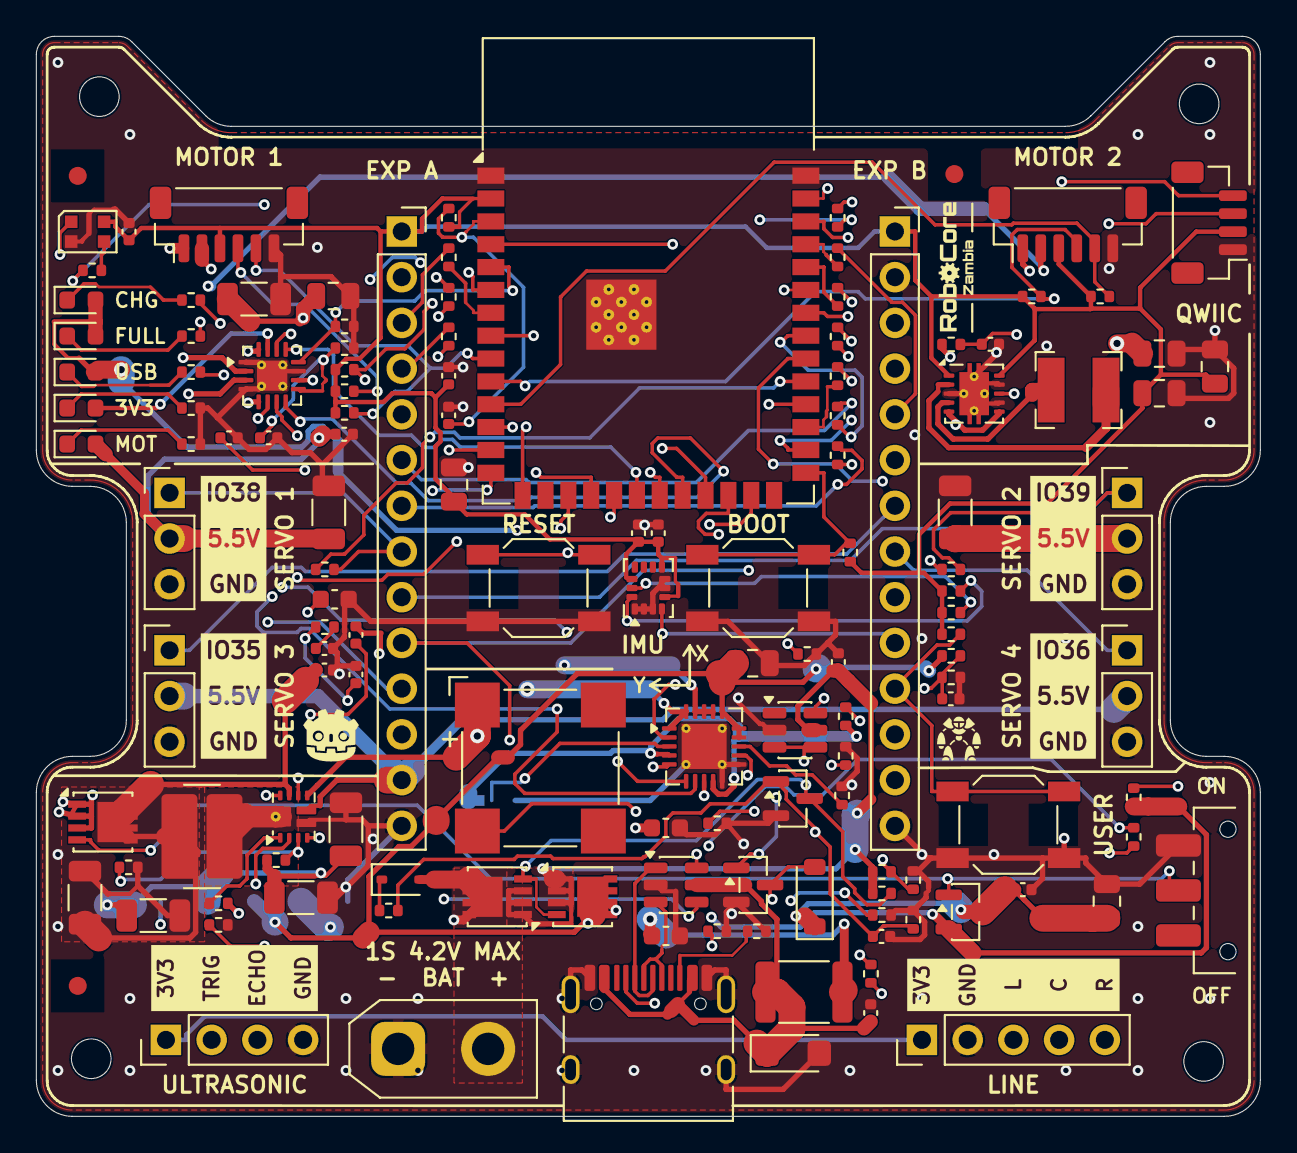
[picture p230: board RoboCore_V2.kicad_pcb from above]

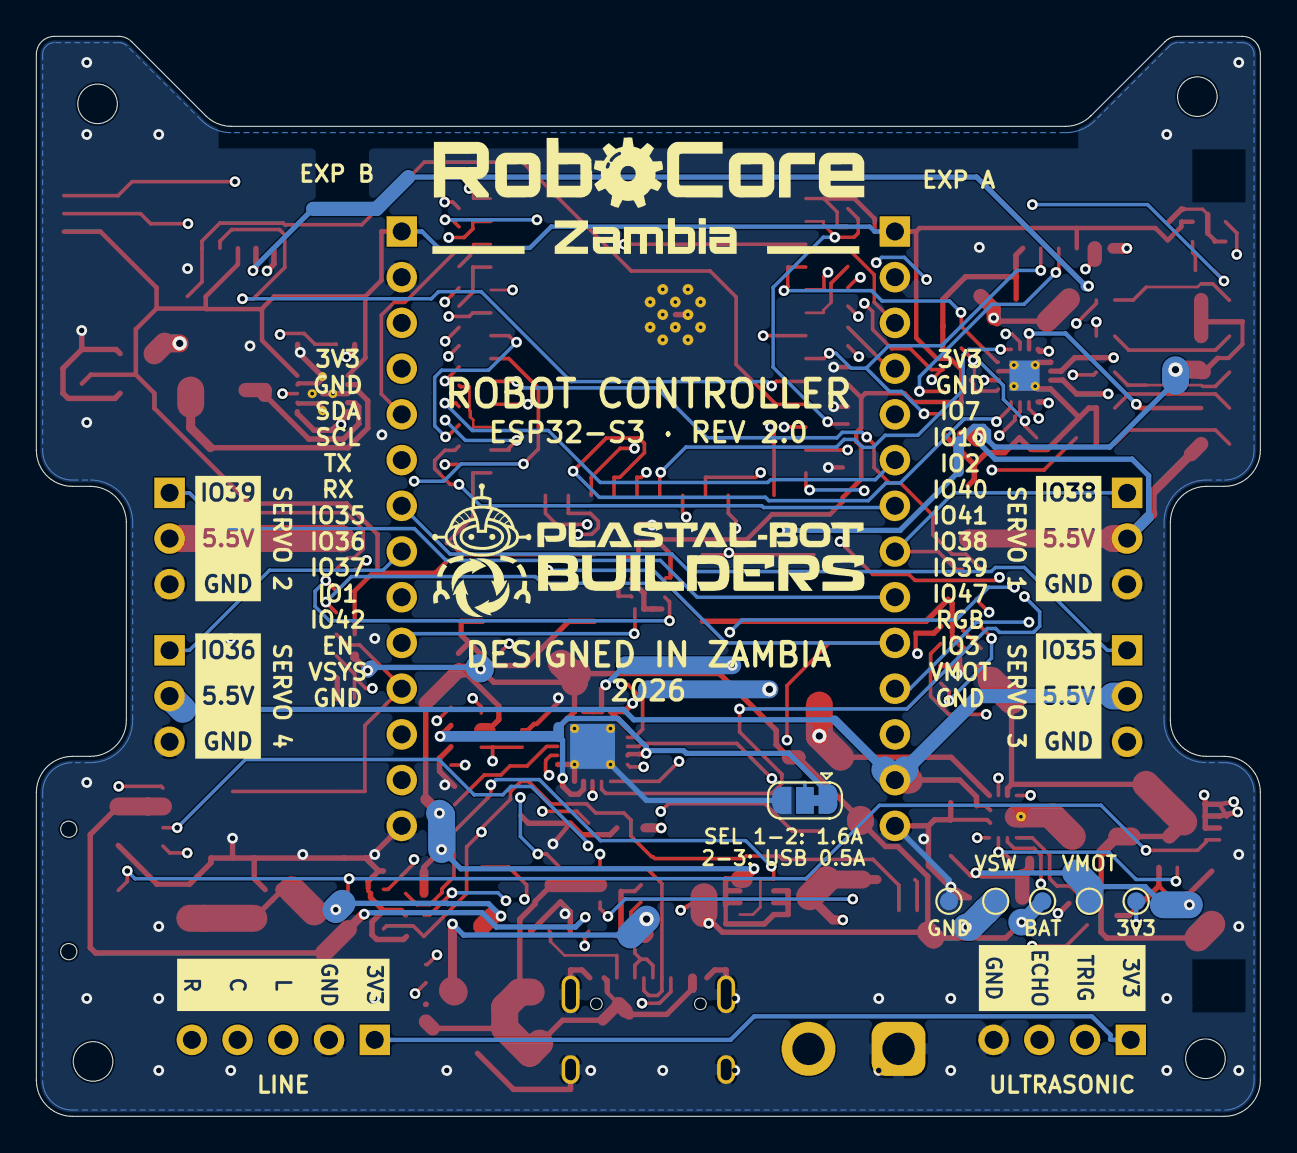
[picture p231: board RoboCore_V2.kicad_pcb from below]

Board: 4 copper layers, 68.0 x 60.0 mm, 146 parts (6 on the bottom side), 100 nets.
