Plastal-Bot-Builders/RoboCoreDocumentation/(commit log)

2026-10-12 Hardware: V2 controller and sensor boards
2026-10-12 Hardware: shared symbol and footprint libraries
2026-10-12 Mechanical: board STEPs, references, V1 chassis spec
2026-10-12 Mechanical: Fusion generator, prints, vendor models, concept
2026-10-12 Mechanical: component and cable exports
2026-10-12 Mechanical: renders (rev 1-3, schemes, current)
2026-10-12 Packaging: five new part drawings (chassis, encoder motor, wheel, battery holder, encoder cable) on the kit grid, box row and end wall
2026-10-14 Robot rev 6, Task A: no heat-set inserts (M2 screws for plastic, captive M3 nuts), fastener coupon, open-pocket nose, hand edits replayed; print files, renders and hand-off notes
2026-10-14 Robot rev 6: assembly STEP and F3D (Fusion v31)
2026-10-14 Robot rev 6, Task C: caster vent 5.5 mm, rail-wall windows for the DG01D-E, hand-edit replay with pedestals, hardware dedupe step; print files and renders (Fusion v32)
2026-10-14 Robot rev 6: assembly STEP and F3D (Fusion v32)
2026-10-14 Robot rev 6, 1a + 3b: sonar pod with a 4 mm faceplate, 4 mm corner chamfers and countersunk bezels; arm base front chamfer and counterbored screw heads; DFMA brief review; print files and renders (Fu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
2026-10-14 Robot rev 6: assembly F3D (Fusion v33)
2026-10-14 Robot rev 6: assembly STEP (Fusion v33)
2026-10-23 Hardware: V2 controller paid at PCBWay (order YU1827457), JLCPCB comparison files, Blender render scripts, supplier quote script; KiCad re-saved the project file
2026-10-23 Docs: wrong-plug check and errata list, component list and supplier quote request (rev 5 design, one servo type), costing notes, Alibaba quote request (part 1 of 2)
2026-10-23 Docs: wrong-plug check and errata list, component list and supplier quote request (rev 5 design, one servo type), costing notes, Alibaba quote request (part 2 of 2)
2026-10-23 Docs: PCBWay sponsorship request for the line and ultrasonic sensor boards
2026-10-23 README: pictures of the robot, board, box and brand; board spec table; updated layout, status and sync instructions
2026-10-23 Robot arm: topology-optimized plate windows (20 % layout) cut into Fred's hand-edited arm; topo pipeline (2D SIMP + AM filter); README, print files, renders
2026-10-23 Robot: assembly F3D (arm topology windows)
2026-10-23 Robot: assembly STEP (arm topology windows)
2026-10-23 Robot arm: wrist deck windows (50 % layout), jaw teardrop slots, strut web yoke replacing the cylinder structure; 3D voxel and ground-structure optimizers; README, print files, renders
2026-11-07 README: the current robot (V3, V-wheel version) and its new box
    Pictures from RoboCore_V3_Renders (robot, lift range, box closed and open) and the rebuilt event pieces; the
    robot and box sections describe the V3 robot (the V2 files stay below for reference).
2026-11-07 Box for the V3 robot (1/5): make_box_v3.py and its V3 line drawings
    300 x 210 x 88 mm inside (303 x 213 x 91 outside); the insert pocket is the robot's top view with the lift
    lowered (+3 mm), plus a strip for the cable, screws and card. The V2 box stays in out/.
2026-11-07 Box for the V3 robot (2/5): dieline, insert, 3D and previews
2026-11-07 Box for the V3 robot (3/5): print PDFs, 1:1
2026-11-07 IDE design: Copperbelt contours in the Figma builder
    contours() draws the terrain's ordinary and index lines (66 + 18 paths) in place of the box's hand-drawn lines; the
    old art is in archive/box-contours-2026-11-07. Also picks up the robot's new name on the Home banner and the type
    samples, and leaves the RoboCore Play companion page alone on rebuild. code.js rebuilt.
2026-11-07 V2 box with Copperbelt contours (1/5): print PDFs, 1:1
2026-11-09 V2 controller pin reference, errata E-014 to E-016
    docs/RoboCore_V2_pin_reference.md: which GPIO drives each part of the V2 board and how to use it from Arduino
    code (pin = GPIO number, board settings, buzzer/LED/button/IMU/battery/motor sections with RoboCore library
    names, connectors as printed, unprotected expansion pins, free pins, every GPIO in order). Its 9 sketches
    compile for the ESP32-S3 (core 3.3.11) and its pin names match the library's RoboCoreV2Pins.h.
    Errata: E-014 and E-015 from bring-up (motors on USB alone; motor sockets back to front for XRP motors) and
    E-016 (no pin numbers beside the parts on the board). The spec's GPIO map links the pin reference.
2026-11-09 Pin reference: which pins can read analog
    The ESP32-S3 reads analog only on IO1 to IO20, so of the reachable pins only IO3 and the line-sensor pins
    (IO2, IO7, IO10) are analog inputs; IO35 to IO44 are digital only.
